Stachovsky/TrabajoProfesional/README.md

TrabajoProfesional
==================

Archivos, codigo y documentacion del trabajo profesional. Proyecto: Sistema de control para sinterizado de nano polvos.
