Stachovsky/TrabajoProfesional/Informes/Anteproyecto/AnteProyecto.pdf

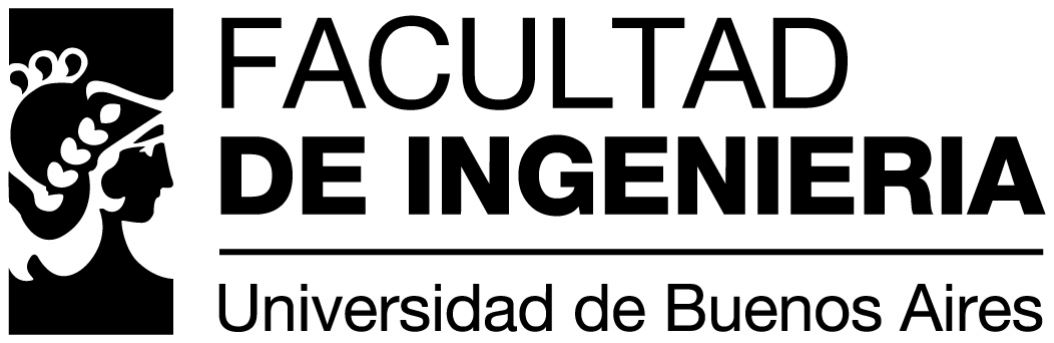
[picture p3: figure]

# Trabajo Profesional de Ingeniería Electrónica

# Sistema de control para proceso de sinterizado de nano estructuras

## ANTEPROYECTO

## Integrantes:

## Estanislao López Morgan

Padrón: | 84546
Mail: | estanux@gmail.com

## Facundo Nahuel Uriel Silva

Padrón: | 86881
Mail: | fanaur@gmail.com

## Índice

1. Introducción | 1
2. Finalidad del proyecto | 1
3. Planteamiento del problema a resolver | 2
4. Análisis de mercado | 2
5. Análisis de la competencia | 3
6. Planes de crecimiento | 3
7. Objetivos de costo | 3

## 1. Introducción

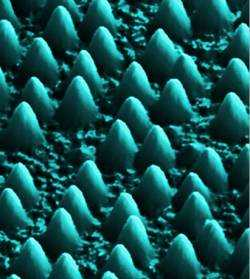
[picture p4: figure]

Figura 1: Nanoestructura

Los materiales nanocompuestos formados en su totalidad por particulas cerámicas y metálicas en el rango de los centenares y decenas de nanómetros, son una clase de materiales que presentan propiedades físicas muy distíntas a las de esos mismos con tamaños de cristal micrométricos (materiales convencionales). Tales propiedades, al ampliar su rango de funcionalidad resultan muy interesantes desde el punto de vista tecnológico ya que permiten combinar propiedades excepcionales con funcionalidad imprescindibles en aplicaciones específicas, como la transparencia, la biocompatibilidad, la dureza o conductividad eléctrica, entre otras.
Sin embargo, la aplicacion industrial de los materiales nanocompuestos radica en la capacidad de consolidación de estos materiales formando cuerpos densos y compuestos, pero preservando el tamañan nanométrico de sus componentes. Las técnicas de consolidación
convencionales presentan importantes limitaciones y no son capaces de preservar esta nanoestructura. La solución de estos problemas y el desarrollo de nuevas tecnologías ha posibilitado la producción de materiales nanoestructurales.

## 2. Finalidad del proyecto

En el laboratorio de sólidos amorfos de la facultad de ingeniería de la universidad de Buenos Aires funciona el INTECIN y en el mismo el grupo de materiales nanoestructurales, este grupo prepara y estudia sistemas basados en nanopartículas magnéticas apuntando a las posibles aplicaciones tecnológicas en sensores, remediación ambiental y aplicaciones clínicas. Sus integrantes tienen experiencia en caracterización estructural por difracción, dispersión y absorción de rayos X, espectroscopia Mössbauer, propiedades magnéticas y de magnetotransporte y microscopía electrónica.

Para lograr esto se realiza el sintetizado de nano estructuras, obteniendo una cinta metálica con una estructura amorfa (sin estructura cristalina) similar a un vidrio. Mediante un proceso de pulverizado de esta cinta se obtiene un polvo cuyas partículas poseen una estructura nanométrica. Para poder obtener una estructura sólida a partir del polvo se utiliza el proceso de sinterizado. Este proceso logra unificar las particulas del polvo en una sola estructura sólida. Para este fin se necesita que una intensidad de corriente elevada, en el orden de los KA, atraviese la muestra de polvo nonometrico. Esta corriente puede ser provista por un banco de capacitores (proceso rápido) o una fuente de RF (proceso lento).

La finalidad de nuestro proyecto es desarrollar una automatización y relevamiento del proceso de sinterizado a partir de la descarga de un banco de capacitores, realizar recopilación de datos del proceso con la posibilidad de variar alguna variables involucradas en el sitenrizado para evaluar el desempeño del mismo y sus resultados.

## 3. Planteamiento del problema a resolver

Para el estudio y desarrollo de cualquier tecnología es indispensable la experimentación, ya que es el medio atraves del cual se puede comprender y validar los desarrollos teóricos del proceso estudiado. La flexibilidad a la hora de la experimentación es factor deseado, entendiendo por flexibilidad la posibilidad de poder modificar parámetros del experimento de forma rapida y sencilla, ya que facilita y ahora tiempos a la hora del desarrollo del conocimiento. La fácil obtención y disponibilidad de los resultados de la experimentación es otro deseado en la experimentación.

Para poder estudiar y obtener materiales nanometricos atraves del proceso de sinterizado es necesario contar con un plataforma que controle y monitoree el proceso de sinterizado de forma flexible y parametrica. La plataforma le debe brindar al investigador la posibilidad de modificar las variables del proceso y obtener los resultados de la experimentacion. El proceso de sinterizado requiere la manipulación de una potencia electrica conciderable, es por ello que la plataforma debe brindar un manejo seguro de esta potencia , contando con todas medidas de seguridad requeridas para asegurar una segura operación.

## 4. Análisis de mercado

Los nanomateriales poseen una gran potencialidad a nivel tecnológico, ya que posibilitan la optimización y mejora de actuales de materiales actuales. Particularmente utilizando el proceso de sinterizado de materiales magneticos se obtiene materiales con caracteristicas magneticas conciderablemente mejores que los materiales actualmente usados en la industria. Los materiales magneticos son de vital importancia el campo de la generación de energia electrica, almacenamiento electronico de datos, desarrollo de sensores electrónico, etc.

## 5. Análisis de la competencia

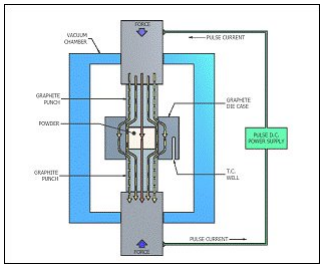
[picture p5: figure]

Figura 2: SPS

En el mercado encontramos soluciones de gran emplazamiento y envergadura, como lo son los propuestos por Thermal Technology LLC basado en la tecnología de Spark Plasma Sintering (SPS) un revolucionario en polvo de alta velocidad de proceso de consolidación. SPS utiliza alto pulsos de alta corriente continua para activar la consolidación y la reacción de sinterización de los materiales. Un sistesma de SPS trabaja con materiales conductores, no conductores y compuesto a cualquier nivel de densidad. La ventaja de SPS es ahorro de tiempo y energía y la capacidad de retener nanoestructuras.

## 6. Planes de crecimiento

El proyecto en un principio propone realizar la automatización del proceso de sinterizado estableciendo las normas de seguidad que corresponden. En un segundo paso, realizar las medeciones sobre las mágnitudes involucradas en el proceso. Tensión, corriente tiempo de descarga, etc, y su posterior almacenamiento. Finalmente todo lo anterior se lo integraría de forma que pueda sincronizar contra un servidor en red.

## 7. Objetivos de costo

El objetivo propuesto trata de desarrollar instrumental de bajo o mediano costo en comparación a las opciones propuestas por la competencia. Desde ese punto de vista, el proceso de sinterizado a través de descarga de los capacitores propuesto es mas eficiente
