Stachovsky/TrabajoProfesional/Informes/Especificaciones/Especificaciones.pdf

## Trabajo Profesional de Ingeniería Electrónica

# Sistema de control para proceso de sinterizado de nano estructuras

# Especificaciones Técnicas

V1.2

## Integrantes:

## Estanislao López Morgan

Padrón: | 84546
Mail: | estanux@gmail.com

## Facundo Nahuel Uriel Silva

Padrón: | 86881
Mail: | fanaur@gmail.com

### Historial

Fecha | Versión | Descripción | Autores
28/08/12 | 1.0 | Especificaciones Técnicas | Silva - López Morgan
06/09/12 | 1.1 | Se especifican las interfases para el conexionado de los sensores. | Silva - López Morgan
06/09/12 | 1.2 | Corrección de la posición de un sensor de tensión en el diagrama en bloques. | Silva - López Morgan

## Índice

1. Especificaciones de hardware | 1
2. Especificaciones de software | 4

Capítulo | 1 ESPECIFICACIONES DE HARDWARE

## 1. Especificaciones de hardware

### 1.1. Aspectos eléctricos

Tensión alimentación: 220VAC/50Hz.

Consumo máximo: 1A.∗

1

Pico de corriente de sinterizado máximo: 1KA. ∗

| 2

Impedancia máxima de la muestra: 1Ω.

∗

1
: El consumo máximo estará fijado por la fuente que se utilice y esta por el transformador.
∗

2
: La corriente máxima de pico de sinterizado puede ser incrementada hasta 10 kA si se amplía el banco de capacitores, se remplaza los contactores y el cableado correspondiente.

### 1.2. Almacenamientos de datos

Memoria flash en soporte SD Card.

Memoria flash en soporte pendrive USB 2.0.

### 1.3. Comunicación

Comunicación USB 2.0 con la PC. ∗

3

∗

3
: Se utiliza un bridge RS232-USB interno.

### 1.4. Periféricos del dispositivo

Display gráfico de 128x64 pixels.

Teclado de 4 teclas.

Sensor de corriente.

Sensores de tensión × 3.

Sensor de temperatura.

### 1.5. Interfases del dispositivo

Entrada de 0-5V × 3.∗

4∗

5

Entrada de 5-20mA × 1.∗

4

Puertos UART × 3.∗

6

Bus I

2C.∗

6

∗

4
: Interfases configurables desde el programa de PC.
∗

5
: Interfases usadas para los sensores de tensión y corriente ∗

6
: Interfases reservadas para usos futuros.

### 1.6. Seguridad

Descarga segura del banco de capacitores.

Sirena sonora.

Luces de señalización × 3.

Banco de capacitores ubicados dentro del gabinete del dispositivo .

Revestimiento eléctricamente aislante del gabinete del dispositivo.

Protección contra corto circuito.

Botón de parada de emergencia.

### 1.7. Aspectos mecánicos

No se brinda la función de prensado de la muestra. ∗

7

Gabinete con 4 ruedas.

No se brinda el recipiente contenedor de la muestra de polvo.

∗

7
: La muestra debe estar prensada previamente al momento de realizar el proceso sinterizado.

### 1.8. Aspectos de operativos

Uso máximo mensual: 60 veces. ∗

8

∗

8
: Se estima un promedio de 2 usos diarios.

### 1.9. Croquis


Figura 1: Interconeccion entre los bloques del sistema

Capítulo | 2 ESPECIFICACIONES DE SOFTWARE

## 2. Especificaciones de software

El control, administración, monitoreo y recolección de datos del dispositivo de control del proceso de sinterizado se harán a través de un programa de PC con las siguiente características:

Plataforma Windows XP/7 y GNU Linux.

Formato de datos exportados CSV.

Control de acceso.

Base de datos.

### 2.1. Pantallas

El programa contara con las siguientes pantallas:

Login.

ABM usuarios.

Monitoreo dispositivo.

Parametrización del experimento.

Control experimentación.

Descarga de datos del experimento.

Exportación de resultados de experimentación.

Ploteo de resultados del experimento.
