Stachovsky/TrabajoProfesional/Informes/InformePreliminar/informePreliminar.pdf

# Trabajo Profesional de Ingeniería Electrónica

## Sistema de control para proceso de sinterizado de nano estructuras

## Situacion inicial

## Integrantes:

## Estanislao López Morgan

Padrón: | 84546
Mail: | estanux@gmail.com

## Facundo Nahuel Uriel Silva

Padrón: | 86881
Mail: | fanaur@gmail.com

## Índice

1. Introducción | 1
2. Descripción situación existente del sistema | 2
3. Descripción solución propuesta | 3

Capítulo | 1 INTRODUCCION´

## 1. Introducción

Los materiales nanocompuestos formados en su totalidad por particulas cerámicas y metálicas en el rango de los centenares y decenas de nanómetros, son una clase de materiales que presentan propiedades físicas muy distíntas a las de esos mismos con tamaños de cristal micrométricos (materiales convencionales). Tales propiedades, al ampliar su rango de funcionalidad resultan muy interesantes desde el punto de vista tecnológico ya que permiten combinar propiedades excepcionales con funcionalidad imprescindibles en aplicaciones específicas, como la transparencia, la biocompatibilidad, la dureza o conductividad eléctrica, entre otras.
Sin embargo, la aplicacion industrial de los materiales nanocompuestos radica en la capacidad de consolidación de estos materiales formando cuerpos densos y compuestos, pero preservando el tamañan nanométrico de sus componentes. Las técnicas de consolidación convencionales presentan importantes limitaciones y no son capaces de preservar esta nanoestructura. La solución de estos problemas y el desarrollo de nuevas tecnologías ha posibilitado la producción de materiales nanoestructurales.
En el laboratorio de sólidos amorfos de la facultad de ingeniería de la universidad de Buenos Aires funciona el INTECIN y en el mismo el grupo de materiales nanoestructurales, este grupo prepara y estudia sistemas basados en nanopartículas magnéticas apuntando a las posibles aplicaciones tecnológicas en sensores, remediación ambiental y aplicaciones clínicas. Sus integrantes tienen experiencia en caracterización estructural por difracción, dispersión y absorción de rayos X, espectroscopia Mössbauer, propiedades magnéticas y de magnetotransporte y microscopía electrónica.

Para lograr esto se realiza el sintetizado de nano estructuras, obteniendo una cinta metálica con una estructura amorfa similar a un vidrio. Mediante un proceso de pulverizado de esta cinta se obtiene un polvo cuyas partículas poseen una estructura nanométrica. Para poder obtener una estructura sólida a partir del polvo se utiliza el proceso de sinterizado. Este proceso logra unificar las particulas del polvo en una sola estructura sólida. Para este fin se necesita que una intensidad de corriente elevada, en el orden de los KA, atraviese la muestra de polvo nonometrico. Esta corriente puede ser provista por un banco de capacitores (proceso rápido) o una fuente de RF (proceso lento).

La finalidad de nuestro proyecto es desarrollar una automatización y relevamiento del proceso de sinterizado a partir de la descarga de un banco de capacitores, realizar recopilación de datos del proceso con la posibilidad de variar alguna variables involucradas en el sitenrizado para evaluar el desempeño del mismo y sus resultados.
La finalidad de este informe es describir la situación existente en el laboratorio y plantear una posible solución tecnológicas para el proceso de control.

Capítulo | 2 DESCRIPCION SITUACI ´ | ON EXISTENTE DEL SISTEMA ´

## 2. Descripción situación existente del sistema

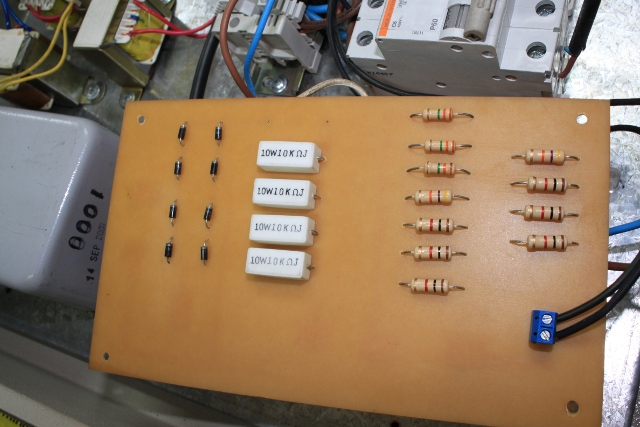
[picture p7: figure]

Figura 1: Tablero actual

En la actualidad, el antiguo proceso de sinterizado, que estuvo en funcionamiento a modo de prueba para realizar solo algunas descargas de los capacitores, se encuentra parcialmente desmantelada. Se cuenta con una caja metálica que hace la suerte de tablero, alberga la electrónica de control y un pequeño teclado con un display de cristal líquido. Contiene también un contactor y una placa con un puente de diodos, algunas resistencias pequeñas y un rele.
En el laboratorio se encuentran dos capacitores de potencia en derivación marca Leyden. Son de 200uF por 1000V y tienen
un dieléctrico constituido en general por tres
películas de polipropileno ‘hazy’, rugosas en
ambas caras, de alta pureza. Esta construcción, en lugar de la que utiliza sólo dos capas de un film rugoso en una sola de sus caras, común en otros fabricantes, “confiere a los capacitores LEYDEN mayor seguridad de funcionamiento y mayor vida útil. La rugosidad en ambas caras del polipropileno es una condición indispensable para la completa impregnación del film durante el proceso y, por ende, para la estabilidad del capacitor a largo plazo”, especifica el fabricante.

Estos capacitores utilizan un impregnante no-clorado MDBT. Este se caracteriza por su alto ´ punto de inflamación, gran capacidad de absorción de gases derivados de descargas eléctricas internas, y compatibilidad ambiental (biodegradabilidad).

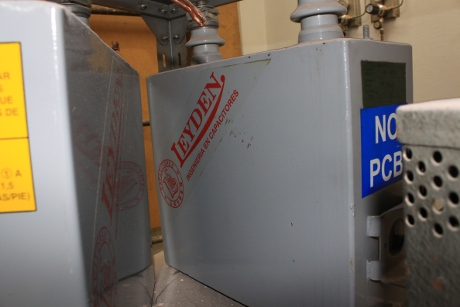
[picture p8: figure]
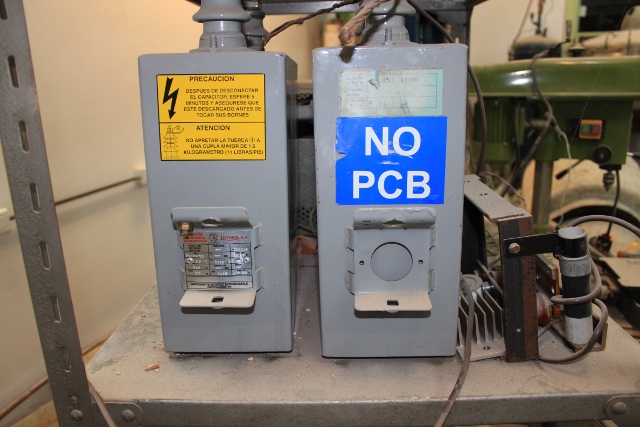
[picture p9: figure]

(a) Capacitores de lado | (b) Capacitores de frente

Figura 2: Capacitores de 200uF y 1000V

Capítulo | 3 DESCRIPCION SOLUCI ´ | ON PROPUESTA ´

## 3. Descripción solución propuesta

### 3.1. Objetivos

Se propone desarrollar un sistema electrónico que integre el control y la adquisición de datos del proceso de sinterizado ECAS (Electric current activated/assisted sintering ). La corta duración del proceso de descarga de los capacitores (razón por la cual a esta modalidad se la denomina ’ultra rápida’) exige que el sistema tenga una elevada velocidad de respuesta para tomar las muestras de las distintas magnitudes físicas que se necesitan medir en el proceso. El sistema utilizará la información provista por los sensores para hacer ajuste en los parámetros de control del proceso para lograr los mejores resultado en experimentación. Se estimara la carga del banco de capacitores para de esta manera saber con precisión la magnitud que tendrá la corriente en el momento de la descarga, siendo este aspecto de fundamental importancia en este proceso. El proceso requiere la presencia de altas tensiones para su ejecución por lo que el sistema monitoreará todos los parámetros peligrosos (como son tensión de la fuente de alimentación y la tensión de los capacitores) y aplicara todas las medidas de seguridad necesarias para brindarle al operador la seguridad necesaria para su utilización. El sistema tendrá la capacidad de poder interrumpir el proceso en caso de no ser seguro para el operario o para la integridad de los elementos del sistema (para evitar daños). El sistema contara con indicadores lumínicos (luces de señalización) y sonoros (sirenas) para informara los distintos estados del sistema. Los datos obtenidos de la experimentación podrán ser accedidos desde distintos medios para facilitar el posterior análisis de la información recolectada. Se tendrá un acceso remoto al sistema mediante la conexión a una red local (LAN) y un acceso local mediante la interfase provista por el teclado y la pantalla. En la figura 3 se muestra de forma esquemática los componentes que integraran al sistema. Se tendrá una unidad de control acompañada de un conjuntos de sensores y actuadores.

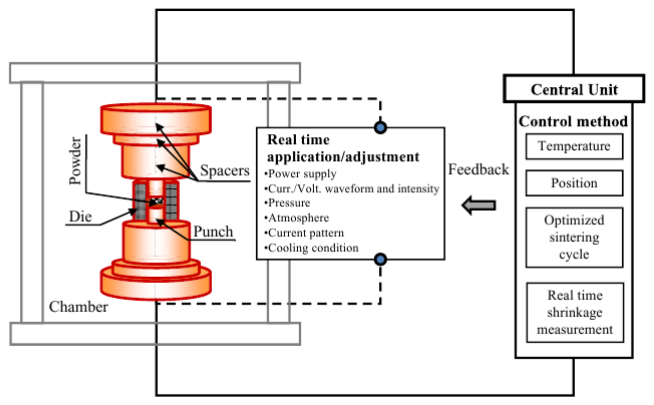
[picture p10: figure]

Figura 3: Descripción general del proceso ECAS

### 3.2. Diagrama en bloques

Se muestra en la figura 4 los bloques funcionales principales que compondrán el sistema planteado.

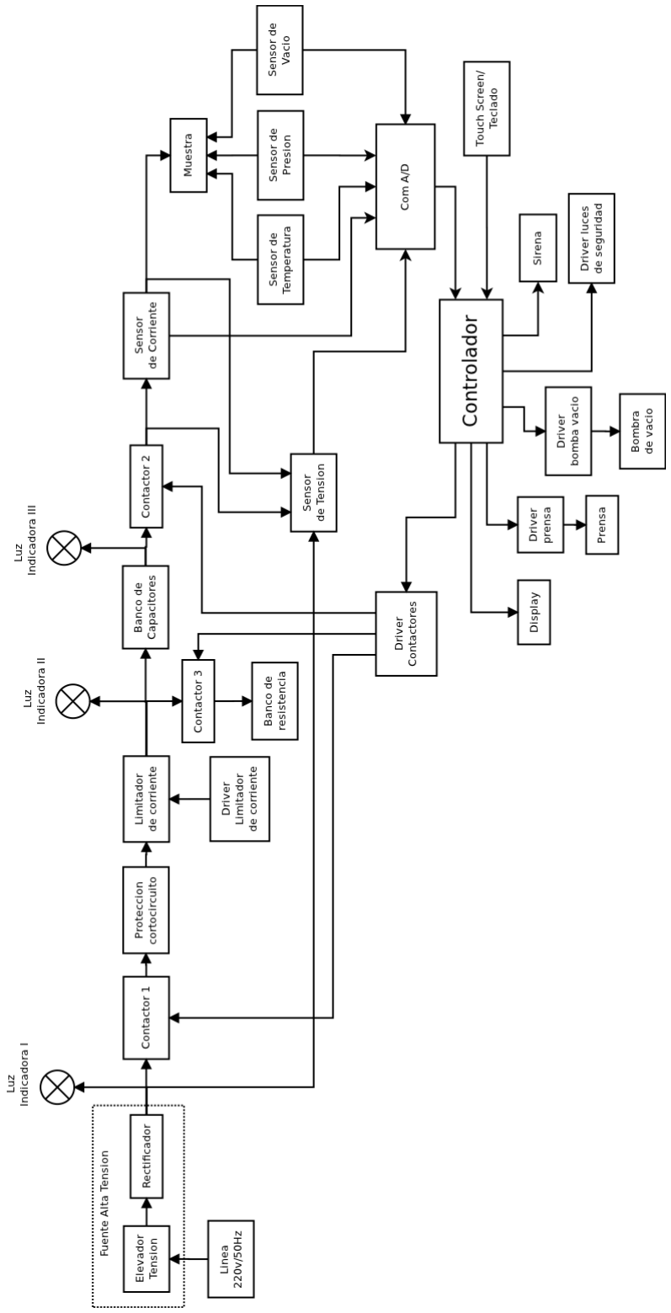
[picture p11: figure]

Figura 4: Diagrama en bloque general del sistema

### 3.3. Descripción en bloques funcionales del sistema

Se han agrupado funcionalidades de forma de poder modelizar el sistema total como la interconexión de bloque que cumplen funciones muy especificas dentro del funcionamiento general. Se detalla a continuación la función de cada bloque:

Fuente Alimentación: Este bloque esta encargado de tomar la energía de la red de alimentación en forma de tensión alterna y transformarla en tensión continua de alta tensión para que sea adecuada para cargar los capacitores de 1000v.

- Elevador: Este sub bloque de la fuente de alimentación tiene la tarea de elevar la tensión proveniente de la linea de alimentación de 220v hasta los 1000v.
- Rectificador: Este bloque transforma la tensión alterna de 1000v a una tensión continua de 1000v mediante la rectificación y el filtrado de la tensión de entrada.

Luz indicadora: Este bloque provee al operador del sistema la posibilidad de visualizar la presencia de alta tensión para tomar así las precauciones necesarias.

Contactor 1: Este bloque separa la fuente de alimentación de alta tensión del resto de sistema. El contactor se activará para permitir que la corriente proveniente de la fuente de alta tensión cargue a los capacitores a la tensión indicada.

Protección corto circuito: Este bloque es un mecanismo de protección que tiene la función monitorear la corrientes en caso de que se produzca un aumento desmedido de la misma y en caso de detectarse esta situación procederá a la desconectara la alimentación del sistema para evitar daños y se notificara la situación.

Limitador corriente: Este bloque brinda al sistema la capacidad de poder controlar la corriente con la que cargan de los capacitores.

Driver limitador corriente: Este bloque es el encargado de comandar el limitador de corriente.

Contactor 3: Este bloque brinda la posibilidad de conectar eléctricamente un banco de resistencias para ser utilizado en caso de tener la necesidad de realizar la descarga de los capacitores si estos quedan con carga.

Banco de resistencias: Este bloque esta compuestos por un conjunto de resistencias auxiliares que serán utilizados en caso de que los capacitores quedaran con carga y se necesita que sean descargados por cuestiones de seguridad.

Banco de capacitores: Este bloque esta compuesto por un conjunto de capacitores de alta tensión que son utilizados para almacenar cargar eléctricas. Una vez alcanzado el nivel de carga necesario para realizar la descargar los capacitores quedaran cargado hasta que se inicia el proceso de descarga. En ese momento todas las cargar almacenadas en el bando de capacitores sera conducida hacia la muestra de nano polvos para realizar el sinterizado de la muestra.

Drivers contactores: Este bloque tiene como función actuar como interfase entre la lógica de control y los contactores.

Contactor 2: Este bloque tiene como función conectar eléctricamente los capacitores con la muestra una vez que se han cargado los capacitores al nivel de de carga requerido.

Sensor tensión: Este bloque es un transductor utilizado para medir la tensión de la fuente de alimentación y la tensión que poseen los capacitores para así poder inferir la carga que poseen.

Sensor de corriente: Este bloque es utilizado para la medición de la corriente que circula al momento de la cargar de los capacitores y para relevar la corriente circulante a la hora de la realización de la descarga de los capacitores.

Muestra: Este bloque indica donde se encontrara la muestra compactad de nano polvos la cual sera expuesta a la descarga de los capacitores.

Sensor temperatura: Este bloque tiene como fin relevar la evolución de la temperatura de la muestra durante la descarga de los capacitores sobre la muestra.

Sensor presión: Este bloque relevara la presión mecánica ejercida sobre la muestra de nano polvos.

Sensor de vacío: Este bloque relevara el nivel de vacío que se tiene en la zona donde se encuentra la muestra. Este bloque se utilizara en el caso de que se utilice una cámara de vacío para realizar el proceso.

Conversor A/D: Este bloque tiene la función de digitalizar los niveles de tensión y/ó corriente provenientes de los sensores del sistema para poder ser interpretados y utilizados por la lógica de control del sistema.

Touchscreen/ Teclado: Este bloque brinda un medio para el accionamiento del sistema por parte del usuario.

Sirena: Este bloque tiene como fin la indicación sonara de un estado, ya sea de aviso o para indicar un problema.

Driver luces de seguridad: Este bloque tiene como función actuar como interfase entre la lógica de control y las luces de señalización.

Driver bomba de vacío: En caso de necesitarse una nivel de vacío para el proceso este bloque funcionara como interfase entre la lógica de control y la bomba de vacío.

Bomba de vacío: Este dispositivo tiene como fin producir el nivel de vacío necesario par el proceso en la cámara de vacío donde se encuentra la muestra de nano polvos.

Driver prensa: Este bloque tiene como función actuar como interfase entre la lógica de control y la prensa mecánica que comprime la muestra de nano polvos.

Prensa: Este bloque tiene la función de ejercer una fuerza mecánica en los extremos de la muestra de nano polvos para poder asegurar un buen contacto eléctrico durante el proceso de descarga de los capacitores sobre la muestra.

Display: Este bloque brinda un medio para la señalización al usuario de indicadores del proceso.

Controlador: En bloque esta la lógica de control y comunicación del sistema. La lógica se ocupa tanto al control y accionamiento de los periféricos del sistema como del almacenamiento y procesamiento de los datos obtenidos. Este bloque también es el responsable de brindarle al sistema la comunicación con el usuario ya sea mediante red , dispositivo de almacenamiento extraíble o mediante el teclado/touchscreen y el display.

Capítulo | REFERENCIAS

## Referencias

[1] http://iopscience.iop.org/1468-6996/10/5/053001
[2] http://iopscience.iop.org/1468-6996/10/5/053001/pdf/1468-6996_10_5_053001. pdf (http://iopscience.iop.org/1468-6996/10/5/053001/pdf/1468-6996_10_5_053001.pdf)
[3] http://en.wikipedia.org/wiki/Capacitor_discharge_sintering
[4] http://www.leyden.com.ar/esp/index.html
