Stachovsky/TrabajoProfesional/Documentacion/DocumentacionProyectoAnterior/Micro_Soft/informe.pdf

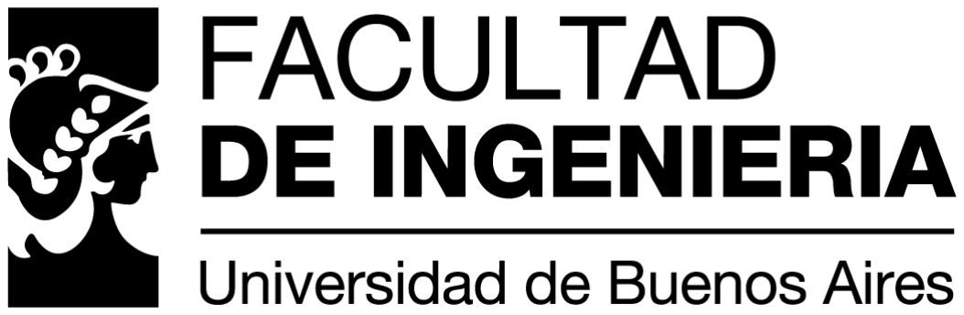
[picture p12: figure]

# Departamento de Electrónica

# 66.09 Laboratorio de Microcomputadoras

# Proyecto

# Controlador de ensayos de Spark Plasma

Profesor: | Ing Guillermo Campiglio
Cuatrimestre / Año | 1.er cuatrimestre 2008
Turno de clases prácticas: | Miércoles

## Jefe de Trabajos Prácticos: Docente Guía:

Alumno | Seguimiento del proyecto
Apellido | Nombre | Padrón
Albani | Francisco | 84891
Arbelo Arrocha | Daniel | 85583
Figueroa | Gonzalo | 84255

## Obsevaciones:

Fecha de aprobación | Firma del J.T.P.

## Coloquio Nota Final Firma Profesor

66.09 Laboratorio de Microcomputadoras | Controlador de ensayos de Spark Plasma

# Índice

1. Introducción | 3
2. Descripción del dispositivo | 4
3. Hardware | 5
4. Software | 15
5. Conclusión | 19
6. Código fuente | 20
7. Esquemáticos | 121
Albani - Arbelo Arrocha - Figueroa | 2 | 1.er cuatrimestre 2008

# 1. Introducción

## En el Laboratorio de Sólidos Amorfos de la Facultad de Ingeniería de la Universidad de

Buenos Aires, se producen materiales magnéticos mediante técnicas de solidificación rápida como melt-spinning o atomización centrífuga. Los materiales obtenidos por estas técnicas tienen forma de cintas o polvos, necesitando ser posteriormente consolidados en piezas de mayor tamaño.
La consolidación de las piezas masivas en su forma final requiere técnicas de compactación y sin-terizado. Dado que los materiales deben ser micro y nano-estructurados, con el objeto de potenciar sus propiedades magnéticas en forma acorde a su aplicación, es altamente deseable tener un control granular y preciso del proceso de consolidación.

## En el caso de la compactación de ferromagnetos nanocompuestos de NdFeB¹ , que son empleados como

imanes permanentes, se requiere que dicha técnica de consolidación no provoque un crecimiento exagerado del tamaño de grano (que en casos típicos ronda las decenas de nanómetros), porque esto redunda en una degradación de sus propiedades magnéticas.
Una técnica acorde con este último objetivo es la compactación con descarga eléctrica. Un esquema del mismo se puede observar en la figura 1. Una densidad de corriente eléctrica muy alta (típicamente de

## 50 kA/cm²

) provoca la soldadura superficial de las partículas. El efecto responsable de esta soldadura es el calentamiento Joule local, el cual actúa en el breve lapso de tiempo que dura la descarga. Sin embargo, en el interior de las partículas la temperatura no alcanza los valores correspondientes como para promover la difusión atómica que provoca el crecimiento de granos, o si lo hace, su cinética de calentamiento es tan rápida que no permite el crecimiento excesivo de los mismos.

Polvo | Banco de Capacitores

### Fuente de CC

### Prensa Hidr ulica a

Figura 1: Esquema de un sistema de compactación con descarga eléctrica.

1NdFeB: Neodimio Hierro Boro.

Albani - Arbelo Arrocha - Figueroa | 3 | 1.er cuatrimestre 2008

# 2. Descripción del dispositivo

El dispositivo desarrollado tiene como objetivo asistir a los investigadores del Laboratorio de Sólidos Amorfos en la ejecución de los ensayos de fundición de materiales magnéticos mediante compactación y descarga eléctrica.
Para alcanzarlo, debe controlar y monitorear los parámetros que definen a un ensayo, y ofrecer al

## invesigador una interfaz para programar una serie de ellos. Los parámetros son:

Presión mecánica sobre el material.

Tiempo de reposo de la muestra bajo presión.

Tensión de carga del banco de capacitores que provoca la descarga.

Ventana de tiempo de la descarga sobre la muestra.

La interacción con el usuario se da por medio de una terminal constituida por un teclado y un display gráfico a través de los cuales se puede ver el estado de la ejecución de ensayos y configurar sus parámetros. Por otro lado, una interfaz eléctrica constituida por sensores y relays activados digitalmente provee control directo sobre el sistema, reflejando los comandos del operario y adquiriendo los datos que son presentados a éste.
El dispositivo almacena todos los ensayos en una memoria ROM para permitirle al investigador rehacerlos individualmente.
A continuación se presenta un diagrama de bloques que describe superficialmente las relaciones entre

## los distintos módulos:

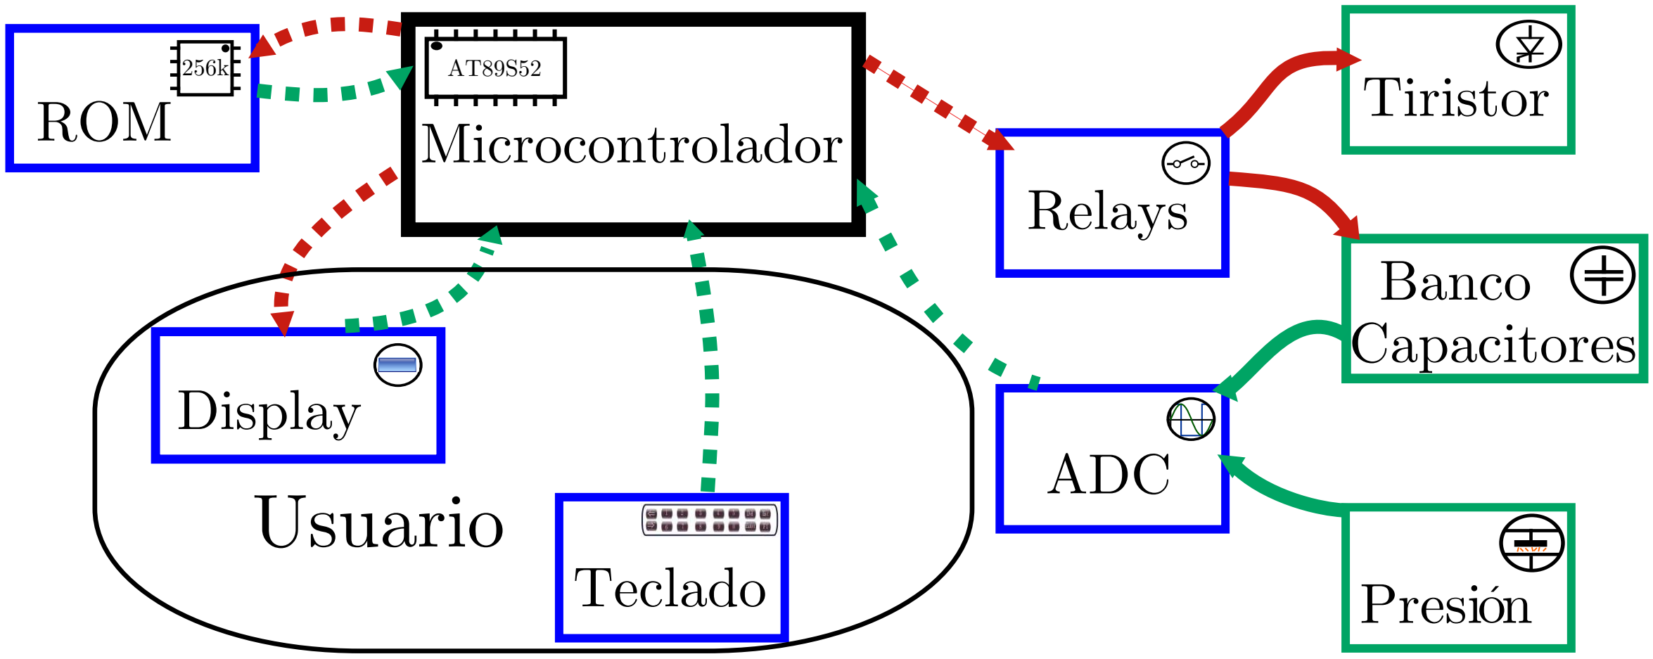
[picture p13: figure]
AT89S52 Microcontrolador; Relays; ADC; Tiristor; Capacitores; Banco; Display; Teclado; ROM; Presi no; Usuario

Figura 2: Diagrama en bloques.

Albani - Arbelo Arrocha - Figueroa | 4 | 1.er cuatrimestre 2008

# 3. Hardware

En esta sección se describe como se resolvió técnicamente cada uno de los módulos nombrados anteriormente, terminando con un listado de costos.

# 3.1. Microcontrolador

Adquisidor de todas las entradas y salidas de datos, manejo de interfases y comunicación. Se imple-mentó con un microcontrolador AT89S52 de la familia MCS-51 de Intel.

## Algunas de sus características son las siguientes:

8 kbytes de memoria Flash.

256 bytes de memoria RAM.

4 puertos de 8 líneas cada uno.

3 timers de 16-bits.

Los motivos que llevaron a elegir este dispositivo, fueron principalmente su simpleza, su fuerte ori-entación a aplicaciones de control, y su capacidad para almacenar código. Eso permitió almacenar a los 95 caracteres con representación gráfica del Standard ASCII de 7 bits completo en memoria de código.

Albani - Arbelo Arrocha - Figueroa | 5 | 1.er cuatrimestre 2008

# 3.2. Display gráfico

El display es el principal dispositivo en lo que a interacción con el usuario respecta. Se utilizó el modelo WG12864A-PMI-V del fabricante Winstar. Posee un superficie de 128×64 pixeles dividida en dos sectores de 64x64 pixeles, cada uno controlado por un chip KS0108.
La memoria RAM del chip KS0108 almacena los píxeles que son mostrados en el display y posibilita direccionar 64 columnas × 64 filas. Las filas están agrupadas en 8 páginas de 8 filas cada una. Estas últimas no son más que “tiras” de bytes que son leídos o escritos a través de los terminales DB0-DB7 del display.

# Bits order

# Page 0 Page 1

Page 2 | Page 2
Page 3 | Page 3
Page 4 | Page 4
Page 5 | Page 5
Page 6 | Page 6
| Page 7

# Page 1

Page 7 | )

)

)

)
)
64 bits | 64 bits

b
i
t
s

6
4
KS0108 #1 | KS0108 #2

## 64 bytes columns x 8 bits 7

6
5
4
3
2
1
0

Figura 3: Relación entre la memoria del controlador y su ubicación en la pantalla.

Para mostrar datos en pantalla se deben seguir, a grandes rasgos, los siguientes pasos: seleccionar el sector a escribir, especificar la página, especificar la columna de inicio dentro de la página y, finalmente, escribir los datos. Es importante destacar que el puntero interno de columnas se incrementa cada vez que se realiza una escritura, permitiendo el volcado secuencial de bytes sobre una página.

Dentro de la biblioteca display.asm, junto a las rutinas necesarias para inicialización y comunicación con el display, se incluyeron también otras de más alto nivel. A continuación se puede ver una descripción

## de cada una de ellas:

DISPLAY PUT BYTE: muestra un byte (8 píxeles verticales) en una posición específica del display.

DISPLAY PUT CHAR: muestra los 5 bytes que componen a un caracter a partir de ru representación almacenada en memoria de código.

DISPLAY PUT ASCII: muestra un caracter a partir de su código ASCII.

DISPLAY PUT STRING STATIC: escribe una cadena ASCII ubicada en memoria de código.

DISPLAY PUT STRING DYNAMIC: escribe una cadena ASCII ubicada en memoria de datos.

DISPLAY PUT SCREEN FROM CODE: vuelca los 1024 bytes que componen una pantalla entera desde memoria de código.

Albani - Arbelo Arrocha - Figueroa | 6 | 1.er cuatrimestre 2008

# 3.3. Teclado

Se diseñó un teclado matricial de 4 filas por 4 columnas, y para su implementación se utilizó un buffer 74HC244N de 8 entradas y 8 salidas como interfaz al microcontrolador, conectado de la siguiente manera:

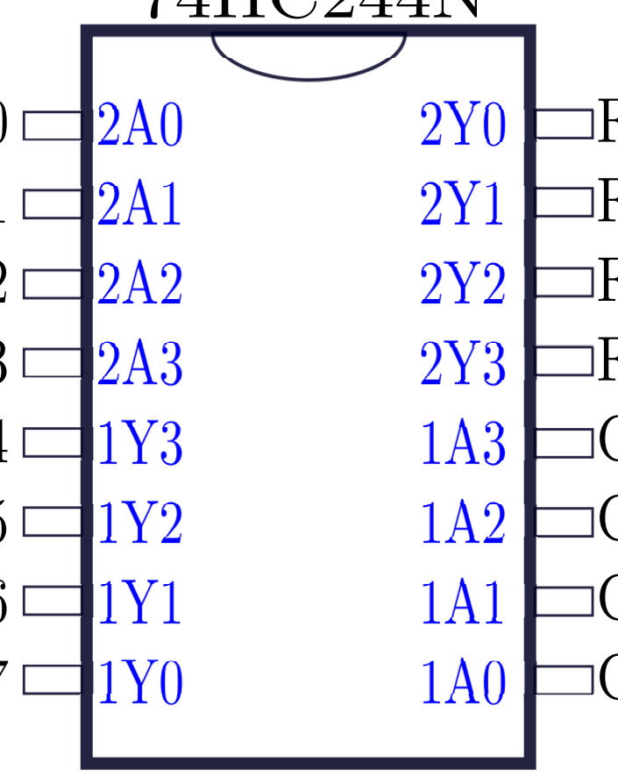
[picture p14: figure]

Fila 1
Fila 2
Fila 3
Fila 4
Columna 4
Columna 3
Columna 2
Columna 1

P2.0
P2.1
P2.2
P2.3
P2.4
P2.5
P2.6
P2.7

74HC244N

Figura 4: Conexionado del teclado.

Se pensó de tal forma que la presión de una tecla implicara un nivel lógico bajo tanto en su fila como en su columna. De esta manera, el procedimiento de detección de una tecla puede describirse así:

Enviar un cero lógico sólo a la fila de la tecla deseada (alguno de los terminales 2An del buffer ).

Si dicha tecla está presionada, el valor lógico se propagará en poco tiempo a uno de los terminales 1An del buffer, determinado por la columna a la que la tecla pertenece.

Esperar un tiempo prudente para que el buffer actualice los valores 1Yn.

Se toma una lectura de los 4 terminales 1Yn y se chequea si la columna de la tecla deseada tiene el valor lógico cero.

Para simplificar el procedimento anterior, se escribió una rutina, llamada KEYPAD SCAN CORE:, que cuando es llamada, prueba en sucesión a las 16 combinaciones válidas. Para simplificar aún más esta tarea, se definió una tabla de bytes donde cada uno representa a la máscara correspondiente a cada tecla. En los 4 bits menos significativos, se almacena una de las 4 “peticiones” posibles: 1110 para la fila 1, 1101 para la fila 2, 1011 para la fila 3 y 0111 para la fila 4; en los cuatro más significativos, se almacenan cada una de las “respuestas” válidas: 1110 para la columna 4, 1101 para la columna 3, 1011 para la columna 2 y 0111 para la columna 1. De esta manera, se puede usar el mismo byte para el momento del envío de la máscara de filas y para el momento de comparación de la máscara de columnas.
El orden de las máscaras en la tabla se hizo coincidir con el orden de la codificación de las teclas, para reducir a una simple iteración de variable la parte del algoritmo que informa cual de las teclas se detectó presionada.
Finalmente, se encapsuló a la rutina anteriormente descripta, dentro de otra preparada para ser utilizada fuera de la biblioteca, llamada KEYPAD SCAN:, que se encarga de realizar tareas de debouncing y atrapar la ejecución hasta que la tecla detectada haya sido soltada, para evitar múltiples disparos. Para complementar, se incluyeron en la biblioteca keypad.asm rutinas de más alto nivel para realizar acciones como atrapar la ejecución a la espera de un tecla cualquiera o específica e iterar bucles hasta detectar alguna presionada.
A continuación se presenta la disposición física de las teclas que componen el periférico:
Albani - Arbelo Arrocha - Figueroa | 7 | 1.er cuatrimestre 2008

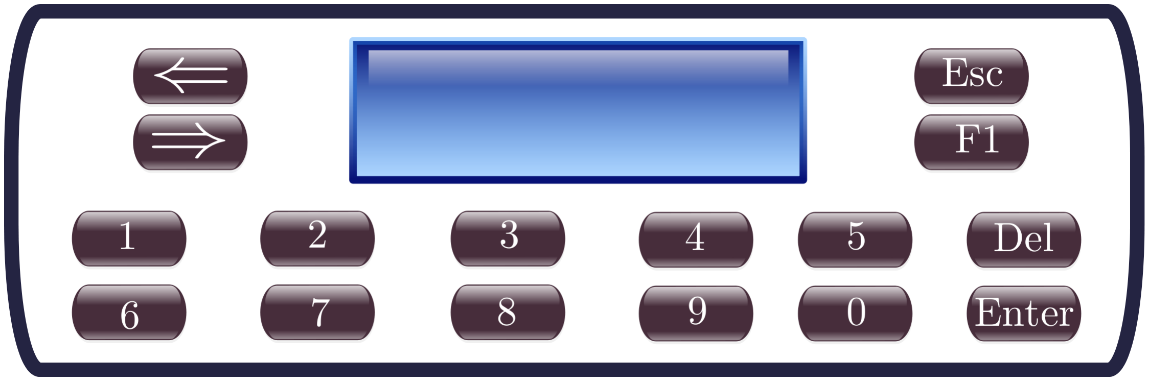
[picture p15: figure]

Figura 5: Disposición física del teclado.

Albani - Arbelo Arrocha - Figueroa | 8 | 1.er cuatrimestre 2008

# 3.4. Memoria ROM externa

Otro de los periféricos que conforman el dispositivo, es una memoria ROM serial. Se trata del modelo AT24C256 de ATMEL y se utilizó para almacenar los ensayos que hiciera el usuario y las pantallas gráficas, meramente estéticas.
Este integrado provee 32,768 bytes de memoria E²PROM y posibilita la conexión en cascada de tres integrados más para una eventual ampliación de memoria.

A0

A1

NC

## GND

## AT24C256

## VCC

WP

## SCL

## SDA

Pin | Function
A0 - A1 | Address Inputs
SDA | Serial Data
SCL : | Serial Clock Input
WP | Write Protect
NC | No Connect
GND | Ground

## 3.4.1. Operaciones generales

Clock y envio de datos: El pin SDA debe cambiar sólo cuando el pin SCL se encuentra bajo.
Esto indica el envio de datos. El cambio de ´ | SDA mientras SCL está en alto se interpreta como bits
de start-stop.

Condición de start: Con el SCL en alto y realizando una transición de alto a bajo en el SDA se estableca la condición de start.

Condición de stop: Con el SCL en alto y realizando una transición de bajo a alto en el SDA se estableca la condición de stop. Una vez efectuada la memoria se pone en modo standby.

Acknowledge: La memoria envia un cero durante el noveno ciclo de clock para corroborar que recibió en forma correcta cada uno de los bytes.

## 3.4.2. Device Address

Para determinar la función que realiza la memoria, ya sea escritura o lectura, se utiliza un byte seguido de la condición de start. A1 y A0 son dos bits que forman parte de dicho byte y que se utilizan para selecionar una de las cuatro memorias que pudieran estar conectadas. Cabe destacar que el byte en cuestión es establecido por el fabricante y se denomina device address.

## MSB

1 | 0 | 1 | 0 | 0 | A1 | A0 | R/W
| | | | | | | LSB

El bit menos significativo determina la operación; si está en alto se realizará una lectura y si está en bajo se realizará una escritura.

## 3.4.3. Operaciones de escritura

Para realizar una escritura en la ROM se requieren, además de la device address, 2 bytes que determinan la posición en memoria donde se escribirán los datos. Una vez establecida la secuencia de direcciones se envian los datos, que finaliza con la condición de stop.
El modelo AT24Cxx permite el envío de hasta 64 bytes (una página) de datos antes de la condición de stop. Una vez enviada la dirección en memoria, la E²PROM incrementa el byte bajo a medida que recibe los bytes de datos. Sin embargo, cuando se envian más de 64 bytes los datos comienzan a pisarse; ésto se denomina “roll over”.
Albani - Arbelo Arrocha - Figueroa | 9 | 1.er cuatrimestre 2008

## 3.4.4. Operaciones de lectura

Como se dijo anteriormente la diferencia sustancial entre escribir la ROM y leerla radica en el bit menos significativo de la device address. Sin embargo es posible implementar, tres tipos de operaciones

## para la lectura:

Current address: En este caso el contador interno de la ROM mantiene la última dirección de memoria incrementada en uno. Dicha dirección se mantiene siempre y cuando el chip esté alimen-tado.

Random: Se envian a la ROM la device address y una dirección de memoria cualquiera simulando una escritura. Luego el microcontrolador debe generar otra condición de start. Y, a continuación inicia la lectura del byte random.

Sequential: Es posible iniciar una lectura secuencial comenzando por cualquiera de las dos operaciones antes mencionadas. Siempre y cuando la E²PROM reciba un acknowledge seguirá incremen-tando la posición en memoria permitiendo una lectura secuencial.

Albani - Arbelo Arrocha - Figueroa | 10 | 1.er cuatrimestre 2008

# 3.5. Conversor A/D

El conversor analógico-digital es el encargado de servir los datos sensados al microcontrolador, para que éste actúe en consecuencia. Se utilizó para procesar los datos provenientes del transmisor de presión y para controlar la tensión de carga del banco de capacitores.
La función básica del conversor es tomar una señal entre 0 V y 5 V y traducirla a un byte comprendido entre 0 y 255 respectivamente.
El modelo que se utilizó fue ADC0834, del fabricante National Semiconductor. Este consta de 4 canales ´

## que pueden operar de dos maneras distintas:

Single-Ended: compara la señal del canal con la referencia común.

Differential: compara las señales de dos canales y obtiene la diferencia.

La comunicación entre el microcontrolador y el conversor se establece en forma serial y se utiliza un byte especifico, dado por el fabricante para determinar los canales a utilizar y el modo de operación. Para este proyecto se utilizaron dos canales en modo Single-Ended. El canal cero se encarga de controlar la carga de los capacitores y tiene asignado el siguiente byte para ser iterpretado por el conversor: CH0 = 10000000b. El sensor de presión se procesa a través del canal uno y su byte de reconocimiento es: CH1 = 10100000b.

Albani - Arbelo Arrocha - Figueroa | 11 | 1.er cuatrimestre 2008

# 3.6. Sensor de presión

En su diseño original el dispositivo debía ser capaz de operar en forma completamente desatendida, lo que implicaba la operación automatizada de la prensa por parte del microcontrolador.
Debido a limitaciones presupuestarias ese objetivo debió ser abandonado. Como solución de compro-miso se optó por el sensado pasivo de la presión ejercida sobre el material, reportada por pantalla junto con la presión objetivo de la experiencia, para orientar al operario de la prensa manual.

Para poder medir la presión ejercida sobre el material se instaló en esta un sensor de presión modelo ADZ-SML-20.0 de Nagano cuya especificación técnica indica que es capaz de sensar de 0 a 4000 bar con un error de ±0,1 bar, traduciendo lo sensado a una tensión entre 0 V y 10 V.

Adicionalmente se adaptó, mediante un divisor resistivo (Figura 3.6), la tensión de salida del trans-ductor al rango (0 V − 5 V). Una vez adaptada a este rango, la tensión es interpretada por el conversor A/D conectado al microcontrolador, permitiendole a este monitorear el proceso de compactación.

Sensor | ADC-CH1

Figura 6: Conexión entre la salida del sensor y el canal 1 del ADC.

Albani - Arbelo Arrocha - Figueroa | 12 | 1.er cuatrimestre 2008

# 3.7. Relays

Para llevar a cabo el control sobre el ensayo, se necesitó de una interfaz entre el microcontrolador y los circuito de carga y descarga del banco de capacitores. Esta interfaz se compuso combinando relays con un array de transistores Darlington, ULN2003A. Este integrado es capaz de entregar la corriente necesaria para activar la bobina de un relay.

Transcurrido el tiempo de reposo de la muestra bajo presión, el microcontrolador activa al relay que conecta el banco de capacitores a la fuente de 1kV. A partir de ese momento, se espera a que la lectura del conversor A/D determine que se ha alcanzado la tensión necesaria, para luego aislar al banco de la fuente y, mediante otro relay, conectar al banco de capacitores con el compartimiento de la muestra.

Si bien es posible realizar un diseño que sólo utilice un relay para alternar los dos circuitos, se optó por la implementación de dos por separado de forma tal que la electrónica asociada a la carga los capacitores sea totalmente independiente de la circuitería de descarga.

A continuación, se puede apreciar un esquema superficial de la disposición de los elementos relevantes

## a lo explicado anteriormente:

### 1 kV

ADC

Muestra

Albani - Arbelo Arrocha - Figueroa | 13 | 1.er cuatrimestre 2008

# 3.8. Costos

El hardware que compone al proyecto puede separase en tres categorías, según naturaleza y proce-

## dencia:

## 3.8.1. Hardware Digital

La principal competencia de este informe y a lo que se avoca esta sección, consiste en todo el hardware ubicado en la placa principal del equipo y la placa auxiliar de relays.

Nro. de Parte | Descripción | Costo
AT89S52 74HC138 ADC0834 Winstar - WG12864A-PMI-V AT24C256 HJR 1-2C 74HC244N Accesorios | Microcontrolador Decodificador 3 a 8 Conversor A/D 8 bits Display Gráfico Memoria ROM Relays Buffer Placa, cables, conectores, resitores, capacitores, etc | $ 7 $ 1,2 $ 27,60 $ 150 $ 9 $ 5,7 × 2 $ 1,2 × 2 $ 40

## 3.8.2. Hardware Analógico

Una parte del aparejo experimental bajo el control del microcontrolador corresponde a elementos analógicos. Si bien una discusión detallada de estos escapa al ámbito de la materia y el presente informe sus costos se detallan a continuación.

Descripción | Costo
Banco de Capacitores Tiristor ST700CL Tansformador 220 V- 1 kV- 30 mA Tansmisor de presión | $ 5000 $ 150 $ 172 $ 440

## 3.8.3. Equipamiento preexistente del laboratorio

Existe equipamiento utilizado durante la experiencia, esencial para ésta, que debe contabilizarse como un recurso preexistente del Laboratorio de Sólidos Amorfos.
Este es el caso de la prensa hidráulica, que forma parte del patrimonio del Laboratorio desde hace años, volviéndose casi imposible asignarle un costo.
Albani - Arbelo Arrocha - Figueroa | 14 | 1.er cuatrimestre 2008

# 4. Software

# 4.1. Capas de software

En la figura siguiente, puede apreciarse un diagrama de las capas que separan al usuario del hardware.

# interfaz.asm

# ensayos.asm

Hardware: display, teclado, rom, adc, relays, sensores.

# display.asm

# widgets.asm

teclado.asm | rom.asm | adc.asm | timers.asm

# USUARIO

Figura 7: Software en capas.

Albani - Arbelo Arrocha - Figueroa | 15 | 1.er cuatrimestre 2008

# 4.2. Interfaz con el usuario

La interfaz con el usuario fue pensada en un nivel de abstracción más alto en el cual se pudieran ir enunciando, a modo de guión, una a una las acciones a llevar a cabo sin tener la necesidad de adentrarse mucho en los detalles de bajo nivel. Este ideal se logró en mayor y menor medida en distintas partes de ´ dicha descripción.
Los componentes contenedores de la interfaz son: el menú principal, el anillo de ensayos y el menú de edición de parámetros. Ambos menús fueron implementados utilizando a la rutina genérica WIDGETS MENU INTERACT:, cuya tarea es dibujar las cadenas de texto de cada opción e interpretar la presión de las teclas especiales, para permitir al usuario navegarlas y elegir la deseada.
Desde el menú principal se pueden realizar las siguientes tareas: ingresar al anillo de ensayos, agregar un nuevo ensayo a la lista y, dar inicio a la ejecución en serie de todos los ensayos cargados.
El anillo de ensayos no es más que una lista circular que en cada posición muestra en pantalla a todos los parámetros del ensayo seleccionado y ofrece las siguientes opciones para aplicarle: editar sus

## parámetros, ejecutarlo y, finalmente, eliminarlo de la lista²

Tanto desde la opción para agregar un ensayo del menú principal como desde la opción para editar los parámetros de un ensayo, se entrega el control de la aplicación a la rutina INTERFAZ MENU EDITAR ENSAYO:
3
. El menú de edición de parámetros ofrece una opción por cada uno que cuando es elegida, muestra un cursor a la espera de que el usuario ingrese el valor numérico que quiere asignarle al parámetro. Hay una última opción en este menú, llamada Grabar ensayo, que al ser elegida, muestra una pantalla con un resumen de todos los valores ingresados y le permite al usuario confirmar si realmente desea grabarlos o volver a editarlos.

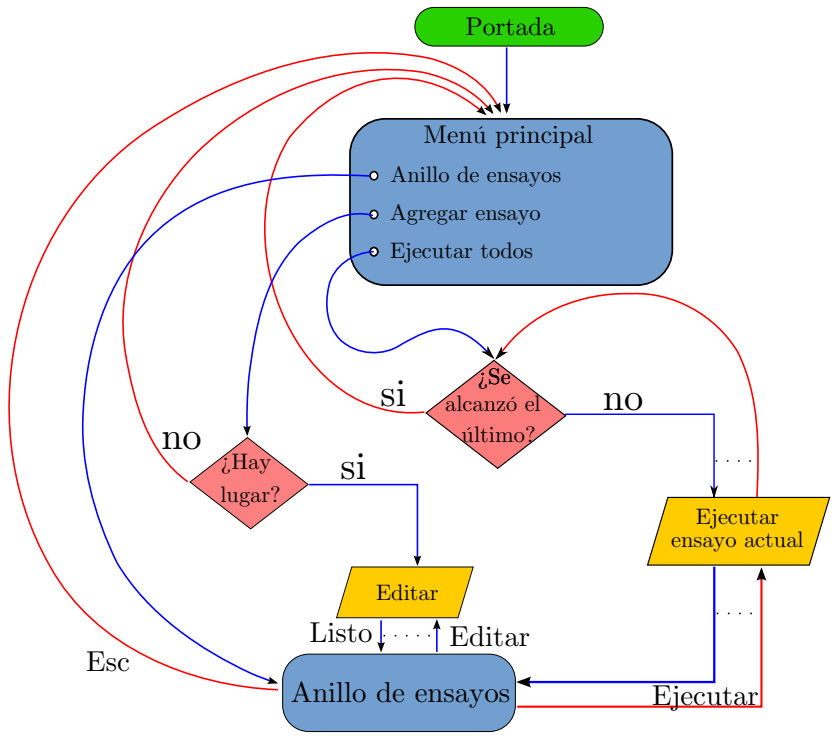
[picture p16: figure]
Portada; Menu principal; Anillo de ensayos; Agregar ensayo; Ejecutar todos; >Se alcanzo el ultimo?; Editar; >Hay; lugar?; Ejecutar ensayo actual; Listo; Ejecutar; Esc

Figura 8: Diagrama de flujo.

2Esto en realidad fue implementado intercambiando al que se desea eliminar con el último, y luego reduciendo la lista. ´ 3En el caso de la opción para agregar un ensayo, antes de entregar el control se hacen las verificacione pertinentes para asegurar la disponibilidad de espacio en memoria ROM.

Albani - Arbelo Arrocha - Figueroa | 16 | 1.er cuatrimestre 2008

# 4.3. Administración de ensayos

La administración de los ensayos se compone de un conjunto de rutinas ubicadas en el archivo ensayos.asm que permiten: cargar y grabar desde y a la memoria ROM los parámetros de un ensayo y

## toda la información contextual necesaria⁴ , eliminar un ensayo de la lista, y ejecutar ensayos en serie o

aisladamente.
La estrategia elegida a la hora de organizar los sectores de memoria ROM a utilizar fue la siguiente: se impuso a 255 como cantidad máxima de ensayos, donde cada uno debería poder definirse en un máximo de 8 bytes, y se reservaron 8 bytes más para la información contextual. De esta manera, se necesitó un total de 2 kbytes, lo que equivale a 32 de las 512 páginas de 64 bytes de la memoria ROM. Se decidió ubicar este bloque en el final de la memoria, es decir, a partir de la página 480, cuya primera dirección se definió como símbolo bajo el nombre de ENSAYOS BASE ROM ADDRESS, y se calculó de la siguiente manera:
512 | − | 32 |
× | 64 | = 30720 = 0x7800

## Cantidad total de páginas

## Cantidad necesaria

## Bytes por página

Una vez definido ese símbolo, definir a la dirección de la información de contexto fue trivial y se obtuvo sumando 255 × 8 a la dirección anterior.

## 4.3.1. Almacenamiento de los parámetros de un ensayo

Como se dijo anteriormente, los parámetros que definen un ensayo son: la tensión de carga del banco de capacitores, la presión mecánica sobre la muestra, el tiempo de reposo en el que la muestra debe permanecer bajo presión y el tiempo de la descarga.

El valor máximo de tensión al que se pueden cargar los capacitores es 1kV. En principio podría parecer que con 1 byte no alcanza para almacenar todos los valores posibles, pero hay una limitación impuesta por el conversor A/D de 8 bits que hace que no sea necesario almacenar el valor explícito de tensión; sólo es necesario hacer una conversión que transforme proporcionalmente al intervalo [0; 1000V] en el intervalo [0; 255].

Un razonamiento análogo se siguió para almacenar el valor de presión mecánica: se almacenó el byte que finalmente esperará el conversor AD, previa conversión del intervalo [0; 20 Tn].

El tiempo de reposo, expresado en segundos, es el único parámetro que requiere ser almacenado en 2 bytes. Esto permite intervalos de hasta 18 horas, 12 minutos y 16 segundos, harto suficientes para satisfacer las necesidades de los investigadores que finalmente utilizarán el dispositivo.

El tiempo de descarga, expresado en milisegundos, pudo ser almacenado en 1 byte ya que 255 es un máximo aceptable para los experimentos.

4Actualmente el contexto sólo consiste en la cantidad de ensayos cargados, pero está dentro de los planes a futuro incluir más información a medida que sea necesaria.

Albani - Arbelo Arrocha - Figueroa | 17 | 1.er cuatrimestre 2008

## 4.3.2. Ejecución de ensayos

Al igual que a la hora de diseñar la interfaz, la rutina de ejecución de ensayos se pensó en un nivel más alto en el cual se pudieran ir listando las órdenes y acciones dirigidas al hardware de manera casi guionada, sin entrar demasiado en los detalles de bajo nivel.
Puede apreciarse en la rutina ENSAYOS REALIZAR ACTUAL:, ubicada en la biblioteca ensayos.asm, como, mediante la combinación de macros y rutinas de alto nivel se alcanzó en mayor y menor medida este objetivo. Esta rutina, puede descomponerse superficialmente en las siguientes etapas:

Carga desde memoria ROM de los parámetros del ensayo a realizar.

Solicitud por pantalla al operario para que indique cuando la muestra ya está lista en el compartimiento.

Solicitud por pantalla al operario para que, valiéndose de la prensa hidráulica, alcance el valor de presión mecánica que el ensayo requiere. Se acompaña la información con una barra que indica visualmente el porcentaje alcanzado. El proceso no continua hasta que el operario alcance el valor y lo confirme por teclado.

Comienzo del tiempo de espera durante el cual la muestra debe permanecer en reposo.

Inicio de la carga del banco de capacitores.

Al alcanzarse la tensión requerida por el ensayo, se detiene la carga y se envía la orden de cierre a la llave que cierra el circuito que forman el banco de capacitores con la muestra en el compartimiento.

Aviso al operario para que retire la muestra.

Albani - Arbelo Arrocha - Figueroa | 18 | 1.er cuatrimestre 2008

# 5. Conclusión

Finalmente y en primera persona, queremos finalizar con algunas apreciaciones sobre el resultado final, las cosas que quedaron en el tintero, las dificultades encontradas y los planes a futuro.

No hubo un punto particular al cual podamos atribuirle las principales dificultades; han estado dis-tribuidas de manera muy uniforme. Comenzamos la materia con un conocimiento prácticamente nulo y cada pequeña nueva pieza de conocimiento nos consumió tiempos apreciables. Prohibirnos hacer las cosas sin antes entenderlas, fue una decisión que se pagó con mucho tiempo y esfuerzo.

Quizá de todas las cosas que quedaron afuera, el no haber podido acceder a una prensa para controlar desatendidamente sea la más importante, pues nos obligó a hacer que el dispositivo dependa mucho de la asistencia humana.

Una vez fundido el material magnético mediante la técnica de Spark Plasma, resta magnetizarlo para obtener finalmente un imán. Dentro de los planes a futuro se encuentra la expansión del dispositivo para poder controlar también esa etapa de los ensayos valiéndose de una bobina y posiblemente la misma fuente de tensión.

Comparando los objetivos con el resultado final, podemos decir que hemos llegado a implementar prácticamente toda la lógica necesaria. Inicialmente, también deseábamos finalizar la implantación defini-tiva junto a la prensa hidráulica, la fuente de 1 kV y el banco de capacitores, pero por falta de tiempo y otras dificultades, no nos fue posible. Más allá de eso, pudimos verificar la correcta comunicación con el sensor de presión y hemos diseñado todos los circuitos de la fuente (realizamos una primera versión para probar a 220 V) y la etapa del disparo mediante un tiristor adecuado para soportar las magnitudes que implica una tensión de 1 kV. Cabe aclarar que, mientras no que tengamos en nuestras manos a los primeros imanes producidos con esta técnica, continuaremos trabajando junto a la gente del Laborato-

## rio de Sólidos Amorfos. Este ha sido simplemente el comienzo. ´

Buenos Aires,
16 de julio de 2008.
Albani - Arbelo Arrocha - Figueroa | 19 | 1.er cuatrimestre 2008

# 6. Código fuente

# 6.1. main.asm

;;;;;;;;;;;;;;;;;;;;;;;;;;;;;;;;;;;;;;;;;;;;;;;;;;;;;;;;;;;;;;;;;;;;;;;;;;;;;;;; ;;;;;;;;;;;;;;;;;;;;;;;;;;;;;;;;;;;;;;;;;;;;;;;;;;;;;;;;;;;;;;;;;;;;;;;;;;;;;;;; ;; Inicio del programa.
;;;;;;;;;;;;;;;;;;;;;;;;;;;;;;;;;;;;;;;;;;;;;;;;;;;;;;;;;;;;;;;;;;;;;;;;;;;;;;;; ;;;;;;;;;;;;;;;;;;;;;;;;;;;;;;;;;;;;;;;;;;;;;;;;;;;;;;;;;;;;;;;;;;;;;;;;;;;;;;;;

; Se incluyen las macros primero:
$INCLUDE(macros.asm)
DSEG | at | 020h

CSEG
ORG | 0000H | ; Reset.
JMP | MAIN
ORG | 000BH
JMP | TIMERS T0ISR | ; Timer 0 Interrupt Service Rutine.
ORG | 001BH
JMP | TIMERS T1ISR | ; Timer 1 Interrupt Service Rutine.
ORG | 0030H

;;;;;;;;;;;;;;;;;;;;;;;;;;;;;;;;;;;;;;;;;;;;;;;;;;;;;;;;;;;;;;;;;;;;;;;;;;;;;;;; ;;;;;;;;;;;;;;;;;;;;;;;;;;;;;;;;;;;;;;;;;;;;;;;;;;;;;;;;;;;;;;;;;;;;;;;;;;;;;;;; ;; Inclusión de librerías: ;;;;;;;;;;;;;;;;;;;;;;;;;;;;;;;;;;;;;;;;;;;;;;;;;;;;;;;;;;;;;;;;;;;;;;;;;;;;;;;; ;;;;;;;;;;;;;;;;;;;;;;;;;;;;;;;;;;;;;;;;;;;;;;;;;;;;;;;;;;;;;;;;;;;;;;;;;;;;;;;;
$INCLUDE(timers.asm) | ; Control de timers y cronómetros.
$INCLUDE(hardware/decoder.asm) | ; Selección de dispositivos.
$INCLUDE(hardware/adc.asm) | ; Control del ADC.
$INCLUDE(hardware/display.asm) | ; Control del display.
$INCLUDE(hardware/keypad.asm) | ; Control del teclado.
$INCLUDE(hardware/rom.asm) | ; Control de la memoria ROM.
$INCLUDE(widgets.asm) | ; Rutinas para crear accesorios en pantalla.
$INCLUDE(ensayos.asm) | ; Rutinas para manipular ensayos.
$INCLUDE(interfaz.asm) | ; Bucles ad hoc que describen la interfaz.
$INCLUDE(screens.asm) | ; Grabación de pantallas gráficas a ROM.
$INCLUDE(i18n/i18n−sp.asm) | ; Internacionalización: castellano.
$INCLUDE(misc.asm) | ; Rutinas misceláneas.
;;;;;;;;;;;;;;;;;;;;;;;;;;;;;;;;;;;;;;;;;;;;;;;;;;;;;;;;;;;;;;;;;;;;;;;;;;;;;;;; ;;;;;;;;;;;;;;;;;;;;;;;;;;;;;;;;;;;;;;;;;;;;;;;;;;;;;;;;;;;;;;;;;;;;;;;;;;;;;;;;

DSEG

;;;;;;;;;;;;;;;;;;;;;;;;;;;;;;;;;;;;;;;;;;;;;;;;;;;;;;;;;;;;;;;;;;;;;;;;;;;;;;;; ;;;;;;;;;;;;;;;;;;;;;;;;;;;;;;;;;;;;;;;;;;;;;;;;;;;;;;;;;;;;;;;;;;;;;;;;;;;;;;;; ; Luego de que todas las bibliotecas hayan reservado el espacio para
; todas sus variables, se "reserva" la última posición para poder
; aprovechar el resto de la RAM para la pila:
STACK POINTER START: | DS | 1

;;;;;;;;;;;;;;;;;;;;;;;;;;;;;;;;;;;;;;;;;;;;;;;;;;;;;;;;;;;;;;;;;;;;;;;;;;;;;;;; ;;;;;;;;;;;;;;;;;;;;;;;;;;;;;;;;;;;;;;;;;;;;;;;;;;;;;;;;;;;;;;;;;;;;;;;;;;;;;;;;

Albani - Arbelo Arrocha - Figueroa | 20 | 1.er cuatrimestre 2008

CSEG

;;;;;;;;;;;;;;;;;;;;;;;;;;;;;;;;;;;;;;;;;;;;;;;;;;;;;;;;;;;;;;;;;;;;;;;;;;;;;;;; ;;;;;;;;;;;;;;;;;;;;;;;;;;;;;;;;;;;;;;;;;;;;;;;;;;;;;;;;;;;;;;;;;;;;;;;;;;;;;;;; MAIN:
;;;;;;;;;;;;;;;;;;;;;;;;;;;;;;;;;;;;;;;;;;;;;;;;;;;;;;;;;;;;;;;;;;;;;;;;;;;;;;;; ;;;;;;;;;;;;;;;;;;;;;;;;;;;;;;;;;;;;;;;;;;;;;;;;;;;;;;;;;;;;;;;;;;;;;;;;;;;;;;;; ;; Punto de inicio de del programa. ;;;;;;;;;;;;;;;;;;;;;;;;;;;;;;;;;;;;;;;;;;;;;;;;;;;;;;;;;;;;;;;;;;;;;;;;;;;;;;;; ;;;;;;;;;;;;;;;;;;;;;;;;;;;;;;;;;;;;;;;;;;;;;;;;;;;;;;;;;;;;;;;;;;;;;;;;;;;;;;;;

; Se apagan todos los puertos por seguridad:
MOV | P0, #00h
MOV | P1, #00h
MOV | P2, #00h
MOV | P3, #00h

; Se apunta al stack pointer a la última posición de RAM reservada:
MOV | SP, #STACK POINTER START − 1

; Se activan globalmente las interrupciones y se desactivan
; todas a la espera de activaciones individuales:
MOV | IE, #10000000b

; Se inicializan los timers:
CALL | TIMERS INIT

; Se inicializa al display:
CALL | DISPLAY INIT

; Se muestra una portada con scroll:
MOV | rom address L, | #LOW(SCREENS LOGOFIUBA ADDRESS)
MOV | rom address H, | #HIGH(SCREENS LOGOFIUBA ADDRESS)
CALL | SCREENS DUMP TO DISPLAY FROM ROM
CALL | DISPLAY SCROLL

; Se pasa el control de la aplicación al menú principal:
JMP | INTERFAZ MENU PRINCIPAL
;;;;;;;;;;;;;;;;;;;;;;;;;;;;;;;;;;;;;;;;;;;;;;;;;;;;;;;;;;;;;;;;;;;;;;;;;;;;;;;; ;;;;;;;;;;;;;;;;;;;;;;;;;;;;;;;;;;;;;;;;;;;;;;;;;;;;;;;;;;;;;;;;;;;;;;;;;;;;;;;;
Albani - Arbelo Arrocha - Figueroa | 21 | 1.er cuatrimestre 2008

# 6.2. display.asm

;;;;;;;;;;;;;;;;;;;;;;;;;;;;;;;;;;;;;;;;;;;;;;;;;;;;;;;;;;;;;;;;;;;;;;;;;;;;;;;; ;;;;;;;;;;;;;;;;;;;;;;;;;;;;;;;;;;;;;;;;;;;;;;;;;;;;;;;;;;;;;;;;;;;;;;;;;;;;;;;; ;; Rutinas de control del dispositivo: Winstar Display WG12864A−PMI−V
;; Dimensiones: 128x64 pixels en dos sectores de 64x64.
;;
;; Interface:
;; −−−−−−−−−
;;
;; −−−−−−−−−−−−−−−−−−−−−−−−−−−−−−−−−−−−−−−−−−−−−−−−−−−−−−−−−−−−−−−−−−−−−−−−−−
;; Pin | Symbol | | Level | | Description
;; −−−−−−−−−−−−−−−−−−−−−−−−−−−−−−−−−−−−−−−−−−−−−−−−−−−−−−−−−−−−−−−−−−−−−−−−−−
;; | 1 | Vss | 0 V | Ground
;; | 2 | Vdd | 5.0 V | Supply voltage for logic
;; | 3 | Vo | (Variable) | Operating voltage for LCD
;; | 4 | D/I | H/L | H: Data, L : Instruction
;; | 5 | R/W | H/L | H: Read (MPU<−Module), L: Write (MPU−>Module)
;; | 6 | E | H | Enable signal
;; | 7 | DB0 | H/L | Data bit 0
;; | 8 | DB1 | H/L | Data bit 1
;; | 9 | DB2 | H/L | Data bit 2
;; | 10 | DB3 | H/L | Data bit 3
;; | 11 | DB4 | H/L | Data bit 4
;; | 12 | DB5 | H/L | Data bit 5
;; | 13 | DB6 | H/L | Data bit 6
;; | 14 | DB7 | H/L | Data bit 7
;; | 15 | CS1 | L | Select Column 1˜64
;; | 16 | CS2 | L | Select Column 65˜128
;; | 17 | RES | L | Reset signal
;; | 18 | Vout | − | Negative Voltage
;; | 19 | A | − | Power Supply for LED backlight ( + )
;; | 20 | K | − | Power Supply for LED backlight ( − )
;; −−−−−−−−−−−−−−−−−−−−−−−−−−−−−−−−−−−−−−−−−−−−−−−−−−−−−−−−−−−−−−−−−−−−−−−−−− ;; −−−−−−−−−−−−−−−−−−−−−−−−−−−−−−−−−−−−−−−−−−−−−−−−−−−−−−−−−−−−−−−−−−−−−−−−−−
;;;;;;;;;;;;;;;;;;;;;;;;;;;;;;;;;;;;;;;;;;;;;;;;;;;;;;;;;;;;;;;;;;;;;;;;;;;;;;;; ;;;;;;;;;;;;;;;;;;;;;;;;;;;;;;;;;;;;;;;;;;;;;;;;;;;;;;;;;;;;;;;;;;;;;;;;;;;;;;;; ;;
;; Rutinas y macros públicas:
;; −−−−−−−−−−−−−−−−−−−−−−−−−
;; | DISPLAY MACRO PUT ASCII
;; | DISPLAY MACRO PUT STRING STATIC
;; | DISPLAY MACRO PUT STRING STATIC INMEDIATE
;; | DISPLAY INIT
;; | DISPLAY ON
;; | DISPLAY OFF
;; | DISPLAY CLEAR
;; | DISPLAY SCROLL
;; | DISPLAY PUT BYTE
;; | DISPLAY PUT CHAR
;; | DISPLAY PUT ASCII
;; | DISPLAY PUT STRING STATIC
;; | DISPLAY PUT STRING DYNAMIC
;; | DISPLAY PUT SCREEN FROM CODE
;;
;; Requisitos de esta biblioteca:
;; −−−−−−−−−−−−−−−−−−−−−−−−−−−−−
;; | | | | Existencia de una macro llamada
;; | | | | DISPLAY MACRO SELECT que garantice la
;; | | | | disponibilidad del display.
;;
;; | | | | Existencia de dos macros llamadas
;; | | | | START SENSIBLE OP y END SENSIBLE OP
;; | | | | para indicarle al exterior el comienzo y fin
;; | | | | de operaciones de I/O sensibles.
Albani - Arbelo Arrocha - Figueroa | 22 | 1.er cuatrimestre 2008

;;
;;;;;;;;;;;;;;;;;;;;;;;;;;;;;;;;;;;;;;;;;;;;;;;;;;;;;;;;;;;;;;;;;;;;;;;;;;;;;;;; ;;;;;;;;;;;;;;;;;;;;;;;;;;;;;;;;;;;;;;;;;;;;;;;;;;;;;;;;;;;;;;;;;;;;;;;;;;;;;;;; ;; Definiciones:
;;;;;;;;;;;;;;;;;;;;;;;;;;;;;;;;;;;;;;;;;;;;;;;;;;;;;;;;;;;;;;;;;;;;;;;;;;;;;;;; ;;;;;;;;;;;;;;;;;;;;;;;;;;;;;;;;;;;;;;;;;;;;;;;;;;;;;;;;;;;;;;;;;;;;;;;;;;;;;;;;

; Conexionado:
DISPLAY RESET | EQU | P0.2
DISPLAY SELECT LEFT SECTOR | EQU | P0.3
DISPLAY SELECT RIGHT SECTOR | EQU | P0.4
DISPLAY ENABLE | EQU | P0.5
DISPLAY RW MODE | EQU | P0.6
DISPLAY DI MODE | EQU | P0.7
DISPLAY DATABUS | EQU | P2

; Códigos internos de las instrucciones básicas:
DISPLAY INSTRUCTION ON | EQU | 00111111b | ; 3F
DISPLAY INSTRUCTION OFF | EQU | 00111110b | ; 3E
DISPLAY INSTRUCTION PAGE 0 | EQU | 10111000b | ; B8
DISPLAY INSTRUCTION COLUMN 0 | EQU | 01000000b | ; 40
DISPLAY INSTRUCTION START LINE 0 | EQU | 11000000b | ; C0

; Máscaras:
DISPLAY STATUS BUSY MASK | EQU | 10000000b | ; 80
DISPLAY STATUS OFF MASK | EQU | 00100000b | ; 20
DISPLAY STATUS RESET MASK | EQU | 00010000b | ; 10
;;;;;;;;;;;;;;;;;;;;;;;;;;;;;;;;;;;;;;;;;;;;;;;;;;;;;;;;;;;;;;;;;;;;;;;;;;;;;;;; ;;;;;;;;;;;;;;;;;;;;;;;;;;;;;;;;;;;;;;;;;;;;;;;;;;;;;;;;;;;;;;;;;;;;;;;;;;;;;;;;

;;;;;;;;;;;;;;;;;;;;;;;;;;;;;;;;;;;;;;;;;;;;;;;;;;;;;;;;;;;;;;;;;;;;;;;;;;;;;;;; ;;;;;;;;;;;;;;;;;;;;;;;;;;;;;;;;;;;;;;;;;;;;;;;;;;;;;;;;;;;;;;;;;;;;;;;;;;;;;;;; ;; Macros de uso interno:
;;;;;;;;;;;;;;;;;;;;;;;;;;;;;;;;;;;;;;;;;;;;;;;;;;;;;;;;;;;;;;;;;;;;;;;;;;;;;;;; ;;;;;;;;;;;;;;;;;;;;;;;;;;;;;;;;;;;;;;;;;;;;;;;;;;;;;;;;;;;;;;;;;;;;;;;;;;;;;;;;

;;;;;;;;;;;;;;;;;;;;;;;;;;;;;;;;;;;;;;;;;;;;;;;;;;;;;;;;;;;;;;;;;;;;;;;;;;;;;;;; ;; Activar modo de lectura. ;;;;;;;;;;;;;;;;;;;;;;;;;;;;;;;;;;;;;;;;;;;;;;;;;;;;;;;;;;;;;;;;;;;;;;;;;;;;;;;; DISPLAY MACRO READ MODE MACRO
SETB | DISPLAY RW MODE
ENDM
;;;;;;;;;;;;;;;;;;;;;;;;;;;;;;;;;;;;;;;;;;;;;;;;;;;;;;;;;;;;;;;;;;;;;;;;;;;;;;;; ;;;;;;;;;;;;;;;;;;;;;;;;;;;;;;;;;;;;;;;;;;;;;;;;;;;;;;;;;;;;;;;;;;;;;;;;;;;;;;;;

;;;;;;;;;;;;;;;;;;;;;;;;;;;;;;;;;;;;;;;;;;;;;;;;;;;;;;;;;;;;;;;;;;;;;;;;;;;;;;;; ;; Activar modo de escritura. ;;;;;;;;;;;;;;;;;;;;;;;;;;;;;;;;;;;;;;;;;;;;;;;;;;;;;;;;;;;;;;;;;;;;;;;;;;;;;;;; DISPLAY MACRO WRITE MODE MACRO
CLR | DISPLAY RW MODE
ENDM
;;;;;;;;;;;;;;;;;;;;;;;;;;;;;;;;;;;;;;;;;;;;;;;;;;;;;;;;;;;;;;;;;;;;;;;;;;;;;;;; ;;;;;;;;;;;;;;;;;;;;;;;;;;;;;;;;;;;;;;;;;;;;;;;;;;;;;;;;;;;;;;;;;;;;;;;;;;;;;;;;

;;;;;;;;;;;;;;;;;;;;;;;;;;;;;;;;;;;;;;;;;;;;;;;;;;;;;;;;;;;;;;;;;;;;;;;;;;;;;;;; ;; Activar modo de instrucciones. ;;;;;;;;;;;;;;;;;;;;;;;;;;;;;;;;;;;;;;;;;;;;;;;;;;;;;;;;;;;;;;;;;;;;;;;;;;;;;;;; DISPLAY MACRO INST MODE MACRO
CLR | DISPLAY DI MODE
ENDM
;;;;;;;;;;;;;;;;;;;;;;;;;;;;;;;;;;;;;;;;;;;;;;;;;;;;;;;;;;;;;;;;;;;;;;;;;;;;;;;; ;;;;;;;;;;;;;;;;;;;;;;;;;;;;;;;;;;;;;;;;;;;;;;;;;;;;;;;;;;;;;;;;;;;;;;;;;;;;;;;;

;;;;;;;;;;;;;;;;;;;;;;;;;;;;;;;;;;;;;;;;;;;;;;;;;;;;;;;;;;;;;;;;;;;;;;;;;;;;;;;; ;; Activar modo de datos.

Albani - Arbelo Arrocha - Figueroa | 23 | 1.er cuatrimestre 2008

;;;;;;;;;;;;;;;;;;;;;;;;;;;;;;;;;;;;;;;;;;;;;;;;;;;;;;;;;;;;;;;;;;;;;;;;;;;;;;;; DISPLAY MACRO DATA MODE MACRO
SETB | DISPLAY DI MODE
ENDM
;;;;;;;;;;;;;;;;;;;;;;;;;;;;;;;;;;;;;;;;;;;;;;;;;;;;;;;;;;;;;;;;;;;;;;;;;;;;;;;; ;;;;;;;;;;;;;;;;;;;;;;;;;;;;;;;;;;;;;;;;;;;;;;;;;;;;;;;;;;;;;;;;;;;;;;;;;;;;;;;;

;;;;;;;;;;;;;;;;;;;;;;;;;;;;;;;;;;;;;;;;;;;;;;;;;;;;;;;;;;;;;;;;;;;;;;;;;;;;;;;; ;; Realizar un strobe.
;;;;;;;;;;;;;;;;;;;;;;;;;;;;;;;;;;;;;;;;;;;;;;;;;;;;;;;;;;;;;;;;;;;;;;;;;;;;;;;; DISPLAY MACRO STROBE ENABLE MACRO
SETB | DISPLAY ENABLE
NOP
CLR | DISPLAY ENABLE
ENDM
;;;;;;;;;;;;;;;;;;;;;;;;;;;;;;;;;;;;;;;;;;;;;;;;;;;;;;;;;;;;;;;;;;;;;;;;;;;;;;;; ;;;;;;;;;;;;;;;;;;;;;;;;;;;;;;;;;;;;;;;;;;;;;;;;;;;;;;;;;;;;;;;;;;;;;;;;;;;;;;;;

;;;;;;;;;;;;;;;;;;;;;;;;;;;;;;;;;;;;;;;;;;;;;;;;;;;;;;;;;;;;;;;;;;;;;;;;;;;;;;;; ;; Enviar el contenido del acumulador como dato. ;;;;;;;;;;;;;;;;;;;;;;;;;;;;;;;;;;;;;;;;;;;;;;;;;;;;;;;;;;;;;;;;;;;;;;;;;;;;;;;; DISPLAY MACRO SEND DATA MACRO
; Informa sobre el inicio de una operación sensible:
START SENSIBLE OP

; Activa el modo de escritura de datos:
DISPLAY MACRO WRITE MODE
DISPLAY MACRO DATA MODE

; Envía al databus el contenido del acumulador y realiza un strobe:
MOV | DISPLAY DATABUS, A
DISPLAY MACRO STROBE ENABLE

; Informa sobre el término de una operación sensible:
END SENSIBLE OP
ENDM
;;;;;;;;;;;;;;;;;;;;;;;;;;;;;;;;;;;;;;;;;;;;;;;;;;;;;;;;;;;;;;;;;;;;;;;;;;;;;;;; ;;;;;;;;;;;;;;;;;;;;;;;;;;;;;;;;;;;;;;;;;;;;;;;;;;;;;;;;;;;;;;;;;;;;;;;;;;;;;;;;

;;;;;;;;;;;;;;;;;;;;;;;;;;;;;;;;;;;;;;;;;;;;;;;;;;;;;;;;;;;;;;;;;;;;;;;;;;;;;;;; ;; Enviar el contenido del acumulador como instrucción. ;;;;;;;;;;;;;;;;;;;;;;;;;;;;;;;;;;;;;;;;;;;;;;;;;;;;;;;;;;;;;;;;;;;;;;;;;;;;;;;; DISPLAY MACRO SEND INSTRUCTION MACRO
; Informa sobre el inicio de una operación sensible:
START SENSIBLE OP

; Activa el modo de escritura de instrucciones: DISPLAY MACRO WRITE MODE
DISPLAY MACRO INST MODE

; Envía al databus el contenido del acumulador y realiza un strobe:
MOV | DISPLAY DATABUS, A
DISPLAY MACRO STROBE ENABLE

; Informa sobre el término de una operación sensible:
END SENSIBLE OP
ENDM
;;;;;;;;;;;;;;;;;;;;;;;;;;;;;;;;;;;;;;;;;;;;;;;;;;;;;;;;;;;;;;;;;;;;;;;;;;;;;;;; ;;;;;;;;;;;;;;;;;;;;;;;;;;;;;;;;;;;;;;;;;;;;;;;;;;;;;;;;;;;;;;;;;;;;;;;;;;;;;;;;

;;;;;;;;;;;;;;;;;;;;;;;;;;;;;;;;;;;;;;;;;;;;;;;;;;;;;;;;;;;;;;;;;;;;;;;;;;;;;;;; ;;;;;;;;;;;;;;;;;;;;;;;;;;;;;;;;;;;;;;;;;;;;;;;;;;;;;;;;;;;;;;;;;;;;;;;;;;;;;;;; DISPLAY MACRO SET PAGE MACRO ;;;;;;;;;;;;;;;;;;;;;;;;;;;;;;;;;;;;;;;;;;;;;;;;;;;;;;;;;;;;;;;;;;;;;;;;;;;;;;;; ;; Encapsula a la estructura típica para cambiar de página al puntero
;; del display. Recibe en el acumulador a la página (rango: [0;7]).
Albani - Arbelo Arrocha - Figueroa | 24 | 1.er cuatrimestre 2008

;;;;;;;;;;;;;;;;;;;;;;;;;;;;;;;;;;;;;;;;;;;;;;;;;;;;;;;;;;;;;;;;;;;;;;;;;;;;;;;; ; Se suma la dirección base definida por el fabricante:
ADD | A, #DISPLAY INSTRUCTION PAGE 0
DISPLAY MACRO SEND INSTRUCTION
ENDM

;;;;;;;;;;;;;;;;;;;;;;;;;;;;;;;;;;;;;;;;;;;;;;;;;;;;;;;;;;;;;;;;;;;;;;;;;;;;;;;; ;;;;;;;;;;;;;;;;;;;;;;;;;;;;;;;;;;;;;;;;;;;;;;;;;;;;;;;;;;;;;;;;;;;;;;;;;;;;;;;; DISPLAY MACRO SET COLUMN MACRO ;;;;;;;;;;;;;;;;;;;;;;;;;;;;;;;;;;;;;;;;;;;;;;;;;;;;;;;;;;;;;;;;;;;;;;;;;;;;;;;; ;; Encapsula a la estructura típica para cambiar de columna al puntero
;; del display. Recibe en el acumulador a la columna (rango: [0;63]). ;;;;;;;;;;;;;;;;;;;;;;;;;;;;;;;;;;;;;;;;;;;;;;;;;;;;;;;;;;;;;;;;;;;;;;;;;;;;;;;; ; Se suma la dirección base definida por el fabricante:
ADD | A, #DISPLAY INSTRUCTION COLUMN 0
DISPLAY MACRO SEND INSTRUCTION
ENDM
;;;;;;;;;;;;;;;;;;;;;;;;;;;;;;;;;;;;;;;;;;;;;;;;;;;;;;;;;;;;;;;;;;;;;;;;;;;;;;;; ;;;;;;;;;;;;;;;;;;;;;;;;;;;;;;;;;;;;;;;;;;;;;;;;;;;;;;;;;;;;;;;;;;;;;;;;;;;;;;;;

;;;;;;;;;;;;;;;;;;;;;;;;;;;;;;;;;;;;;;;;;;;;;;;;;;;;;;;;;;;;;;;;;;;;;;;;;;;;;;;; ;;;;;;;;;;;;;;;;;;;;;;;;;;;;;;;;;;;;;;;;;;;;;;;;;;;;;;;;;;;;;;;;;;;;;;;;;;;;;;;; ;; Macros públicas:
;;;;;;;;;;;;;;;;;;;;;;;;;;;;;;;;;;;;;;;;;;;;;;;;;;;;;;;;;;;;;;;;;;;;;;;;;;;;;;;; ;;;;;;;;;;;;;;;;;;;;;;;;;;;;;;;;;;;;;;;;;;;;;;;;;;;;;;;;;;;;;;;;;;;;;;;;;;;;;;;;

;;;;;;;;;;;;;;;;;;;;;;;;;;;;;;;;;;;;;;;;;;;;;;;;;;;;;;;;;;;;;;;;;;;;;;;;;;;;;;;; ;;;;;;;;;;;;;;;;;;;;;;;;;;;;;;;;;;;;;;;;;;;;;;;;;;;;;;;;;;;;;;;;;;;;;;;;;;;;;;;; DISPLAY MACRO PUT ASCII MACRO codigo, pagina, columna ;;;;;;;;;;;;;;;;;;;;;;;;;;;;;;;;;;;;;;;;;;;;;;;;;;;;;;;;;;;;;;;;;;;;;;;;;;;;;;;; ;; Encapsula a la típica estructura necesaria para mostrar en pantalla
;; una caracter a partir de su código ASCII. ;;;;;;;;;;;;;;;;;;;;;;;;;;;;;;;;;;;;;;;;;;;;;;;;;;;;;;;;;;;;;;;;;;;;;;;;;;;;;;;; ;;
;; Ejemplo de uso:
;; −−−−−−−−−−−−−−
;; DISPLAY MACRO PUT ASCII 'F', 3d, 4d
;; (Muestra en la página 3 y columna 4 al caracter "F".)
;;
;;;;;;;;;;;;;;;;;;;;;;;;;;;;;;;;;;;;;;;;;;;;;;;;;;;;;;;;;;;;;;;;;;;;;;;;;;;;;;;;
MOV | display data, #codigo
MOV | display page, #pagina
MOV | display column, #columna
CALL | DISPLAY PUT ASCII
ENDM
;;;;;;;;;;;;;;;;;;;;;;;;;;;;;;;;;;;;;;;;;;;;;;;;;;;;;;;;;;;;;;;;;;;;;;;;;;;;;;;; ;;;;;;;;;;;;;;;;;;;;;;;;;;;;;;;;;;;;;;;;;;;;;;;;;;;;;;;;;;;;;;;;;;;;;;;;;;;;;;;;

;;;;;;;;;;;;;;;;;;;;;;;;;;;;;;;;;;;;;;;;;;;;;;;;;;;;;;;;;;;;;;;;;;;;;;;;;;;;;;;; ;;;;;;;;;;;;;;;;;;;;;;;;;;;;;;;;;;;;;;;;;;;;;;;;;;;;;;;;;;;;;;;;;;;;;;;;;;;;;;;; DISPLAY MACRO PUT STRING STATIC MACRO direccion, pagina, columna ;;;;;;;;;;;;;;;;;;;;;;;;;;;;;;;;;;;;;;;;;;;;;;;;;;;;;;;;;;;;;;;;;;;;;;;;;;;;;;;; ;; Encapsula a la típica estructura necesaria para mostrar en pantalla
;; una cadena ubicada en memoria de código. ;;;;;;;;;;;;;;;;;;;;;;;;;;;;;;;;;;;;;;;;;;;;;;;;;;;;;;;;;;;;;;;;;;;;;;;;;;;;;;;; ;;
;; Ejemplo de uso:
;; −−−−−−−−−−−−−−
;; MACRO PUT STRING STATIC LABEL, 3d, 4d
;; (Muestra en la página 3 y columna 4 a la cadena ubicada en "LABEL".)
;;
;;;;;;;;;;;;;;;;;;;;;;;;;;;;;;;;;;;;;;;;;;;;;;;;;;;;;;;;;;;;;;;;;;;;;;;;;;;;;;;;
MOV | DPTR, #direccion
MOV | display page, #pagina
MOV | display column, #columna
Albani - Arbelo Arrocha - Figueroa | 25 | 1.er cuatrimestre 2008

CALL | DISPLAY PUT STRING STATIC
ENDM
;;;;;;;;;;;;;;;;;;;;;;;;;;;;;;;;;;;;;;;;;;;;;;;;;;;;;;;;;;;;;;;;;;;;;;;;;;;;;;;; ;;;;;;;;;;;;;;;;;;;;;;;;;;;;;;;;;;;;;;;;;;;;;;;;;;;;;;;;;;;;;;;;;;;;;;;;;;;;;;;;

;;;;;;;;;;;;;;;;;;;;;;;;;;;;;;;;;;;;;;;;;;;;;;;;;;;;;;;;;;;;;;;;;;;;;;;;;;;;;;;; ;;;;;;;;;;;;;;;;;;;;;;;;;;;;;;;;;;;;;;;;;;;;;;;;;;;;;;;;;;;;;;;;;;;;;;;;;;;;;;;; DISPLAY MACRO PUT STRING STATIC INMEDIATE MACRO cadena, pagina, columna
LOCAL | L1, L2 | ; Definición local de las etiquetas para evitar colisiones.
;;;;;;;;;;;;;;;;;;;;;;;;;;;;;;;;;;;;;;;;;;;;;;;;;;;;;;;;;;;;;;;;;;;;;;;;;;;;;;;; ;; Permite hacer lo mismo que MACRO PUT STRING STATIC, pero sin necesidad de ;; haber definido anteriormente a la cadena en memoria de código.
;; Toma como parámetro un literal y define in situ a la cadena.
;; No es recomendable usarlo para cadenas repetidas, pues se duplica
;; innecesariamente el espacio utilizado. ;;;;;;;;;;;;;;;;;;;;;;;;;;;;;;;;;;;;;;;;;;;;;;;;;;;;;;;;;;;;;;;;;;;;;;;;;;;;;;;; ;;
;; Ejemplo de uso:
;; −−−−−−−−−−−−−−
;; MACRO PUT STRING STATIC INMEDIATE 'Texto a mostrar', 3d, 4d
;; (Muestra en la página 3 y columna 4 al literal especificado.)
;;
;;;;;;;;;;;;;;;;;;;;;;;;;;;;;;;;;;;;;;;;;;;;;;;;;;;;;;;;;;;;;;;;;;;;;;;;;;;;;;;; ; Es necesario saltar a la cadena antes de ejecutar el código:
SJMP | L2

; Definición in situ de la cadena:
L1: DB | &cadena, 0d

; Una vez alcanzado este punto, se reutiliza a MACRO PUT STRING STATIC: L2: DISPLAY MACRO PUT STRING STATIC L1, pagina, columna
ENDM
;;;;;;;;;;;;;;;;;;;;;;;;;;;;;;;;;;;;;;;;;;;;;;;;;;;;;;;;;;;;;;;;;;;;;;;;;;;;;;;; ;;;;;;;;;;;;;;;;;;;;;;;;;;;;;;;;;;;;;;;;;;;;;;;;;;;;;;;;;;;;;;;;;;;;;;;;;;;;;;;;

DSEG

;;;;;;;;;;;;;;;;;;;;;;;;;;;;;;;;;;;;;;;;;;;;;;;;;;;;;;;;;;;;;;;;;;;;;;;;;;;;;;;; ;; Variables de posicionamiento utilizadas como argumentos
;; de las rutinas a las que se les pide ubicar algo en pantalla:
display page: | DS | 1 ; Rango: [0;7]
display column: | DS | 1 ; Rango: [0;127] o [0;19] (depende del contexto)
;;;;;;;;;;;;;;;;;;;;;;;;;;;;;;;;;;;;;;;;;;;;;;;;;;;;;;;;;;;;;;;;;;;;;;;;;;;;;;;;

;;;;;;;;;;;;;;;;;;;;;;;;;;;;;;;;;;;;;;;;;;;;;;;;;;;;;;;;;;;;;;;;;;;;;;;;;;;;;;;; ;; Variable de propósito general utilizada como argumento
;; de las rutinas que procesan un byte (DISPLAY PUT BYTE y DISPLAY PUT ASCII):
display data: | DS | 1
;;;;;;;;;;;;;;;;;;;;;;;;;;;;;;;;;;;;;;;;;;;;;;;;;;;;;;;;;;;;;;;;;;;;;;;;;;;;;;;;

CSEG

;;;;;;;;;;;;;;;;;;;;;;;;;;;;;;;;;;;;;;;;;;;;;;;;;;;;;;;;;;;;;;;;;;;;;;;;;;;;;;;; ;;;;;;;;;;;;;;;;;;;;;;;;;;;;;;;;;;;;;;;;;;;;;;;;;;;;;;;;;;;;;;;;;;;;;;;;;;;;;;;; DISPLAY ENABLE LEFT SECTOR: ;;;;;;;;;;;;;;;;;;;;;;;;;;;;;;;;;;;;;;;;;;;;;;;;;;;;;;;;;;;;;;;;;;;;;;;;;;;;;;;; ;;;;;;;;;;;;;;;;;;;;;;;;;;;;;;;;;;;;;;;;;;;;;;;;;;;;;;;;;;;;;;;;;;;;;;;;;;;;;;;; ;; Rutina para seleccionar al sector izquierdo del display. ;;;;;;;;;;;;;;;;;;;;;;;;;;;;;;;;;;;;;;;;;;;;;;;;;;;;;;;;;;;;;;;;;;;;;;;;;;;;;;;; START SENSIBLE OP
CLR | DISPLAY SELECT LEFT SECTOR
SETB | DISPLAY SELECT RIGHT SECTOR
Albani - Arbelo Arrocha - Figueroa | 26 | 1.er cuatrimestre 2008

NOP
END SENSIBLE OP
RET
;;;;;;;;;;;;;;;;;;;;;;;;;;;;;;;;;;;;;;;;;;;;;;;;;;;;;;;;;;;;;;;;;;;;;;;;;;;;;;;; ;;;;;;;;;;;;;;;;;;;;;;;;;;;;;;;;;;;;;;;;;;;;;;;;;;;;;;;;;;;;;;;;;;;;;;;;;;;;;;;;

;;;;;;;;;;;;;;;;;;;;;;;;;;;;;;;;;;;;;;;;;;;;;;;;;;;;;;;;;;;;;;;;;;;;;;;;;;;;;;;; ;;;;;;;;;;;;;;;;;;;;;;;;;;;;;;;;;;;;;;;;;;;;;;;;;;;;;;;;;;;;;;;;;;;;;;;;;;;;;;;; DISPLAY ENABLE RIGHT SECTOR: ;;;;;;;;;;;;;;;;;;;;;;;;;;;;;;;;;;;;;;;;;;;;;;;;;;;;;;;;;;;;;;;;;;;;;;;;;;;;;;;; ;;;;;;;;;;;;;;;;;;;;;;;;;;;;;;;;;;;;;;;;;;;;;;;;;;;;;;;;;;;;;;;;;;;;;;;;;;;;;;;; ;; Rutina para seleccionar al sector derecho del display. ;;;;;;;;;;;;;;;;;;;;;;;;;;;;;;;;;;;;;;;;;;;;;;;;;;;;;;;;;;;;;;;;;;;;;;;;;;;;;;;; START SENSIBLE OP
CLR | DISPLAY SELECT RIGHT SECTOR
SETB | DISPLAY SELECT LEFT SECTOR
NOP
END SENSIBLE OP
RET
;;;;;;;;;;;;;;;;;;;;;;;;;;;;;;;;;;;;;;;;;;;;;;;;;;;;;;;;;;;;;;;;;;;;;;;;;;;;;;;; ;;;;;;;;;;;;;;;;;;;;;;;;;;;;;;;;;;;;;;;;;;;;;;;;;;;;;;;;;;;;;;;;;;;;;;;;;;;;;;;;

;;;;;;;;;;;;;;;;;;;;;;;;;;;;;;;;;;;;;;;;;;;;;;;;;;;;;;;;;;;;;;;;;;;;;;;;;;;;;;;; ;;;;;;;;;;;;;;;;;;;;;;;;;;;;;;;;;;;;;;;;;;;;;;;;;;;;;;;;;;;;;;;;;;;;;;;;;;;;;;;; DISPLAY INIT:
;;;;;;;;;;;;;;;;;;;;;;;;;;;;;;;;;;;;;;;;;;;;;;;;;;;;;;;;;;;;;;;;;;;;;;;;;;;;;;;; ;;;;;;;;;;;;;;;;;;;;;;;;;;;;;;;;;;;;;;;;;;;;;;;;;;;;;;;;;;;;;;;;;;;;;;;;;;;;;;;; ;; Rutina que inicializa al display y lo limpia. ;;;;;;;;;;;;;;;;;;;;;;;;;;;;;;;;;;;;;;;;;;;;;;;;;;;;;;;;;;;;;;;;;;;;;;;;;;;;;;;; ;;;;;;;;;;;;;;;;;;;;;;;;;;;;;;;;;;;;;;;;;;;;;;;;;;;;;;;;;;;;;;;;;;;;;;;;;;;;;;;; ;;
;; Depende de:
;; −−−−−−−−−−
;; | DISPLAY MACRO SELECT
;; | DISPLAY MACRO SEND INST
;; | DISPLAY ENABLE RIGHT SECTOR
;; | DISPLAY ENABLE LEFT SECTOR
;; | DISPLAY CLEAR
;;
;; Registros alterados:
;; −−−−−−−−−−−−−−−−−−−
;; | A, B, display page
;;;;;;;;;;;;;;;;;;;;;;;;;;;;;;;;;;;;;;;;;;;;;;;;;;;;;;;;;;;;;;;;;;;;;;;;;;;;;;;;

; Primero se ejecuta la macro que garantiza que el display esté disponible: DISPLAY MACRO SELECT

; Se retira al display del estado reset:
SETB | DISPLAY RESET
CALL | DISPLAY OFF
CALL | DISPLAY CLEAR
CALL | DISPLAY ON
RET

DISPLAY ON:
; Se envía la instrucción que prende al display:
MOV | A, #DISPLAY INSTRUCTION ON
SJMP | DISPLAY ON OFF END
; No necesita RET aquí.

DISPLAY OFF:
; Se envía la instrucción que apaga al display:
MOV | A, #DISPLAY INSTRUCTION OFF
Albani - Arbelo Arrocha - Figueroa | 27 | 1.er cuatrimestre 2008

; No necesita RET aquí.

DISPLAY ON OFF END:
; Finalmente, se envía la instrucción a ambos sectores:
CALL | DISPLAY ENABLE LEFT SECTOR
DISPLAY MACRO SEND INSTRUCTION
CALL | DISPLAY ENABLE RIGHT SECTOR
DISPLAY MACRO SEND INSTRUCTION

RET
;;;;;;;;;;;;;;;;;;;;;;;;;;;;;;;;;;;;;;;;;;;;;;;;;;;;;;;;;;;;;;;;;;;;;;;;;;;;;;;; ;;;;;;;;;;;;;;;;;;;;;;;;;;;;;;;;;;;;;;;;;;;;;;;;;;;;;;;;;;;;;;;;;;;;;;;;;;;;;;;;

;;;;;;;;;;;;;;;;;;;;;;;;;;;;;;;;;;;;;;;;;;;;;;;;;;;;;;;;;;;;;;;;;;;;;;;;;;;;;;;; ;;;;;;;;;;;;;;;;;;;;;;;;;;;;;;;;;;;;;;;;;;;;;;;;;;;;;;;;;;;;;;;;;;;;;;;;;;;;;;;; DISPLAY CLEAR:
;;;;;;;;;;;;;;;;;;;;;;;;;;;;;;;;;;;;;;;;;;;;;;;;;;;;;;;;;;;;;;;;;;;;;;;;;;;;;;;; ;;;;;;;;;;;;;;;;;;;;;;;;;;;;;;;;;;;;;;;;;;;;;;;;;;;;;;;;;;;;;;;;;;;;;;;;;;;;;;;; ;; Rutina para limpiar completamente a la pantalla. ;;;;;;;;;;;;;;;;;;;;;;;;;;;;;;;;;;;;;;;;;;;;;;;;;;;;;;;;;;;;;;;;;;;;;;;;;;;;;;;; ;;;;;;;;;;;;;;;;;;;;;;;;;;;;;;;;;;;;;;;;;;;;;;;;;;;;;;;;;;;;;;;;;;;;;;;;;;;;;;;; ;;
;; Depende de:
;; −−−−−−−−−−
;; | DISPLAY MACRO SELECT
;; | DISPLAY MACRO SET PAGE
;; | DISPLAY MACRO SET COLUMN
;; | DISPLAY MACRO SEND DATA
;; | DISPLAY ENABLE RIGHT SECTOR
;; | DISPLAY ENABLE LEFT SECTOR
;;
;;
;; Registros alterados:
;; −−−−−−−−−−−−−−−−−−−
;; | A, B
;; | display page
;;;;;;;;;;;;;;;;;;;;;;;;;;;;;;;;;;;;;;;;;;;;;;;;;;;;;;;;;;;;;;;;;;;;;;;;;;;;;;;;

; Primero se ejecuta la macro que garantiza que el display esté disponible: DISPLAY MACRO SELECT

; Se llama dos veces a la misma rutina privada (DISPLAY CLEAR SECTOR)
; pero cambiando de sector:
CALL | DISPLAY ENABLE LEFT SECTOR
CALL | DISPLAY CLEAR SECTOR
CALL | DISPLAY ENABLE RIGHT SECTOR
CALL | DISPLAY CLEAR SECTOR

RET

DISPLAY CLEAR SECTOR:

; Se utiliza a display page para iterar desde 8 a 1 ; El rango se desplaza para poder usar DJNZ.
MOV | display page, #8d

DISPLAY CLEAR LOOP PAGES:

; Antes de seleccionar la página, ; debe corregirse el valor:
MOV | A, display page
DEC | A
DISPLAY MACRO SET PAGE
Albani - Arbelo Arrocha - Figueroa | 28 | 1.er cuatrimestre 2008

; Siempre se empieza desde la columna 0:
CLR | A
DISPLAY MACRO SET COLUMN

; Se utiliza a B para iterar:
MOV | B, #64d

DISPLAY CLEAR LOOP COLUMNS:
CLR | A | ; Contenido nulo.
DISPLAY MACRO SEND DATA
DJNZ | B, DISPLAY CLEAR LOOP COLUMNS
DJNZ | display page, DISPLAY CLEAR LOOP PAGES

RET
;;;;;;;;;;;;;;;;;;;;;;;;;;;;;;;;;;;;;;;;;;;;;;;;;;;;;;;;;;;;;;;;;;;;;;;;;;;;;;;; ;;;;;;;;;;;;;;;;;;;;;;;;;;;;;;;;;;;;;;;;;;;;;;;;;;;;;;;;;;;;;;;;;;;;;;;;;;;;;;;;

;;;;;;;;;;;;;;;;;;;;;;;;;;;;;;;;;;;;;;;;;;;;;;;;;;;;;;;;;;;;;;;;;;;;;;;;;;;;;;;; ;;;;;;;;;;;;;;;;;;;;;;;;;;;;;;;;;;;;;;;;;;;;;;;;;;;;;;;;;;;;;;;;;;;;;;;;;;;;;;;; DISPLAY SCROLL:
;;;;;;;;;;;;;;;;;;;;;;;;;;;;;;;;;;;;;;;;;;;;;;;;;;;;;;;;;;;;;;;;;;;;;;;;;;;;;;;; ;;;;;;;;;;;;;;;;;;;;;;;;;;;;;;;;;;;;;;;;;;;;;;;;;;;;;;;;;;;;;;;;;;;;;;;;;;;;;;;; ;; Rutina para desplazar el contenido de la pantalla desde abajo hacia arriba. ;;;;;;;;;;;;;;;;;;;;;;;;;;;;;;;;;;;;;;;;;;;;;;;;;;;;;;;;;;;;;;;;;;;;;;;;;;;;;;;; ;;;;;;;;;;;;;;;;;;;;;;;;;;;;;;;;;;;;;;;;;;;;;;;;;;;;;;;;;;;;;;;;;;;;;;;;;;;;;;;; ;;
;; Depende de:
;; −−−−−−−−−−
;; | DISPLAY MACRO SELECT
;; | DISPLAY MACRO SEND INST
;; | DISPLAY ENABLE RIGHT SECTOR
;; | DISPLAY ENABLE LEFT SECTOR
;;
;;
;; Registros alterados:
;; −−−−−−−−−−−−−−−−−−−
;; | A
;;;;;;;;;;;;;;;;;;;;;;;;;;;;;;;;;;;;;;;;;;;;;;;;;;;;;;;;;;;;;;;;;;;;;;;;;;;;;;;;

; Primero se ejecuta la macro que garantiza que el display esté disponible: DISPLAY MACRO SELECT

; Se utiliza al acumulador para iterar tomando como base al código
; de la instrucción que especifica la línea de RAM del display
; mostrará al comienzo:
MOV | A, #DISPLAY INSTRUCTION START LINE 0

DISPLAY SCROLL LOOP:

; Se envía la instrucción a ambos sectores:
CALL | DISPLAY ENABLE LEFT SECTOR
DISPLAY MACRO SEND INSTRUCTION
CALL | DISPLAY ENABLE RIGHT SECTOR
DISPLAY MACRO SEND INSTRUCTION

; Delay para poder apreciar el efecto:
CALL | DELAY TEN MSEC
CALL | DELAY TEN MSEC
CALL | DELAY TEN MSEC

; Se incrementa y compara con la última instrucción que se debe enviar:
INC | A
JB | Acc.6, DISPLAY SCROLL LOOP
; (cuando el sexto bit se apaga, es porque ya se recorrieron
Albani - Arbelo Arrocha - Figueroa | 29 | 1.er cuatrimestre 2008

; los 64 valores posibles)

; Antes de terminar, se asegura de dejar a la línea 0 como comienzo:
MOV | A, #DISPLAY INSTRUCTION START LINE 0
CALL | DISPLAY ENABLE LEFT SECTOR
DISPLAY MACRO SEND INSTRUCTION
CALL | DISPLAY ENABLE RIGHT SECTOR
DISPLAY MACRO SEND INSTRUCTION
RET
;;;;;;;;;;;;;;;;;;;;;;;;;;;;;;;;;;;;;;;;;;;;;;;;;;;;;;;;;;;;;;;;;;;;;;;;;;;;;;;; ;;;;;;;;;;;;;;;;;;;;;;;;;;;;;;;;;;;;;;;;;;;;;;;;;;;;;;;;;;;;;;;;;;;;;;;;;;;;;;;;

;;;;;;;;;;;;;;;;;;;;;;;;;;;;;;;;;;;;;;;;;;;;;;;;;;;;;;;;;;;;;;;;;;;;;;;;;;;;;;;; ;;;;;;;;;;;;;;;;;;;;;;;;;;;;;;;;;;;;;;;;;;;;;;;;;;;;;;;;;;;;;;;;;;;;;;;;;;;;;;;; DISPLAY PUT BYTE:
;;;;;;;;;;;;;;;;;;;;;;;;;;;;;;;;;;;;;;;;;;;;;;;;;;;;;;;;;;;;;;;;;;;;;;;;;;;;;;;; ;;;;;;;;;;;;;;;;;;;;;;;;;;;;;;;;;;;;;;;;;;;;;;;;;;;;;;;;;;;;;;;;;;;;;;;;;;;;;;;; ;; Rutina para mostrar un byte a una posición específica del display. ;;;;;;;;;;;;;;;;;;;;;;;;;;;;;;;;;;;;;;;;;;;;;;;;;;;;;;;;;;;;;;;;;;;;;;;;;;;;;;;; ;;;;;;;;;;;;;;;;;;;;;;;;;;;;;;;;;;;;;;;;;;;;;;;;;;;;;;;;;;;;;;;;;;;;;;;;;;;;;;;; ;;
;; Depende de:
;; −−−−−−−−−−
;; | DISPLAY MACRO SELECT
;; | DISPLAY MACRO SET PAGE
;; | DISPLAY MACRO SET COLUMN
;; | DISPLAY MACRO SEND DATA
;; | DISPLAY ENABLE RIGHT SECTOR
;; | DISPLAY ENABLE LEFT SECTOR
;;
;; Requisitos:
;; −−−−−−−−−−
;; | El byte a mostrar en display data.
;; | display column entre 0 y 127.
;; | display page entre 0 y 7.
;;
;; Registros alterados:
;; −−−−−−−−−−−−−−−−−−−
;; | A, C
;; | display column <− display column + 1
;;;;;;;;;;;;;;;;;;;;;;;;;;;;;;;;;;;;;;;;;;;;;;;;;;;;;;;;;;;;;;;;;;;;;;;;;;;;;;;;

; Primero se ejecuta la macro que garantiza que el display esté disponible: DISPLAY MACRO SELECT

; Se analiza a qué sector del display hay que mostrar al byte:
MOV | A, display column
; Se utiliza a CJNE sólo para leer luego el Carry (C = A < 64).
; Con ($+3) se saltan los 3 bytes que ocupa "CJNE A, #data, rel"
; logrando así alcanzar siempre a la instrucción que sigue debajo.
CJNE | A, #64d, ($+3)
JC | DISPLAY PUT BYTE LEFT

; Si C = 0, corresponde entonces volcar al sector derecho.

; Se resta la columna del medio para obtener finalmente
; la columna en donde se mostrará:
SUBB | A, #64d
CALL | DISPLAY ENABLE RIGHT SECTOR
SJMP | DISPLAY PUT BYTE FINAL

; Si C = 1, corresponde entonces volcar al sector izquierdo: DISPLAY PUT BYTE LEFT:
CALL | DISPLAY ENABLE LEFT SECTOR
Albani - Arbelo Arrocha - Figueroa | 30 | 1.er cuatrimestre 2008

DISPLAY PUT BYTE FINAL:

; Se llega aquí con la columna en A. DISPLAY MACRO SET COLUMN

MOV | A, display page
DISPLAY MACRO SET PAGE
MOV | A, display data
DISPLAY MACRO SEND DATA

; Se incrementa para imitar al comportamiento del Display:
INC | display column

RET
;;;;;;;;;;;;;;;;;;;;;;;;;;;;;;;;;;;;;;;;;;;;;;;;;;;;;;;;;;;;;;;;;;;;;;;;;;;;;;;; ;;;;;;;;;;;;;;;;;;;;;;;;;;;;;;;;;;;;;;;;;;;;;;;;;;;;;;;;;;;;;;;;;;;;;;;;;;;;;;;;

;;;;;;;;;;;;;;;;;;;;;;;;;;;;;;;;;;;;;;;;;;;;;;;;;;;;;;;;;;;;;;;;;;;;;;;;;;;;;;;; ;;;;;;;;;;;;;;;;;;;;;;;;;;;;;;;;;;;;;;;;;;;;;;;;;;;;;;;;;;;;;;;;;;;;;;;;;;;;;;;; DISPLAY PUT CHAR:
;;;;;;;;;;;;;;;;;;;;;;;;;;;;;;;;;;;;;;;;;;;;;;;;;;;;;;;;;;;;;;;;;;;;;;;;;;;;;;;; ;;;;;;;;;;;;;;;;;;;;;;;;;;;;;;;;;;;;;;;;;;;;;;;;;;;;;;;;;;;;;;;;;;;;;;;;;;;;;;;; ;; Rutina para mostrar un caracter en pantalla a partir de su codificación
;; en memoria de código (ver tabla−ascii.asm para más información).
;; Se imita a un display de 20x8 caracteres de 8x6 bits.
;; Se deja un margen de cuatro bits en cada lateral para simplificar
;; los algoritmos.
;;;;;;;;;;;;;;;;;;;;;;;;;;;;;;;;;;;;;;;;;;;;;;;;;;;;;;;;;;;;;;;;;;;;;;;;;;;;;;;; ;;;;;;;;;;;;;;;;;;;;;;;;;;;;;;;;;;;;;;;;;;;;;;;;;;;;;;;;;;;;;;;;;;;;;;;;;;;;;;;; ;;
;; Depende de:
;; −−−−−−−−−−
;; | DISPLAY MACRO SELECT
;; | DISPLAY MACRO SET PAGE
;; | DISPLAY MACRO SET COLUMN
;; | DISPLAY MACRO SEND DATA
;; | DISPLAY ENABLE RIGHT SECTOR
;; | DISPLAY ENABLE LEFT SECTOR
;;
;; Requisitos:
;; −−−−−−−−−−
;; | La dirección del primer byte del caracter en DPTR.
;; | display column entre 0 y 19
;; | display page entre 0 y 7
;;
;; Registros alterados:
;; −−−−−−−−−−−−−−−−−−−
;; | A, B, C, DPTR
;;;;;;;;;;;;;;;;;;;;;;;;;;;;;;;;;;;;;;;;;;;;;;;;;;;;;;;;;;;;;;;;;;;;;;;;;;;;;;;;

; Primero se ejecuta la macro que garantiza que el display esté disponible: DISPLAY MACRO SELECT

; Se utiliza a B para multiplicar por el ancho de cada caracter:
MOV | B, #6d

; Se analiza a qué sector del display hay que volcar el caracter:
MOV | A, display column
; Se utiliza a CJNE sólo para leer luego el Carry (C = A < 10).
; Con ($+3) se saltan los 3 bytes que ocupa "CJNE A, #data, rel"
; logrando así alcanzar siempre a la instrucción que sigue debajo.
CJNE | A, #10d, ($+3)
JC | DISPLAY PUT CHAR LEFT
Albani - Arbelo Arrocha - Figueroa | 31 | 1.er cuatrimestre 2008

; Si C = 0, corresponde entonces volcar al sector derecho.

; Se resta la columna del medio y se multiplica por el ancho ; de cada caracter para obtener finalmente la columna en donde ; comenzará el volcado:
SUBB | A, #10d
MUL | AB
CALL | DISPLAY ENABLE RIGHT SECTOR
SJMP | DISPLAY PUT CHAR DUMP

; Si C = 1, corresponde entonces volcar al sector izquierdo: DISPLAY PUT CHAR LEFT:
; Se multiplica por el ancho y luego se suma un offset fijo:
MUL | AB
ADD | A, #4d
CALL | DISPLAY ENABLE LEFT SECTOR

DISPLAY PUT CHAR DUMP:

; En A se encuentra la columna en donde comienza el volcado. DISPLAY MACRO SET COLUMN

; La página ha sido especificada desde afuera de la rutina.
MOV | A, display page
DISPLAY MACRO SET PAGE

; Se reutiliza a B para iterar los bytes del caracter:
MOV | B, #5d

DISPLAY PUT CHAR SEND DATA LOOP:

; Se obtienen uno a uno los bytes del caracter:
CLR | A
MOVC | A, @A+DPTR

; Se envían a la pantalla: DISPLAY MACRO SEND DATA

INC | DPTR
DJNZ | B, DISPLAY PUT CHAR SEND DATA LOOP

; Luego de volcar todos los bytes del caracter, se agrega un byte ; que oficia de espacio:
CLR | A
DISPLAY MACRO SEND DATA

RET
;;;;;;;;;;;;;;;;;;;;;;;;;;;;;;;;;;;;;;;;;;;;;;;;;;;;;;;;;;;;;;;;;;;;;;;;;;;;;;;; ;;;;;;;;;;;;;;;;;;;;;;;;;;;;;;;;;;;;;;;;;;;;;;;;;;;;;;;;;;;;;;;;;;;;;;;;;;;;;;;;

;;;;;;;;;;;;;;;;;;;;;;;;;;;;;;;;;;;;;;;;;;;;;;;;;;;;;;;;;;;;;;;;;;;;;;;;;;;;;;;; ;;;;;;;;;;;;;;;;;;;;;;;;;;;;;;;;;;;;;;;;;;;;;;;;;;;;;;;;;;;;;;;;;;;;;;;;;;;;;;;; DISPLAY PUT ASCII:
;;;;;;;;;;;;;;;;;;;;;;;;;;;;;;;;;;;;;;;;;;;;;;;;;;;;;;;;;;;;;;;;;;;;;;;;;;;;;;;; ;;;;;;;;;;;;;;;;;;;;;;;;;;;;;;;;;;;;;;;;;;;;;;;;;;;;;;;;;;;;;;;;;;;;;;;;;;;;;;;; ;; Rutina para mostrar un caracter en pantalla a partir de su código ASCII. ;;;;;;;;;;;;;;;;;;;;;;;;;;;;;;;;;;;;;;;;;;;;;;;;;;;;;;;;;;;;;;;;;;;;;;;;;;;;;;;; ;;;;;;;;;;;;;;;;;;;;;;;;;;;;;;;;;;;;;;;;;;;;;;;;;;;;;;;;;;;;;;;;;;;;;;;;;;;;;;;; ;;
;; Depende de:
;; −−−−−−−−−−
;; | DISPLAY PUT CHAR
;;
Albani - Arbelo Arrocha - Figueroa | 32 | 1.er cuatrimestre 2008

;; Requisitos:
;; −−−−−−−−−−
;; | El código ASCII en display data. Rango: (ver en tabla−ascii.asm
;; | los implementados).
;; | display column entre 0 y 19
;; | display page entre 0 y 7
;;
;; Registros alterados:
;; −−−−−−−−−−−−−−−−−−−
;; | A, B, C, DPTR
;;;;;;;;;;;;;;;;;;;;;;;;;;;;;;;;;;;;;;;;;;;;;;;;;;;;;;;;;;;;;;;;;;;;;;;;;;;;;;;;
MOV | A, display data

; Dirección del primer caracter implementado:
MOV | DPTR, #TABLA ASCII BASE

; Se debe restar TABLA ASCII START pues la primera parte del standard ASCII ; no tiene representación gráfica. En consecuencia, la iteración que
; reposiciona a DPTR debe hacerse menos veces.
CLR | C
SUBB | A, #TABLA ASCII START
; Si la resta da cero, no es necesario reposicionar al DPTR:
JZ | DISPLAY PUT ASCII NO OFFSET
DISPLAY PUT ASCII DPTR OFFSET:
INC | DPTR
INC | DPTR
INC | DPTR
INC | DPTR
INC | DPTR
DJNZ | Acc, DISPLAY PUT ASCII DPTR OFFSET

DISPLAY PUT ASCII NO OFFSET:
; Se llama a DISPLAY PUT CHAR una vez que el DPTR ha sido posicionado ; en la dirección del caracter deseado:
CALL | DISPLAY PUT CHAR
DISPLAY PUT ASCII END:
RET
;;;;;;;;;;;;;;;;;;;;;;;;;;;;;;;;;;;;;;;;;;;;;;;;;;;;;;;;;;;;;;;;;;;;;;;;;;;;;;;; ;;;;;;;;;;;;;;;;;;;;;;;;;;;;;;;;;;;;;;;;;;;;;;;;;;;;;;;;;;;;;;;;;;;;;;;;;;;;;;;;

;;;;;;;;;;;;;;;;;;;;;;;;;;;;;;;;;;;;;;;;;;;;;;;;;;;;;;;;;;;;;;;;;;;;;;;;;;;;;;;; ;;;;;;;;;;;;;;;;;;;;;;;;;;;;;;;;;;;;;;;;;;;;;;;;;;;;;;;;;;;;;;;;;;;;;;;;;;;;;;;; DISPLAY PUT STRING STATIC: ;;;;;;;;;;;;;;;;;;;;;;;;;;;;;;;;;;;;;;;;;;;;;;;;;;;;;;;;;;;;;;;;;;;;;;;;;;;;;;;; ;;;;;;;;;;;;;;;;;;;;;;;;;;;;;;;;;;;;;;;;;;;;;;;;;;;;;;;;;;;;;;;;;;;;;;;;;;;;;;;; ;; Rutina para mostrar una cadena ASCII ubicada en memoria de código. ;;;;;;;;;;;;;;;;;;;;;;;;;;;;;;;;;;;;;;;;;;;;;;;;;;;;;;;;;;;;;;;;;;;;;;;;;;;;;;;; ;;;;;;;;;;;;;;;;;;;;;;;;;;;;;;;;;;;;;;;;;;;;;;;;;;;;;;;;;;;;;;;;;;;;;;;;;;;;;;;; ;;
;; Depende de:
;; −−−−−−−−−−
;; | DISPLAY PUT ASCII
;;
;; Requisitos:
;; −−−−−−−−−−
;; | La ubicación del primer caracter en DPTR.
;; | display column
;; | display page
;;
;; Registros alterados:
;; −−−−−−−−−−−−−−−−−−−
;; | display column <− última columna utilizada.
;; | display data
;; | A
Albani - Arbelo Arrocha - Figueroa | 33 | 1.er cuatrimestre 2008

;; | DPTR <− dirección del fin de línea.
;;;;;;;;;;;;;;;;;;;;;;;;;;;;;;;;;;;;;;;;;;;;;;;;;;;;;;;;;;;;;;;;;;;;;;;;;;;;;;;;
CLR | A
MOVC | A, @A+DPTR | ; A <− Código ASCII del caracter.

; Si el código es 0, se está simbolizando un fin de línea, ; por lo que no hay que hacer nada:
JZ | DISPLAY PUT STRING STATIC END

; Se resguarda la dirección de la cadena.
; porque DISPLAY PUT ASCII sobrescribe a DPTR:
PUSH | DPL
PUSH | DPH
MOV | display data, A
CALL | DISPLAY PUT ASCII
INC | display column

; Se recupera la dirección de la cadena:
POP | DPH
POP | DPL

; Se llama a sí misma pero con el DPTR incrementado.
INC | DPTR
JMP | DISPLAY PUT STRING STATIC

DISPLAY PUT STRING STATIC END:
RET
;;;;;;;;;;;;;;;;;;;;;;;;;;;;;;;;;;;;;;;;;;;;;;;;;;;;;;;;;;;;;;;;;;;;;;;;;;;;;;;; ;;;;;;;;;;;;;;;;;;;;;;;;;;;;;;;;;;;;;;;;;;;;;;;;;;;;;;;;;;;;;;;;;;;;;;;;;;;;;;;;

;;;;;;;;;;;;;;;;;;;;;;;;;;;;;;;;;;;;;;;;;;;;;;;;;;;;;;;;;;;;;;;;;;;;;;;;;;;;;;;; ;;;;;;;;;;;;;;;;;;;;;;;;;;;;;;;;;;;;;;;;;;;;;;;;;;;;;;;;;;;;;;;;;;;;;;;;;;;;;;;; DISPLAY PUT STRING DYNAMIC: ;;;;;;;;;;;;;;;;;;;;;;;;;;;;;;;;;;;;;;;;;;;;;;;;;;;;;;;;;;;;;;;;;;;;;;;;;;;;;;;; ;;;;;;;;;;;;;;;;;;;;;;;;;;;;;;;;;;;;;;;;;;;;;;;;;;;;;;;;;;;;;;;;;;;;;;;;;;;;;;;; ;; Rutina para mostrar una cadena ASCII ubicada en memoria de datos interna. ;;;;;;;;;;;;;;;;;;;;;;;;;;;;;;;;;;;;;;;;;;;;;;;;;;;;;;;;;;;;;;;;;;;;;;;;;;;;;;;; ;;;;;;;;;;;;;;;;;;;;;;;;;;;;;;;;;;;;;;;;;;;;;;;;;;;;;;;;;;;;;;;;;;;;;;;;;;;;;;;; ;;
;; Depende de:
;; −−−−−−−−−−
;; | DISPLAY PUT ASCII
;;
;; Requisitos:
;; −−−−−−−−−−
;; | La ubicación del primer caracter en R0.
;;
;; Registros alterados:
;; −−−−−−−−−−−−−−−−−−−
;; | display column <− última columna utilizada.
;; | display data
;; | A
;; | R0 <− dirección del fin de línea.
;; | DPTR
;;;;;;;;;;;;;;;;;;;;;;;;;;;;;;;;;;;;;;;;;;;;;;;;;;;;;;;;;;;;;;;;;;;;;;;;;;;;;;;;
MOV | A, @R0 | ; A <− Código ASCII del caracter.

; Si el código es 0, se está simbolizando un fin de línea,
; por lo que no hay que hacer nada:
JZ | DISPLAY PUT STRING DYNAMIC END
MOV | display data, A
CALL | DISPLAY PUT ASCII
INC | display column
Albani - Arbelo Arrocha - Figueroa | 34 | 1.er cuatrimestre 2008

; Se llama a sí misma pero con R0 incrementado.
INC | R0
JMP | DISPLAY PUT STRING DYNAMIC

DISPLAY PUT STRING DYNAMIC END:
RET
;;;;;;;;;;;;;;;;;;;;;;;;;;;;;;;;;;;;;;;;;;;;;;;;;;;;;;;;;;;;;;;;;;;;;;;;;;;;;;;; ;;;;;;;;;;;;;;;;;;;;;;;;;;;;;;;;;;;;;;;;;;;;;;;;;;;;;;;;;;;;;;;;;;;;;;;;;;;;;;;;

;;;;;;;;;;;;;;;;;;;;;;;;;;;;;;;;;;;;;;;;;;;;;;;;;;;;;;;;;;;;;;;;;;;;;;;;;;;;;;;; ;;;;;;;;;;;;;;;;;;;;;;;;;;;;;;;;;;;;;;;;;;;;;;;;;;;;;;;;;;;;;;;;;;;;;;;;;;;;;;;; DISPLAY PUT SCREEN FROM CODE: ;;;;;;;;;;;;;;;;;;;;;;;;;;;;;;;;;;;;;;;;;;;;;;;;;;;;;;;;;;;;;;;;;;;;;;;;;;;;;;;; ;;;;;;;;;;;;;;;;;;;;;;;;;;;;;;;;;;;;;;;;;;;;;;;;;;;;;;;;;;;;;;;;;;;;;;;;;;;;;;;; ;; Rutina para volcar una pantalla entera desde memoria de código.
;; Se empieza volcando al sector izquierdo los primeros 512 bytes
;; desde la página 0 hasta la 7 y desde la columna 0 hasta la 63. ;;;;;;;;;;;;;;;;;;;;;;;;;;;;;;;;;;;;;;;;;;;;;;;;;;;;;;;;;;;;;;;;;;;;;;;;;;;;;;;; ;;;;;;;;;;;;;;;;;;;;;;;;;;;;;;;;;;;;;;;;;;;;;;;;;;;;;;;;;;;;;;;;;;;;;;;;;;;;;;;; ;;
;; Depende de:
;; −−−−−−−−−−
;; | DISPLAY OFF
;; | DISPLAY ON
;; | DISPLAY PUT BYTE
;;
;; Requisitos:
;; −−−−−−−−−−
;; | En DPTR la dirección del primero de los 1024 bytes.
;;
;; Registros alterados:
;; −−−−−−−−−−−−−−−−−−−
;; | DPTR <− dirección del último byte.
;; | A, B, display column, display page
;;;;;;;;;;;;;;;;;;;;;;;;;;;;;;;;;;;;;;;;;;;;;;;;;;;;;;;;;;;;;;;;;;;;;;;;;;;;;;;;
CALL | DISPLAY OFF

; Debido a que hay que volcar 512 bytes a cada sector por separado, ; se utiliza a B para indicarle a la subrutina interna en cuál de ; los dos sectores debe iterar:
MOV | B, #64d
CALL | DISPLAY PUT SCREEN FROM CODE SECTOR
MOV | B, #128d
CALL | DISPLAY PUT SCREEN FROM CODE SECTOR
CALL | DISPLAY ON
RET

DISPLAY PUT SCREEN FROM CODE SECTOR:
MOV | display page, #0d
DISPLAY PUT SCREEN FROM CODE LOOP PAGES:
; Si B = 64, entonces display column = 0. ; Si B = 128, entonces display column = 64.
MOV | A, B
CLR | C
SUBB | A, #64d
MOV | display column, A
DISPLAY PUT SCREEN FROM CODE LOOP COLUMNS:
CLR | A
MOVC | A, @A + DPTR
MOV | display data, A
CALL | DISPLAY PUT BYTE
INC | DPTR
Albani - Arbelo Arrocha - Figueroa | 35 | 1.er cuatrimestre 2008

MOV | A, display column
CJNE | A, B, DISPLAY PUT SCREEN FROM CODE LOOP COLUMNS
INC | display page
MOV | A, display page
CJNE | A, #8d, DISPLAY PUT SCREEN FROM CODE LOOP PAGES

RET
;;;;;;;;;;;;;;;;;;;;;;;;;;;;;;;;;;;;;;;;;;;;;;;;;;;;;;;;;;;;;;;;;;;;;;;;;;;;;;;; ;;;;;;;;;;;;;;;;;;;;;;;;;;;;;;;;;;;;;;;;;;;;;;;;;;;;;;;;;;;;;;;;;;;;;;;;;;;;;;;;

;;;;;;;;;;;;;;;;;;;;;;;;;;;;;;;;;;;;;;;;;;;;;;;;;;;;;;;;;;;;;;;;;;;;;;;;;;;;;;;; ;;;;;;;;;;;;;;;;;;;;;;;;;;;;;;;;;;;;;;;;;;;;;;;;;;;;;;;;;;;;;;;;;;;;;;;;;;;;;;;; TABLA ASCII BASE:
$INCLUDE(tabla−ascii.asm)
;;;;;;;;;;;;;;;;;;;;;;;;;;;;;;;;;;;;;;;;;;;;;;;;;;;;;;;;;;;;;;;;;;;;;;;;;;;;;;;; ;;;;;;;;;;;;;;;;;;;;;;;;;;;;;;;;;;;;;;;;;;;;;;;;;;;;;;;;;;;;;;;;;;;;;;;;;;;;;;;;
Albani - Arbelo Arrocha - Figueroa | 36 | 1.er cuatrimestre 2008

# 6.3. tabla-ascii.asm

;;;;;;;;;;;;;;;;;;;;;;;;;;;;;;;;;;;;;;;;;;;;;;;;;;;;;;;;;;;;;;;;;;;;;;;;;;;;;;;; ;; Símbolos de la tabla ASCII.
;; Cada uno ocupa 5 bytes.
;; Para simplificar los algoritmos, es necesario que no haya "huecos".
;;
;; Formato:
;; −−−−−−−−−−−
;; | | | Byte
;; −−−−−−−−−−−
;; Bit | 12345
;; −−−−−−−−−−−
;; | 0 | 11111
;; | 1 | 10000
;; | 2 | 10000
;; | 3 | 11110
;; | 4 | 10000
;; | 5 | 10000
;; | 6 | 10000
;; | 7 | 00000 −−> la última fila se usa como espacio vertical.
;; −−−−−−−−−−−
;;
;; 1: 01111111
;; 2: 00001001
;; 3: 00001001
;; 4: 00001001
;; 5: 00000001

;;;;;;;;;;;;;;;;;;;;;;;;;;;;;;;;;;;;;;;;;;;;;;;;;;;;;;;;;;;;;;;;;;;;;;;;;;;;;;;; ;; DEFINICIONES:
;;;;;;;;;;;;;;;;;;;;;;;;;;;;;;;;;;;;;;;;;;;;;;;;;;;;;;;;;;;;;;;;;;;;;;;;;;;;;;;;

;; Mediante este valor, se indica el código del primer caracter implementado. ;; Permite que las rutinas sepan cuanto deben desplazar a DPTR para alcanzar
;; el caracter deseado.
TABLA ASCII START EQU 32d

CSEG
CHR 032: | DB | 00000000b, 00000000b, 00000000b, 00000000b, 00000000b | ; Space
CHR 033: | DB | 00000000b, 00000000b, 10111111b, 00000000b, 00000000b | ; !
CHR 034: | DB | 00000000b, 00000111b, 00000000b, 00000111b, 00000000b | ; "
CHR 035: | DB | 00100100b, 01111110b, 00100100b, 01111110b, 00100100b | ; #
CHR 036: | DB | 00100110b, 01001001b, 01111111b, 01001001b, 00110010b | ; $
CHR 037: | DB | 01001100b, 00101100b, 00010000b, 01101000b, 01100100b | ; %
CHR 038: | DB | 00110000b, 01001110b, 01001001b, 01001010b, 00110000b | ; &
CHR 039: | DB | 00000000b, 00000000b, 00000111b, 00000000b, 00000000b | ; '
CHR 040: | DB | 00000000b, 00000000b, 00011100b, 00100010b, 01000001b | ; (
CHR 041: | DB | 01000001b, 00100010b, 00011100b, 00000000b, 00000000b | ; )
CHR 042: | DB | 00101010b, 00011100b, 00111110b, 00011100b, 00101010b | ; *
CHR 043: | DB | 00001000b, 00001000b, 00111110b, 00001000b, 00001000b | ; +
CHR 044: | DB | 10000000b, 01110000b, 00000000b, 00000000b, 00000000b | ; ,
CHR 045: | DB | 00001000b, 00001000b, 00001000b, 00001000b, 00001000b | ; −
CHR 046: | DB | 01100000b, 01100000b, 00000000b, 00000000b, 00000000b | ; .
CHR 047: | DB | 01100000b, 00110000b, 00011000b, 00001100b, 00000110b | ; /
CHR 048: | DB | 00000000b, 00111110b, 01001001b, 01000101b, 00111110b | ; 0
CHR 049: | DB | 00000000b, 01000010b, 01111111b, 01000000b, 00000000b | ; 1
CHR 050: | DB | 00000000b, 01100010b, 01010001b, 01001001b, 01000110b | ; 2
CHR 051: | DB | 00000000b, 00100010b, 01001001b, 01001001b, 00110110b | ; 3
CHR 052: | DB | 00000000b, 00001111b, 00001000b, 00001000b, 01111111b | ; 4
CHR 053: | DB | 00000000b, 00100111b, 01000101b, 01000101b, 00111001b | ; 5
CHR 054: | DB | 00000000b, 00111110b, 01001001b, 01001001b, 00110010b | ; 6
CHR 055: | DB | 00000001b, 00000001b, 01111001b, 00000101b, 00000011b | ; 7
CHR 056: | DB | 00000000b, 00110110b, 01001001b, 01001001b, 00110110b | ; 8
CHR 057: | DB | 00000000b, 00100110b, 01001001b, 01001001b, 00111110b | ; 9
Albani - Arbelo Arrocha - Figueroa | 37 | 1.er cuatrimestre 2008

CHR 058: | DB | 01101100b, 01101100b, 00000000b, 00000000b, 00000000b | ; :
CHR 059: | DB | 10001100b, 01101100b, 00000000b, 00000000b, 00000000b | ; ;
CHR 060: | DB | 00001000b, 00010100b, 00100010b, 01000001b, 00000000b | ; <
CHR 061: | DB | 00010100b, 00010100b, 00010100b, 00010100b, 00010100b | ; =
CHR 062: | DB | 00000000b, 01000001b, 00100010b, 00010100b, 00001000b | ; >
CHR 063: | DB | 00000110b, 01010001b, 00001001b, 00000110b, 00000000b | ; ?
CHR 064: | DB | 00111110b, 01000001b, 01011101b, 01010101b, 00101110b | ; @
CHR 065: | DB | 01111110b, 00001001b, 00001001b, 00001001b, 01111110b | ; A
CHR 066: | DB | 01111111b, 01001001b, 01001001b, 01001001b, 00110110b | ; B
CHR 067: | DB | 00111110b, 01000001b, 01000001b, 01000001b, 00100010b | ; C
CHR 068: | DB | 01111111b, 01000001b, 01000001b, 01000001b, 00111110b | ; D
CHR 069: | DB | 01111111b, 01001001b, 01001001b, 01001001b, 01000001b | ; E
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
DB | 00111110b
DB | 00001000b
DB | 00001000b

CHR CAPACITOR:

Albani - Arbelo Arrocha - Figueroa | 42 | 1.er cuatrimestre 2008

DB | 00001000b
DB | 01111111b
DB | 00000000b
DB | 01111111b
DB | 00001000b
Albani - Arbelo Arrocha - Figueroa | 43 | 1.er cuatrimestre 2008

# 6.4. keypad.asm

;;;;;;;;;;;;;;;;;;;;;;;;;;;;;;;;;;;;;;;;;;;;;;;;;;;;;;;;;;;;;;;;;;;;;;;;;;;;;;;; ;;;;;;;;;;;;;;;;;;;;;;;;;;;;;;;;;;;;;;;;;;;;;;;;;;;;;;;;;;;;;;;;;;;;;;;;;;;;;;;; ;; Rutinas de control del teclado matricial 4x4. ;;;;;;;;;;;;;;;;;;;;;;;;;;;;;;;;;;;;;;;;;;;;;;;;;;;;;;;;;;;;;;;;;;;;;;;;;;;;;;;; ;;;;;;;;;;;;;;;;;;;;;;;;;;;;;;;;;;;;;;;;;;;;;;;;;;;;;;;;;;;;;;;;;;;;;;;;;;;;;;;; ;;
;; Observaciones:
;; −−−−−−−−−−−−−
;;
;; Se utilizó un buffer 74HC244N como interfaz al microcontrolador, ;; conectado de la siguiente manera:
;;
;; | −−−−−−−−−−−−−−−−
;; | | | 74HC244N | |
;; | | | |
;; P2.0 −−| 2A0 −−|>−− 2Y0 |−− Fila 1 ;; P2.1 −−| 2A1 −−|>−− 2Y1 |−− Fila 2 ;; P2.2 −−| 2A2 −−|>−− 2Y2 |−− Fila 3 ;; P2.3 −−| 2A3 −−|>−− 2Y3 |−− Fila 4 ;; P2.4 −−| 1Y3 −−<|−− 1A3 |−− Columna 4 ;; P2.5 −−| 1Y2 −−<|−− 1A2 |−− Columna 3 ;; P2.6 −−| 1Y1 −−<|−− 1A1 |−− Columna 2 ;; P2.7 −−| 1Y0 −−<|−− 1A0 |−− Columna 1
;; | | | |
;; | −−−−−−−−−−−−−−−−
;;
;; Cuando un botón es presionado, la fila y la columna a la que ;; pertenece se pone en cero.
;;
;; Esquemático:
;; −−−−−−−−−−−
;; | |−−−−−−−−−−−−−|−−−−−−−−−−−−−|
;; | | Col1 | Col2 | Col3 | Col4 |
;; | −−−−−−−|−−−−−−−−−−−−−|−−−−−−−
;; | | P2.7 | P2.6 | P2.5 | P2.4 |
;; | |−−−−−−−−−−−−−−|−−−−−−−−−−−−−|−−−−−−−−−−−−−|
;; | | Fil1 | P2.0 | | | ESC | | 9 | | | 8 | | <− | |
;; | | Fil2 | P2.1 | | | F1 | | 4 | | | 3 | | −> | |
;; | | Fil3 | P2.2 | | | DEL | | 5 | | | 2 | | | 1 | |
;; | | Fil4 | P2.3 | | ENTER | | 0 | | | 7 | | | 6 | |
;; | −−−−−−−|−−−−−−−−−−−−−−|−−−−−−−−−−−−−|−−−−−−−
;;
;; Disposición de los botones:
;; −−−−−−−−−−−−−−−−−−−−−−−−−−
;;
;; | −−−−−−−−−−−−−−−−−−−−−−−−−−−−−−−−−−−
;; | | | −−−−−−−−−−−−−−−−−−−−−− | |
;; | ||<−| | | | | Esc | |
;; | | | | | | | |
;; | ||−>| | | | | | F1 | |
;; | | | −−−−−−−−−−−−−−−−−−−−−− | |
;; | | | 1 | | | 2 | | | 3 | | | 4 | | | 5 | | | Del | |
;; | | | 6 | | | 7 | | | 8 | | | 9 | | | 0 | | | Enter | |
;; | −−−−−−−−−−−−−−−−−−−−−−−−−−−−−−−−−−−
;;
;;
;;
;; Requisitos de esta biblioteca:
;; −−−−−−−−−−−−−−−−−−−−−−−−−−−−−
;; | Existencia de una macro definida bajo el nombre
;; | KEYPAD MACRO SELECT que garantice la
;; | disponibilidad del teclado.
;;
Albani - Arbelo Arrocha - Figueroa | 44 | 1.er cuatrimestre 2008

;;;;;;;;;;;;;;;;;;;;;;;;;;;;;;;;;;;;;;;;;;;;;;;;;;;;;;;;;;;;;;;;;;;;;;;;;;;;;;;; ;;;;;;;;;;;;;;;;;;;;;;;;;;;;;;;;;;;;;;;;;;;;;;;;;;;;;;;;;;;;;;;;;;;;;;;;;;;;;;;;

;;;;;;;;;;;;;;;;;;;;;;;;;;;;;;;;;;;;;;;;;;;;;;;;;;;;;;;;;;;;;;;;;;;;;;;;;;;;;;;; ;;;;;;;;;;;;;;;;;;;;;;;;;;;;;;;;;;;;;;;;;;;;;;;;;;;;;;;;;;;;;;;;;;;;;;;;;;;;;;;; ;; Definiciones:
;;;;;;;;;;;;;;;;;;;;;;;;;;;;;;;;;;;;;;;;;;;;;;;;;;;;;;;;;;;;;;;;;;;;;;;;;;;;;;;; ;; Para no depender de las conexiones entre las columnas−filas y el buffer,
;; se definen las siguientes equivalencias para asignar el peso de cada columna ;; en función del bit del puerto: ;;;;;;;;;;;;;;;;;;;;;;;;;;;;;;;;;;;;;;;;;;;;;;;;;;;;;;;;;;;;;;;;;;;;;;;;;;;;;;;;
KEYPAD F1 | EQU | 1d | ; Bit 0
KEYPAD F2 | EQU | 2d | ; Bit 1
KEYPAD F3 | EQU | 4d | ; Bit 2
KEYPAD F4 | EQU | 8d | ; Bit 3
KEYPAD C1 | EQU | 128d | ; Bit 7
KEYPAD C2 | EQU | 64d | ; Bit 6
KEYPAD C3 | EQU | 32d | ; Bit 5
KEYPAD C4 | EQU | 16d | ; Bit 4

; Códigos que representan a las teclas no numéricas:
KEYPAD RIGHT | EQU | 10d
KEYPAD LEFT | EQU | 11d
KEYPAD ENTER | EQU | 12d
KEYPAD HELP | EQU | 13d
KEYPAD DEL | EQU | 14d
KEYPAD ESC | EQU | 15d
KEYPAD NONE | EQU | 16d
; Las teclas numéricas llevan su número como código.
KEYPAD DATABUS | EQU | P2

; Aquí se indica la mitad de la cantidad de CM's deseados para debouncing.
KEYPAD DEBOUNCE DEEPNESS | EQU | 255d
;;;;;;;;;;;;;;;;;;;;;;;;;;;;;;;;;;;;;;;;;;;;;;;;;;;;;;;;;;;;;;;;;;;;;;;;;;;;;;;; ;;;;;;;;;;;;;;;;;;;;;;;;;;;;;;;;;;;;;;;;;;;;;;;;;;;;;;;;;;;;;;;;;;;;;;;;;;;;;;;;

;;;;;;;;;;;;;;;;;;;;;;;;;;;;;;;;;;;;;;;;;;;;;;;;;;;;;;;;;;;;;;;;;;;;;;;;;;;;;;;; ;;;;;;;;;;;;;;;;;;;;;;;;;;;;;;;;;;;;;;;;;;;;;;;;;;;;;;;;;;;;;;;;;;;;;;;;;;;;;;;; ;; Macros:
;;;;;;;;;;;;;;;;;;;;;;;;;;;;;;;;;;;;;;;;;;;;;;;;;;;;;;;;;;;;;;;;;;;;;;;;;;;;;;;; ;;;;;;;;;;;;;;;;;;;;;;;;;;;;;;;;;;;;;;;;;;;;;;;;;;;;;;;;;;;;;;;;;;;;;;;;;;;;;;;;

;;;;;;;;;;;;;;;;;;;;;;;;;;;;;;;;;;;;;;;;;;;;;;;;;;;;;;;;;;;;;;;;;;;;;;;;;;;;;;;; ;; Simplifica la captura de la ejecución a la espera de una tecla en particular. ;;;;;;;;;;;;;;;;;;;;;;;;;;;;;;;;;;;;;;;;;;;;;;;;;;;;;;;;;;;;;;;;;;;;;;;;;;;;;;;;
KEYPAD MACRO WAIT KEY | MACRO | codigo
MOV | A, #codigo
CALL | KEYPAD SCAN WAIT KEY
ENDM
;;;;;;;;;;;;;;;;;;;;;;;;;;;;;;;;;;;;;;;;;;;;;;;;;;;;;;;;;;;;;;;;;;;;;;;;;;;;;;;; ;;;;;;;;;;;;;;;;;;;;;;;;;;;;;;;;;;;;;;;;;;;;;;;;;;;;;;;;;;;;;;;;;;;;;;;;;;;;;;;;

DSEG

;;;;;;;;;;;;;;;;;;;;;;;;;;;;;;;;;;;;;;;;;;;;;;;;;;;;;;;;;;;;;;;;;;;;;;;;;;;;;;;; ;;;;;;;;;;;;;;;;;;;;;;;;;;;;;;;;;;;;;;;;;;;;;;;;;;;;;;;;;;;;;;;;;;;;;;;;;;;;;;;; ; Posición de memoria para comunicarle al exterior
; el código de la tecla presionada:
keypad pressed key: | DS | 1
;;;;;;;;;;;;;;;;;;;;;;;;;;;;;;;;;;;;;;;;;;;;;;;;;;;;;;;;;;;;;;;;;;;;;;;;;;;;;;;; ;;;;;;;;;;;;;;;;;;;;;;;;;;;;;;;;;;;;;;;;;;;;;;;;;;;;;;;;;;;;;;;;;;;;;;;;;;;;;;;;
Albani - Arbelo Arrocha - Figueroa | 45 | 1.er cuatrimestre 2008

CSEG

;;;;;;;;;;;;;;;;;;;;;;;;;;;;;;;;;;;;;;;;;;;;;;;;;;;;;;;;;;;;;;;;;;;;;;;;;;;;;;;; ;;;;;;;;;;;;;;;;;;;;;;;;;;;;;;;;;;;;;;;;;;;;;;;;;;;;;;;;;;;;;;;;;;;;;;;;;;;;;;;; KEYPAD DEBOUNCE WAIT:
;;;;;;;;;;;;;;;;;;;;;;;;;;;;;;;;;;;;;;;;;;;;;;;;;;;;;;;;;;;;;;;;;;;;;;;;;;;;;;;; ;;;;;;;;;;;;;;;;;;;;;;;;;;;;;;;;;;;;;;;;;;;;;;;;;;;;;;;;;;;;;;;;;;;;;;;;;;;;;;;; ;; Rutina que realiza un delay por software para debouncing.
;; Está pensada para ser utilizada sólo por KEYPAD SCAN. ;;;;;;;;;;;;;;;;;;;;;;;;;;;;;;;;;;;;;;;;;;;;;;;;;;;;;;;;;;;;;;;;;;;;;;;;;;;;;;;; ;;;;;;;;;;;;;;;;;;;;;;;;;;;;;;;;;;;;;;;;;;;;;;;;;;;;;;;;;;;;;;;;;;;;;;;;;;;;;;;; ;;
;; Registros afectados:
;; −−−−−−−−−−−−−−−−−−−
;; | A
;;
;;;;;;;;;;;;;;;;;;;;;;;;;;;;;;;;;;;;;;;;;;;;;;;;;;;;;;;;;;;;;;;;;;;;;;;;;;;;;;;; ;;;;;;;;;;;;;;;;;;;;;;;;;;;;;;;;;;;;;;;;;;;;;;;;;;;;;;;;;;;;;;;;;;;;;;;;;;;;;;;;
MOV | A, #KEYPAD DEBOUNCE DEEPNESS
DJNZ | Acc, $ | ; Esta operación lleva 2 ciclos de máquina.
RET
;;;;;;;;;;;;;;;;;;;;;;;;;;;;;;;;;;;;;;;;;;;;;;;;;;;;;;;;;;;;;;;;;;;;;;;;;;;;;;;; ;;;;;;;;;;;;;;;;;;;;;;;;;;;;;;;;;;;;;;;;;;;;;;;;;;;;;;;;;;;;;;;;;;;;;;;;;;;;;;;;

;;;;;;;;;;;;;;;;;;;;;;;;;;;;;;;;;;;;;;;;;;;;;;;;;;;;;;;;;;;;;;;;;;;;;;;;;;;;;;;; ;;;;;;;;;;;;;;;;;;;;;;;;;;;;;;;;;;;;;;;;;;;;;;;;;;;;;;;;;;;;;;;;;;;;;;;;;;;;;;;; KEYPAD SCAN:
;;;;;;;;;;;;;;;;;;;;;;;;;;;;;;;;;;;;;;;;;;;;;;;;;;;;;;;;;;;;;;;;;;;;;;;;;;;;;;;; ;;;;;;;;;;;;;;;;;;;;;;;;;;;;;;;;;;;;;;;;;;;;;;;;;;;;;;;;;;;;;;;;;;;;;;;;;;;;;;;; ;; Rutina que realiza un escaneo en KEYPAD DATABUS
;; y devuelve en keypad pressed key el código de la tecla apretada.
;; Si ninguna está apretada, devuelve KEYPAD NONE. ;;;;;;;;;;;;;;;;;;;;;;;;;;;;;;;;;;;;;;;;;;;;;;;;;;;;;;;;;;;;;;;;;;;;;;;;;;;;;;;; ;;;;;;;;;;;;;;;;;;;;;;;;;;;;;;;;;;;;;;;;;;;;;;;;;;;;;;;;;;;;;;;;;;;;;;;;;;;;;;;; ;;
;; Depende de:
;; −−−−−−−−−−
;; | KEYPAD DEBOUNCE WAIT
;; | KEYPAD SCAN CORE
;;
;; Registros afectados:
;; −−−−−−−−−−−−−−−−−−−
;; | A, DPTR, keypad pressed key
;;
;;;;;;;;;;;;;;;;;;;;;;;;;;;;;;;;;;;;;;;;;;;;;;;;;;;;;;;;;;;;;;;;;;;;;;;;;;;;;;;; ;;;;;;;;;;;;;;;;;;;;;;;;;;;;;;;;;;;;;;;;;;;;;;;;;;;;;;;;;;;;;;;;;;;;;;;;;;;;;;;;

; Primero se ejecuta la macro que garantiza la disponibilidad del teclado: KEYPAD MACRO SELECT

; Se obtiene una primera lectura:
CALL | KEYPAD SCAN CORE

; Etapa de debouncing:

; Se guarda una copia de la primera lectura:
PUSH | keypad pressed key
; Se espera un tiempo prudente:
CALL | KEYPAD DEBOUNCE WAIT
; Se realiza una segunda lectura:
CALL | KEYPAD SCAN CORE
; Se recupera la copia en el acumulador:
Albani - Arbelo Arrocha - Figueroa | 46 | 1.er cuatrimestre 2008

POP | Acc
; Se las compara y si son iguales, se considera un éxito:
CJNE | A, keypad pressed key, KEYPAD SCAN FAIL

; Fin de la etapa de debouncing.

; Para evitar múltiples lecturas idénticas, se atrapa la ejecución ; hasta que se verifique que la tecla ha sido soltada:
PUSH | keypad pressed key | ; Se guarda una copia.
KEYPAD SCAN TRAP:
; Se realiza una lectura y se sigue iterando hasta
; que equivalga a ninguna tecla:
CALL | KEYPAD SCAN CORE
MOV | A, keypad pressed key
CJNE | A, #KEYPAD NONE, KEYPAD SCAN TRAP
POP | keypad pressed key
RET

KEYPAD SCAN FAIL:
; En caso de que la etapa de debouncing decida que fue una falsa alarma, ; se informa que no se ha detectado tecla alguna:
MOV | keypad pressed key, #KEYPAD NONE
RET
;;;;;;;;;;;;;;;;;;;;;;;;;;;;;;;;;;;;;;;;;;;;;;;;;;;;;;;;;;;;;;;;;;;;;;;;;;;;;;;; ;;;;;;;;;;;;;;;;;;;;;;;;;;;;;;;;;;;;;;;;;;;;;;;;;;;;;;;;;;;;;;;;;;;;;;;;;;;;;;;;

;;;;;;;;;;;;;;;;;;;;;;;;;;;;;;;;;;;;;;;;;;;;;;;;;;;;;;;;;;;;;;;;;;;;;;;;;;;;;;;; ;;;;;;;;;;;;;;;;;;;;;;;;;;;;;;;;;;;;;;;;;;;;;;;;;;;;;;;;;;;;;;;;;;;;;;;;;;;;;;;; KEYPAD SCAN CORE:
;;;;;;;;;;;;;;;;;;;;;;;;;;;;;;;;;;;;;;;;;;;;;;;;;;;;;;;;;;;;;;;;;;;;;;;;;;;;;;;; ;;;;;;;;;;;;;;;;;;;;;;;;;;;;;;;;;;;;;;;;;;;;;;;;;;;;;;;;;;;;;;;;;;;;;;;;;;;;;;;; ;; Corazón de la lectura de teclas.
;; Está pensada para ser llamada sólo por KEYPAD SCAN.
;; Itera a través de la tabla de las máscaras que representan a cada tecla de ;; tal manera que cuando alguna coincide con la lectura de KEYPAD DATABUS,
;; finaliza con el código de la tecla guardado en keypad pressed key. ;;;;;;;;;;;;;;;;;;;;;;;;;;;;;;;;;;;;;;;;;;;;;;;;;;;;;;;;;;;;;;;;;;;;;;;;;;;;;;;; ;;;;;;;;;;;;;;;;;;;;;;;;;;;;;;;;;;;;;;;;;;;;;;;;;;;;;;;;;;;;;;;;;;;;;;;;;;;;;;;; ;;
;; Registros afectados:
;; −−−−−−−−−−−−−−−−−−−
;; | A, C, DPTR, keypad pressed key
;;
;;;;;;;;;;;;;;;;;;;;;;;;;;;;;;;;;;;;;;;;;;;;;;;;;;;;;;;;;;;;;;;;;;;;;;;;;;;;;;;; ;;;;;;;;;;;;;;;;;;;;;;;;;;;;;;;;;;;;;;;;;;;;;;;;;;;;;;;;;;;;;;;;;;;;;;;;;;;;;;;; ; Se comienza probando con la primera máscara:
MOV | DPTR, #KEYPAD MASK 0

; Se inicializa a keypad pressed key en 255 para que luego del bucle ; quede con el valor correcto gracias a los sucesivos incrementos:
MOV | keypad pressed key, #255d
KEYPAD SCAN LOOP:

; Se chequea para ver si se alcanzó el final de la tabla de máscaras.
MOV | A, keypad pressed key
CLR | C
SUBB | A, #16d
; Si ya se recorrió toda la tabla sin éxito debe abandonar el bucle.
JZ | KEYPAD SCAN CORE END

; Se lee la máscara:
CLR | A
MOVC | A, @A+DPTR

; Se envía la máscara:

Albani - Arbelo Arrocha - Figueroa | 47 | 1.er cuatrimestre 2008

MOV | KEYPAD DATABUS, A

; Se le da tiempo al buffer para que actualice el valor: NOP

; Se apunta a la siguiente máscara:
INC | DPTR

; Se incrementa keypad pressed key para que cuando se detecte
; finalmente la tecla apretada, quede con el valor de su código:
INC | keypad pressed key

; Si no coincide, entonces itera nuevamente para probar con la próxima:
CJNE | A, KEYPAD DATABUS, KEYPAD SCAN LOOP
KEYPAD SCAN CORE END:
RET
;;;;;;;;;;;;;;;;;;;;;;;;;;;;;;;;;;;;;;;;;;;;;;;;;;;;;;;;;;;;;;;;;;;;;;;;;;;;;;;; ;;;;;;;;;;;;;;;;;;;;;;;;;;;;;;;;;;;;;;;;;;;;;;;;;;;;;;;;;;;;;;;;;;;;;;;;;;;;;;;;

;;;;;;;;;;;;;;;;;;;;;;;;;;;;;;;;;;;;;;;;;;;;;;;;;;;;;;;;;;;;;;;;;;;;;;;;;;;;;;;; ;;;;;;;;;;;;;;;;;;;;;;;;;;;;;;;;;;;;;;;;;;;;;;;;;;;;;;;;;;;;;;;;;;;;;;;;;;;;;;;; KEYPAD SCAN WAIT:
;;;;;;;;;;;;;;;;;;;;;;;;;;;;;;;;;;;;;;;;;;;;;;;;;;;;;;;;;;;;;;;;;;;;;;;;;;;;;;;; ;;;;;;;;;;;;;;;;;;;;;;;;;;;;;;;;;;;;;;;;;;;;;;;;;;;;;;;;;;;;;;;;;;;;;;;;;;;;;;;; ;; Frena la ejecución hasta que se presione alguna tecla. ;;;;;;;;;;;;;;;;;;;;;;;;;;;;;;;;;;;;;;;;;;;;;;;;;;;;;;;;;;;;;;;;;;;;;;;;;;;;;;;; ;;;;;;;;;;;;;;;;;;;;;;;;;;;;;;;;;;;;;;;;;;;;;;;;;;;;;;;;;;;;;;;;;;;;;;;;;;;;;;;; ;;
;; Depende de:
;; −−−−−−−−−−
;; | KEYPAD SCAN
;;
;; Registros afectados:
;; −−−−−−−−−−−−−−−−−−−
;; | A, DPTR, keypad pressed key
;;
;;;;;;;;;;;;;;;;;;;;;;;;;;;;;;;;;;;;;;;;;;;;;;;;;;;;;;;;;;;;;;;;;;;;;;;;;;;;;;;; ;;;;;;;;;;;;;;;;;;;;;;;;;;;;;;;;;;;;;;;;;;;;;;;;;;;;;;;;;;;;;;;;;;;;;;;;;;;;;;;;
CALL | KEYPAD SCAN
MOV | A, keypad pressed key
CJNE | A, #KEYPAD NONE, ($+3)
JNC | KEYPAD SCAN WAIT
RET
;;;;;;;;;;;;;;;;;;;;;;;;;;;;;;;;;;;;;;;;;;;;;;;;;;;;;;;;;;;;;;;;;;;;;;;;;;;;;;;; ;;;;;;;;;;;;;;;;;;;;;;;;;;;;;;;;;;;;;;;;;;;;;;;;;;;;;;;;;;;;;;;;;;;;;;;;;;;;;;;;

;;;;;;;;;;;;;;;;;;;;;;;;;;;;;;;;;;;;;;;;;;;;;;;;;;;;;;;;;;;;;;;;;;;;;;;;;;;;;;;; ;;;;;;;;;;;;;;;;;;;;;;;;;;;;;;;;;;;;;;;;;;;;;;;;;;;;;;;;;;;;;;;;;;;;;;;;;;;;;;;; KEYPAD SCAN JMP:
;;;;;;;;;;;;;;;;;;;;;;;;;;;;;;;;;;;;;;;;;;;;;;;;;;;;;;;;;;;;;;;;;;;;;;;;;;;;;;;; ;;;;;;;;;;;;;;;;;;;;;;;;;;;;;;;;;;;;;;;;;;;;;;;;;;;;;;;;;;;;;;;;;;;;;;;;;;;;;;;; ;; Rutina temeraria pensada para poder iterar un bucle arbitrario
;; hasta que se presione alguna tecla. ;;;;;;;;;;;;;;;;;;;;;;;;;;;;;;;;;;;;;;;;;;;;;;;;;;;;;;;;;;;;;;;;;;;;;;;;;;;;;;;; ;;;;;;;;;;;;;;;;;;;;;;;;;;;;;;;;;;;;;;;;;;;;;;;;;;;;;;;;;;;;;;;;;;;;;;;;;;;;;;;; ;;
;; Depende de:
;; −−−−−−−−−−
;; | KEYPAD SCAN
;;
;; Requisitos:
;; −−−−−−−−−−
;; | La dirección de inicio del bucle en DPTR.
;;
Albani - Arbelo Arrocha - Figueroa | 48 | 1.er cuatrimestre 2008

;; Registros afectados:
;; −−−−−−−−−−−−−−−−−−−
;; | A, DPTR, keypad pressed key
;;
;;;;;;;;;;;;;;;;;;;;;;;;;;;;;;;;;;;;;;;;;;;;;;;;;;;;;;;;;;;;;;;;;;;;;;;;;;;;;;;; ;;;;;;;;;;;;;;;;;;;;;;;;;;;;;;;;;;;;;;;;;;;;;;;;;;;;;;;;;;;;;;;;;;;;;;;;;;;;;;;;

; Antes de llamar a KEYPAD SCAN, se guarda al DPTR pues contiene
; la dirección en memoria del inicio del bucle:
PUSH | DPL
PUSH | DPH

; Se fija si hay alguna tecla presionada:
CALL | KEYPAD SCAN

; Recupera a DPTR:
POP | DPH
POP | DPL
MOV | A, keypad pressed key

; Si hay alguna tecla apretada, se finaliza:
CJNE | A, #KEYPAD NONE, KEYPAD SCAN JMP RET

; Si no hay ninguna tecla apretada, se debe saltar a la dirección del ; bucle, pero como esta rutina ha sido llamada con CALL, es necesario ; antes retirar del stack a los dos bytes de la dirección de retorno, ; pues no se va a volver con RET:
POP | Acc
POP | Acc
; Finalmente, se realiza el salto a la dirección del bucle:
CLR | A
JMP | @A + DPTR

KEYPAD SCAN JMP RET:
; Si había una tecla apretada, se retorna normalmente:
RET
;;;;;;;;;;;;;;;;;;;;;;;;;;;;;;;;;;;;;;;;;;;;;;;;;;;;;;;;;;;;;;;;;;;;;;;;;;;;;;;; ;;;;;;;;;;;;;;;;;;;;;;;;;;;;;;;;;;;;;;;;;;;;;;;;;;;;;;;;;;;;;;;;;;;;;;;;;;;;;;;;

;;;;;;;;;;;;;;;;;;;;;;;;;;;;;;;;;;;;;;;;;;;;;;;;;;;;;;;;;;;;;;;;;;;;;;;;;;;;;;;; ;;;;;;;;;;;;;;;;;;;;;;;;;;;;;;;;;;;;;;;;;;;;;;;;;;;;;;;;;;;;;;;;;;;;;;;;;;;;;;;; KEYPAD SCAN WAIT KEY:
;;;;;;;;;;;;;;;;;;;;;;;;;;;;;;;;;;;;;;;;;;;;;;;;;;;;;;;;;;;;;;;;;;;;;;;;;;;;;;;; ;;;;;;;;;;;;;;;;;;;;;;;;;;;;;;;;;;;;;;;;;;;;;;;;;;;;;;;;;;;;;;;;;;;;;;;;;;;;;;;; ;; Frena la ejecución hasta que se presione una tecla específica. ;;;;;;;;;;;;;;;;;;;;;;;;;;;;;;;;;;;;;;;;;;;;;;;;;;;;;;;;;;;;;;;;;;;;;;;;;;;;;;;; ;;;;;;;;;;;;;;;;;;;;;;;;;;;;;;;;;;;;;;;;;;;;;;;;;;;;;;;;;;;;;;;;;;;;;;;;;;;;;;;; ;;
;; Requisitos:
;; −−−−−−−−−−
;; | El código de la tecla deseada en el acumulador.
;;
;; Depende de:
;; −−−−−−−−−−
;; | KEYPAD SCAN
;;
;; Registros afectados:
;; −−−−−−−−−−−−−−−−−−−
;; | A, DPTR, keypad pressed key
;;
;;;;;;;;;;;;;;;;;;;;;;;;;;;;;;;;;;;;;;;;;;;;;;;;;;;;;;;;;;;;;;;;;;;;;;;;;;;;;;;; ;;;;;;;;;;;;;;;;;;;;;;;;;;;;;;;;;;;;;;;;;;;;;;;;;;;;;;;;;;;;;;;;;;;;;;;;;;;;;;;;
MOV | B, A
CALL | KEYPAD SCAN
Albani - Arbelo Arrocha - Figueroa | 49 | 1.er cuatrimestre 2008

MOV | A, keypad pressed key
CJNE | A, B, ($+5)
SJMP | KEYPAD SCAN WAIT KEY END
MOV | A, B
SJMP | KEYPAD SCAN WAIT KEY
KEYPAD SCAN WAIT KEY END:
RET
;;;;;;;;;;;;;;;;;;;;;;;;;;;;;;;;;;;;;;;;;;;;;;;;;;;;;;;;;;;;;;;;;;;;;;;;;;;;;;;; ;;;;;;;;;;;;;;;;;;;;;;;;;;;;;;;;;;;;;;;;;;;;;;;;;;;;;;;;;;;;;;;;;;;;;;;;;;;;;;;;

;;;;;;;;;;;;;;;;;;;;;;;;;;;;;;;;;;;;;;;;;;;;;;;;;;;;;;;;;;;;;;;;;;;;;;;;;;;;;;;; ;;;;;;;;;;;;;;;;;;;;;;;;;;;;;;;;;;;;;;;;;;;;;;;;;;;;;;;;;;;;;;;;;;;;;;;;;;;;;;;; ;; Tabla de máscaras de petición y respuesta. ;;;;;;;;;;;;;;;;;;;;;;;;;;;;;;;;;;;;;;;;;;;;;;;;;;;;;;;;;;;;;;;;;;;;;;;;;;;;;;;; ;;;;;;;;;;;;;;;;;;;;;;;;;;;;;;;;;;;;;;;;;;;;;;;;;;;;;;;;;;;;;;;;;;;;;;;;;;;;;;;; ;;
;; Formato:
;; −−−−−−−
;; | 4 bits de petición / 4 bits de respuesta
;; | C1 C2 C3 C4 | / F4 F3 F2 F1
;;
;; Ejemplo:
;; −−−−−−−
;; | 11101011 para detectar la tecla ubicada en Fila 3 y Columna 4.
;;
;; Para no depender la significación de cada elemento de la matriz,
;; se define en función de las asignaciones de los terminales. ;;;;;;;;;;;;;;;;;;;;;;;;;;;;;;;;;;;;;;;;;;;;;;;;;;;;;;;;;;;;;;;;;;;;;;;;;;;;;;;; ;;;;;;;;;;;;;;;;;;;;;;;;;;;;;;;;;;;;;;;;;;;;;;;;;;;;;;;;;;;;;;;;;;;;;;;;;;;;;;;;
KEYPAD MASK 0: | DB | LOW (255d − KEYPAD F4 − KEYPAD C2)
KEYPAD MASK 1: | DB | LOW (255d − KEYPAD F3 − KEYPAD C4)
KEYPAD MASK 2: | DB | LOW (255d − KEYPAD F3 − KEYPAD C3)
KEYPAD MASK 3: | DB | LOW (255d − KEYPAD F2 − KEYPAD C3)
KEYPAD MASK 4: | DB | LOW (255d − KEYPAD F2 − KEYPAD C2)
KEYPAD MASK 5: | DB | LOW (255d − KEYPAD F3 − KEYPAD C2)
KEYPAD MASK 6: | DB | LOW (255d − KEYPAD F4 − KEYPAD C4)
KEYPAD MASK 7: | DB | LOW (255d − KEYPAD F4 − KEYPAD C3)
KEYPAD MASK 8: | DB | LOW (255d − KEYPAD F1 − KEYPAD C3)
KEYPAD MASK 9: | DB | LOW (255d − KEYPAD F1 − KEYPAD C2)
KEYPAD MASK RIGHT: | DB | LOW (255d − KEYPAD F2 − KEYPAD C4)
KEYPAD MASK LEFT: | DB | LOW (255d − KEYPAD F1 − KEYPAD C4)
KEYPAD MASK ENTER: | DB | LOW (255d − KEYPAD F4 − KEYPAD C1)
KEYPAD MASK F1: | DB | LOW (255d − KEYPAD F2 − KEYPAD C1)
KEYPAD MASK DEL: | DB | LOW (255d − KEYPAD F3 − KEYPAD C1)
KEYPAD MASK ESC: | DB | LOW (255d − KEYPAD F1 − KEYPAD C1)
;;;;;;;;;;;;;;;;;;;;;;;;;;;;;;;;;;;;;;;;;;;;;;;;;;;;;;;;;;;;;;;;;;;;;;;;;;;;;;;; ;;;;;;;;;;;;;;;;;;;;;;;;;;;;;;;;;;;;;;;;;;;;;;;;;;;;;;;;;;;;;;;;;;;;;;;;;;;;;;;; ;; Por ejemplo: la tecla que representa al CERO, está en Fila 4 y Columna 2.
;;
;; La resta entre 255 y dos valores, equivale a la negación de la suma
;; entre los valores.
;;
;;;;;;;;;;;;;;;;;;;;;;;;;;;;;;;;;;;;;;;;;;;;;;;;;;;;;;;;;;;;;;;;;;;;;;;;;;;;;;;; ;;;;;;;;;;;;;;;;;;;;;;;;;;;;;;;;;;;;;;;;;;;;;;;;;;;;;;;;;;;;;;;;;;;;;;;;;;;;;;;;
Albani - Arbelo Arrocha - Figueroa | 50 | 1.er cuatrimestre 2008

# 6.5. rom.asm

;;;;;;;;;;;;;;;;;;;;;;;;;;;;;;;;;;;;;;;;;;;;;;;;;;;;;;;;;;;;;;;;;;;;;;;;;;;;;;;; ;;;;;;;;;;;;;;;;;;;;;;;;;;;;;;;;;;;;;;;;;;;;;;;;;;;;;;;;;;;;;;;;;;;;;;;;;;;;;;;; ;; Rutinas de control del dispositivo: Serial EEPROM − AT24C256 Atmel.
;; 256 kbits de memoria organizados en 512 páginas de 64 bytes cada una. ;;;;;;;;;;;;;;;;;;;;;;;;;;;;;;;;;;;;;;;;;;;;;;;;;;;;;;;;;;;;;;;;;;;;;;;;;;;;;;;; ;;;;;;;;;;;;;;;;;;;;;;;;;;;;;;;;;;;;;;;;;;;;;;;;;;;;;;;;;;;;;;;;;;;;;;;;;;;;;;;; ;;
;; Rutinas públicas:
;; −−−−−−−−−−−−−−−−−
;; | ROM WRITE PAGE FROM CODE
;; | ROM READ PAGE TO BUFFER
;; | ROM INC ADDRESS 64
;; | ROM ERASE PAGE
;; | ROM ERASE
;; | ROM READ TO BANK
;; | ROM WRITE FROM BANK
;;
;; Requisitos de esta biblioteca:
;; −−−−−−−−−−−−−−−−−−−−−−−−−−−−−
;; | Existencia de una macro llamada
;; | ROM MACRO SELECT que garantice la
;; | disponibilidad del display.
;;
;; | Existencia de dos macros llamadas
;; | START SENSIBLE OP y END SENSIBLE OP
;; | para indicarle al exterior el comienzo y fin
;; | de operaciones de I/O sensibles.
;;
;;;;;;;;;;;;;;;;;;;;;;;;;;;;;;;;;;;;;;;;;;;;;;;;;;;;;;;;;;;;;;;;;;;;;;;;;;;;;;;; ;;;;;;;;;;;;;;;;;;;;;;;;;;;;;;;;;;;;;;;;;;;;;;;;;;;;;;;;;;;;;;;;;;;;;;;;;;;;;;;;

;;;;;;;;;;;;;;;;;;;;;;;;;;;;;;;;;;;;;;;;;;;;;;;;;;;;;;;;;;;;;;;;;;;;;;;;;;;;;;;; ;;;;;;;;;;;;;;;;;;;;;;;;;;;;;;;;;;;;;;;;;;;;;;;;;;;;;;;;;;;;;;;;;;;;;;;;;;;;;;;; ;; Definiciones:
;;;;;;;;;;;;;;;;;;;;;;;;;;;;;;;;;;;;;;;;;;;;;;;;;;;;;;;;;;;;;;;;;;;;;;;;;;;;;;;; ;;;;;;;;;;;;;;;;;;;;;;;;;;;;;;;;;;;;;;;;;;;;;;;;;;;;;;;;;;;;;;;;;;;;;;;;;;;;;;;;
ROM CLK | EQU | P2.0 | ; Señal de Clock para la ROM.
ROM SDA | EQU | P2.1 | ; Datos a ROM (Full Duplex).
ROM ADDRESS MASK | EQU | 0A0H | ; Device address para EEPROMs AT24Cxx.
;;;;;;;;;;;;;;;;;;;;;;;;;;;;;;;;;;;;;;;;;;;;;;;;;;;;;;;;;;;;;;;;;;;;;;;;;;;;;;;; ;;;;;;;;;;;;;;;;;;;;;;;;;;;;;;;;;;;;;;;;;;;;;;;;;;;;;;;;;;;;;;;;;;;;;;;;;;;;;;;;

DSEG

;;;;;;;;;;;;;;;;;;;;;;;;;;;;;;;;;;;;;;;;;;;;;;;;;;;;;;;;;;;;;;;;;;;;;;;;;;;;;;;; ;;;;;;;;;;;;;;;;;;;;;;;;;;;;;;;;;;;;;;;;;;;;;;;;;;;;;;;;;;;;;;;;;;;;;;;;;;;;;;;;
rom address H: | DS | 1 | ; Posición de memoria ROM (byte alto)
rom address L: | DS | 1 | ; Posición de memoria ROM (byte bajo)

; Buffer para almacenar 64 bytes que van o vienen hacia o desde la ROM:
rom page buffer: | DS | 64
;;;;;;;;;;;;;;;;;;;;;;;;;;;;;;;;;;;;;;;;;;;;;;;;;;;;;;;;;;;;;;;;;;;;;;;;;;;;;;;; ;;;;;;;;;;;;;;;;;;;;;;;;;;;;;;;;;;;;;;;;;;;;;;;;;;;;;;;;;;;;;;;;;;;;;;;;;;;;;;;;

CSEG

;;;;;;;;;;;;;;;;;;;;;;;;;;;;;;;;;;;;;;;;;;;;;;;;;;;;;;;;;;;;;;;;;;;;;;;;;;;;;;;; ;;;;;;;;;;;;;;;;;;;;;;;;;;;;;;;;;;;;;;;;;;;;;;;;;;;;;;;;;;;;;;;;;;;;;;;;;;;;;;;; ROM BEGIN:

Albani - Arbelo Arrocha - Figueroa | 51 | 1.er cuatrimestre 2008

;;;;;;;;;;;;;;;;;;;;;;;;;;;;;;;;;;;;;;;;;;;;;;;;;;;;;;;;;;;;;;;;;;;;;;;;;;;;;;;; ;;;;;;;;;;;;;;;;;;;;;;;;;;;;;;;;;;;;;;;;;;;;;;;;;;;;;;;;;;;;;;;;;;;;;;;;;;;;;;;; ;; Envia la condición de start a la ROM (Flanco descendente en SDA mientras CLK ;; se mantiene alto).
;;;;;;;;;;;;;;;;;;;;;;;;;;;;;;;;;;;;;;;;;;;;;;;;;;;;;;;;;;;;;;;;;;;;;;;;;;;;;;;; ;;;;;;;;;;;;;;;;;;;;;;;;;;;;;;;;;;;;;;;;;;;;;;;;;;;;;;;;;;;;;;;;;;;;;;;;;;;;;;;; ;;
;; Registros afectados:
;; −−−−−−−−−−−−−−−−−−−
;; | C <− flag de error, 0 es OK.
;; | ROM CLK <− 0
;; | ROM SDA <− 0
;;
;;;;;;;;;;;;;;;;;;;;;;;;;;;;;;;;;;;;;;;;;;;;;;;;;;;;;;;;;;;;;;;;;;;;;;;;;;;;;;;; ;;;;;;;;;;;;;;;;;;;;;;;;;;;;;;;;;;;;;;;;;;;;;;;;;;;;;;;;;;;;;;;;;;;;;;;;;;;;;;;;

; Se ejecuta la macro que avisa al exterior sobre el comienzo
; de una operacion de I/O sensible:
START SENSIBLE OP
SETB | ROM SDA
SETB | ROM CLK
; Si SDA o CLK estan en bajo entonces, error de bus.
JNB | ROM SDA, ROM BEGIN ERROR
JNB | ROM CLK, ROM BEGIN ERROR
; Se indica que no hay error.
CLR | C
CLR | ROM SDA
; Tiempo de procesamiento. NOP
NOP
NOP
NOP
NOP
CLR | ROM CLK
RET
ROM BEGIN ERROR:
; Se indica que hay error.
SETB C

; Se ejecuta la macro que avisa al exterior sobre el fin ; de una operacion de I/O sensible:
END SENSIBLE OP

RET
;;;;;;;;;;;;;;;;;;;;;;;;;;;;;;;;;;;;;;;;;;;;;;;;;;;;;;;;;;;;;;;;;;;;;;;;;;;;;;;; ;;;;;;;;;;;;;;;;;;;;;;;;;;;;;;;;;;;;;;;;;;;;;;;;;;;;;;;;;;;;;;;;;;;;;;;;;;;;;;;;

;;;;;;;;;;;;;;;;;;;;;;;;;;;;;;;;;;;;;;;;;;;;;;;;;;;;;;;;;;;;;;;;;;;;;;;;;;;;;;;; ;;;;;;;;;;;;;;;;;;;;;;;;;;;;;;;;;;;;;;;;;;;;;;;;;;;;;;;;;;;;;;;;;;;;;;;;;;;;;;;; ROM END:
;;;;;;;;;;;;;;;;;;;;;;;;;;;;;;;;;;;;;;;;;;;;;;;;;;;;;;;;;;;;;;;;;;;;;;;;;;;;;;;; ;;;;;;;;;;;;;;;;;;;;;;;;;;;;;;;;;;;;;;;;;;;;;;;;;;;;;;;;;;;;;;;;;;;;;;;;;;;;;;;; ;; Envia la condición stop a la ROM (Flanco descendente en SDA mientras CLK se ;; mantiene alto).
;;;;;;;;;;;;;;;;;;;;;;;;;;;;;;;;;;;;;;;;;;;;;;;;;;;;;;;;;;;;;;;;;;;;;;;;;;;;;;;; ;;;;;;;;;;;;;;;;;;;;;;;;;;;;;;;;;;;;;;;;;;;;;;;;;;;;;;;;;;;;;;;;;;;;;;;;;;;;;;;; ;;
;; Registros afectados:
;; −−−−−−−−−−−−−−−−−−−
;; | C <− flag de error, 0 es OK.
;; | ROM CLK <− 1
;; | ROM SDA <− 1
;;
;;;;;;;;;;;;;;;;;;;;;;;;;;;;;;;;;;;;;;;;;;;;;;;;;;;;;;;;;;;;;;;;;;;;;;;;;;;;;;;;
Albani - Arbelo Arrocha - Figueroa | 52 | 1.er cuatrimestre 2008

;;;;;;;;;;;;;;;;;;;;;;;;;;;;;;;;;;;;;;;;;;;;;;;;;;;;;;;;;;;;;;;;;;;;;;;;;;;;;;;;

; Se ejecuta la macro que avisa al exterior sobre el comienzo
; de una operacion de I/O sensible:
START SENSIBLE OP

; SDA en bajo.
CLR | ROM SDA
; Tiempo de procesamiento. NOP
NOP
; CLK en alto.
SETB ROM CLK
; Tiempo de procesamiento. NOP
NOP
NOP
NOP
NOP
; SDA en alto.
SETB ROM SDA

; Se ejecuta la macro que avisa al exterior sobre el fin ; de una operacion de I/O sensible:
END SENSIBLE OP

RET
;;;;;;;;;;;;;;;;;;;;;;;;;;;;;;;;;;;;;;;;;;;;;;;;;;;;;;;;;;;;;;;;;;;;;;;;;;;;;;;; ;;;;;;;;;;;;;;;;;;;;;;;;;;;;;;;;;;;;;;;;;;;;;;;;;;;;;;;;;;;;;;;;;;;;;;;;;;;;;;;;

;;;;;;;;;;;;;;;;;;;;;;;;;;;;;;;;;;;;;;;;;;;;;;;;;;;;;;;;;;;;;;;;;;;;;;;;;;;;;;;; ;;;;;;;;;;;;;;;;;;;;;;;;;;;;;;;;;;;;;;;;;;;;;;;;;;;;;;;;;;;;;;;;;;;;;;;;;;;;;;;; ROM SEND ACK:
;;;;;;;;;;;;;;;;;;;;;;;;;;;;;;;;;;;;;;;;;;;;;;;;;;;;;;;;;;;;;;;;;;;;;;;;;;;;;;;; ;;;;;;;;;;;;;;;;;;;;;;;;;;;;;;;;;;;;;;;;;;;;;;;;;;;;;;;;;;;;;;;;;;;;;;;;;;;;;;;; ;; Acepta los datos recibidos. ;;;;;;;;;;;;;;;;;;;;;;;;;;;;;;;;;;;;;;;;;;;;;;;;;;;;;;;;;;;;;;;;;;;;;;;;;;;;;;;; ;;;;;;;;;;;;;;;;;;;;;;;;;;;;;;;;;;;;;;;;;;;;;;;;;;;;;;;;;;;;;;;;;;;;;;;;;;;;;;;; ;;
;; Requisitos:
;; −−−−−−−−−−
;; | ROM CLK en bajo.
;;
;; Registros afectados:
;; −−−−−−−−−−−−−−−−−−−
;; | ROM CLK <− 0
;; | ROM SDA <− 0
;;
;;;;;;;;;;;;;;;;;;;;;;;;;;;;;;;;;;;;;;;;;;;;;;;;;;;;;;;;;;;;;;;;;;;;;;;;;;;;;;;; ;;;;;;;;;;;;;;;;;;;;;;;;;;;;;;;;;;;;;;;;;;;;;;;;;;;;;;;;;;;;;;;;;;;;;;;;;;;;;;;;

; Se ejecuta la macro que avisa al exterior sobre el comienzo
; de una operacion de I/O sensible:
START SENSIBLE OP

; SDA en bajo −> bit de acknowledge.
CLR | ROM SDA
; Tiempo de procesamiento.
NOP
NOP
; CLK en alto.
SETB ROM CLK
; Tiempo de procesamiento. NOP
NOP
Albani - Arbelo Arrocha - Figueroa | 53 | 1.er cuatrimestre 2008

NOP
NOP
; CLK en bajo.
CLR | ROM CLK

; Se ejecuta la macro que avisa al exterior sobre el fin ; de una operacion de I/O sensible:
END SENSIBLE OP

RET
;;;;;;;;;;;;;;;;;;;;;;;;;;;;;;;;;;;;;;;;;;;;;;;;;;;;;;;;;;;;;;;;;;;;;;;;;;;;;;;; ;;;;;;;;;;;;;;;;;;;;;;;;;;;;;;;;;;;;;;;;;;;;;;;;;;;;;;;;;;;;;;;;;;;;;;;;;;;;;;;;

;;;;;;;;;;;;;;;;;;;;;;;;;;;;;;;;;;;;;;;;;;;;;;;;;;;;;;;;;;;;;;;;;;;;;;;;;;;;;;;; ;;;;;;;;;;;;;;;;;;;;;;;;;;;;;;;;;;;;;;;;;;;;;;;;;;;;;;;;;;;;;;;;;;;;;;;;;;;;;;;; ROM SEND NACK:
;;;;;;;;;;;;;;;;;;;;;;;;;;;;;;;;;;;;;;;;;;;;;;;;;;;;;;;;;;;;;;;;;;;;;;;;;;;;;;;; ;;;;;;;;;;;;;;;;;;;;;;;;;;;;;;;;;;;;;;;;;;;;;;;;;;;;;;;;;;;;;;;;;;;;;;;;;;;;;;;; ;; Rechaza los datos recibidos. ;;;;;;;;;;;;;;;;;;;;;;;;;;;;;;;;;;;;;;;;;;;;;;;;;;;;;;;;;;;;;;;;;;;;;;;;;;;;;;;; ;;;;;;;;;;;;;;;;;;;;;;;;;;;;;;;;;;;;;;;;;;;;;;;;;;;;;;;;;;;;;;;;;;;;;;;;;;;;;;;; ;;
;; Requisitos:
;; −−−−−−−−−−
;; | ROM CLK en bajo.
;;
;; Registros afectados:
;; −−−−−−−−−−−−−−−−−−−
;; | ROM CLK <− 1
;; | ROM SDA <− 1
;;
;;;;;;;;;;;;;;;;;;;;;;;;;;;;;;;;;;;;;;;;;;;;;;;;;;;;;;;;;;;;;;;;;;;;;;;;;;;;;;;; ;;;;;;;;;;;;;;;;;;;;;;;;;;;;;;;;;;;;;;;;;;;;;;;;;;;;;;;;;;;;;;;;;;;;;;;;;;;;;;;;

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

; SDA en alto −> bit de NO acknowledge. SETB ROM SDA
; Tiempo de procesamiento.
NOP
NOP
; CLK en alto.
SETB ROM CLK
; Tiempo de procesamiento. NOP
NOP
NOP
nop
; CLK en bajo.
CLR | ROM CLK

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

RET
;;;;;;;;;;;;;;;;;;;;;;;;;;;;;;;;;;;;;;;;;;;;;;;;;;;;;;;;;;;;;;;;;;;;;;;;;;;;;;;; ;;;;;;;;;;;;;;;;;;;;;;;;;;;;;;;;;;;;;;;;;;;;;;;;;;;;;;;;;;;;;;;;;;;;;;;;;;;;;;;;

;;;;;;;;;;;;;;;;;;;;;;;;;;;;;;;;;;;;;;;;;;;;;;;;;;;;;;;;;;;;;;;;;;;;;;;;;;;;;;;; ;;;;;;;;;;;;;;;;;;;;;;;;;;;;;;;;;;;;;;;;;;;;;;;;;;;;;;;;;;;;;;;;;;;;;;;;;;;;;;;; ROM SHIFT IN BYTE:

Albani - Arbelo Arrocha - Figueroa | 54 | 1.er cuatrimestre 2008

;;;;;;;;;;;;;;;;;;;;;;;;;;;;;;;;;;;;;;;;;;;;;;;;;;;;;;;;;;;;;;;;;;;;;;;;;;;;;;;; ;;;;;;;;;;;;;;;;;;;;;;;;;;;;;;;;;;;;;;;;;;;;;;;;;;;;;;;;;;;;;;;;;;;;;;;;;;;;;;;; ;; Recibe un byte en forma serial (MSB primero) via SDA y lo deja en A. ;;;;;;;;;;;;;;;;;;;;;;;;;;;;;;;;;;;;;;;;;;;;;;;;;;;;;;;;;;;;;;;;;;;;;;;;;;;;;;;; ;;;;;;;;;;;;;;;;;;;;;;;;;;;;;;;;;;;;;;;;;;;;;;;;;;;;;;;;;;;;;;;;;;;;;;;;;;;;;;;; ;;
;; Requisitos:
;; −−−−−−−−−−
;; | ROM CLK en bajo.
;;
;; Registros afectados:
;; −−−−−−−−−−−−−−−−−−−
;; | A <− byte leído.
;; | ROM CLK <− 0
;; | ROM SDA
;;
;;;;;;;;;;;;;;;;;;;;;;;;;;;;;;;;;;;;;;;;;;;;;;;;;;;;;;;;;;;;;;;;;;;;;;;;;;;;;;;; ;;;;;;;;;;;;;;;;;;;;;;;;;;;;;;;;;;;;;;;;;;;;;;;;;;;;;;;;;;;;;;;;;;;;;;;;;;;;;;;;

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

; Se inicializa SDA.
SETB | ROM SDA
; Se resguarda B.
PUSH B
;Se usa B como iterador − 8 bits son los que se envian.
MOV | B, #8d
ROM SHIFT IN BYTE AUX:
; Tiempo de procesamiento.
NOP
NOP
NOP
; CLK en alto.
SETB ROM CLK
; Tiempo de procesamiento.
NOP
NOP
; Se copia SDA en C para formar el bit.
MOV | C, ROM SDA
RLC | A
; CLK en bajo.
CLR | ROM CLK
DJNZ | B, ROM SHIFT IN BYTE AUX

; Se restaura B
POP | B

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

RET
;;;;;;;;;;;;;;;;;;;;;;;;;;;;;;;;;;;;;;;;;;;;;;;;;;;;;;;;;;;;;;;;;;;;;;;;;;;;;;;; ;;;;;;;;;;;;;;;;;;;;;;;;;;;;;;;;;;;;;;;;;;;;;;;;;;;;;;;;;;;;;;;;;;;;;;;;;;;;;;;;

;;;;;;;;;;;;;;;;;;;;;;;;;;;;;;;;;;;;;;;;;;;;;;;;;;;;;;;;;;;;;;;;;;;;;;;;;;;;;;;; ;;;;;;;;;;;;;;;;;;;;;;;;;;;;;;;;;;;;;;;;;;;;;;;;;;;;;;;;;;;;;;;;;;;;;;;;;;;;;;;; ROM SHIFT OUT BYTE:
;;;;;;;;;;;;;;;;;;;;;;;;;;;;;;;;;;;;;;;;;;;;;;;;;;;;;;;;;;;;;;;;;;;;;;;;;;;;;;;; ;;;;;;;;;;;;;;;;;;;;;;;;;;;;;;;;;;;;;;;;;;;;;;;;;;;;;;;;;;;;;;;;;;;;;;;;;;;;;;;; ;; Recibe un byte en A, al que emite en forma serial, con el MSB primero,
;; por SDA.
;;;;;;;;;;;;;;;;;;;;;;;;;;;;;;;;;;;;;;;;;;;;;;;;;;;;;;;;;;;;;;;;;;;;;;;;;;;;;;;;
Albani - Arbelo Arrocha - Figueroa | 55 | 1.er cuatrimestre 2008

;;;;;;;;;;;;;;;;;;;;;;;;;;;;;;;;;;;;;;;;;;;;;;;;;;;;;;;;;;;;;;;;;;;;;;;;;;;;;;;; ;;
;; Requisitos:
;; −−−−−−−−−−
;; | El byte a enviar en el acumulador.
;; | ROM SDA y ROM CLK en estado bajo.
;;
;; Registros afectados:
;; −−−−−−−−−−−−−−−−−−−
;; | ROM CLK <− 0
;; | ROM SDA
;; | C <− flag de error. 0 es OK.
;;
;;;;;;;;;;;;;;;;;;;;;;;;;;;;;;;;;;;;;;;;;;;;;;;;;;;;;;;;;;;;;;;;;;;;;;;;;;;;;;;; ;;;;;;;;;;;;;;;;;;;;;;;;;;;;;;;;;;;;;;;;;;;;;;;;;;;;;;;;;;;;;;;;;;;;;;;;;;;;;;;;

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

; Se resguarda B.
PUSH B
; Se utiliza como iterador −> cantidad de bits.
MOV | B, #8d

ROM SHIFT OUT BYTE AUX:
; Bit mas alto de A al carry.
RLC | A
MOV | ROM SDA, C
SETB | ROM CLK
; Tiempo de procesamiento. NOP
NOP
NOP
NOP
CLR | ROM CLK
DJNZ | B, ROM SHIFT OUT BYTE AUX

; SDA en alto para el acknowledge. SETB ROM SDA
; Tiempo de procesamiento.
NOP
NOP

; CLK en alto.
SETB ROM CLK
; Tiempo de procesamiento. NOP
NOP
NOP
NOP
MOV | C, ROM SDA
; CLK en bajo.
CLR | ROM CLK

; Se restaura B.
POP | B

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

RET
;;;;;;;;;;;;;;;;;;;;;;;;;;;;;;;;;;;;;;;;;;;;;;;;;;;;;;;;;;;;;;;;;;;;;;;;;;;;;;;; ;;;;;;;;;;;;;;;;;;;;;;;;;;;;;;;;;;;;;;;;;;;;;;;;;;;;;;;;;;;;;;;;;;;;;;;;;;;;;;;;
Albani - Arbelo Arrocha - Figueroa | 56 | 1.er cuatrimestre 2008

;;;;;;;;;;;;;;;;;;;;;;;;;;;;;;;;;;;;;;;;;;;;;;;;;;;;;;;;;;;;;;;;;;;;;;;;;;;;;;;; ;;;;;;;;;;;;;;;;;;;;;;;;;;;;;;;;;;;;;;;;;;;;;;;;;;;;;;;;;;;;;;;;;;;;;;;;;;;;;;;; ROM WAIT BUSY:
;;;;;;;;;;;;;;;;;;;;;;;;;;;;;;;;;;;;;;;;;;;;;;;;;;;;;;;;;;;;;;;;;;;;;;;;;;;;;;;; ;;;;;;;;;;;;;;;;;;;;;;;;;;;;;;;;;;;;;;;;;;;;;;;;;;;;;;;;;;;;;;;;;;;;;;;;;;;;;;;; ;; Rutina bloqueante, espera que la ROM responda. Usa a C (carry) como flag de ;; error, 0 es OK.
;;;;;;;;;;;;;;;;;;;;;;;;;;;;;;;;;;;;;;;;;;;;;;;;;;;;;;;;;;;;;;;;;;;;;;;;;;;;;;;; ;;;;;;;;;;;;;;;;;;;;;;;;;;;;;;;;;;;;;;;;;;;;;;;;;;;;;;;;;;;;;;;;;;;;;;;;;;;;;;;; ;;
;; Depende de:
;; −−−−−−−−−−
;; | ROM SHIFT OUT BYTE
;;
;; Registros afectados:
;; −−−−−−−−−−−−−−−−−−−
;; | C −> flag de error. 0 es OK.
;; | A
;;
;;;;;;;;;;;;;;;;;;;;;;;;;;;;;;;;;;;;;;;;;;;;;;;;;;;;;;;;;;;;;;;;;;;;;;;;;;;;;;;; ;;;;;;;;;;;;;;;;;;;;;;;;;;;;;;;;;;;;;;;;;;;;;;;;;;;;;;;;;;;;;;;;;;;;;;;;;;;;;;;;
CALL | ROM BEGIN
JC | ROM WAIT BUSY
MOV | A,#ROM ADDRESS MASK
CLR | ACC.0
CALL | ROM SHIFT OUT BYTE
JC | ROM WAIT BUSY
RET
;;;;;;;;;;;;;;;;;;;;;;;;;;;;;;;;;;;;;;;;;;;;;;;;;;;;;;;;;;;;;;;;;;;;;;;;;;;;;;;; ;;;;;;;;;;;;;;;;;;;;;;;;;;;;;;;;;;;;;;;;;;;;;;;;;;;;;;;;;;;;;;;;;;;;;;;;;;;;;;;;

;;;;;;;;;;;;;;;;;;;;;;;;;;;;;;;;;;;;;;;;;;;;;;;;;;;;;;;;;;;;;;;;;;;;;;;;;;;;;;;; ;;;;;;;;;;;;;;;;;;;;;;;;;;;;;;;;;;;;;;;;;;;;;;;;;;;;;;;;;;;;;;;;;;;;;;;;;;;;;;;; ROM WRITE PAGE FROM CODE:
;;;;;;;;;;;;;;;;;;;;;;;;;;;;;;;;;;;;;;;;;;;;;;;;;;;;;;;;;;;;;;;;;;;;;;;;;;;;;;;; ;;;;;;;;;;;;;;;;;;;;;;;;;;;;;;;;;;;;;;;;;;;;;;;;;;;;;;;;;;;;;;;;;;;;;;;;;;;;;;;; ;; Escribe en la ROM externa 64 bytes ubicados en la memoria de código del
;; microcontrolador.
;; Los datos se escriben en en la ROM a partir de la dirección indicada por
;; rom address H y rom address L (HI y LO), ocupando una página completa. ;; Recibe en DPTR la dirección del CSEG que contiene los datos a copiar.
;; En caso de error, aborta la escritura usando el carry como flag de error, ;; 0 es OK.
;;;;;;;;;;;;;;;;;;;;;;;;;;;;;;;;;;;;;;;;;;;;;;;;;;;;;;;;;;;;;;;;;;;;;;;;;;;;;;;; ;;;;;;;;;;;;;;;;;;;;;;;;;;;;;;;;;;;;;;;;;;;;;;;;;;;;;;;;;;;;;;;;;;;;;;;;;;;;;;;; ;; Depende de:
;; −−−−−−−−−−
;; | ROM BEGIN
;; | ROM END
;; | ROM SHIFT OUT BYTE
;; Requisitos:
;; −−−−−−−−−−
;; | rom address L
;; | rom address H
;;
;; Registros afectados:
;; −−−−−−−−−−−−−−−−−−−
;; | DPTR
;; | A
;; | C
;;;;;;;;;;;;;;;;;;;;;;;;;;;;;;;;;;;;;;;;;;;;;;;;;;;;;;;;;;;;;;;;;;;;;;;;;;;;;;;; ;;;;;;;;;;;;;;;;;;;;;;;;;;;;;;;;;;;;;;;;;;;;;;;;;;;;;;;;;;;;;;;;;;;;;;;;;;;;;;;;
Albani - Arbelo Arrocha - Figueroa | 57 | 1.er cuatrimestre 2008

; Se selecciona el dispositivo. ROM MACRO SELECT
; Se resguarda B.
PUSH B
; Se utiliza como iterador −> cantidad de bytes.
MOV | B, #64
;; Condición de Start.
CALL | ROM BEGIN
JC | ROM WRITE PAGE FROM CODE END
;; Sale si hay error.

;; Se envia la Device Address (WRITE).
MOV | A,#ROM ADDRESS MASK
CLR | acc.0
CALL | ROM SHIFT OUT BYTE
JC | ROM WRITE PAGE FROM CODE ERROR
;; Sale si hay error.

;; Se envia la dirección de la página a escribir.
MOV | A, rom address H
CALL | ROM SHIFT OUT BYTE
JC | ROM WRITE PAGE FROM CODE ERROR
;; Salimos si hay error.
MOV | A, rom address L
CALL | ROM SHIFT OUT BYTE
JC | ROM WRITE PAGE FROM CODE ERROR
;; Sale si hay error.

ROM WRITE PAGE FROM CODE LOOP:
; Se copia en A el byte de CSEG.
CLR | A
movc | A, @A+DPTR
;Se envia el byte.
CALL | ROM SHIFT OUT BYTE
JC | ROM WRITE PAGE FROM CODE ERROR
;; Salimos si hay error.
INC | DPTR
DJNZ | B, ROM WRITE PAGE FROM CODE LOOP

; Se indica que no hay errores.
CLR | C
; Condición de stop.
CALL ROM END
; Se espera a que de desocupe la ROM.
CALL | ROM WAIT BUSY
JMP | ROM WRITE PAGE FROM CODE END

ROM WRITE PAGE FROM CODE ERROR:
CALL ROM END
ROM WRITE PAGE FROM CODE END: ; Se resatura B
POP | B
RET
;;;;;;;;;;;;;;;;;;;;;;;;;;;;;;;;;;;;;;;;;;;;;;;;;;;;;;;;;;;;;;;;;;;;;;;;;;;;;;;; ;;;;;;;;;;;;;;;;;;;;;;;;;;;;;;;;;;;;;;;;;;;;;;;;;;;;;;;;;;;;;;;;;;;;;;;;;;;;;;;;

;;;;;;;;;;;;;;;;;;;;;;;;;;;;;;;;;;;;;;;;;;;;;;;;;;;;;;;;;;;;;;;;;;;;;;;;;;;;;;;; ;;;;;;;;;;;;;;;;;;;;;;;;;;;;;;;;;;;;;;;;;;;;;;;;;;;;;;;;;;;;;;;;;;;;;;;;;;;;;;;; ROM READ PAGE TO BUFFER:
;;;;;;;;;;;;;;;;;;;;;;;;;;;;;;;;;;;;;;;;;;;;;;;;;;;;;;;;;;;;;;;;;;;;;;;;;;;;;;;; ;;;;;;;;;;;;;;;;;;;;;;;;;;;;;;;;;;;;;;;;;;;;;;;;;;;;;;;;;;;;;;;;;;;;;;;;;;;;;;;; ;; Lee una página (64 bytes) de la ROM externa y los copia a rom page buffer
;; definido en RAM interna.
;; La dirección inicial de la ROM externa viene via rom address H y
Albani - Arbelo Arrocha - Figueroa | 58 | 1.er cuatrimestre 2008

;; rom address L (HI y LO).
;; Recibe en DPTR la dirección del CSEG que contiene los datos a copiar.
;; En caso de error, usa el carry como flag de error, 0 es OK.
;; Hace un write falso para indicar la dirección en la ROM y de ahí lee en forma ;; secuencial.
;;;;;;;;;;;;;;;;;;;;;;;;;;;;;;;;;;;;;;;;;;;;;;;;;;;;;;;;;;;;;;;;;;;;;;;;;;;;;;;; ;;;;;;;;;;;;;;;;;;;;;;;;;;;;;;;;;;;;;;;;;;;;;;;;;;;;;;;;;;;;;;;;;;;;;;;;;;;;;;;; ;;
;; Depende de:
;; −−−−−−−−−−
;; | ROM BEGIN
;; | ROM END
;; | ROM SEND ACK
;; | ROM SEND NACK
;; | ROM SHIFT IN BYTE
;; | ROM SHIFT OUT BYTE
;; Requisitos:
;; −−−−−−−−−−
;; | rom address L
;; | rom address H
;;
;; Registros afectados:
;; −−−−−−−−−−−−−−−−−−−
;; | rom page buffer
;; | A
;; | C
;;
;;;;;;;;;;;;;;;;;;;;;;;;;;;;;;;;;;;;;;;;;;;;;;;;;;;;;;;;;;;;;;;;;;;;;;;;;;;;;;;; ;;;;;;;;;;;;;;;;;;;;;;;;;;;;;;;;;;;;;;;;;;;;;;;;;;;;;;;;;;;;;;;;;;;;;;;;;;;;;;;; ; Se selecciona el dispositivo.
ROM MACRO SELECT
; Condición de start para setear la posición desde donde se lee.
CALL | ROM BEGIN
JC | ROM READ PAGE TO BUFFER END
; Sale si hay error.

; Se envia la Device Address (WRITE).
MOV | A,#ROM ADDRESS MASK
CLR | ACC.0
CALL | ROM SHIFT OUT BYTE
JC | ROM READ PAGE TO BUFFER ERROR
; Sale si hay error.

; Se envia la dirección de la página a 'escribir'.
MOV | A, rom address H
CALL | ROM SHIFT OUT BYTE
JC | ROM READ PAGE TO BUFFER ERROR
; Sale si hay error.
MOV | A, rom address L
CALL | ROM SHIFT OUT BYTE
JC | ROM READ PAGE TO BUFFER ERROR
; Sale si hay error.

; Condición de start para leer.
CALL | ROM BEGIN
JC | ROM READ PAGE TO BUFFER ERROR
; Sale si hay error.

; Se enviamos la Device Address (READ).
MOV | A, #ROM ADDRESS MASK
SETB | acc.0
CALL | ROM SHIFT OUT BYTE
JC | ROM READ PAGE TO BUFFER ERROR
; Sale si hay error.

; Se resguarda B.

Albani - Arbelo Arrocha - Figueroa | 59 | 1.er cuatrimestre 2008

PUSH B
; Se resguarda R0.
MOV | B,R0
; Se mueve a R0 la posición en CSEG del buffer.
MOV | R0, #rom page buffer

ROM READ PAGE TO BUFFER LOOP:
; Se lee en A.
CALL ROM SHIFT IN BYTE
; Se envia el byte al buffer.
MOV | @R0, A
; Se copia en A el puntero.
MOV | A, R0
SUBB | A,#rom page buffer

; Ahora A es cantidad de bytes escritos menos uno. CJNE A, #64d, NOT THE LAST BYTE
; Si es el último no se hace acknowledge.
CALL | ROM SEND NACK
JMP | ROM READ PAGE TO BUFFER FINISH
NOT THE LAST BYTE:
; Se anvia el acknowledge.
CALL | ROM SEND ACK
INC | R0
JMP | ROM READ PAGE TO BUFFER LOOP
ROM READ PAGE TO BUFFER FINISH:
MOV | R0,B | ;Se restaura R0.
POP | B | ;Se restaura B.
CLR | C | ;No hubo errores.
ROM READ PAGE TO BUFFER ERROR:
CALL ROM END
ROM READ PAGE TO BUFFER END:
RET
;;;;;;;;;;;;;;;;;;;;;;;;;;;;;;;;;;;;;;;;;;;;;;;;;;;;;;;;;;;;;;;;;;;;;;;;;;;;;;;; ;;;;;;;;;;;;;;;;;;;;;;;;;;;;;;;;;;;;;;;;;;;;;;;;;;;;;;;;;;;;;;;;;;;;;;;;;;;;;;;;

;;;;;;;;;;;;;;;;;;;;;;;;;;;;;;;;;;;;;;;;;;;;;;;;;;;;;;;;;;;;;;;;;;;;;;;;;;;;;;;; ;;;;;;;;;;;;;;;;;;;;;;;;;;;;;;;;;;;;;;;;;;;;;;;;;;;;;;;;;;;;;;;;;;;;;;;;;;;;;;;; ROM INC ADDRESS 64:
;;;;;;;;;;;;;;;;;;;;;;;;;;;;;;;;;;;;;;;;;;;;;;;;;;;;;;;;;;;;;;;;;;;;;;;;;;;;;;;; ;;;;;;;;;;;;;;;;;;;;;;;;;;;;;;;;;;;;;;;;;;;;;;;;;;;;;;;;;;;;;;;;;;;;;;;;;;;;;;;; ;; Rutina para incrementar la dirección de memoria en 64 bytes ;;;;;;;;;;;;;;;;;;;;;;;;;;;;;;;;;;;;;;;;;;;;;;;;;;;;;;;;;;;;;;;;;;;;;;;;;;;;;;;; ;;;;;;;;;;;;;;;;;;;;;;;;;;;;;;;;;;;;;;;;;;;;;;;;;;;;;;;;;;;;;;;;;;;;;;;;;;;;;;;;
CLR | C
MOV | A,rom address L
ADD | A,#64d
JNC | ROM INC ADDRESS 64 EXIT
INC | rom address H
ROM INC ADDRESS 64 EXIT:
MOV | rom address L, A
RET
;;;;;;;;;;;;;;;;;;;;;;;;;;;;;;;;;;;;;;;;;;;;;;;;;;;;;;;;;;;;;;;;;;;;;;;;;;;;;;;; ;;;;;;;;;;;;;;;;;;;;;;;;;;;;;;;;;;;;;;;;;;;;;;;;;;;;;;;;;;;;;;;;;;;;;;;;;;;;;;;;

;;;;;;;;;;;;;;;;;;;;;;;;;;;;;;;;;;;;;;;;;;;;;;;;;;;;;;;;;;;;;;;;;;;;;;;;;;;;;;;; ;;;;;;;;;;;;;;;;;;;;;;;;;;;;;;;;;;;;;;;;;;;;;;;;;;;;;;;;;;;;;;;;;;;;;;;;;;;;;;;; ROM ERASE PAGE:
;;;;;;;;;;;;;;;;;;;;;;;;;;;;;;;;;;;;;;;;;;;;;;;;;;;;;;;;;;;;;;;;;;;;;;;;;;;;;;;; ;;;;;;;;;;;;;;;;;;;;;;;;;;;;;;;;;;;;;;;;;;;;;;;;;;;;;;;;;;;;;;;;;;;;;;;;;;;;;;;; ;; Rutina para borrar una página de 64 bytes. ;;;;;;;;;;;;;;;;;;;;;;;;;;;;;;;;;;;;;;;;;;;;;;;;;;;;;;;;;;;;;;;;;;;;;;;;;;;;;;;; ;;;;;;;;;;;;;;;;;;;;;;;;;;;;;;;;;;;;;;;;;;;;;;;;;;;;;;;;;;;;;;;;;;;;;;;;;;;;;;;; ;;
Albani - Arbelo Arrocha - Figueroa | 60 | 1.er cuatrimestre 2008

;; Depende de:
;; −−−−−−−−−−
;; | ROM BEGIN
;; | ROM SHIFT OUT BYTE
;; | ROM END
;; | ROM WAIT BUSY
;;
;; Requisitos:
;; −−−−−−−−−−
;; | rom address L
;; | rom address H
;;
;; Registros alterados:
;; −−−−−−−−−−−−−−−−−−−
;; | A
;; | C
;;
;;;;;;;;;;;;;;;;;;;;;;;;;;;;;;;;;;;;;;;;;;;;;;;;;;;;;;;;;;;;;;;;;;;;;;;;;;;;;;;; ;;;;;;;;;;;;;;;;;;;;;;;;;;;;;;;;;;;;;;;;;;;;;;;;;;;;;;;;;;;;;;;;;;;;;;;;;;;;;;;; ROM MACRO SELECT
CALL | ROM BEGIN
JC | ROM ERASE PAGE END
MOV | A, #ROM ADDRESS MASK
CLR | Acc.0
CALL | ROM SHIFT OUT BYTE
JC | ROM ERASE PAGE ERROR
MOV | A, rom address H
CALL | ROM SHIFT OUT BYTE
JC | ROM ERASE PAGE ERROR
MOV | A, rom address L
CALL | ROM SHIFT OUT BYTE
JC | ROM ERASE PAGE ERROR
PUSH | B
MOV | B, #64
ROM ERASE PAGE LOOP:
CLR | A
CALL | ROM SHIFT OUT BYTE
JC | ROM ERASE PAGE ERROR
DJNZ | B, ROM ERASE PAGE LOOP
CLR | C | ;No hay errores.
CALL | ROM END
CALL | ROM WAIT BUSY
JMP | ROM ERASE PAGE END
ROM ERASE PAGE ERROR:
CALL | ROM END
ROM ERASE PAGE END:
POP | B

RET
;;;;;;;;;;;;;;;;;;;;;;;;;;;;;;;;;;;;;;;;;;;;;;;;;;;;;;;;;;;;;;;;;;;;;;;;;;;;;;;; ;;;;;;;;;;;;;;;;;;;;;;;;;;;;;;;;;;;;;;;;;;;;;;;;;;;;;;;;;;;;;;;;;;;;;;;;;;;;;;;;

;;;;;;;;;;;;;;;;;;;;;;;;;;;;;;;;;;;;;;;;;;;;;;;;;;;;;;;;;;;;;;;;;;;;;;;;;;;;;;;; ;;;;;;;;;;;;;;;;;;;;;;;;;;;;;;;;;;;;;;;;;;;;;;;;;;;;;;;;;;;;;;;;;;;;;;;;;;;;;;;; ROM ERASE:
;;;;;;;;;;;;;;;;;;;;;;;;;;;;;;;;;;;;;;;;;;;;;;;;;;;;;;;;;;;;;;;;;;;;;;;;;;;;;;;; ;;;;;;;;;;;;;;;;;;;;;;;;;;;;;;;;;;;;;;;;;;;;;;;;;;;;;;;;;;;;;;;;;;;;;;;;;;;;;;;; ;; Rutina para borrar completamente el contenido de la memoria ROM. ;;;;;;;;;;;;;;;;;;;;;;;;;;;;;;;;;;;;;;;;;;;;;;;;;;;;;;;;;;;;;;;;;;;;;;;;;;;;;;;; ;;;;;;;;;;;;;;;;;;;;;;;;;;;;;;;;;;;;;;;;;;;;;;;;;;;;;;;;;;;;;;;;;;;;;;;;;;;;;;;;
Albani - Arbelo Arrocha - Figueroa | 61 | 1.er cuatrimestre 2008

;;
;; Depende de:
;; −−−−−−−−−−
;; | ROM ERASE PAGE
;; | ROM INC ADDRESS 64
;;
;; Requisitos:
;; −−−−−−−−−−
;;
;; Registros alterados:
;; −−−−−−−−−−−−−−−−−−−
;; | B, A, C
;;
;;;;;;;;;;;;;;;;;;;;;;;;;;;;;;;;;;;;;;;;;;;;;;;;;;;;;;;;;;;;;;;;;;;;;;;;;;;;;;;; ROM MACRO SELECT
MOV | rom address L, #00H
MOV | rom address H, #00H
ROM ERASE LOOP:
CALL | ROM ERASE PAGE
CALL | ROM INC ADDRESS 64
MOV | A, rom address H
CJNE | A, #080H, ROM ERASE LOOP
RET
;;;;;;;;;;;;;;;;;;;;;;;;;;;;;;;;;;;;;;;;;;;;;;;;;;;;;;;;;;;;;;;;;;;;;;;;;;;;;;;; ;;;;;;;;;;;;;;;;;;;;;;;;;;;;;;;;;;;;;;;;;;;;;;;;;;;;;;;;;;;;;;;;;;;;;;;;;;;;;;;;

;;;;;;;;;;;;;;;;;;;;;;;;;;;;;;;;;;;;;;;;;;;;;;;;;;;;;;;;;;;;;;;;;;;;;;;;;;;;;;;; ;;;;;;;;;;;;;;;;;;;;;;;;;;;;;;;;;;;;;;;;;;;;;;;;;;;;;;;;;;;;;;;;;;;;;;;;;;;;;;;; ROM WRITE FROM BANK:
;;;;;;;;;;;;;;;;;;;;;;;;;;;;;;;;;;;;;;;;;;;;;;;;;;;;;;;;;;;;;;;;;;;;;;;;;;;;;;;; ;;;;;;;;;;;;;;;;;;;;;;;;;;;;;;;;;;;;;;;;;;;;;;;;;;;;;;;;;;;;;;;;;;;;;;;;;;;;;;;; ;; Rutina para grabar los 8 bytes del banco de registros seleccionado a ROM. ;;;;;;;;;;;;;;;;;;;;;;;;;;;;;;;;;;;;;;;;;;;;;;;;;;;;;;;;;;;;;;;;;;;;;;;;;;;;;;;; ;;;;;;;;;;;;;;;;;;;;;;;;;;;;;;;;;;;;;;;;;;;;;;;;;;;;;;;;;;;;;;;;;;;;;;;;;;;;;;;; ;;
;; Depende de:
;; −−−−−−−−−−
;; | ROM MACRO SELECT
;; | ROM BEGIN
;; | ROM SHIFT OUT BYTE
;; | ROM END
;; | ROM WAIT BUSY
;;
;; Requisitos:
;; −−−−−−−−−−
;;
;; Registros alterados:
;; −−−−−−−−−−−−−−−−−−−
;; | A
;; | C <− Informa si hubo errores. 1 = Fracaso, 0 = Éxito.

;;
;;;;;;;;;;;;;;;;;;;;;;;;;;;;;;;;;;;;;;;;;;;;;;;;;;;;;;;;;;;;;;;;;;;;;;;;;;;;;;;;

; Primero se ejecuta la macro que garantiza que la rom esté disponible:
ROM MACRO SELECT

; Se envía la señal de inicio:
CALL | ROM BEGIN
; En el carry se informa si se produjo un error:
JC | ROM WRITE FROM BANK ERROR

; Se envía la Device Address (WRITE).
MOV | A, #ROM ADDRESS MASK
CLR | Acc.0
CALL | ROM SHIFT OUT BYTE
Albani - Arbelo Arrocha - Figueroa | 62 | 1.er cuatrimestre 2008

; En el carry se informa si se produjo un error:
JC | ROM WRITE FROM BANK ERROR

; Se envía la dirección de la página a escribir: ; Primero la parte alta:
MOV | A, rom address H
CALL | ROM SHIFT OUT BYTE
; En el carry se informa si se produjo un error:
JC | ROM WRITE FROM BANK ERROR

; Luego la parte baja:
MOV | A, rom address L
CALL | ROM SHIFT OUT BYTE
; En el carry se informa si se produjo un error:
JC | ROM WRITE FROM BANK ERROR

; Inicio del envío de los registros del banco:

MOV | A, R0
CALL | ROM SHIFT OUT BYTE
JC | ROM WRITE FROM BANK ERROR
MOV | A, R1
CALL | ROM SHIFT OUT BYTE
JC | ROM WRITE FROM BANK ERROR
MOV | A, R2
CALL | ROM SHIFT OUT BYTE
JC | ROM WRITE FROM BANK ERROR
MOV | A, R3
CALL | ROM SHIFT OUT BYTE
JC | ROM WRITE FROM BANK ERROR
MOV | A, R4
CALL | ROM SHIFT OUT BYTE
JC | ROM WRITE FROM BANK ERROR
MOV | A, R5
CALL | ROM SHIFT OUT BYTE
JC | ROM WRITE FROM BANK ERROR
MOV | A, R6
CALL | ROM SHIFT OUT BYTE
JC | ROM WRITE FROM BANK ERROR
MOV | A, R7
CALL | ROM SHIFT OUT BYTE
JC | ROM WRITE FROM BANK ERROR

; Si no hubo errores, se limpia el Carry para informarlo:
CALL | ROM END
CALL | ROM WAIT BUSY
CLR | C
RET

; Si hubo errores, se prende el Carry para informarlo: ROM WRITE FROM BANK ERROR:
CALL | ROM END
SETB | C
RET
;;;;;;;;;;;;;;;;;;;;;;;;;;;;;;;;;;;;;;;;;;;;;;;;;;;;;;;;;;;;;;;;;;;;;;;;;;;;;;;; ;;;;;;;;;;;;;;;;;;;;;;;;;;;;;;;;;;;;;;;;;;;;;;;;;;;;;;;;;;;;;;;;;;;;;;;;;;;;;;;;

;;;;;;;;;;;;;;;;;;;;;;;;;;;;;;;;;;;;;;;;;;;;;;;;;;;;;;;;;;;;;;;;;;;;;;;;;;;;;;;;

Albani - Arbelo Arrocha - Figueroa | 63 | 1.er cuatrimestre 2008

;;;;;;;;;;;;;;;;;;;;;;;;;;;;;;;;;;;;;;;;;;;;;;;;;;;;;;;;;;;;;;;;;;;;;;;;;;;;;;;; ROM READ TO BANK:
;;;;;;;;;;;;;;;;;;;;;;;;;;;;;;;;;;;;;;;;;;;;;;;;;;;;;;;;;;;;;;;;;;;;;;;;;;;;;;;; ;;;;;;;;;;;;;;;;;;;;;;;;;;;;;;;;;;;;;;;;;;;;;;;;;;;;;;;;;;;;;;;;;;;;;;;;;;;;;;;; ;; Rutina para leer 8 bytes ROM y guardarlos en
;; el banco de registros seleccionado. ;;;;;;;;;;;;;;;;;;;;;;;;;;;;;;;;;;;;;;;;;;;;;;;;;;;;;;;;;;;;;;;;;;;;;;;;;;;;;;;; ;;;;;;;;;;;;;;;;;;;;;;;;;;;;;;;;;;;;;;;;;;;;;;;;;;;;;;;;;;;;;;;;;;;;;;;;;;;;;;;; ;;
;; Depende de:
;; −−−−−−−−−−
;; | ROM MACRO SELECT
;; | ROM BEGIN
;; | ROM SHIFT OUT BYTE
;; | ROM SHIFT IN BYTE
;; | ROM END
;; | ROM WAIT BUSY
;;
;; Requisitos:
;; −−−−−−−−−−
;; | La parte alta de la dirección en rom en rom address H.
;; | La parte baja de la dirección en rom en rom address L.
;; Registros alterados:
;; −−−−−−−−−−−−−−−−−−−
;; | A
;; | C <− Informa si hubo errores. 1 = Fracaso, 0 = Éxito.

;;
;;;;;;;;;;;;;;;;;;;;;;;;;;;;;;;;;;;;;;;;;;;;;;;;;;;;;;;;;;;;;;;;;;;;;;;;;;;;;;;;

; Primero se ejecuta la macro que garantiza que la rom esté disponible:
ROM MACRO SELECT

; Se envía la señal de inicio:
CALL | ROM BEGIN
; En el carry se informa si se produjo un error:
JC | ROM READ TO BANK ERROR

; Se envía la Device Address (WRITE).
MOV | A, #ROM ADDRESS MASK
CLR | ACC.0
CALL | ROM SHIFT OUT BYTE
; En el carry se informa si se produjo un error:
JC | ROM READ TO BANK ERROR

; Se envía la dirección de la página a escribir: ; Primero la parte alta:
MOV | A, rom address H
CALL | ROM SHIFT OUT BYTE
; En el carry se informa si se produjo un error:
JC | ROM READ TO BANK ERROR

; Luego la parte baja:
MOV | A, rom address L
CALL | ROM SHIFT OUT BYTE
; En el carry se informa si se produjo un error:
JC | ROM READ TO BANK ERROR

; Se envía la señal de inicio:
CALL | ROM BEGIN
JC | ROM READ TO BANK ERROR

; Se envía la Device Address (READ).
MOV | A, #ROM ADDRESS MASK
SETB | acc.0
CALL | ROM SHIFT OUT BYTE
JC | ROM READ TO BANK ERROR
Albani - Arbelo Arrocha - Figueroa | 64 | 1.er cuatrimestre 2008

; Inicio de la lectura de bytes:
CALL | ROM SHIFT IN BYTE
MOV | R0, | A
CALL | ROM SEND ACK
CALL | ROM SHIFT IN BYTE
MOV | R1, | A
CALL | ROM SEND ACK
CALL | ROM SHIFT IN BYTE
MOV | R2, | A
CALL | ROM SEND ACK
CALL | ROM SHIFT IN BYTE
MOV | R3, | A
CALL | ROM SEND ACK
CALL | ROM SHIFT IN BYTE
MOV | R4, | A
CALL | ROM SEND ACK
CALL | ROM SHIFT IN BYTE
MOV | R5, | A
CALL | ROM SEND ACK
CALL | ROM SHIFT IN BYTE
MOV | R6, | A
CALL | ROM SEND ACK
CALL | ROM SHIFT IN BYTE
MOV | R7, | A
CALL | ROM SEND NACK | ;Al último no hacemos ACK.

; Si no hubo errores, se limpia el Carry para informarlo:
CLR | C

; Si hubo errores, se deja al Carry prendido para informarlo: ROM READ TO BANK ERROR:
CALL | ROM END
RET
;;;;;;;;;;;;;;;;;;;;;;;;;;;;;;;;;;;;;;;;;;;;;;;;;;;;;;;;;;;;;;;;;;;;;;;;;;;;;;;; ;;;;;;;;;;;;;;;;;;;;;;;;;;;;;;;;;;;;;;;;;;;;;;;;;;;;;;;;;;;;;;;;;;;;;;;;;;;;;;;;
Albani - Arbelo Arrocha - Figueroa | 65 | 1.er cuatrimestre 2008

# 6.6. adc.asm

;;;;;;;;;;;;;;;;;;;;;;;;;;;;;;;;;;;;;;;;;;;;;;;;;;;;;;;;;;;;;;;;;;;;;;;;;;;;;;;; ;;;;;;;;;;;;;;;;;;;;;;;;;;;;;;;;;;;;;;;;;;;;;;;;;;;;;;;;;;;;;;;;;;;;;;;;;;;;;;;; ;; Rutinas de control del dispositivo: A/D Converter − ADC0834ACN
;;
;;;;;;;;;;;;;;;;;;;;;;;;;;;;;;;;;;;;;;;;;;;;;;;;;;;;;;;;;;;;;;;;;;;;;;;;;;;;;;;; ;;;;;;;;;;;;;;;;;;;;;;;;;;;;;;;;;;;;;;;;;;;;;;;;;;;;;;;;;;;;;;;;;;;;;;;;;;;;;;;; ;;
;; Rutinas públicas:
;; −−−−−−−−−−−−−−−−−
;; | ADC CONVERSION
;;
;; Macros públicas:
;; −−−−−−−−−−−−−−−−−
;; | ADC MACRO READ CHANNEL 0
;; | ADC MACRO READ CHANNEL 1
;;
;;;;;;;;;;;;;;;;;;;;;;;;;;;;;;;;;;;;;;;;;;;;;;;;;;;;;;;;;;;;;;;;;;;;;;;;;;;;;;;; ;;;;;;;;;;;;;;;;;;;;;;;;;;;;;;;;;;;;;;;;;;;;;;;;;;;;;;;;;;;;;;;;;;;;;;;;;;;;;;;; ;; Definiciones:
;;;;;;;;;;;;;;;;;;;;;;;;;;;;;;;;;;;;;;;;;;;;;;;;;;;;;;;;;;;;;;;;;;;;;;;;;;;;;;;; ;;;;;;;;;;;;;;;;;;;;;;;;;;;;;;;;;;;;;;;;;;;;;;;;;;;;;;;;;;;;;;;;;;;;;;;;;;;;;;;;
ADC CLK | EQU | P2.0 | ; Señal de Clock ADC.
ADC DATA INPUT | EQU | P2.1 | ; Datos: Micro −> ADC.
ADC DATA OUTPUT | EQU | P2.2 | ; Datos: ADC −> Micro.
ADC SARS | EQU | P2.3 | ; Señal en proceso.
;; | 123 −> Bits que determinan el canal.
ADC CHANNEL0 | EQU | 10000000b
ADC CHANNEL1 | EQU | 11000000b
ADC CHANNEL2 | EQU | 10100000b
ADC CHANNEL3 | EQU | 11100000b
; +−
ADC CHANNEL01 | EQU | 00000000b
ADC CHANNEL10 | EQU | 01000000b
ADC CHANNEL23 | EQU | 00100000b
ADC CHANNEL32 | EQU | 01100000b

;;;;;;;;;;;;;;;;;;;;;;;;;;;;;;;;;;;;;;;;;;;;;;;;;;;;;;;;;;;;;;;;;;;;;;;;;;;;;;;; ;;;;;;;;;;;;;;;;;;;;;;;;;;;;;;;;;;;;;;;;;;;;;;;;;;;;;;;;;;;;;;;;;;;;;;;;;;;;;;;; ;; Macros:
;;;;;;;;;;;;;;;;;;;;;;;;;;;;;;;;;;;;;;;;;;;;;;;;;;;;;;;;;;;;;;;;;;;;;;;;;;;;;;;; ;;;;;;;;;;;;;;;;;;;;;;;;;;;;;;;;;;;;;;;;;;;;;;;;;;;;;;;;;;;;;;;;;;;;;;;;;;;;;;;;

;;;;;;;;;;;;;;;;;;;;;;;;;;;;;;;;;;;;;;;;;;;;;;;;;;;;;;;;;;;;;;;;;;;;;;;;;;;;;;;; ;; Simplifica la lectura del canal 0. Devuelve en el acumulador el byte leído. ;;;;;;;;;;;;;;;;;;;;;;;;;;;;;;;;;;;;;;;;;;;;;;;;;;;;;;;;;;;;;;;;;;;;;;;;;;;;;;;;
ADC MACRO READ CHANNEL 0 | MACRO
MOV | A, #ADC CHANNEL0
CALL | ADC CONVERSION
ENDM
;;;;;;;;;;;;;;;;;;;;;;;;;;;;;;;;;;;;;;;;;;;;;;;;;;;;;;;;;;;;;;;;;;;;;;;;;;;;;;;; ;;;;;;;;;;;;;;;;;;;;;;;;;;;;;;;;;;;;;;;;;;;;;;;;;;;;;;;;;;;;;;;;;;;;;;;;;;;;;;;;

;;;;;;;;;;;;;;;;;;;;;;;;;;;;;;;;;;;;;;;;;;;;;;;;;;;;;;;;;;;;;;;;;;;;;;;;;;;;;;;; ;; Simplifica la lectura del canal 1. Devuelve en el acumulador el byte leído. ;;;;;;;;;;;;;;;;;;;;;;;;;;;;;;;;;;;;;;;;;;;;;;;;;;;;;;;;;;;;;;;;;;;;;;;;;;;;;;;;
ADC MACRO READ CHANNEL 1 | MACRO
MOV | A, #ADC CHANNEL1
CALL | ADC CONVERSION
ENDM
;;;;;;;;;;;;;;;;;;;;;;;;;;;;;;;;;;;;;;;;;;;;;;;;;;;;;;;;;;;;;;;;;;;;;;;;;;;;;;;; ;;;;;;;;;;;;;;;;;;;;;;;;;;;;;;;;;;;;;;;;;;;;;;;;;;;;;;;;;;;;;;;;;;;;;;;;;;;;;;;;
Albani - Arbelo Arrocha - Figueroa | 66 | 1.er cuatrimestre 2008

;;;;;;;;;;;;;;;;;;;;;;;;;;;;;;;;;;;;;;;;;;;;;;;;;;;;;;;;;;;;;;;;;;;;;;;;;;;;;;;; ;; Simplifica la lectura del canal 2. Devuelve en el acumulador el byte leído. ;;;;;;;;;;;;;;;;;;;;;;;;;;;;;;;;;;;;;;;;;;;;;;;;;;;;;;;;;;;;;;;;;;;;;;;;;;;;;;;;
ADC MACRO READ CHANNEL 2 | MACRO
MOV | A, #ADC CHANNEL2
CALL | ADC CONVERSION
ENDM
;;;;;;;;;;;;;;;;;;;;;;;;;;;;;;;;;;;;;;;;;;;;;;;;;;;;;;;;;;;;;;;;;;;;;;;;;;;;;;;; ;;;;;;;;;;;;;;;;;;;;;;;;;;;;;;;;;;;;;;;;;;;;;;;;;;;;;;;;;;;;;;;;;;;;;;;;;;;;;;;;

;;;;;;;;;;;;;;;;;;;;;;;;;;;;;;;;;;;;;;;;;;;;;;;;;;;;;;;;;;;;;;;;;;;;;;;;;;;;;;;; ;; Simplifica la lectura del canal 3. Devuelve en el acumulador el byte leído. ;;;;;;;;;;;;;;;;;;;;;;;;;;;;;;;;;;;;;;;;;;;;;;;;;;;;;;;;;;;;;;;;;;;;;;;;;;;;;;;;
ADC MACRO READ CHANNEL 3 | MACRO
MOV | A, #ADC CHANNEL3
CALL | ADC CONVERSION
ENDM
;;;;;;;;;;;;;;;;;;;;;;;;;;;;;;;;;;;;;;;;;;;;;;;;;;;;;;;;;;;;;;;;;;;;;;;;;;;;;;;; ;;;;;;;;;;;;;;;;;;;;;;;;;;;;;;;;;;;;;;;;;;;;;;;;;;;;;;;;;;;;;;;;;;;;;;;;;;;;;;;;

CSEG

;;;;;;;;;;;;;;;;;;;;;;;;;;;;;;;;;;;;;;;;;;;;;;;;;;;;;;;;;;;;;;;;;;;;;;;;;;;;;;;; ;;;;;;;;;;;;;;;;;;;;;;;;;;;;;;;;;;;;;;;;;;;;;;;;;;;;;;;;;;;;;;;;;;;;;;;;;;;;;;;; ;; Rutinas:
;;;;;;;;;;;;;;;;;;;;;;;;;;;;;;;;;;;;;;;;;;;;;;;;;;;;;;;;;;;;;;;;;;;;;;;;;;;;;;;; ;;;;;;;;;;;;;;;;;;;;;;;;;;;;;;;;;;;;;;;;;;;;;;;;;;;;;;;;;;;;;;;;;;;;;;;;;;;;;;;;

;;;;;;;;;;;;;;;;;;;;;;;;;;;;;;;;;;;;;;;;;;;;;;;;;;;;;;;;;;;;;;;;;;;;;;;;;;;;;;;; ;;;;;;;;;;;;;;;;;;;;;;;;;;;;;;;;;;;;;;;;;;;;;;;;;;;;;;;;;;;;;;;;;;;;;;;;;;;;;;;; ADC CONVERSION:
;;;;;;;;;;;;;;;;;;;;;;;;;;;;;;;;;;;;;;;;;;;;;;;;;;;;;;;;;;;;;;;;;;;;;;;;;;;;;;;; ;;;;;;;;;;;;;;;;;;;;;;;;;;;;;;;;;;;;;;;;;;;;;;;;;;;;;;;;;;;;;;;;;;;;;;;;;;;;;;;; ;;
;; Depende de:
;; −−−−−−−−−
;; | ADC MACRO SELECT
;; | ADC PULSE
;;
;; Requisitos:
;; −−−−−−−−−−
;; | El canal deseado en el acumulador.
;; | (Ver Definiciones de ADC CHANNEL0 a 4.)
;;
;; Registros afectados:
;; −−−−−−−−−−−−−−−−−−−
;; | A <− byte leído. 0 equivale a 0 Volts, 255 a 5 Volts.
;; | C <− flag de error, 0 es OK.
;;
;;;;;;;;;;;;;;;;;;;;;;;;;;;;;;;;;;;;;;;;;;;;;;;;;;;;;;;;;;;;;;;;;;;;;;;;;;;;;;;; ;;;;;;;;;;;;;;;;;;;;;;;;;;;;;;;;;;;;;;;;;;;;;;;;;;;;;;;;;;;;;;;;;;;;;;;;;;;;;;;;

; Primero se ejecuta la macro que garantiza que el ADC está disponible:
ADC MACRO SELECT
CLR | ADC CLK
; Se envía el bit de Start:
SETB | ADC DATA INPUT
CALL | ADC PULSE

; Se usa B como iterador para mandar los tres bits que determinan ; el canal multiplexado:
PUSH | B
MOV | B, #3d
Albani - Arbelo Arrocha - Figueroa | 67 | 1.er cuatrimestre 2008

; Se establece el canal:

ADC CONVERSION SHIFT IN:
; Se envían los tres bits del canal al carry para establecer ; la comunicación serial:
RLC | A
MOV | ADC DATA INPUT, C
CALL | ADC PULSE
JB | ADC SARS, ($+3)
SETB | C
DJNZ | B, ADC CONVERSION SHIFT IN

; Acontinuación se guarda la conversión en A.

; Se usa nuevamente B como iterador. Esta vez B=8 ya que ; son 8 bits los que se deben almacenar.
MOV | B, #8d

ADC CONVERSION SHIFT OUT:
CALL | ADC PULSE
MOV | C,ADC DATA OUTPUT
; Se guardan uno a uno los bits en A:
RLC | A
; Tiempo para el ADC y el BUFFER: NOP
NOP
NOP
NOP
JNB | ADC SARS, ($+3)
SETB | C
DJNZ | B, ADC CONVERSION SHIFT OUT
POP | B
RET
;;;;;;;;;;;;;;;;;;;;;;;;;;;;;;;;;;;;;;;;;;;;;;;;;;;;;;;;;;;;;;;;;;;;;;;;;;;;;;;; ;;;;;;;;;;;;;;;;;;;;;;;;;;;;;;;;;;;;;;;;;;;;;;;;;;;;;;;;;;;;;;;;;;;;;;;;;;;;;;;;

;;;;;;;;;;;;;;;;;;;;;;;;;;;;;;;;;;;;;;;;;;;;;;;;;;;;;;;;;;;;;;;;;;;;;;;;;;;;;;;; ;;;;;;;;;;;;;;;;;;;;;;;;;;;;;;;;;;;;;;;;;;;;;;;;;;;;;;;;;;;;;;;;;;;;;;;;;;;;;;;; ADC PULSE:
;;;;;;;;;;;;;;;;;;;;;;;;;;;;;;;;;;;;;;;;;;;;;;;;;;;;;;;;;;;;;;;;;;;;;;;;;;;;;;;; ;;;;;;;;;;;;;;;;;;;;;;;;;;;;;;;;;;;;;;;;;;;;;;;;;;;;;;;;;;;;;;;;;;;;;;;;;;;;;;;; ;; Rutina que envía efectivamente los datos al microcontrolador. ;;;;;;;;;;;;;;;;;;;;;;;;;;;;;;;;;;;;;;;;;;;;;;;;;;;;;;;;;;;;;;;;;;;;;;;;;;;;;;;; ;;;;;;;;;;;;;;;;;;;;;;;;;;;;;;;;;;;;;;;;;;;;;;;;;;;;;;;;;;;;;;;;;;;;;;;;;;;;;;;;
SETB | ADC CLK
NOP | ; Delay debido al BUFFER.
CLR | ADC CLK
RET
;;;;;;;;;;;;;;;;;;;;;;;;;;;;;;;;;;;;;;;;;;;;;;;;;;;;;;;;;;;;;;;;;;;;;;;;;;;;;;;; ;;;;;;;;;;;;;;;;;;;;;;;;;;;;;;;;;;;;;;;;;;;;;;;;;;;;;;;;;;;;;;;;;;;;;;;;;;;;;;;;
Albani - Arbelo Arrocha - Figueroa | 68 | 1.er cuatrimestre 2008

# 6.7. decoder.asm

DECA | EQU P0.1 | ; Entrada A del decodificador.
DECB | EQU P0.0 | ; Entrada B del decodificador.
DECC | EQU P1.7 | ; Entrada C del decodificador.
DECODER DISPLAY | EQU | 10000000b
DECODER KEYPAD | EQU | 01000000b
DECODER ROM | EQU | 11000000b
DECODER ADC | EQU | 00000000b

DSEG

; Si ninguna interrupción va a cambiar de dispositivo, se puede ; evitar usar esta variable.
decoder selected device: | DS | 1

CSEG

DECODER SELECT DEVICE:
START SENSIBLE OP
PUSH | Acc
CLR | C
MOV | A, decoder selected device
RLC | A
MOV | DECA, C
RLC | A
MOV | DECB, C
RLC | A
MOV | DECC, C
POP | Acc

NOP
NOP
NOP
NOP
END SENSIBLE OP
RET
Albani - Arbelo Arrocha - Figueroa | 69 | 1.er cuatrimestre 2008

# 6.8. timers.asm

;;;;;;;;;;;;;;;;;;;;;;;;;;;;;;;;;;;;;;;;;;;;;;;;;;;;;;;;;;;;;;;;;;;;;;;;;;;;;;;; ;;;;;;;;;;;;;;;;;;;;;;;;;;;;;;;;;;;;;;;;;;;;;;;;;;;;;;;;;;;;;;;;;;;;;;;;;;;;;;;; ;; Rutinas de timers y manejo de tiempos. ;;;;;;;;;;;;;;;;;;;;;;;;;;;;;;;;;;;;;;;;;;;;;;;;;;;;;;;;;;;;;;;;;;;;;;;;;;;;;;;; ;;;;;;;;;;;;;;;;;;;;;;;;;;;;;;;;;;;;;;;;;;;;;;;;;;;;;;;;;;;;;;;;;;;;;;;;;;;;;;;; ;; Registro TMOD:
;; −−−−−−−−−−−−−
;; 0: Timer 0 M0 bit
;; 1: Timer 0 M1 bit
;; 2: Timer 0 Clock source select bit (External(1)/On−chip−clock(0)). ;; 3: Timer 0 Gate bit.
;; 4: Timer 1 M0 bit
;; 5: Timer 1 M1 bit
;; 6: Timer 1 Clock source select bit (External(1)/On−chip−clock(0)). ;; 7: Timer 1 Gate bit.
;;
;; Timer modes:
;; −−−−−−−−−−−
;; M1 | M0 | MODE | Description
;; | 0 | 0 | 0 | 13−bit timer mode.
;; | 0 | 1 | 1 | 16−bit timer mode.
;; | 1 | 0 | 2 | 8−bit auto−reload mode.
;; | 1 | 1 | 3 | Split timer mode.
;;;;;;;;;;;;;;;;;;;;;;;;;;;;;;;;;;;;;;;;;;;;;;;;;;;;;;;;;;;;;;;;;;;;;;;;;;;;;;;; ;;;;;;;;;;;;;;;;;;;;;;;;;;;;;;;;;;;;;;;;;;;;;;;;;;;;;;;;;;;;;;;;;;;;;;;;;;;;;;;;

;;;;;;;;;;;;;;;;;;;;;;;;;;;;;;;;;;;;;;;;;;;;;;;;;;;;;;;;;;;;;;;;;;;;;;;;;;;;;;;; ;;;;;;;;;;;;;;;;;;;;;;;;;;;;;;;;;;;;;;;;;;;;;;;;;;;;;;;;;;;;;;;;;;;;;;;;;;;;;;;; ;; Definiciones:
;;;;;;;;;;;;;;;;;;;;;;;;;;;;;;;;;;;;;;;;;;;;;;;;;;;;;;;;;;;;;;;;;;;;;;;;;;;;;;;; ;;;;;;;;;;;;;;;;;;;;;;;;;;;;;;;;;;;;;;;;;;;;;;;;;;;;;;;;;;;;;;;;;;;;;;;;;;;;;;;; ; Base de tiempo del Timer 0 en milisegundos:
TIMER0 BASE MS | EQU | 10d
; Valor inicial de la cuenta regresiva del Timer 0.
TIMER0 COUNT START | EQU | 100d

; Base de tiempo del Timer 1 en milisegundos:
TIMER1 BASE MS | EQU | 1d

;;;;;;;;;;;;;;;;;;;;;;;;;;;;;;;;;;;;;;;;;;;;;;;;;;;;;;;;;;;;;;;;;;;;;;;;;;;;;;;; ;;;;;;;;;;;;;;;;;;;;;;;;;;;;;;;;;;;;;;;;;;;;;;;;;;;;;;;;;;;;;;;;;;;;;;;;;;;;;;;;

DSEG

;;;;;;;;;;;;;;;;;;;;;;;;;;;;;;;;;;;;;;;;;;;;;;;;;;;;;;;;;;;;;;;;;;;;;;;;;;;;;;;; ;;;;;;;;;;;;;;;;;;;;;;;;;;;;;;;;;;;;;;;;;;;;;;;;;;;;;;;;;;;;;;;;;;;;;;;;;;;;;;;;
timer0 count down: | DS | 1 | ; Valor de la cuenta regresiva del Timer 0.

;; Segundero de 2 bytes. 2ˆ16 segundos = 18:12:16 (horas:minutos:segundos).
timers seconds L: | DS | 1 | ; Byte bajo del segundero.
timers seconds H: | DS | 1 | ; Byte alto del segundero.

; \()/
timers msecs: | DS | 1 | ; milisegundero.
;;;;;;;;;;;;;;;;;;;;;;;;;;;;;;;;;;;;;;;;;;;;;;;;;;;;;;;;;;;;;;;;;;;;;;;;;;;;;;;; ;;;;;;;;;;;;;;;;;;;;;;;;;;;;;;;;;;;;;;;;;;;;;;;;;;;;;;;;;;;;;;;;;;;;;;;;;;;;;;;;

CSEG

Albani - Arbelo Arrocha - Figueroa | 70 | 1.er cuatrimestre 2008

;;;;;;;;;;;;;;;;;;;;;;;;;;;;;;;;;;;;;;;;;;;;;;;;;;;;;;;;;;;;;;;;;;;;;;;;;;;;;;;; ;;;;;;;;;;;;;;;;;;;;;;;;;;;;;;;;;;;;;;;;;;;;;;;;;;;;;;;;;;;;;;;;;;;;;;;;;;;;;;;; TIMERS INIT:
;;;;;;;;;;;;;;;;;;;;;;;;;;;;;;;;;;;;;;;;;;;;;;;;;;;;;;;;;;;;;;;;;;;;;;;;;;;;;;;; ;;;;;;;;;;;;;;;;;;;;;;;;;;;;;;;;;;;;;;;;;;;;;;;;;;;;;;;;;;;;;;;;;;;;;;;;;;;;;;;; ;; Rutina de inicialización de timers. ;;;;;;;;;;;;;;;;;;;;;;;;;;;;;;;;;;;;;;;;;;;;;;;;;;;;;;;;;;;;;;;;;;;;;;;;;;;;;;;; ;;;;;;;;;;;;;;;;;;;;;;;;;;;;;;;;;;;;;;;;;;;;;;;;;;;;;;;;;;;;;;;;;;;;;;;;;;;;;;;; ;; Está pensada para ser llamada al momento de inicialización del sistema. ;;;;;;;;;;;;;;;;;;;;;;;;;;;;;;;;;;;;;;;;;;;;;;;;;;;;;;;;;;;;;;;;;;;;;;;;;;;;;;;; ;;;;;;;;;;;;;;;;;;;;;;;;;;;;;;;;;;;;;;;;;;;;;;;;;;;;;;;;;;;;;;;;;;;;;;;;;;;;;;;;
CLR | TR0 ; Por seguridad, se deshabilitan los 2 timers y sus
CLR | TR1
CLR | TF0 ; interrupciones asociadas.
CLR | TF1

; Se carga el valor inicial de la cuenta regresiva del Timer 0:
MOV | timer0 count down, #TIMER0 COUNT START

; Se inicializa el segundero:
MOV | timers seconds L, #0d
MOV | timers seconds H, #0d
MOV | timers msecs, #0d
MOV | TMOD, #00010001b ; Ambos en modo 16−bit.

; Se carga el iterador del Timer 0:
MOV | TL0, #LOW (−(1000d * TIMER0 BASE MS))
MOV | TH0, #HIGH(−(1000d * TIMER0 BASE MS))

; Se carga el iterador del Timer 1:
MOV | TL1, #LOW (−(1000d * TIMER1 BASE MS))
MOV | TH1, #HIGH(−(1000d * TIMER1 BASE MS))

; ON/OFF de los Timers y sus interrupciones asociadas:
CLR | ET0
CLR | ET1
CLR | TR0
CLR | TR1

RET
;;;;;;;;;;;;;;;;;;;;;;;;;;;;;;;;;;;;;;;;;;;;;;;;;;;;;;;;;;;;;;;;;;;;;;;;;;;;;;;; ;;;;;;;;;;;;;;;;;;;;;;;;;;;;;;;;;;;;;;;;;;;;;;;;;;;;;;;;;;;;;;;;;;;;;;;;;;;;;;;;

;;;;;;;;;;;;;;;;;;;;;;;;;;;;;;;;;;;;;;;;;;;;;;;;;;;;;;;;;;;;;;;;;;;;;;;;;;;;;;;; ;;;;;;;;;;;;;;;;;;;;;;;;;;;;;;;;;;;;;;;;;;;;;;;;;;;;;;;;;;;;;;;;;;;;;;;;;;;;;;;; TIMERS T0ISR:
;;;;;;;;;;;;;;;;;;;;;;;;;;;;;;;;;;;;;;;;;;;;;;;;;;;;;;;;;;;;;;;;;;;;;;;;;;;;;;;; ;;;;;;;;;;;;;;;;;;;;;;;;;;;;;;;;;;;;;;;;;;;;;;;;;;;;;;;;;;;;;;;;;;;;;;;;;;;;;;;; ;; Rutina de servicio de la interrupción del overflow del Timer 0. ;;;;;;;;;;;;;;;;;;;;;;;;;;;;;;;;;;;;;;;;;;;;;;;;;;;;;;;;;;;;;;;;;;;;;;;;;;;;;;;; ;;;;;;;;;;;;;;;;;;;;;;;;;;;;;;;;;;;;;;;;;;;;;;;;;;;;;;;;;;;;;;;;;;;;;;;;;;;;;;;; ;; Se dispara en intervalos de duración dictados por TIMER0 BASE MS.
;;
;; En cada llamada, decrementa la cuenta regresiva (timer0 count down)
;; para saber cuando incrementar a las variables que almacenan la cantidad ;; de segundos pasados desde que el timer 0 fue puesto funcionar.
;;
;; Registros afectados:
;; −−−−−−−−−−−−−−−−−−−
;; | timer0 count down
;; | timers seconds L
;; | timers seconds H
;;
;;;;;;;;;;;;;;;;;;;;;;;;;;;;;;;;;;;;;;;;;;;;;;;;;;;;;;;;;;;;;;;;;;;;;;;;;;;;;;;;
Albani - Arbelo Arrocha - Figueroa | 71 | 1.er cuatrimestre 2008

;;;;;;;;;;;;;;;;;;;;;;;;;;;;;;;;;;;;;;;;;;;;;;;;;;;;;;;;;;;;;;;;;;;;;;;;;;;;;;;;
CLR | TR0 ; Se detiene a si mismo antes de la recarga.

; Recarga del timer:
; Se suma la cantidad de ciclos de máquina de la rutina ; para aumentar la precisión.
MOV | TL0, #LOW (−(1000d * TIMER0 BASE MS) + 8d)
MOV | TH0, #HIGH(−(1000d * TIMER0 BASE MS) + 8d)

; Se decrementa la cuenta regresiva del segundero:
DJNZ | timer0 count down, TIMERS T0ISR END
; Si la cuenta llegó a cero, hay que incrementar un segundo.
PUSH | PSW | ; Se salva porque se necesita usar el Carry.

; Se utiliza XCH para evitar usar PUSH/POP y para ahorrar un MOV:
XCH | A, timers seconds L
ADD | A, #1d | ; No se usa INC pues no informa sobre overflows.

; Si C = 1 hubo overflow 255 −> 0, entonces
; hay que incrementar también al byte alto:
JNC | TIMERS T0ISR NO OV
INC | timers seconds H
TIMERS T0ISR NO OV:
XCH | A, timers seconds L ; Se restauran las variables.
POP | PSW

; Se reinicia la cuenta regresiva:
MOV | timer0 count down, #TIMER0 COUNT START

TIMERS T0ISR END:
SETB | TR0 ; Se enciende a si mismo nuevamente.
RETI
;;;;;;;;;;;;;;;;;;;;;;;;;;;;;;;;;;;;;;;;;;;;;;;;;;;;;;;;;;;;;;;;;;;;;;;;;;;;;;;; ;;;;;;;;;;;;;;;;;;;;;;;;;;;;;;;;;;;;;;;;;;;;;;;;;;;;;;;;;;;;;;;;;;;;;;;;;;;;;;;;

;;;;;;;;;;;;;;;;;;;;;;;;;;;;;;;;;;;;;;;;;;;;;;;;;;;;;;;;;;;;;;;;;;;;;;;;;;;;;;;; ;;;;;;;;;;;;;;;;;;;;;;;;;;;;;;;;;;;;;;;;;;;;;;;;;;;;;;;;;;;;;;;;;;;;;;;;;;;;;;;; TIMERS T1ISR:
;;;;;;;;;;;;;;;;;;;;;;;;;;;;;;;;;;;;;;;;;;;;;;;;;;;;;;;;;;;;;;;;;;;;;;;;;;;;;;;; ;;;;;;;;;;;;;;;;;;;;;;;;;;;;;;;;;;;;;;;;;;;;;;;;;;;;;;;;;;;;;;;;;;;;;;;;;;;;;;;; ;; Rutina de servicio de la interrupción del overflow del Timer 1. ;;;;;;;;;;;;;;;;;;;;;;;;;;;;;;;;;;;;;;;;;;;;;;;;;;;;;;;;;;;;;;;;;;;;;;;;;;;;;;;; ;;;;;;;;;;;;;;;;;;;;;;;;;;;;;;;;;;;;;;;;;;;;;;;;;;;;;;;;;;;;;;;;;;;;;;;;;;;;;;;; ;; Se dispara en intervalos de duración dictados por TIMER1 BASE MS.
;;
;; Registros afectados:
;; −−−−−−−−−−−−−−−−−−−
;; | timers msec
;;
;;;;;;;;;;;;;;;;;;;;;;;;;;;;;;;;;;;;;;;;;;;;;;;;;;;;;;;;;;;;;;;;;;;;;;;;;;;;;;;; ;;;;;;;;;;;;;;;;;;;;;;;;;;;;;;;;;;;;;;;;;;;;;;;;;;;;;;;;;;;;;;;;;;;;;;;;;;;;;;;;

; Se detiene a si mismo antes de la recarga:
CLR | TR1

; Recarga del timer:
; Se suma la cantidad de ciclos de máquina de la rutina ; para aumentar la precisión.
MOV | TL1, #LOW (−(1000d * TIMER1 BASE MS) + 7d)
MOV | TH1, #HIGH(−(1000d * TIMER1 BASE MS) + 7d)
INC | timers msecs

TIMERS T1ISR END:

Albani - Arbelo Arrocha - Figueroa | 72 | 1.er cuatrimestre 2008

; Se enciende a si mismo nuevamente:
SETB | TR1
RETI
;;;;;;;;;;;;;;;;;;;;;;;;;;;;;;;;;;;;;;;;;;;;;;;;;;;;;;;;;;;;;;;;;;;;;;;;;;;;;;;; ;;;;;;;;;;;;;;;;;;;;;;;;;;;;;;;;;;;;;;;;;;;;;;;;;;;;;;;;;;;;;;;;;;;;;;;;;;;;;;;;

;;;;;;;;;;;;;;;;;;;;;;;;;;;;;;;;;;;;;;;;;;;;;;;;;;;;;;;;;;;;;;;;;;;;;;;;;;;;;;;; ;;;;;;;;;;;;;;;;;;;;;;;;;;;;;;;;;;;;;;;;;;;;;;;;;;;;;;;;;;;;;;;;;;;;;;;;;;;;;;;; TIMERS START SECONDS CRON: ;;;;;;;;;;;;;;;;;;;;;;;;;;;;;;;;;;;;;;;;;;;;;;;;;;;;;;;;;;;;;;;;;;;;;;;;;;;;;;;; ;;;;;;;;;;;;;;;;;;;;;;;;;;;;;;;;;;;;;;;;;;;;;;;;;;;;;;;;;;;;;;;;;;;;;;;;;;;;;;;; ;; Rutina de iniciación del cronómetro de segundos. ;;;;;;;;;;;;;;;;;;;;;;;;;;;;;;;;;;;;;;;;;;;;;;;;;;;;;;;;;;;;;;;;;;;;;;;;;;;;;;;; ;;;;;;;;;;;;;;;;;;;;;;;;;;;;;;;;;;;;;;;;;;;;;;;;;;;;;;;;;;;;;;;;;;;;;;;;;;;;;;;; ;; Al ser llamada, reinicia el segundero de dos bytes, habilita al Timer 0 y ;; su interrupción asociada.
;;
;; Registros posiblemente afectados:
;; −−−−−−−−−−−−−−−−−−−−−−−−−−−−−−−−
; | timer0 count down | <− #TIMER0 COUNT START
;; | timers seconds L | <− 0
;; | timers seconds H | <− 0
;;;;;;;;;;;;;;;;;;;;;;;;;;;;;;;;;;;;;;;;;;;;;;;;;;;;;;;;;;;;;;;;;;;;;;;;;;;;;;;; ;;;;;;;;;;;;;;;;;;;;;;;;;;;;;;;;;;;;;;;;;;;;;;;;;;;;;;;;;;;;;;;;;;;;;;;;;;;;;;;; ; Se deshabilita temporalmente al Timer 0 y su interrupción asociada:
CLR | ET0
CLR | TR0

; Reiniciación de valores:
MOV | timer0 count down, #TIMER0 COUNT START
MOV | timers seconds L, #0d
MOV | timers seconds H, #0d
MOV | TL0, #LOW (−(1000d * TIMER0 BASE MS))
MOV | TH0, #HIGH(−(1000d * TIMER0 BASE MS))

; Se habilita al Timer 0 y su interrupción asociada:
SETB | ET0
SETB | TR0
RET
;;;;;;;;;;;;;;;;;;;;;;;;;;;;;;;;;;;;;;;;;;;;;;;;;;;;;;;;;;;;;;;;;;;;;;;;;;;;;;;; ;;;;;;;;;;;;;;;;;;;;;;;;;;;;;;;;;;;;;;;;;;;;;;;;;;;;;;;;;;;;;;;;;;;;;;;;;;;;;;;;

;;;;;;;;;;;;;;;;;;;;;;;;;;;;;;;;;;;;;;;;;;;;;;;;;;;;;;;;;;;;;;;;;;;;;;;;;;;;;;;; ;;;;;;;;;;;;;;;;;;;;;;;;;;;;;;;;;;;;;;;;;;;;;;;;;;;;;;;;;;;;;;;;;;;;;;;;;;;;;;;; TIMERS STOP SECONDS CRON:
;;;;;;;;;;;;;;;;;;;;;;;;;;;;;;;;;;;;;;;;;;;;;;;;;;;;;;;;;;;;;;;;;;;;;;;;;;;;;;;; ;;;;;;;;;;;;;;;;;;;;;;;;;;;;;;;;;;;;;;;;;;;;;;;;;;;;;;;;;;;;;;;;;;;;;;;;;;;;;;;; ;; Rutina de detención del cronómetro de segundos. ;;;;;;;;;;;;;;;;;;;;;;;;;;;;;;;;;;;;;;;;;;;;;;;;;;;;;;;;;;;;;;;;;;;;;;;;;;;;;;;; ;;;;;;;;;;;;;;;;;;;;;;;;;;;;;;;;;;;;;;;;;;;;;;;;;;;;;;;;;;;;;;;;;;;;;;;;;;;;;;;; ;; Al ser llamada, detiene al Timer 0 y su interrupción asociada. ;;;;;;;;;;;;;;;;;;;;;;;;;;;;;;;;;;;;;;;;;;;;;;;;;;;;;;;;;;;;;;;;;;;;;;;;;;;;;;;; ; Se deshabilita temporalmente al Timer 0 y su interrupción asociada:
CLR | ET0
CLR | TR0
RET
;;;;;;;;;;;;;;;;;;;;;;;;;;;;;;;;;;;;;;;;;;;;;;;;;;;;;;;;;;;;;;;;;;;;;;;;;;;;;;;; ;;;;;;;;;;;;;;;;;;;;;;;;;;;;;;;;;;;;;;;;;;;;;;;;;;;;;;;;;;;;;;;;;;;;;;;;;;;;;;;;

;;;;;;;;;;;;;;;;;;;;;;;;;;;;;;;;;;;;;;;;;;;;;;;;;;;;;;;;;;;;;;;;;;;;;;;;;;;;;;;; ;;;;;;;;;;;;;;;;;;;;;;;;;;;;;;;;;;;;;;;;;;;;;;;;;;;;;;;;;;;;;;;;;;;;;;;;;;;;;;;; TIMERS START MSECS CRON:
;;;;;;;;;;;;;;;;;;;;;;;;;;;;;;;;;;;;;;;;;;;;;;;;;;;;;;;;;;;;;;;;;;;;;;;;;;;;;;;;
Albani - Arbelo Arrocha - Figueroa | 73 | 1.er cuatrimestre 2008

;;;;;;;;;;;;;;;;;;;;;;;;;;;;;;;;;;;;;;;;;;;;;;;;;;;;;;;;;;;;;;;;;;;;;;;;;;;;;;;; ;; Rutina de iniciación del cronómetro de milisegundos. ;;;;;;;;;;;;;;;;;;;;;;;;;;;;;;;;;;;;;;;;;;;;;;;;;;;;;;;;;;;;;;;;;;;;;;;;;;;;;;;; ;;;;;;;;;;;;;;;;;;;;;;;;;;;;;;;;;;;;;;;;;;;;;;;;;;;;;;;;;;;;;;;;;;;;;;;;;;;;;;;; ;; Al ser llamada, reinicia el milisegundero, habilita al Timer 1 y
;; su interrupción asociada. ;;;;;;;;;;;;;;;;;;;;;;;;;;;;;;;;;;;;;;;;;;;;;;;;;;;;;;;;;;;;;;;;;;;;;;;;;;;;;;;; ;;;;;;;;;;;;;;;;;;;;;;;;;;;;;;;;;;;;;;;;;;;;;;;;;;;;;;;;;;;;;;;;;;;;;;;;;;;;;;;; ; Se deshabilita temporalmente al Timer 1 y su interrupción asociada:
CLR | ET1
CLR | TR1

; Reiniciación de valores:
MOV | timers msecs, #0d
MOV | TL1, #LOW (−(1000d * TIMER1 BASE MS))
MOV | TH1, #HIGH(−(1000d * TIMER1 BASE MS))

; Se habilita al Timer 1 y su interrupción asociada:
SETB | ET1
SETB | TR1
RET
;;;;;;;;;;;;;;;;;;;;;;;;;;;;;;;;;;;;;;;;;;;;;;;;;;;;;;;;;;;;;;;;;;;;;;;;;;;;;;;; ;;;;;;;;;;;;;;;;;;;;;;;;;;;;;;;;;;;;;;;;;;;;;;;;;;;;;;;;;;;;;;;;;;;;;;;;;;;;;;;;

;;;;;;;;;;;;;;;;;;;;;;;;;;;;;;;;;;;;;;;;;;;;;;;;;;;;;;;;;;;;;;;;;;;;;;;;;;;;;;;; ;;;;;;;;;;;;;;;;;;;;;;;;;;;;;;;;;;;;;;;;;;;;;;;;;;;;;;;;;;;;;;;;;;;;;;;;;;;;;;;; TIMERS STOP MSECS CRON:
;;;;;;;;;;;;;;;;;;;;;;;;;;;;;;;;;;;;;;;;;;;;;;;;;;;;;;;;;;;;;;;;;;;;;;;;;;;;;;;; ;;;;;;;;;;;;;;;;;;;;;;;;;;;;;;;;;;;;;;;;;;;;;;;;;;;;;;;;;;;;;;;;;;;;;;;;;;;;;;;; ;; Rutina de detención del cronómetro de milisegundos. ;;;;;;;;;;;;;;;;;;;;;;;;;;;;;;;;;;;;;;;;;;;;;;;;;;;;;;;;;;;;;;;;;;;;;;;;;;;;;;;; ;;;;;;;;;;;;;;;;;;;;;;;;;;;;;;;;;;;;;;;;;;;;;;;;;;;;;;;;;;;;;;;;;;;;;;;;;;;;;;;; ;; Al ser llamada, detiene al Timer 1 y su interrupción asociada. ;;;;;;;;;;;;;;;;;;;;;;;;;;;;;;;;;;;;;;;;;;;;;;;;;;;;;;;;;;;;;;;;;;;;;;;;;;;;;;;; ; Se deshabilita temporalmente al Timer 1 y su interrupción asociada:
CLR | ET1
CLR | TR1
RET
;;;;;;;;;;;;;;;;;;;;;;;;;;;;;;;;;;;;;;;;;;;;;;;;;;;;;;;;;;;;;;;;;;;;;;;;;;;;;;;; ;;;;;;;;;;;;;;;;;;;;;;;;;;;;;;;;;;;;;;;;;;;;;;;;;;;;;;;;;;;;;;;;;;;;;;;;;;;;;;;;
Albani - Arbelo Arrocha - Figueroa | 74 | 1.er cuatrimestre 2008

# 6.9. i18n-sp.asm

i18n Load sample:
DB | 'Cargue la muestra'
DB | 0

i18n Enter to continue:
DB | 'ENTER para continuar'
DB | 0

i18n Enter to accept:
DB | 'ENTER para aceptar'
DB | 0

i18n Enter to edit:
DB | 'Enter para editar'
DB | 0

i18n Esc to cancel:
DB | 'ESC para cancelar'
DB | 0

i18n Enter for edit:
DB | 'ENTER: editar'
DB | 0

i18n F1 for excute:
DB | 'F1: | realizar'
DB | 0

i18n DEL for delete:
DB | 'DEL: | eliminar'
DB | 0

i18n Reach preassure:
DB | 'Alcance la presion'
DB | 0

i18n Settling sample:
DB | 'Muestra en reposo'
DB | 0

i18n Charging capacitors:
DB | 'Cargando capacitores'
DB | 0

i18n Spark:
DB | 127d,'Spark!'
DB | 0

i18n Take sample:
DB | 'Retire la muestra'
DB | 0

i18n Loading data:
DB | 'Cargando datos...'
DB | 0

i18n Saving data:
DB | 'Guardando datos...'
DB | 0

i18n Title Confirm data:
DB | '−=Confirmar datos=−'
Albani - Arbelo Arrocha - Figueroa | 75 | 1.er cuatrimestre 2008

DB 0

i18n Erasing ROM:
DB | 'Borrando ROM'
DB | 0

i18n ROM erased:
DB | 'ROM borrada'
DB | 0

i18n Title Test nnn mmm:
DB | '−=ENSAYO nnn/mmm=−'
DB | 0

i18n All tests completed:
DB | 'Ensayos completados'
DB | 0

i18n Out of space:
DB | 'No hay mas espacio.'
DB | 0

i18n Voltage:
DB | 'Tension'
DB | 0

i18n Preassure:
DB | 'Presion'
DB | 0

i18n Settling time:
DB | 'T. reposo'
DB | 0

i18n Discharge time:
DB | 'T. descarga'
DB | 0

i18n Delete message A:
DB | 128d,'Intercambiar por el'
DB | 0
i18n Delete message B:
DB | 'ultimo de la lista?'
DB | 0
i18n Delete message C:
DB | '(y reducir la lista)'
DB | 0

i18n Updating data:
DB | 'Actualizando datos'
DB | 0

;;;;;;;;;;;;;;;;;;;;;;;;;;;;;;;;;;;;;;;;;;;;;;;;;;;;;;;;;;;;;;;;;;;;;;;;;;;;;;;; ;; Texto de los menús.
;;;;;;;;;;;;;;;;;;;;;;;;;;;;;;;;;;;;;;;;;;;;;;;;;;;;;;;;;;;;;;;;;;;;;;;;;;;;;;;; ;; Formato:
;; −−−−−−−
;; MENUS {NOMBRE DEL MENU} LABELS:
;; DB | 'TITULO' | , 0d
;; DB | 'OPCION 0', 0d
;; DB | 'OPCION 1', 0d
;; DB | 'OPCION 2', 0d
;; DB | 'OPCION 3', 0d
;; DB | 'OPCION 4', 0d
;; DB | 'OPCION 5', 0d
;; DB | MENUS EOM
Albani - Arbelo Arrocha - Figueroa | 76 | 1.er cuatrimestre 2008

;;
;; El título no puede superar los 20 caracteres.
;; Las opciones no pueden superar los 18 caracteres, pues se reservan los 2 ;; primeros para mostrar un indicador de selección.
;; Recordar que la pantalla tiene 8 páginas. De esta forma, se utiliza la ;; primera para el título, desde la segunda hasta la séptima para mostrar
;; un máximo de 6 opciones, y la última se reserva para un eventual mensaje
;; de ayuda.
;;;;;;;;;;;;;;;;;;;;;;;;;;;;;;;;;;;;;;;;;;;;;;;;;;;;;;;;;;;;;;;;;;;;;;;;;;;;;;;;

i18n Main menu labels:
DB | '−=MENU PRINCIPAL=−', 0d
DB | 'Anillo de ensayos', 0d
DB | 'Agregar ensayo', 0d
DB | 'Ejecutar todos', 0d
DB | 'Extras', 0d
DB | WIDGETS MENU EOM

i18n Edit menu labels:
DB | '−=EDITAR ENSAYO=−', 0d
DB | 'Tension de carga',0d
DB | 'Presion',0d
DB | 'Tiempo de reposo',0d
DB | 'Tiempo de descarga',0d
DB | 'Grabar ensayo',0d
DB | WIDGETS MENU EOM

;;;;;;;;;;;;;;;;;;;;;;;;;;;;;;;;;;;;;;;;;;;;;;;;;;;;;;;;;;;;;;;;;;;;;;;;;;;;;;;; ;;;;;;;;;;;;;;;;;;;;;;;;;;;;;;;;;;;;;;;;;;;;;;;;;;;;;;;;;;;;;;;;;;;;;;;;;;;;;;;;

Albani - Arbelo Arrocha - Figueroa | 77 | 1.er cuatrimestre 2008

# 6.10. widgets.asm

;;;;;;;;;;;;;;;;;;;;;;;;;;;;;;;;;;;;;;;;;;;;;;;;;;;;;;;;;;;;;;;;;;;;;;;;;;;;;;;; ;;;;;;;;;;;;;;;;;;;;;;;;;;;;;;;;;;;;;;;;;;;;;;;;;;;;;;;;;;;;;;;;;;;;;;;;;;;;;;;; ;; Rutinas para crear accesorios (widgets) en la pantalla, utilizando las
;; librerías de control específicas de display y teclado. ;;;;;;;;;;;;;;;;;;;;;;;;;;;;;;;;;;;;;;;;;;;;;;;;;;;;;;;;;;;;;;;;;;;;;;;;;;;;;;;; ;;;;;;;;;;;;;;;;;;;;;;;;;;;;;;;;;;;;;;;;;;;;;;;;;;;;;;;;;;;;;;;;;;;;;;;;;;;;;;;; ;;
;; Rutinas y macros públicas:
;; −−−−−−−−−−−−−−−−−−−−−−−−−
;; | WIDGETS MENU INTERACT
;; | WIDGETS PUT INT
;; | WIDGETS PROMPT
;; | WIDGETS PROGRESS BAR
;;
;;;;;;;;;;;;;;;;;;;;;;;;;;;;;;;;;;;;;;;;;;;;;;;;;;;;;;;;;;;;;;;;;;;;;;;;;;;;;;;; ;;;;;;;;;;;;;;;;;;;;;;;;;;;;;;;;;;;;;;;;;;;;;;;;;;;;;;;;;;;;;;;;;;;;;;;;;;;;;;;;

;;;;;;;;;;;;;;;;;;;;;;;;;;;;;;;;;;;;;;;;;;;;;;;;;;;;;;;;;;;;;;;;;;;;;;;;;;;;;;;; ;;;;;;;;;;;;;;;;;;;;;;;;;;;;;;;;;;;;;;;;;;;;;;;;;;;;;;;;;;;;;;;;;;;;;;;;;;;;;;;; ; Definiciones:
;;;;;;;;;;;;;;;;;;;;;;;;;;;;;;;;;;;;;;;;;;;;;;;;;;;;;;;;;;;;;;;;;;;;;;;;;;;;;;;; ;;;;;;;;;;;;;;;;;;;;;;;;;;;;;;;;;;;;;;;;;;;;;;;;;;;;;;;;;;;;;;;;;;;;;;;;;;;;;;;; ; El siguiente valor se utiliza para simbolizar el fin de un menú.
WIDGETS MENU EOM | EQU | 1d
;;;;;;;;;;;;;;;;;;;;;;;;;;;;;;;;;;;;;;;;;;;;;;;;;;;;;;;;;;;;;;;;;;;;;;;;;;;;;;;; ;;;;;;;;;;;;;;;;;;;;;;;;;;;;;;;;;;;;;;;;;;;;;;;;;;;;;;;;;;;;;;;;;;;;;;;;;;;;;;;;

;;;;;;;;;;;;;;;;;;;;;;;;;;;;;;;;;;;;;;;;;;;;;;;;;;;;;;;;;;;;;;;;;;;;;;;;;;;;;;;; ;;;;;;;;;;;;;;;;;;;;;;;;;;;;;;;;;;;;;;;;;;;;;;;;;;;;;;;;;;;;;;;;;;;;;;;;;;;;;;;; ; Macros:
;;;;;;;;;;;;;;;;;;;;;;;;;;;;;;;;;;;;;;;;;;;;;;;;;;;;;;;;;;;;;;;;;;;;;;;;;;;;;;;; ;;;;;;;;;;;;;;;;;;;;;;;;;;;;;;;;;;;;;;;;;;;;;;;;;;;;;;;;;;;;;;;;;;;;;;;;;;;;;;;;

;;;;;;;;;;;;;;;;;;;;;;;;;;;;;;;;;;;;;;;;;;;;;;;;;;;;;;;;;;;;;;;;;;;;;;;;;;;;;;;; ;; Simplifica la estructura necesaria para mostrar la representación decimal
;; de un número en pantalla. ;;;;;;;;;;;;;;;;;;;;;;;;;;;;;;;;;;;;;;;;;;;;;;;;;;;;;;;;;;;;;;;;;;;;;;;;;;;;;;;;
WIDGETS MACRO PUT INT | MACRO | numero L, numero H, pagina, columna
MOV | R2, numero L
MOV | R1, numero H
MOV | display page, #pagina
MOV | display column, #columna
CALL | WIDGETS PUT INT
ENDM
;;;;;;;;;;;;;;;;;;;;;;;;;;;;;;;;;;;;;;;;;;;;;;;;;;;;;;;;;;;;;;;;;;;;;;;;;;;;;;;; ;;;;;;;;;;;;;;;;;;;;;;;;;;;;;;;;;;;;;;;;;;;;;;;;;;;;;;;;;;;;;;;;;;;;;;;;;;;;;;;;

;;;;;;;;;;;;;;;;;;;;;;;;;;;;;;;;;;;;;;;;;;;;;;;;;;;;;;;;;;;;;;;;;;;;;;;;;;;;;;;; ;; Simplifica la estrucura necesaria para situar un prompt en pantalla y
;; obtener los 2 bytes del número ingresado. ;;;;;;;;;;;;;;;;;;;;;;;;;;;;;;;;;;;;;;;;;;;;;;;;;;;;;;;;;;;;;;;;;;;;;;;;;;;;;;;;
WIDGETS MACRO PROMPT | MACRO | destino L, destino H, pagina, columna
MOV | display page, #pagina
MOV | display column, #columna
CALL | WIDGETS PROMPT
MOV | destino L, widgets buffer
MOV | destino H, widgets buffer + 1d
ENDM
;;;;;;;;;;;;;;;;;;;;;;;;;;;;;;;;;;;;;;;;;;;;;;;;;;;;;;;;;;;;;;;;;;;;;;;;;;;;;;;; ;;;;;;;;;;;;;;;;;;;;;;;;;;;;;;;;;;;;;;;;;;;;;;;;;;;;;;;;;;;;;;;;;;;;;;;;;;;;;;;;
Albani - Arbelo Arrocha - Figueroa | 78 | 1.er cuatrimestre 2008

;;;;;;;;;;;;;;;;;;;;;;;;;;;;;;;;;;;;;;;;;;;;;;;;;;;;;;;;;;;;;;;;;;;;;;;;;;;;;;;; ;; Simplifica la estructura necesaria para construir una barra de progreso
;; a partir de un valor objetivo y un valor actual. ;;;;;;;;;;;;;;;;;;;;;;;;;;;;;;;;;;;;;;;;;;;;;;;;;;;;;;;;;;;;;;;;;;;;;;;;;;;;;;;;
WIDGETS MACRO PROGRESS BAR DIFF | MACRO | actual, objetivo, pagina
MOV | A, #255d
MOV | B, objetivo
DIV | AB
MOV | B, actual
MUL | AB
MOV | display page, #pagina
MOV | display data, A
CALL | WIDGETS PROGRESS BAR
ENDM
;;;;;;;;;;;;;;;;;;;;;;;;;;;;;;;;;;;;;;;;;;;;;;;;;;;;;;;;;;;;;;;;;;;;;;;;;;;;;;;; ;;;;;;;;;;;;;;;;;;;;;;;;;;;;;;;;;;;;;;;;;;;;;;;;;;;;;;;;;;;;;;;;;;;;;;;;;;;;;;;;

DSEG

;;;;;;;;;;;;;;;;;;;;;;;;;;;;;;;;;;;;;;;;;;;;;;;;;;;;;;;;;;;;;;;;;;;;;;;;;;;;;;;; ;;;;;;;;;;;;;;;;;;;;;;;;;;;;;;;;;;;;;;;;;;;;;;;;;;;;;;;;;;;;;;;;;;;;;;;;;;;;;;;; ; Variable para saber qué opción del menú está seleccionada:
widgets menu option: | DS | 1

; Variable para saber cuantas opciones tiene el menú mostrado:
widgets menu length: | DS | 1

; Variable para almacenar los 6 bytes necesarios en las conversiones de dígitos ; a bytes y viceversa:
widgets buffer: | DS | 6
;;;;;;;;;;;;;;;;;;;;;;;;;;;;;;;;;;;;;;;;;;;;;;;;;;;;;;;;;;;;;;;;;;;;;;;;;;;;;;;; ;;;;;;;;;;;;;;;;;;;;;;;;;;;;;;;;;;;;;;;;;;;;;;;;;;;;;;;;;;;;;;;;;;;;;;;;;;;;;;;;

CSEG

;;;;;;;;;;;;;;;;;;;;;;;;;;;;;;;;;;;;;;;;;;;;;;;;;;;;;;;;;;;;;;;;;;;;;;;;;;;;;;;; ;;;;;;;;;;;;;;;;;;;;;;;;;;;;;;;;;;;;;;;;;;;;;;;;;;;;;;;;;;;;;;;;;;;;;;;;;;;;;;;; WIDGETS SHOW MENU:
;;;;;;;;;;;;;;;;;;;;;;;;;;;;;;;;;;;;;;;;;;;;;;;;;;;;;;;;;;;;;;;;;;;;;;;;;;;;;;;; ;; Rutina para mostrar un menú en pantalla.
;; Está pensada para ser utilizada por WIDGETS MENU INTERACT. ;;;;;;;;;;;;;;;;;;;;;;;;;;;;;;;;;;;;;;;;;;;;;;;;;;;;;;;;;;;;;;;;;;;;;;;;;;;;;;;; ;;;;;;;;;;;;;;;;;;;;;;;;;;;;;;;;;;;;;;;;;;;;;;;;;;;;;;;;;;;;;;;;;;;;;;;;;;;;;;;; ;;
;; Depende de:
;; −−−−−−−−−−
;; | DISPLAY PUT STRING STATIC
;; | DISPLAY PUT CHAR
;;
;; Requisitos:
;; −−−−−−−−−−
;; | La dirección del texto del menú en DPTR.
;;
;; Registros alterados:
;; −−−−−−−−−−−−−−−−−−−
;; | display page
;; | display column
;; | widgets menu length
;; | A
;;
;;;;;;;;;;;;;;;;;;;;;;;;;;;;;;;;;;;;;;;;;;;;;;;;;;;;;;;;;;;;;;;;;;;;;;;;;;;;;;;;
Albani - Arbelo Arrocha - Figueroa | 79 | 1.er cuatrimestre 2008

; Primero se muestra el título (primera cadena).
MOV | display page, #0d
MOV | display column, #0d
CALL | DISPLAY PUT STRING STATIC
MOV | widgets menu length, #0d
INC | DPTR
INC | display page

WIDGETS SHOW MENU LOOP:
; Se muestran todas las opciones.
MOV | display column, #2d
CALL | DISPLAY PUT STRING STATIC
INC | DPTR
INC | display page
INC | widgets menu length
CLR | A
MOVC | A,@A+DPTR
; Hasta que se alzanza el fin del menú.
CJNE | A, #WIDGETS MENU EOM, WIDGETS SHOW MENU LOOP

; Finalmente se muestra el indicador de selección.
MOV | display page, widgets menu option
INC | display page
MOV | display column, #0d
MOV | DPTR, #CHR RIGHT ARROW
CALL | DISPLAY PUT CHAR

RET
;;;;;;;;;;;;;;;;;;;;;;;;;;;;;;;;;;;;;;;;;;;;;;;;;;;;;;;;;;;;;;;;;;;;;;;;;;;;;;;; ;;;;;;;;;;;;;;;;;;;;;;;;;;;;;;;;;;;;;;;;;;;;;;;;;;;;;;;;;;;;;;;;;;;;;;;;;;;;;;;;

;;;;;;;;;;;;;;;;;;;;;;;;;;;;;;;;;;;;;;;;;;;;;;;;;;;;;;;;;;;;;;;;;;;;;;;;;;;;;;;; ;;;;;;;;;;;;;;;;;;;;;;;;;;;;;;;;;;;;;;;;;;;;;;;;;;;;;;;;;;;;;;;;;;;;;;;;;;;;;;;; WIDGETS MENU INTERACT:
;;;;;;;;;;;;;;;;;;;;;;;;;;;;;;;;;;;;;;;;;;;;;;;;;;;;;;;;;;;;;;;;;;;;;;;;;;;;;;;; ;;;;;;;;;;;;;;;;;;;;;;;;;;;;;;;;;;;;;;;;;;;;;;;;;;;;;;;;;;;;;;;;;;;;;;;;;;;;;;;; ;; Rutina para mostrar un menú e interactuar con el teclado. ;;;;;;;;;;;;;;;;;;;;;;;;;;;;;;;;;;;;;;;;;;;;;;;;;;;;;;;;;;;;;;;;;;;;;;;;;;;;;;;; ;;
;; Depende de:
;; −−−−−−−−−−
;; | WIDGETS SHOW MENU
;; | DISPLAY CLEAR
;; | KEYPAD SCAN WAIT
;;
;; Requisitos:
;; −−−−−−−−−−
;; | La dirección del texto del menú en DPTR.
;;
;; Registros alterados:
;; −−−−−−−−−−−−−−−−−−−
;; | widgets menu option
;; | A
;;
;;;;;;;;;;;;;;;;;;;;;;;;;;;;;;;;;;;;;;;;;;;;;;;;;;;;;;;;;;;;;;;;;;;;;;;;;;;;;;;;

; El indicador de selección comienza siempre en la primera opción:
MOV | widgets menu option, #0d

WIDGETS MENU INTERACT REDRAW:
CALL | DISPLAY CLEAR
PUSH | DPL | ; Se salva DPTR pues WIDGETS SHOW MENU y KEYPAD SCAN WAIT
Albani - Arbelo Arrocha - Figueroa | 80 | 1.er cuatrimestre 2008

PUSH | DPH | ; lo alteran.

; Se llama a la rutina que muestra las opciones en pantalla con
; el indicador de selección al lado del elemento del menú seleccionado:
CALL | WIDGETS SHOW MENU
CALL | KEYPAD SCAN WAIT
POP | DPH | ; Se recupera a DPTR.
POP | DPL

; La estructura siguiente es equivalente a el típico SWITCH ; de los lenguajes de nivel más alto.

; Switch (keypad pressed key):
MOV | A, keypad pressed key

; Case KEYPAD RIGHT:
CJNE | A, #KEYPAD RIGHT, ($+3+2)
SJMP | WIDGETS MENU INTERACT RIGHT
; Case KEYPAD LEFT:
CJNE | A, #KEYPAD LEFT, ($+3+2)
SJMP | WIDGETS MENU INTERACT LEFT
; Case KEYPAD ENTER:
CJNE | A, #KEYPAD ENTER, ($+3+2)
SJMP | WIDGETS MENU INTERACT ENTER
; Case KEYPAD ESC:
CJNE | A, #KEYPAD ESC, ($+3+2)
SJMP | WIDGETS MENU INTERACT ESC
; Default:
SJMP | WIDGETS MENU INTERACT REDRAW

; A continuación, se definen las acciones de las teclas especiales: WIDGETS MENU INTERACT RIGHT:
; Si se presiona esta tecla, hay que seleccionar a la opción de abajo.
INC | widgets menu option
MOV | A, widgets menu option

; Si no se alcanzó a la última opción, se vuelve a dibujar el menú ; pero con la selección incrementada:
CJNE | A, widgets menu length, WIDGETS MENU INTERACT REDRAW

; Si se alcanzó el final, se vuelve hacia arriba (topología circular).
MOV | widgets menu option, #0d
SJMP | WIDGETS MENU INTERACT REDRAW
WIDGETS MENU INTERACT LEFT:
; Si se presiona esta tecla, hay que seleccionar a la opción de abajo.
DEC | widgets menu option
MOV | A, widgets menu option

; Si no se alcanzó a la primera opción, se vuelve a dibujar el menú ; pero con la selección decrementada:
CJNE | A, #255d, WIDGETS MENU INTERACT REDRAW
; (Se compara contra 255d porque si se decrementa a 0 hay overflow.)

; Si se alcanzó el principio, reaparece por abajo (topología circular).
MOV | widgets menu option, widgets menu length
DEC | widgets menu option
SJMP | WIDGETS MENU INTERACT REDRAW

; Actualmente no hay necesidad de diferenciar si se abandona el menú ; con ENTER o ESC pues la rutina exterior se encarga de asignar a cada ; tecla una acción distinta.
WIDGETS MENU INTERACT ENTER:
WIDGETS MENU INTERACT ESC:
RET
;;;;;;;;;;;;;;;;;;;;;;;;;;;;;;;;;;;;;;;;;;;;;;;;;;;;;;;;;;;;;;;;;;;;;;;;;;;;;;;;
Albani - Arbelo Arrocha - Figueroa | 81 | 1.er cuatrimestre 2008

;;;;;;;;;;;;;;;;;;;;;;;;;;;;;;;;;;;;;;;;;;;;;;;;;;;;;;;;;;;;;;;;;;;;;;;;;;;;;;;;

;;;;;;;;;;;;;;;;;;;;;;;;;;;;;;;;;;;;;;;;;;;;;;;;;;;;;;;;;;;;;;;;;;;;;;;;;;;;;;;; ;;;;;;;;;;;;;;;;;;;;;;;;;;;;;;;;;;;;;;;;;;;;;;;;;;;;;;;;;;;;;;;;;;;;;;;;;;;;;;;; WIDGETS PUT INT:
;;;;;;;;;;;;;;;;;;;;;;;;;;;;;;;;;;;;;;;;;;;;;;;;;;;;;;;;;;;;;;;;;;;;;;;;;;;;;;;; ;;;;;;;;;;;;;;;;;;;;;;;;;;;;;;;;;;;;;;;;;;;;;;;;;;;;;;;;;;;;;;;;;;;;;;;;;;;;;;;; ;; Rutina para mostrar en pantalla un número entero
;; representable por 1 o 2 bytes. Si es de 1 byte, muestra 3 dígitos;
;; si es de 2, muestra 5.
;;;;;;;;;;;;;;;;;;;;;;;;;;;;;;;;;;;;;;;;;;;;;;;;;;;;;;;;;;;;;;;;;;;;;;;;;;;;;;;; ;;;;;;;;;;;;;;;;;;;;;;;;;;;;;;;;;;;;;;;;;;;;;;;;;;;;;;;;;;;;;;;;;;;;;;;;;;;;;;;; ;;
;; Depende de:
;; −−−−−−−−−−
;; | HEX2ASCII
;; | DISPLAY PUT STRING DYNAMIC
;;
;; Requisitos:
;; −−−−−−−−−−
;; | Parte baja del número en R2.
;; | Parte alta del número en R1.
;; | display column entre 0 y 19
;; | display page entre 0 y 7
;;
;; Registros alterados:
;; −−−−−−−−−−−−−−−−−−−
;; | A, B, R0
;; | widgets buffer
;;;;;;;;;;;;;;;;;;;;;;;;;;;;;;;;;;;;;;;;;;;;;;;;;;;;;;;;;;;;;;;;;;;;;;;;;;;;;;;;

; Se salva la parte alta para luego decidir si mostrar 3 o 5 dígitos:
MOV | A, R1
PUSH | Acc

; R2 <− parte baja.
; R1 <− parte alta.
CALL | HEX2ASCII

; Decenas de millares:
MOV | widgets buffer + 0d, R3
; Millares:
MOV | widgets buffer + 1d, R4
; Centenas:
MOV | widgets buffer + 2d, R5
; Decenas:
MOV | widgets buffer + 3d, R6
; Unidades
MOV | widgets buffer + 4d, R7

; Se apunta R0 al comienzo de la cadena y se la muestra en pantalla:

; Se recupera la parte alta:
POP | Acc
JNZ | WIDGETS PUT INT16
; Si es nula, sólo se deben mostrar los últimos 3:
MOV | R0, #(widgets buffer + 2d)
SJMP | WIDGETS PUT INT SHOW

; Si no es nula, se deben mostrar los 5 dígitos: WIDGETS PUT INT16:
MOV | R0, #(widgets buffer + 0d)

WIDGETS PUT INT SHOW:

Albani - Arbelo Arrocha - Figueroa | 82 | 1.er cuatrimestre 2008

; Se marca el fin de línea en el sexto byte del buffer:
MOV | widgets buffer + 5d, #0d
CALL | DISPLAY PUT STRING DYNAMIC

RET
;;;;;;;;;;;;;;;;;;;;;;;;;;;;;;;;;;;;;;;;;;;;;;;;;;;;;;;;;;;;;;;;;;;;;;;;;;;;;;;; ;;;;;;;;;;;;;;;;;;;;;;;;;;;;;;;;;;;;;;;;;;;;;;;;;;;;;;;;;;;;;;;;;;;;;;;;;;;;;;;;

;;;;;;;;;;;;;;;;;;;;;;;;;;;;;;;;;;;;;;;;;;;;;;;;;;;;;;;;;;;;;;;;;;;;;;;;;;;;;;;; ;;;;;;;;;;;;;;;;;;;;;;;;;;;;;;;;;;;;;;;;;;;;;;;;;;;;;;;;;;;;;;;;;;;;;;;;;;;;;;;; WIDGETS PROMPT:
;;;;;;;;;;;;;;;;;;;;;;;;;;;;;;;;;;;;;;;;;;;;;;;;;;;;;;;;;;;;;;;;;;;;;;;;;;;;;;;; ;;;;;;;;;;;;;;;;;;;;;;;;;;;;;;;;;;;;;;;;;;;;;;;;;;;;;;;;;;;;;;;;;;;;;;;;;;;;;;;; ;; Rutina para obtener un número desde el teclado.
;; Muestra un cursor y espera a que el usuario ingrese
;; un número y presione ENTER.
;; Permite borrar caracter por caracter. ;;;;;;;;;;;;;;;;;;;;;;;;;;;;;;;;;;;;;;;;;;;;;;;;;;;;;;;;;;;;;;;;;;;;;;;;;;;;;;;; ;;
;; Depende de:
;; −−−−−−−−−−
;; | DISPLAY PUT CHAR
;; | KEYPAD SCAN WAIT
;; | BCD2HEX
;; | DISPLAY PUT ASCII
;;
;; Requisitos:
;; −−−−−−−−−−
;; | display column entre 0 y 19
;; | display page entre 0 y 7
;;
;; Registros alterados:
;; −−−−−−−−−−−−−−−−−−−
;; | A, B, c
;; | R1
;; | widgets buffer + 0 <− parte baja del número ingresado.
;; | widgets buffer + 1 <− parte alta del número ingresado.
;; | widgets buffer + 2 <− 0
;; | widgets buffer + 3 <− 0
;; | widgets buffer + 4 <− 0
;;
;;;;;;;;;;;;;;;;;;;;;;;;;;;;;;;;;;;;;;;;;;;;;;;;;;;;;;;;;;;;;;;;;;;;;;;;;;;;;;;;

; Limpieza del buffer:
MOV | R1, #widgets buffer + 5
MOV | @R1, #0d
DEC | R1
MOV | @R1, #0d
DEC | R1
MOV | @R1, #0d
DEC | R1
MOV | @R1, #0d
DEC | R1
MOV | @R1, #0d
DEC | R1
MOV | @R1, #0d

; Se muestra un símbolo para guiar al usuario:
MOV | DPTR, #CHR 062
CALL | DISPLAY PUT CHAR
INC | display column

WIDGETS PROMPT CURSOR:

Albani - Arbelo Arrocha - Figueroa | 83 | 1.er cuatrimestre 2008

; Se muestra el cursor en la columna donde aparecerá el próximo dígito:
MOV | DPTR, #CHR CURSOR
CALL | DISPLAY PUT CHAR

WIDGETS PROMPT WAIT:
; Se espera la presión de alguna tecla:
CALL | KEYPAD SCAN WAIT

; Chequeo de teclas especiales:

; La estructura siguiente es equivalente a el típico SWITCH ; de los lenguajes de nivel más alto:

; Switch (keypad pressed key):
MOV | A, keypad pressed key

; Case KEYPAD ESC:
CJNE | A, #KEYPAD ESC, ($+5)
SJMP | WIDGETS PROMPT KEY ESC
; Case KEYPAD ENTER:
CJNE | A, #KEYPAD ENTER, ($+5)
SJMP | WIDGETS PROMPT KEY ENTER
; Case KEYPAD DEL:
CJNE | A, #KEYPAD DEL, ($+5)
SJMP | WIDGETS PROMPT KEY DEL
; Default:
SJMP | WIDGETS PROMPT KEY NUM

WIDGETS PROMPT KEY DEL:
; Chequea que no se encuentre en la primera posición:
MOV | A, R1
CJNE | R1, #widgets buffer, ($+3+2)
SJMP | WIDGETS PROMPT CURSOR

; Borra el cursor en la posición actual:
MOV | DPTR, #CHR 032
CALL | DISPLAY PUT CHAR
; Borra el último caracter:
DEC | display column
MOV | DPTR, #CHR 032
CALL | DISPLAY PUT CHAR
; Corrije el resultado:
MOV | @R1, #0d
DEC | R1
JMP | WIDGETS PROMPT CURSOR

WIDGETS PROMPT KEY ESC:

; Limpieza del buffer:
MOV | R1, #widgets buffer + 5
MOV | @R1, #0d
DEC | R1
MOV | @R1, #0d
DEC | R1
MOV | @R1, #0d
DEC | R1
MOV | @R1, #0d
DEC | R1
MOV | @R1, #0d
DEC | R1
MOV | @R1, #0d

RET

Albani - Arbelo Arrocha - Figueroa | 84 | 1.er cuatrimestre 2008

WIDGETS PROMPT KEY ENTER:
; La conversión es llevada a cabo por la rutina BCD2HEX.

; Se salva la información para poder recuperar el banco de registros:
PUSH | PSW
; Se alterna l banco de registros 1 para que BCD2HEX no altere al actual: MACRO SELECT BANK 1

; Pre−condiciones de la rutina de conversión:
; Decenas de millares:
MOV | R5, widgets buffer + 0d
; Millares
MOV | R4, widgets buffer + 1d
; Centenas:
MOV | R3, widgets buffer + 2d
; Decenas
MOV | R2, widgets buffer + 3d
; Unidades:
MOV | R1, widgets buffer + 4d
CALL | BCD2HEX
; BCD2HEX devuelve:
; R3 <− parte baja del byte. ; R2 <− parte alta del byte.
MOV | widgets buffer + 0d, R3
MOV | widgets buffer + 1d, R2

; Se recupera el banco de registros anterior:
POP | PSW
MOV | widgets buffer + 2d, #0d
MOV | widgets buffer + 3d, #0d
MOV | widgets buffer + 4d, #0d

RET

WIDGETS PROMPT KEY NUM:

; Chequea si se superó el límite de 5 dígitos (2−bytes): ; Salva al valor del acumulador:
XCH | A, B
; Calcula la diferencia entre la dirección base y
; la dirección a la que apunta R1:
MOV | A, R1
CLR | C
SUBB | A, #widgets buffer
; Si es 5, vuelve a la parte de espera de teclas:
CJNE | A, #5d, ($+3+3)
LJMP | WIDGETS PROMPT WAIT

; Si no es 5, entonces debe mostrar el nuevo dígito y ; actualizar el buffer:

; Recupera al acumulador salvado previamente:
XCH | A, B

; Se almacena el nuevo dígito en el buffer y se desplaza el puntero:
MOV | @R1, A
INC | R1
; Se suma el código ASCII del cero y se muestra en pantalla:
ADD | A, #'0'
MOV | display data, A
CALL | DISPLAY PUT ASCII

; Se incrementa la columna y se regresa a la espera de más dígitos:

Albani - Arbelo Arrocha - Figueroa | 85 | 1.er cuatrimestre 2008

INC | display column
JMP | WIDGETS PROMPT CURSOR

; La instrucción de retorno (RET) se alcanza en
; WIDGETS PROMPT KEY ENTER o WIDGETS PROMPT KEY ESC.

;;;;;;;;;;;;;;;;;;;;;;;;;;;;;;;;;;;;;;;;;;;;;;;;;;;;;;;;;;;;;;;;;;;;;;;;;;;;;;;; ;;;;;;;;;;;;;;;;;;;;;;;;;;;;;;;;;;;;;;;;;;;;;;;;;;;;;;;;;;;;;;;;;;;;;;;;;;;;;;;;

;;;;;;;;;;;;;;;;;;;;;;;;;;;;;;;;;;;;;;;;;;;;;;;;;;;;;;;;;;;;;;;;;;;;;;;;;;;;;;;; ;;;;;;;;;;;;;;;;;;;;;;;;;;;;;;;;;;;;;;;;;;;;;;;;;;;;;;;;;;;;;;;;;;;;;;;;;;;;;;;; WIDGETS PROGRESS BAR:
;;;;;;;;;;;;;;;;;;;;;;;;;;;;;;;;;;;;;;;;;;;;;;;;;;;;;;;;;;;;;;;;;;;;;;;;;;;;;;;; ;;;;;;;;;;;;;;;;;;;;;;;;;;;;;;;;;;;;;;;;;;;;;;;;;;;;;;;;;;;;;;;;;;;;;;;;;;;;;;;; ;; Rutina para mostrar una preciosa barra de progreso en pantalla,
;; con terminaciones cuidadosamente redondeadas.
;;
;; La longitud es de 64 píxeles y la posición es en el centro del display.
;; Sólo se puede especificar la página.
;;
;;;;;;;;;;;;;;;;;;;;;;;;;;;;;;;;;;;;;;;;;;;;;;;;;;;;;;;;;;;;;;;;;;;;;;;;;;;;;;;; ;;;;;;;;;;;;;;;;;;;;;;;;;;;;;;;;;;;;;;;;;;;;;;;;;;;;;;;;;;;;;;;;;;;;;;;;;;;;;;;; ;;
;; Depende de:
;; −−−−−−−−−−
;; | DISPLAY PUT BYTE
;;
;; Requisitos:
;; −−−−−−−−−−
;; | El "porcentaje" en display data. Rango: [0;255].
;; | 0 corresponde a | 0 %
;; | 255 corresponde a 100 %
;;
;; | display page entre 0 y 7
;;
;; Registros alterados:
;; −−−−−−−−−−−−−−−−−−−
;; | A, B, display column
;;;;;;;;;;;;;;;;;;;;;;;;;;;;;;;;;;;;;;;;;;;;;;;;;;;;;;;;;;;;;;;;;;;;;;;;;;;;;;;;

; Se salva pues se la necesta para DISPLAY PUT BYTE
; y no se desea que esta RUTINA pise al valor:
PUSH | display data

; Se divide por 4 porque la barra mide 64 píxeles:
MOV | A, display data
MOV | B, #4d
DIV | AB

; Se salva a A:
XCH | A, B

; Primero se dibuja el borde izquierdo:
MOV | display data, #00111100b
MOV | display column, #(63d − (64d / 2d))
CALL | DISPLAY PUT BYTE

; Se recupera a A:
MOV | A, B
; Si es 0, entonces sólo resta dibujar toda la barra vacía:
JZ | WIDGETS PROGRESS BAR 0
; Si no es 0, hay que dibujar la parte de la barra rellena:
MOV | display data, #01111110b
WIDGETS PROGRESS BAR LOOP 1:
; Este bucle dibuja la parte rellena.
Albani - Arbelo Arrocha - Figueroa | 86 | 1.er cuatrimestre 2008

CALL | DISPLAY PUT BYTE
DJNZ | B, WIDGETS PROGRESS BAR LOOP 1

; Si se alcanzó el final, no hace falta completar con una parte vacía:
MOV | A, display column
CJNE | A, #(64d + (64d / 2d)), ($+5)
SJMP | WIDGETS PROGRESS BAR 100

; Si no se alcanzó el final, hay que completar con la parte vacía: WIDGETS PROGRESS BAR 0:
MOV | display data, #01000010b
WIDGETS PROGRESS BAR LOOP 2:
; Este bucle dibuja la parte vacía.
CALL | DISPLAY PUT BYTE
MOV | A, display column
CJNE | A, #(64d + (64d / 2d)), WIDGETS PROGRESS BAR LOOP 2

; Finalmente, se dibuja el borde derecho:
WIDGETS PROGRESS BAR 100:
MOV | display data, #00111100b
CALL | DISPLAY PUT BYTE
POP | display data
RET
;;;;;;;;;;;;;;;;;;;;;;;;;;;;;;;;;;;;;;;;;;;;;;;;;;;;;;;;;;;;;;;;;;;;;;;;;;;;;;;; ;;;;;;;;;;;;;;;;;;;;;;;;;;;;;;;;;;;;;;;;;;;;;;;;;;;;;;;;;;;;;;;;;;;;;;;;;;;;;;;;
Albani - Arbelo Arrocha - Figueroa | 87 | 1.er cuatrimestre 2008

# 6.11. ensayos.asm

;;;;;;;;;;;;;;;;;;;;;;;;;;;;;;;;;;;;;;;;;;;;;;;;;;;;;;;;;;;;;;;;;;;;;;;;;;;;;;;; ;;;;;;;;;;;;;;;;;;;;;;;;;;;;;;;;;;;;;;;;;;;;;;;;;;;;;;;;;;;;;;;;;;;;;;;;;;;;;;;; ;; Rutinas para manipular ensayos. ;;;;;;;;;;;;;;;;;;;;;;;;;;;;;;;;;;;;;;;;;;;;;;;;;;;;;;;;;;;;;;;;;;;;;;;;;;;;;;;; ;;;;;;;;;;;;;;;;;;;;;;;;;;;;;;;;;;;;;;;;;;;;;;;;;;;;;;;;;;;;;;;;;;;;;;;;;;;;;;;;
;; | ENSAYOS CARGAR CONTEXTO
;; | ENSAYOS GRABAR CONTEXTO
;; | ENSAYOS CARGAR
;; | ENSAYOS GRABAR
;; | ENSAYOS REALIZAR SERIE
;; | ENSAYOS REALIZAR ACTUAL
;; | ENSAYOS ELIMINAR
;; | ENSAYOS CONVERTIR TENSION ADC2HUMAN
;; | ENSAYOS CONVERTIR TENSION HUMAN2ADC
;; | ENSAYOS CONVERTIR PRESION ADC2HUMAN
;; | ENSAYOS CONVERTIR PRESION HUMAN2ADC
;;
;;;;;;;;;;;;;;;;;;;;;;;;;;;;;;;;;;;;;;;;;;;;;;;;;;;;;;;;;;;;;;;;;;;;;;;;;;;;;;;; ;;;;;;;;;;;;;;;;;;;;;;;;;;;;;;;;;;;;;;;;;;;;;;;;;;;;;;;;;;;;;;;;;;;;;;;;;;;;;;;;

;;;;;;;;;;;;;;;;;;;;;;;;;;;;;;;;;;;;;;;;;;;;;;;;;;;;;;;;;;;;;;;;;;;;;;;;;;;;;;;; ;;;;;;;;;;;;;;;;;;;;;;;;;;;;;;;;;;;;;;;;;;;;;;;;;;;;;;;;;;;;;;;;;;;;;;;;;;;;;;;; ;; Definiciones:
;;;;;;;;;;;;;;;;;;;;;;;;;;;;;;;;;;;;;;;;;;;;;;;;;;;;;;;;;;;;;;;;;;;;;;;;;;;;;;;; ;;;;;;;;;;;;;;;;;;;;;;;;;;;;;;;;;;;;;;;;;;;;;;;;;;;;;;;;;;;;;;;;;;;;;;;;;;;;;;;; ; Dirección en memoria ROM del primer byte del primer ensayo:
ENSAYOS BASE ROM ADDRESS | EQU ((512d − 32d) * 64d)
; Se define a una distancia del final que permite almacenar hasta 255 ensayos ; de 8 bytes c/u y deja 8 bytes al final para guardar información de contexto.

; La dirección inmediatamente siguiente se reserva para 8 bytes de información ; de contexto:
ENSAYOS CONTEXTO ROM ADDRESS | EQU ENSAYOS BASE ROM ADDRESS + (255d* 8d)

; Puerto de conexión con el relay que permite
; la carga del banco de capacitores:
ENSAYOS RELAY BANCO CAPACITORES EQU | P3.2
; SETB para cerrar la llave, CLR para abrirla.

; Puerto de conexión con el relay que activa el circuito del tiristor:
ENSAYOS RELAY TIRISTOR | EQU | P3.4
; SETB para activar, CLR para desactivar. ;;;;;;;;;;;;;;;;;;;;;;;;;;;;;;;;;;;;;;;;;;;;;;;;;;;;;;;;;;;;;;;;;;;;;;;;;;;;;;;; ;;;;;;;;;;;;;;;;;;;;;;;;;;;;;;;;;;;;;;;;;;;;;;;;;;;;;;;;;;;;;;;;;;;;;;;;;;;;;;;;

;;;;;;;;;;;;;;;;;;;;;;;;;;;;;;;;;;;;;;;;;;;;;;;;;;;;;;;;;;;;;;;;;;;;;;;;;;;;;;;; ;;;;;;;;;;;;;;;;;;;;;;;;;;;;;;;;;;;;;;;;;;;;;;;;;;;;;;;;;;;;;;;;;;;;;;;;;;;;;;;; ;; Macros:
;;;;;;;;;;;;;;;;;;;;;;;;;;;;;;;;;;;;;;;;;;;;;;;;;;;;;;;;;;;;;;;;;;;;;;;;;;;;;;;; ;;;;;;;;;;;;;;;;;;;;;;;;;;;;;;;;;;;;;;;;;;;;;;;;;;;;;;;;;;;;;;;;;;;;;;;;;;;;;;;;

;;;;;;;;;;;;;;;;;;;;;;;;;;;;;;;;;;;;;;;;;;;;;;;;;;;;;;;;;;;;;;;;;;;;;;;;;;;;;;;; ;; Encapsula la lectura del canal del ADC conectado al punto de medición
;; de la tensión del banco de capacitores. ;;;;;;;;;;;;;;;;;;;;;;;;;;;;;;;;;;;;;;;;;;;;;;;;;;;;;;;;;;;;;;;;;;;;;;;;;;;;;;;;
ENSAYOS MACRO LEER TENSION | MACRO
ADC MACRO READ CHANNEL 0
MOV | ensayos adc tension, A
ENDM
;;;;;;;;;;;;;;;;;;;;;;;;;;;;;;;;;;;;;;;;;;;;;;;;;;;;;;;;;;;;;;;;;;;;;;;;;;;;;;;; ;;;;;;;;;;;;;;;;;;;;;;;;;;;;;;;;;;;;;;;;;;;;;;;;;;;;;;;;;;;;;;;;;;;;;;;;;;;;;;;;
Albani - Arbelo Arrocha - Figueroa | 88 | 1.er cuatrimestre 2008

;;;;;;;;;;;;;;;;;;;;;;;;;;;;;;;;;;;;;;;;;;;;;;;;;;;;;;;;;;;;;;;;;;;;;;;;;;;;;;;; ;; Encapsula la lectura del canal del ADC conectado al sensor de presión. ;;;;;;;;;;;;;;;;;;;;;;;;;;;;;;;;;;;;;;;;;;;;;;;;;;;;;;;;;;;;;;;;;;;;;;;;;;;;;;;;
ENSAYOS MACRO LEER PRESION | MACRO
ADC MACRO READ CHANNEL 1
MOV | ensayos adc presion, A
ENDM
;;;;;;;;;;;;;;;;;;;;;;;;;;;;;;;;;;;;;;;;;;;;;;;;;;;;;;;;;;;;;;;;;;;;;;;;;;;;;;;; ;;;;;;;;;;;;;;;;;;;;;;;;;;;;;;;;;;;;;;;;;;;;;;;;;;;;;;;;;;;;;;;;;;;;;;;;;;;;;;;;

DSEG

;;;;;;;;;;;;;;;;;;;;;;;;;;;;;;;;;;;;;;;;;;;;;;;;;;;;;;;;;;;;;;;;;;;;;;;;;;;;;;;; ;; Variables para almacenar los parámetros de un ensayo: ;;;;;;;;;;;;;;;;;;;;;;;;;;;;;;;;;;;;;;;;;;;;;;;;;;;;;;;;;;;;;;;;;;;;;;;;;;;;;;;;
ensayos tension: | DS | 1
ensayos presion: | DS | 1
ensayos tiempo reposo L: | DS | 1
ensayos tiempo reposo H: | DS | 1
ensayos tiempo descarga: | DS | 1
;;;;;;;;;;;;;;;;;;;;;;;;;;;;;;;;;;;;;;;;;;;;;;;;;;;;;;;;;;;;;;;;;;;;;;;;;;;;;;;;

;;;;;;;;;;;;;;;;;;;;;;;;;;;;;;;;;;;;;;;;;;;;;;;;;;;;;;;;;;;;;;;;;;;;;;;;;;;;;;;; ;; Variables para almacenar la información de contexto: ;;;;;;;;;;;;;;;;;;;;;;;;;;;;;;;;;;;;;;;;;;;;;;;;;;;;;;;;;;;;;;;;;;;;;;;;;;;;;;;;
ensayos actual: | DS | 1 | ; Rango [0;255]
; Significado: indicador del ensayo seleccionado. El primer ensayo de la lista ; se identifica con 0.
ensayos ultimo: | DS | 1 | ; Rango [0;255]
; Significado: indicador del último ensayo cargado y válido. ;;;;;;;;;;;;;;;;;;;;;;;;;;;;;;;;;;;;;;;;;;;;;;;;;;;;;;;;;;;;;;;;;;;;;;;;;;;;;;;;

;;;;;;;;;;;;;;;;;;;;;;;;;;;;;;;;;;;;;;;;;;;;;;;;;;;;;;;;;;;;;;;;;;;;;;;;;;;;;;;; ;; Variables auxiliares para almacenar las lecturas del ADC:
ensayos adc tension: | DS | 1
ensayos adc presion: | DS | 1
;;;;;;;;;;;;;;;;;;;;;;;;;;;;;;;;;;;;;;;;;;;;;;;;;;;;;;;;;;;;;;;;;;;;;;;;;;;;;;;;

CSEG

;;;;;;;;;;;;;;;;;;;;;;;;;;;;;;;;;;;;;;;;;;;;;;;;;;;;;;;;;;;;;;;;;;;;;;;;;;;;;;;; ;;;;;;;;;;;;;;;;;;;;;;;;;;;;;;;;;;;;;;;;;;;;;;;;;;;;;;;;;;;;;;;;;;;;;;;;;;;;;;;; ENSAYOS MOSTRAR CABECERA:
;;;;;;;;;;;;;;;;;;;;;;;;;;;;;;;;;;;;;;;;;;;;;;;;;;;;;;;;;;;;;;;;;;;;;;;;;;;;;;;; ;;;;;;;;;;;;;;;;;;;;;;;;;;;;;;;;;;;;;;;;;;;;;;;;;;;;;;;;;;;;;;;;;;;;;;;;;;;;;;;; ;; Muestra en la primera página del display una cadena de la forma:
;; | −=ENSAYO 002/015=−
;;;;;;;;;;;;;;;;;;;;;;;;;;;;;;;;;;;;;;;;;;;;;;;;;;;;;;;;;;;;;;;;;;;;;;;;;;;;;;;;
DISPLAY MACRO PUT STRING STATIC | i18n Title Test nnn mmm, | 0d, 1d
WIDGETS MACRO PUT INT | ensayos actual, #0d, | 0d, 10d
WIDGETS MACRO PUT INT | ensayos ultimo, #0d, | 0d, 14d
RET
;;;;;;;;;;;;;;;;;;;;;;;;;;;;;;;;;;;;;;;;;;;;;;;;;;;;;;;;;;;;;;;;;;;;;;;;;;;;;;;; ;;;;;;;;;;;;;;;;;;;;;;;;;;;;;;;;;;;;;;;;;;;;;;;;;;;;;;;;;;;;;;;;;;;;;;;;;;;;;;;;

;;;;;;;;;;;;;;;;;;;;;;;;;;;;;;;;;;;;;;;;;;;;;;;;;;;;;;;;;;;;;;;;;;;;;;;;;;;;;;;; ;;;;;;;;;;;;;;;;;;;;;;;;;;;;;;;;;;;;;;;;;;;;;;;;;;;;;;;;;;;;;;;;;;;;;;;;;;;;;;;; ENSAYOS CARGAR CONTEXTO:
;;;;;;;;;;;;;;;;;;;;;;;;;;;;;;;;;;;;;;;;;;;;;;;;;;;;;;;;;;;;;;;;;;;;;;;;;;;;;;;;
Albani - Arbelo Arrocha - Figueroa | 89 | 1.er cuatrimestre 2008

;;;;;;;;;;;;;;;;;;;;;;;;;;;;;;;;;;;;;;;;;;;;;;;;;;;;;;;;;;;;;;;;;;;;;;;;;;;;;;;; ;; Carga desde la ROM la información de contexto. ;;;;;;;;;;;;;;;;;;;;;;;;;;;;;;;;;;;;;;;;;;;;;;;;;;;;;;;;;;;;;;;;;;;;;;;;;;;;;;;;
MOV | rom address L, | #LOW(ENSAYOS CONTEXTO ROM ADDRESS)
MOV | rom address H, #HIGH(ENSAYOS CONTEXTO ROM ADDRESS)

; Se salva PSW para poder luego volver al banco de registros correcto:
PUSH | PSW

; Se selecciona el banco de registros 3:
MACRO SELECT BANK 3

; La siguiente rutina lee 8 bytes y los devuelve en el banco seleccionado:
CALL | ROM READ TO BANK

; A continuación se obtienen los valores:
MOV | ensayos ultimo, | R0
; (actualmente sólo se usa el primer byte para almacenar a ensayos ultimo)

; Se recupera PSW para dejar seleccionado al banco de registros correcto:
POP | PSW
RET
;;;;;;;;;;;;;;;;;;;;;;;;;;;;;;;;;;;;;;;;;;;;;;;;;;;;;;;;;;;;;;;;;;;;;;;;;;;;;;;; ;;;;;;;;;;;;;;;;;;;;;;;;;;;;;;;;;;;;;;;;;;;;;;;;;;;;;;;;;;;;;;;;;;;;;;;;;;;;;;;;

;;;;;;;;;;;;;;;;;;;;;;;;;;;;;;;;;;;;;;;;;;;;;;;;;;;;;;;;;;;;;;;;;;;;;;;;;;;;;;;; ;;;;;;;;;;;;;;;;;;;;;;;;;;;;;;;;;;;;;;;;;;;;;;;;;;;;;;;;;;;;;;;;;;;;;;;;;;;;;;;; ENSAYOS GRABAR CONTEXTO:
;;;;;;;;;;;;;;;;;;;;;;;;;;;;;;;;;;;;;;;;;;;;;;;;;;;;;;;;;;;;;;;;;;;;;;;;;;;;;;;; ;;;;;;;;;;;;;;;;;;;;;;;;;;;;;;;;;;;;;;;;;;;;;;;;;;;;;;;;;;;;;;;;;;;;;;;;;;;;;;;; ;; Graba en memoria ROM todas las variables de contexto: ;;;;;;;;;;;;;;;;;;;;;;;;;;;;;;;;;;;;;;;;;;;;;;;;;;;;;;;;;;;;;;;;;;;;;;;;;;;;;;;;
MOV | rom address L, | #LOW(ENSAYOS CONTEXTO ROM ADDRESS)
MOV | rom address H, #HIGH(ENSAYOS CONTEXTO ROM ADDRESS)

; Se salva PSW para poder luego volver al banco de registros correcto:
PUSH | PSW

; Se selecciona el banco de registros 3:
MACRO SELECT BANK 3

; (actualmente sólo se usa el primer byte para almacenar a ensayos ultimo)
MOV | R0, ensayos ultimo

; Se llama a la rutina que guarda en memoria ROM
; los 8 bytes del banco de registros seleccionado:
CALL | ROM WRITE FROM BANK

; Se recupera PSW para dejar seleccionado al banco de registros correcto:
POP | PSW
RET
;;;;;;;;;;;;;;;;;;;;;;;;;;;;;;;;;;;;;;;;;;;;;;;;;;;;;;;;;;;;;;;;;;;;;;;;;;;;;;;; ;;;;;;;;;;;;;;;;;;;;;;;;;;;;;;;;;;;;;;;;;;;;;;;;;;;;;;;;;;;;;;;;;;;;;;;;;;;;;;;;

;;;;;;;;;;;;;;;;;;;;;;;;;;;;;;;;;;;;;;;;;;;;;;;;;;;;;;;;;;;;;;;;;;;;;;;;;;;;;;;; ;;;;;;;;;;;;;;;;;;;;;;;;;;;;;;;;;;;;;;;;;;;;;;;;;;;;;;;;;;;;;;;;;;;;;;;;;;;;;;;; ENSAYOS CARGAR:
;;;;;;;;;;;;;;;;;;;;;;;;;;;;;;;;;;;;;;;;;;;;;;;;;;;;;;;;;;;;;;;;;;;;;;;;;;;;;;;; ;;;;;;;;;;;;;;;;;;;;;;;;;;;;;;;;;;;;;;;;;;;;;;;;;;;;;;;;;;;;;;;;;;;;;;;;;;;;;;;; ;; Obtiene de memoria ROM a los parámetros del ensayo seleccionado: ;;;;;;;;;;;;;;;;;;;;;;;;;;;;;;;;;;;;;;;;;;;;;;;;;;;;;;;;;;;;;;;;;;;;;;;;;;;;;;;;

; La dirección se obtiene mediante la siguiente aritmética:

Albani - Arbelo Arrocha - Figueroa | 90 | 1.er cuatrimestre 2008

; Cada ensayo ocupa 8 bytes:
MOV | A, #8d
MOV | B, ensayos actual
; Multiplicando se obtiene la dirección del primer byte del ensayo actual:
MUL | AB

; Se suma ese offset a la dirección base de los ensayos:

ADD | A, #LOW(ENSAYOS BASE ROM ADDRESS)
MOV | rom address L, A
MOV | A, B
ADDC | A, #HIGH(ENSAYOS BASE ROM ADDRESS)
MOV | rom address H, A

; Se salva PSW para poder luego volver al banco de registros correcto:
PUSH | PSW

; Se selecciona el banco de registros 3:
MACRO SELECT BANK 3

; La siguiente rutina lee 8 bytes y los devuelve en el banco seleccionado:
CALL | ROM READ TO BANK
MOV | ensayos tension, | R0
MOV | ensayos presion, | R1
MOV | ensayos tiempo reposo L, | R2
MOV | ensayos tiempo reposo H, | R3
MOV | ensayos tiempo descarga, | R4

; Se recupera PSW para dejar seleccionado al banco de registros correcto:
POP | PSW
RET
;;;;;;;;;;;;;;;;;;;;;;;;;;;;;;;;;;;;;;;;;;;;;;;;;;;;;;;;;;;;;;;;;;;;;;;;;;;;;;;; ;;;;;;;;;;;;;;;;;;;;;;;;;;;;;;;;;;;;;;;;;;;;;;;;;;;;;;;;;;;;;;;;;;;;;;;;;;;;;;;;

;;;;;;;;;;;;;;;;;;;;;;;;;;;;;;;;;;;;;;;;;;;;;;;;;;;;;;;;;;;;;;;;;;;;;;;;;;;;;;;; ;;;;;;;;;;;;;;;;;;;;;;;;;;;;;;;;;;;;;;;;;;;;;;;;;;;;;;;;;;;;;;;;;;;;;;;;;;;;;;;; ENSAYOS GRABAR:
;;;;;;;;;;;;;;;;;;;;;;;;;;;;;;;;;;;;;;;;;;;;;;;;;;;;;;;;;;;;;;;;;;;;;;;;;;;;;;;; ;;;;;;;;;;;;;;;;;;;;;;;;;;;;;;;;;;;;;;;;;;;;;;;;;;;;;;;;;;;;;;;;;;;;;;;;;;;;;;;; ;; Graba en memoria ROM a los parámetros del ensayo seleccionado: ;;;;;;;;;;;;;;;;;;;;;;;;;;;;;;;;;;;;;;;;;;;;;;;;;;;;;;;;;;;;;;;;;;;;;;;;;;;;;;;; ; La dirección se obtiene mediante la siguiente aritmética:

; Cada ensayo ocupa 8 bytes:
MOV | A, #8d
MOV | B, ensayos actual
; Multiplicando se obtiene la dirección del primer byte del ensayo actual:
MUL | AB

; Se suma ese offset a la dirección base de los ensayos:

ADD | A, #LOW(ENSAYOS BASE ROM ADDRESS)
MOV | rom address L, A
MOV | A, B
ADDC | A, #HIGH(ENSAYOS BASE ROM ADDRESS)
MOV | rom address H, A

; Se salva PSW para poder luego volver al banco de registros correcto:
PUSH | PSW

; Se selecciona el banco de registros 3:
MACRO SELECT BANK 3
Albani - Arbelo Arrocha - Figueroa | 91 | 1.er cuatrimestre 2008

MOV | R0, ensayos tension
MOV | R1, ensayos presion
MOV | R2, ensayos tiempo reposo L
MOV | R3, ensayos tiempo reposo H
MOV | R4, ensayos tiempo descarga
; Se llama a la rutina que guarda en memoria ROM ; los 8 bytes del banco de registros seleccionado:
CALL | ROM WRITE FROM BANK

; Se recupera PSW para dejar seleccionado al banco de registros correcto:
POP | PSW
RET
;;;;;;;;;;;;;;;;;;;;;;;;;;;;;;;;;;;;;;;;;;;;;;;;;;;;;;;;;;;;;;;;;;;;;;;;;;;;;;;; ;;;;;;;;;;;;;;;;;;;;;;;;;;;;;;;;;;;;;;;;;;;;;;;;;;;;;;;;;;;;;;;;;;;;;;;;;;;;;;;;

;;;;;;;;;;;;;;;;;;;;;;;;;;;;;;;;;;;;;;;;;;;;;;;;;;;;;;;;;;;;;;;;;;;;;;;;;;;;;;;; ;;;;;;;;;;;;;;;;;;;;;;;;;;;;;;;;;;;;;;;;;;;;;;;;;;;;;;;;;;;;;;;;;;;;;;;;;;;;;;;; ENSAYOS CONVERTIR TENSION ADC2HUMAN: ;;;;;;;;;;;;;;;;;;;;;;;;;;;;;;;;;;;;;;;;;;;;;;;;;;;;;;;;;;;;;;;;;;;;;;;;;;;;;;;; ;;;;;;;;;;;;;;;;;;;;;;;;;;;;;;;;;;;;;;;;;;;;;;;;;;;;;;;;;;;;;;;;;;;;;;;;;;;;;;;; ;; Rutina para convertir la lectura del canal del ADC conectado al punto
;; de medición de la tensión del banco de capacitores en un número de 2 bytes ;; expresado en Volts.
;;
;; Se transforma proporcionalmente al intervalo [0;255] en [0;1000].
;;
;; La cuenta que se hace es: | human = adc·1000/255 = adc·200/51
;;
;;;;;;;;;;;;;;;;;;;;;;;;;;;;;;;;;;;;;;;;;;;;;;;;;;;;;;;;;;;;;;;;;;;;;;;;;;;;;;;; ;;;;;;;;;;;;;;;;;;;;;;;;;;;;;;;;;;;;;;;;;;;;;;;;;;;;;;;;;;;;;;;;;;;;;;;;;;;;;;;; ;;
;; Depende de:
;; −−−−−−−−−−
;; | MUL16
;; | DIV16
;;
;; Requisitos:
;; −−−−−−−−−−
;; | La variable en el rango del ADC en el Acumulador.
;;
;; Registros alterados:
;; −−−−−−−−−−−−−−−−−−−
;; | Registros del banco seleccionado
;; | A <− Parte baja del resultado de 2 bytes.
;; | B <− Parte alta del resultado de 2 bytes.
;; | C
;;;;;;;;;;;;;;;;;;;;;;;;;;;;;;;;;;;;;;;;;;;;;;;;;;;;;;;;;;;;;;;;;;;;;;;;;;;;;;;;

; Factor 1:
; La parte alta es siempre nula:
MOV | R6, #0d
; La parte baja viene en el acumulador:
MOV | R7, A

; Factor 2:
MOV | R4, #HIGH(200d)
MOV | R5, | #LOW(200d)
CALL | MUL16
; El resultado de 4 bytes queda en R0/R1/R2/R3.

; Divisor:
; Parte alta:
MOV | A, R2
MOV | R1, A
Albani - Arbelo Arrocha - Figueroa | 92 | 1.er cuatrimestre 2008

; Parte baja:
MOV | A, R3
MOV | R0, A

; Dividendo:
MOV | R3, #HIGH(51d)
MOV | R2, | #LOW(51d)
CALL | DIV16
; El resultado de 2 bytes queda en R3/R2.

; Se lo devuelve en B/A:
MOV | A, R2
MOV | B, R3

RET
;;;;;;;;;;;;;;;;;;;;;;;;;;;;;;;;;;;;;;;;;;;;;;;;;;;;;;;;;;;;;;;;;;;;;;;;;;;;;;;; ;;;;;;;;;;;;;;;;;;;;;;;;;;;;;;;;;;;;;;;;;;;;;;;;;;;;;;;;;;;;;;;;;;;;;;;;;;;;;;;;

;;;;;;;;;;;;;;;;;;;;;;;;;;;;;;;;;;;;;;;;;;;;;;;;;;;;;;;;;;;;;;;;;;;;;;;;;;;;;;;; ;;;;;;;;;;;;;;;;;;;;;;;;;;;;;;;;;;;;;;;;;;;;;;;;;;;;;;;;;;;;;;;;;;;;;;;;;;;;;;;; ENSAYOS CONVERTIR TENSION HUMAN2ADC: ;;;;;;;;;;;;;;;;;;;;;;;;;;;;;;;;;;;;;;;;;;;;;;;;;;;;;;;;;;;;;;;;;;;;;;;;;;;;;;;; ;;;;;;;;;;;;;;;;;;;;;;;;;;;;;;;;;;;;;;;;;;;;;;;;;;;;;;;;;;;;;;;;;;;;;;;;;;;;;;;; ;; Rutina para convertir una tensión expresada en Volts y almacenada en 2 bytes ;; al byte equivalente para el ADC.
;;
;; Se transforma proporcionalmente al intervalo [0;1000] en [0;255].
;;
;; La cuenta que se hace es: | adc = human·255/1000 = human·51/200
;;
;;;;;;;;;;;;;;;;;;;;;;;;;;;;;;;;;;;;;;;;;;;;;;;;;;;;;;;;;;;;;;;;;;;;;;;;;;;;;;;; ;;;;;;;;;;;;;;;;;;;;;;;;;;;;;;;;;;;;;;;;;;;;;;;;;;;;;;;;;;;;;;;;;;;;;;;;;;;;;;;; ;;
;; Depende de:
;; −−−−−−−−−−
;; | MUL16
;; | DIV16
;;
;; Requisitos:
;; −−−−−−−−−−
;; | La parte alta de la tensión en B.
;; | La parte baja de la tensión en A.
;;
;; Registros alterados:
;; −−−−−−−−−−−−−−−−−−−
;; | Registros del banco seleccionado
;; | A <− byte para el ADC.
;; | B, C
;;;;;;;;;;;;;;;;;;;;;;;;;;;;;;;;;;;;;;;;;;;;;;;;;;;;;;;;;;;;;;;;;;;;;;;;;;;;;;;;

; Factor 1:
; La parte alta viene en B:
MOV | R6, B
; La parte baja viene en A:
MOV | R7, A

; Factor 2:
MOV | R4, #HIGH(51d)
MOV | R5, | #LOW(51d)
CALL | MUL16
; El resultado de 4 bytes queda en R0/R1/R2/R3.

; Divisor:
; Parte alta:
MOV | A, R2
Albani - Arbelo Arrocha - Figueroa | 93 | 1.er cuatrimestre 2008

MOV | R1, A
; Parte baja:
MOV | A, R3
MOV | R0, A

; Dividendo:
MOV | R3, #HIGH(200d)
MOV | R2, | #LOW(200d)
CALL | DIV16
; El resultado de 2 bytes queda en R3/R2.

; Se devuelve en A a la parte baja del resultado:
MOV | A, R2

RET
;;;;;;;;;;;;;;;;;;;;;;;;;;;;;;;;;;;;;;;;;;;;;;;;;;;;;;;;;;;;;;;;;;;;;;;;;;;;;;;; ;;;;;;;;;;;;;;;;;;;;;;;;;;;;;;;;;;;;;;;;;;;;;;;;;;;;;;;;;;;;;;;;;;;;;;;;;;;;;;;;

;;;;;;;;;;;;;;;;;;;;;;;;;;;;;;;;;;;;;;;;;;;;;;;;;;;;;;;;;;;;;;;;;;;;;;;;;;;;;;;; ;;;;;;;;;;;;;;;;;;;;;;;;;;;;;;;;;;;;;;;;;;;;;;;;;;;;;;;;;;;;;;;;;;;;;;;;;;;;;;;; ENSAYOS CONVERTIR PRESION ADC2HUMAN: ;;;;;;;;;;;;;;;;;;;;;;;;;;;;;;;;;;;;;;;;;;;;;;;;;;;;;;;;;;;;;;;;;;;;;;;;;;;;;;;; ;;;;;;;;;;;;;;;;;;;;;;;;;;;;;;;;;;;;;;;;;;;;;;;;;;;;;;;;;;;;;;;;;;;;;;;;;;;;;;;; ;; Rutina para convertir la lectura del canal del ADC conectado al sensor
;; de presión en un número de 2 bytes expresado en kilogramos.
;;
;; Se transforma proporcionalmente al intervalo [0;255] en [0;20000]. ;;
;; La cuenta que se hace es: human = adc·20000/255 = adc·4000/51 ;;
;; Pero para evitar problemas de redondeo se hace en tres etapas:
;; | adc·40 | −−−−> | /51 | −−−−> | ·100
;;
;;;;;;;;;;;;;;;;;;;;;;;;;;;;;;;;;;;;;;;;;;;;;;;;;;;;;;;;;;;;;;;;;;;;;;;;;;;;;;;; ;;;;;;;;;;;;;;;;;;;;;;;;;;;;;;;;;;;;;;;;;;;;;;;;;;;;;;;;;;;;;;;;;;;;;;;;;;;;;;;; ;;
;; Depende de:
;; −−−−−−−−−−
;; | DIV16
;;
;; Requisitos:
;; −−−−−−−−−−
;; | La variable en el rango del ADC en el Acumulador.
;;
;; Registros alterados:
;; −−−−−−−−−−−−−−−−−−−
;; | Registros del banco seleccionado
;; | A <− Parte baja del resultado de 2 bytes.
;; | B <− Parte alta del resultado de 2 bytes.
;; | | C
;;;;;;;;;;;;;;;;;;;;;;;;;;;;;;;;;;;;;;;;;;;;;;;;;;;;;;;;;;;;;;;;;;;;;;;;;;;;;;;;

; Se multiplica al valor del adc que viene en A por 40:
MOV | B, #40d
MUL | AB
| ; Divisor:
| ; Parte alta:
MOV | R1, B
| ; Parte baja:
MOV | R0, A
| ; Dividendo:
MOV | R3, #HIGH(51d)
MOV | R2, | #LOW(51d)
Albani - Arbelo Arrocha - Figueroa | 94 | 1.er cuatrimestre 2008

CALL | DIV16
; El resultado de 2 bytes queda en R3/R2.

; Se multiplica por 100 a la parte baja del cociente:
MOV | A, R2
MOV | B, #100d
MUL | AB
; A <− parte baja del producto. ; B <− parte alta del producto.

RET
;;;;;;;;;;;;;;;;;;;;;;;;;;;;;;;;;;;;;;;;;;;;;;;;;;;;;;;;;;;;;;;;;;;;;;;;;;;;;;;; ;;;;;;;;;;;;;;;;;;;;;;;;;;;;;;;;;;;;;;;;;;;;;;;;;;;;;;;;;;;;;;;;;;;;;;;;;;;;;;;;

;;;;;;;;;;;;;;;;;;;;;;;;;;;;;;;;;;;;;;;;;;;;;;;;;;;;;;;;;;;;;;;;;;;;;;;;;;;;;;;; ;;;;;;;;;;;;;;;;;;;;;;;;;;;;;;;;;;;;;;;;;;;;;;;;;;;;;;;;;;;;;;;;;;;;;;;;;;;;;;;; ENSAYOS CONVERTIR PRESION HUMAN2ADC: ;;;;;;;;;;;;;;;;;;;;;;;;;;;;;;;;;;;;;;;;;;;;;;;;;;;;;;;;;;;;;;;;;;;;;;;;;;;;;;;; ;;;;;;;;;;;;;;;;;;;;;;;;;;;;;;;;;;;;;;;;;;;;;;;;;;;;;;;;;;;;;;;;;;;;;;;;;;;;;;;; ;; Rutina para convertir una presión expresada en kilogramos
;; y almacenada en 2 bytes al byte equivalente para el ADC.
;;
;; Se transforma proporcionalmente al intervalo [0;20000] en [0;255]. ;;
;; La cuenta que se hace es: | adc = human·255/20000 = human·51/4000
;;
;; Pero para evitar problemas de redondeo se hace en tres etapas:
;; | human/40 | −−−−> | ·51 | −−−−> | /100
;;
;;;;;;;;;;;;;;;;;;;;;;;;;;;;;;;;;;;;;;;;;;;;;;;;;;;;;;;;;;;;;;;;;;;;;;;;;;;;;;;; ;;;;;;;;;;;;;;;;;;;;;;;;;;;;;;;;;;;;;;;;;;;;;;;;;;;;;;;;;;;;;;;;;;;;;;;;;;;;;;;; ;;
;; Depende de:
;; −−−−−−−−−−
;; | MUL16
;; | DIV16
;;
;; Requisitos:
;; −−−−−−−−−−
;; | La parte alta de la presión en B.
;; | La parte baja de la presión en A.
;;
;; Registros alterados:
;; −−−−−−−−−−−−−−−−−−−
;; | Registros del banco seleccionado
;; | A <− byte para el ADC.
;; | | B, C
;;;;;;;;;;;;;;;;;;;;;;;;;;;;;;;;;;;;;;;;;;;;;;;;;;;;;;;;;;;;;;;;;;;;;;;;;;;;;;;;
| ; Divisor:
| ; Parte alta:
MOV | R1, B
| ; Parte baja:
MOV | R0, A
| ; Dividendo:
MOV | R3, #HIGH(40d)
MOV | R2, | #LOW(40d)
CALL | DIV16
; El resultado de 2 bytes queda en R3/R2.
| ; Factor 1:
| ; Parte alta:
MOV | A, R3
MOV | R6, A
Albani - Arbelo Arrocha - Figueroa | 95 | 1.er cuatrimestre 2008

; Parte baja:
MOV | A, R2
MOV | R7, A

; Factor 2:
MOV | R4, #HIGH(51d)
MOV | R5, | #LOW(51d)
CALL | MUL16
; El resultado de 4 bytes queda en R0/R1/R2/R3.

; Divisor:
; Parte alta:
MOV | A, R2
MOV | R1, A
; Parte baja:
MOV | A, R3
MOV | R0, A

; Dividendo:
MOV | R3, #HIGH(100d)
MOV | R2, | #LOW(100d)
CALL | DIV16
; El resultado de 2 bytes queda en R3/R2.

; Se devuelve la parte bajar del cociente:
MOV | A, R2

RET
;;;;;;;;;;;;;;;;;;;;;;;;;;;;;;;;;;;;;;;;;;;;;;;;;;;;;;;;;;;;;;;;;;;;;;;;;;;;;;;; ;;;;;;;;;;;;;;;;;;;;;;;;;;;;;;;;;;;;;;;;;;;;;;;;;;;;;;;;;;;;;;;;;;;;;;;;;;;;;;;;

;;;;;;;;;;;;;;;;;;;;;;;;;;;;;;;;;;;;;;;;;;;;;;;;;;;;;;;;;;;;;;;;;;;;;;;;;;;;;;;; ;;;;;;;;;;;;;;;;;;;;;;;;;;;;;;;;;;;;;;;;;;;;;;;;;;;;;;;;;;;;;;;;;;;;;;;;;;;;;;;; ENSAYOS REALIZAR SERIE:
;;;;;;;;;;;;;;;;;;;;;;;;;;;;;;;;;;;;;;;;;;;;;;;;;;;;;;;;;;;;;;;;;;;;;;;;;;;;;;;; ;;;;;;;;;;;;;;;;;;;;;;;;;;;;;;;;;;;;;;;;;;;;;;;;;;;;;;;;;;;;;;;;;;;;;;;;;;;;;;;; ;; Rutina para ejecutar los ensayos en sucesión. ;;;;;;;;;;;;;;;;;;;;;;;;;;;;;;;;;;;;;;;;;;;;;;;;;;;;;;;;;;;;;;;;;;;;;;;;;;;;;;;; ;;;;;;;;;;;;;;;;;;;;;;;;;;;;;;;;;;;;;;;;;;;;;;;;;;;;;;;;;;;;;;;;;;;;;;;;;;;;;;;;

; Se carga el contexto:
CALL | ENSAYOS CARGAR CONTEXTO

; Se comienza por el ensayo 0:
MOV | ensayos actual, #0d

ENSAYOS REALIZAR SERIE CYCLE:

; Se llama a la rutina que ejecuta al ensayo seleccionado:
CALL | ENSAYOS REALIZAR ACTUAL

; Si actual = último, entonces termina:
MOV | A, ensayos actual
CJNE | A, ensayos ultimo, ($+3+2)
SJMP | ENSAYOS REALIZAR SERIE FIN

; Si actual != último, entonces itera al siguiente:
INC | ensayos actual
SJMP | ENSAYOS REALIZAR SERIE CYCLE

ENSAYOS REALIZAR SERIE FIN:
CALL | DISPLAY CLEAR

; Se informa que todos los ensayos han finalizado:
DISPLAY MACRO PUT STRING STATIC | i18n All tests completed, | 3d, 0d
Albani - Arbelo Arrocha - Figueroa | 96 | 1.er cuatrimestre 2008

DISPLAY MACRO PUT STRING STATIC | i18n Enter to continue, | 7d, 0d
KEYPAD MACRO WAIT KEY | KEYPAD ENTER

RET
;;;;;;;;;;;;;;;;;;;;;;;;;;;;;;;;;;;;;;;;;;;;;;;;;;;;;;;;;;;;;;;;;;;;;;;;;;;;;;;; ;;;;;;;;;;;;;;;;;;;;;;;;;;;;;;;;;;;;;;;;;;;;;;;;;;;;;;;;;;;;;;;;;;;;;;;;;;;;;;;;

;;;;;;;;;;;;;;;;;;;;;;;;;;;;;;;;;;;;;;;;;;;;;;;;;;;;;;;;;;;;;;;;;;;;;;;;;;;;;;;; ;;;;;;;;;;;;;;;;;;;;;;;;;;;;;;;;;;;;;;;;;;;;;;;;;;;;;;;;;;;;;;;;;;;;;;;;;;;;;;;; ENSAYOS REALIZAR ACTUAL:
;;;;;;;;;;;;;;;;;;;;;;;;;;;;;;;;;;;;;;;;;;;;;;;;;;;;;;;;;;;;;;;;;;;;;;;;;;;;;;;; ;;;;;;;;;;;;;;;;;;;;;;;;;;;;;;;;;;;;;;;;;;;;;;;;;;;;;;;;;;;;;;;;;;;;;;;;;;;;;;;; ;; Rutina para ejecutar al ensayo seleccionado: ;;;;;;;;;;;;;;;;;;;;;;;;;;;;;;;;;;;;;;;;;;;;;;;;;;;;;;;;;;;;;;;;;;;;;;;;;;;;;;;;

; Se cargan las variables con la información del ensayo a realizar:
CALL | ENSAYOS CARGAR
CALL | DISPLAY CLEAR

; Se informa el ensayo actual en la cabecera:
CALL | ENSAYOS MOSTRAR CABECERA

;;;;;;;;;;;;;;;;;;;;;;;;;;;;;;;;;;;;;;;;;;;;;;;;;;;;;;;;;;;;;;;;;;;;;;;;;;;;;;;; ;; Primero se le pide al operador que confirme que la muestra ya está lista
;; en el compartimiento:
;;;;;;;;;;;;;;;;;;;;;;;;;;;;;;;;;;;;;;;;;;;;;;;;;;;;;;;;;;;;;;;;;;;;;;;;;;;;;;;;
DISPLAY MACRO PUT STRING STATIC | i18n Load sample, | 3d, 0d
DISPLAY MACRO PUT STRING STATIC | i18n Enter to continue, 7d, 0d
KEYPAD MACRO WAIT KEY | KEYPAD ENTER
CALL | DISPLAY CLEAR

; Se informa el ensayo actual en la cabecera:
CALL | ENSAYOS MOSTRAR CABECERA

;;;;;;;;;;;;;;;;;;;;;;;;;;;;;;;;;;;;;;;;;;;;;;;;;;;;;;;;;;;;;;;;;;;;;;;;;;;;;;;; ;; Luego se espera a que el operario alcance con la prensa el valor de presión ;; necesitado. Se muestran en pantalla la lectura del canal del ADC conectado ;; al sensor de presión y el valor que se debe alcanzar: ;;;;;;;;;;;;;;;;;;;;;;;;;;;;;;;;;;;;;;;;;;;;;;;;;;;;;;;;;;;;;;;;;;;;;;;;;;;;;;;;
DISPLAY MACRO PUT STRING STATIC | i18n Reach preassure, | 2d, 0d
DISPLAY MACRO PUT STRING STATIC | i18n Enter to continue, 7d, 0d

; Se realiza la conversión [0;255] −−> [0;20000]:
MOV | A, ensayos presion
CALL | ENSAYOS CONVERTIR PRESION ADC2HUMAN
; Se muestra la presión objetivo:
WIDGETS MACRO PUT INT A, B, 6d, 7d

ENSAYOS REALIZAR ACTUAL PRESION LOOP:

; Se toma una lectura del ADC:
ENSAYOS MACRO LEER PRESION
; El resultado queda en ensayos adc presion.

; Se realiza la conversión [0;255] −−> [0;20000]:
MOV | A, ensayos adc presion
CALL | ENSAYOS CONVERTIR PRESION ADC2HUMAN
; Se muestra el valor actual de presión:
WIDGETS MACRO PUT INT | A, B, 4d, 7d
Albani - Arbelo Arrocha - Figueroa | 97 | 1.er cuatrimestre 2008

; Se construye una barra de progreso a partir
; del valor actual y el valor objetivo:
WIDGETS MACRO PROGRESS BAR DIFF ensayos adc presion, ensayos presion, 5d

; Se llama a una rutina que permite iterar un bucle arbitrario
; hasta que se presione alguna tecla:
MOV | DPTR, #ENSAYOS REALIZAR ACTUAL PRESION LOOP
CALL | KEYPAD SCAN JMP
CALL | DISPLAY CLEAR

; Se informa el ensayo actual en la cabecera:
CALL | ENSAYOS MOSTRAR CABECERA

;;;;;;;;;;;;;;;;;;;;;;;;;;;;;;;;;;;;;;;;;;;;;;;;;;;;;;;;;;;;;;;;;;;;;;;;;;;;;;;; ;; A continuación se espera que pase el tiempo en el que la muestra debe
;; dejar reposar bajo presión. ;;;;;;;;;;;;;;;;;;;;;;;;;;;;;;;;;;;;;;;;;;;;;;;;;;;;;;;;;;;;;;;;;;;;;;;;;;;;;;;;
DISPLAY MACRO PUT STRING STATIC | i18n Settling sample, | 2d, 0d

; Se muestra la cantidad de segundos a esperar:
WIDGETS MACRO PUT INT ensayos tiempo reposo L,ensayos tiempo reposo H,6d,7d

; Se inicia el cronómetro de segundos:
CALL | TIMERS START SECONDS CRON

ENSAYOS REALIZAR ACTUAL REPOSO LOOP:

; Se muestra el tiempo transcurrido:
WIDGETS MACRO PUT INT timers seconds L, timers seconds H, 4d, 7d

; Se itera hasta que se alcance el tiempo necesario:
ENSAYOS REALIZAR ACTUAL REPOSO RETRY:
MOV | A, timers seconds H
MOV | R6, timers seconds L
CJNE | A, timers seconds H, ENSAYOS REALIZAR ACTUAL REPOSO RETRY
MOV | R7, A
MOV | A, R6
CJNE | A, ensayos tiempo reposo L, ENSAYOS REALIZAR ACTUAL REPOSO LOOP
MOV | A, R7
CJNE | A, ensayos tiempo reposo H, ENSAYOS REALIZAR ACTUAL REPOSO LOOP

; Se detiene al cronómetro de segundos:
CALL | TIMERS STOP SECONDS CRON
CALL | DISPLAY CLEAR
; Se informa el ensayo actual en la cabecera:
CALL | ENSAYOS MOSTRAR CABECERA
;;;;;;;;;;;;;;;;;;;;;;;;;;;;;;;;;;;;;;;;;;;;;;;;;;;;;;;;;;;;;;;;;;;;;;;;;;;;;;;; ;; Luego se comienza la carga de los capacitores. Se muestra en pantalla
;; la lectura del canal del ADC conectado al punto de medición de tensión. ;;;;;;;;;;;;;;;;;;;;;;;;;;;;;;;;;;;;;;;;;;;;;;;;;;;;;;;;;;;;;;;;;;;;;;;;;;;;;;;;
DISPLAY MACRO PUT STRING STATIC | i18n Charging capacitors, | 2d, 0d

; Se realiza la conversión [0;255] −−> [0;1000]:
MOV | A, ensayos tension
CALL | ENSAYOS CONVERTIR TENSION ADC2HUMAN
; Se muestra el valor objetivo:
WIDGETS MACRO PUT INT A , B, 6d, 7d
; Por seguridad, se asegura que el banco de capacidores esté desconectado ; de la segunda etapa del circuito:
CLR | ENSAYOS RELAY TIRISTOR
; Se cierra la llave que permite la carga:
SETB | ENSAYOS RELAY BANCO CAPACITORES

;;;;;;;;;;;;;;;;;;;;;;;;;;;;;;;;;;;;;;;;;;;;;;;;;;;;;;;;;;;;;;;;;;;;;;;;;;;;;;;; ;;;;;;;;;;;;;;;;;;;;;;;;;;;;;;;;;;;;;;;;;;;;;;;;;;;;;;;;;;;;;;;;;;;;;;;;;;;;;;;;

Albani - Arbelo Arrocha - Figueroa | 98 | 1.er cuatrimestre 2008

;;;;;;;;;;;;;;;;;;;;;;;;;;;;;;;;;;;;;;;;;;;;;;;;;;;;;;;;;;;;;;;;;;;;;;;;;;;;;;;;

ENSAYOS REALIZAR ACTUAL TENSION LOOP:

; Por seguridad, se asegura en cada iteración que la llave esté cerrada:
SETB | ENSAYOS RELAY BANCO CAPACITORES

ENSAYOS MACRO LEER TENSION

; Se realiza la conversión [0;255] −−> [0;1000]:
MOV | A, ensayos adc tension
CALL | ENSAYOS CONVERTIR TENSION ADC2HUMAN
; Se muestra la tensión medida:
WIDGETS MACRO PUT INT A, B, 4d, 7d

; Se muestra una barra de progreso:
WIDGETS MACRO PROGRESS BAR DIFF ensayos adc tension, ensayos tension, 5d

; Se compara la lectura del ADC con el objetivo:
MOV | A, ensayos adc tension
CJNE | A, ensayos tension, ($+3)
; C = actual < objetivo.
JC | ENSAYOS REALIZAR ACTUAL TENSION LOOP

;;;;;;;;;;;;;;;;;;;;;;;;;;;;;;;;;;;;;;;;;;;;;;;;;;;;;;;;;;;;;;;;;;;;;;;;;;;;;;;; ;;;;;;;;;;;;;;;;;;;;;;;;;;;;;;;;;;;;;;;;;;;;;;;;;;;;;;;;;;;;;;;;;;;;;;;;;;;;;;;;

; Se detiene la carga del banco de capacitores:
CLR | ENSAYOS RELAY BANCO CAPACITORES
CALL | DELAY ONE SECOND
CALL | DELAY ONE SECOND

;;;;;;;;;;;;;;;;;;;;;;;;;;;;;;;;;;;;;;;;;;;;;;;;;;;;;;;;;;;;;;;;;;;;;;;;;;;;;;;; ;;;;;;;;;;;;;;;;;;;;;;;;;;;;;;;;;;;;;;;;;;;;;;;;;;;;;;;;;;;;;;;;;;;;;;;;;;;;;;;;

; Se activa el circuito del tiristor para descargar los capacitores
; sobre la muestra:
SETB | ENSAYOS RELAY TIRISTOR

; Se inicia al cronómetro de milisegundos:
CALL | TIMERS START MSECS CRON

ENSAYOS REALIZAR ACTUAL TIEMPO DESCARGA LOOP:

MOV | A, timers msecs
CJNE | A, ensayos tiempo descarga, ($+3)
; C = actual < objetivo.
JC | ENSAYOS REALIZAR ACTUAL TIEMPO DESCARGA LOOP
CLR | ENSAYOS RELAY TIRISTOR

; Se detiene al cronómetro de milisegundos:
CALL | TIMERS STOP MSECS CRON

;;;;;;;;;;;;;;;;;;;;;;;;;;;;;;;;;;;;;;;;;;;;;;;;;;;;;;;;;;;;;;;;;;;;;;;;;;;;;;;; ;;;;;;;;;;;;;;;;;;;;;;;;;;;;;;;;;;;;;;;;;;;;;;;;;;;;;;;;;;;;;;;;;;;;;;;;;;;;;;;;

CALL | DISPLAY CLEAR
DISPLAY MACRO PUT STRING STATIC | i18n Spark, 3d, 3d
CALL | DELAY ONE SECOND
CALL | DELAY ONE SECOND
CALL | DISPLAY CLEAR
Albani - Arbelo Arrocha - Figueroa | 99 | 1.er cuatrimestre 2008

; Se informa el ensayo actual en la cabecera:
CALL | ENSAYOS MOSTRAR CABECERA

;;;;;;;;;;;;;;;;;;;;;;;;;;;;;;;;;;;;;;;;;;;;;;;;;;;;;;;;;;;;;;;;;;;;;;;;;;;;;;;; ;; Antes de terminar, se espera que el operario retire la muestra
;; del compartimiento.
;;;;;;;;;;;;;;;;;;;;;;;;;;;;;;;;;;;;;;;;;;;;;;;;;;;;;;;;;;;;;;;;;;;;;;;;;;;;;;;;
DISPLAY MACRO PUT STRING STATIC | i18n Take sample, | 3d, 0d
DISPLAY MACRO PUT STRING STATIC | i18n Enter to continue, 7d, 0d
KEYPAD MACRO WAIT KEY | KEYPAD ENTER

RET
;;;;;;;;;;;;;;;;;;;;;;;;;;;;;;;;;;;;;;;;;;;;;;;;;;;;;;;;;;;;;;;;;;;;;;;;;;;;;;;; ;;;;;;;;;;;;;;;;;;;;;;;;;;;;;;;;;;;;;;;;;;;;;;;;;;;;;;;;;;;;;;;;;;;;;;;;;;;;;;;;

;;;;;;;;;;;;;;;;;;;;;;;;;;;;;;;;;;;;;;;;;;;;;;;;;;;;;;;;;;;;;;;;;;;;;;;;;;;;;;;; ;;;;;;;;;;;;;;;;;;;;;;;;;;;;;;;;;;;;;;;;;;;;;;;;;;;;;;;;;;;;;;;;;;;;;;;;;;;;;;;; ENSAYOS ELIMINAR:
;;;;;;;;;;;;;;;;;;;;;;;;;;;;;;;;;;;;;;;;;;;;;;;;;;;;;;;;;;;;;;;;;;;;;;;;;;;;;;;; ;;;;;;;;;;;;;;;;;;;;;;;;;;;;;;;;;;;;;;;;;;;;;;;;;;;;;;;;;;;;;;;;;;;;;;;;;;;;;;;; ;; "Elimina" un ensayo de la lista. En realidad lo que hace es intercambiarlo ;; por el último y reducir la lista. ;;;;;;;;;;;;;;;;;;;;;;;;;;;;;;;;;;;;;;;;;;;;;;;;;;;;;;;;;;;;;;;;;;;;;;;;;;;;;;;; ;;;;;;;;;;;;;;;;;;;;;;;;;;;;;;;;;;;;;;;;;;;;;;;;;;;;;;;;;;;;;;;;;;;;;;;;;;;;;;;;

; Se carga de ROM la información de contexto, para conocer
; la posición del último:
CALL | ENSAYOS CARGAR CONTEXTO

; Si sólo hay un ensayo en la lista, se ignora la llamada:
MOV | A, ensayos ultimo
JZ | ENSAYOS ELIMINAR END

; Si se quizo eliminar al último, sólo se necesita ; decrementar a ensayos ultimo:
CJNE | A, ensayos actual, ($+3+2)
SJMP | ENSAYOS ELIMINAR ULTIMO

; Se salva la posición del ensayo que se desea eliminar:
PUSH | ensayos actual

; Se mueve hasta el final y carga en RAM al último ensayo:
MOV | ensayos actual, ensayos ultimo
CALL | ENSAYOS CARGAR

; Se sobrescribe al actual por el último:
POP | ensayos actual
CALL | ENSAYOS GRABAR

ENSAYOS ELIMINAR ULTIMO:

; Y finalmente decrementa la posición del último y graba el contexto:
DEC | ensayos ultimo
CALL | ENSAYOS GRABAR CONTEXTO

ENSAYOS ELIMINAR END:
RET
;;;;;;;;;;;;;;;;;;;;;;;;;;;;;;;;;;;;;;;;;;;;;;;;;;;;;;;;;;;;;;;;;;;;;;;;;;;;;;;; ;;;;;;;;;;;;;;;;;;;;;;;;;;;;;;;;;;;;;;;;;;;;;;;;;;;;;;;;;;;;;;;;;;;;;;;;;;;;;;;;
Albani - Arbelo Arrocha - Figueroa | 100 | 1.er cuatrimestre 2008

# 6.12. interfaz.asm

;;;;;;;;;;;;;;;;;;;;;;;;;;;;;;;;;;;;;;;;;;;;;;;;;;;;;;;;;;;;;;;;;;;;;;;;;;;;;;;; ;;;;;;;;;;;;;;;;;;;;;;;;;;;;;;;;;;;;;;;;;;;;;;;;;;;;;;;;;;;;;;;;;;;;;;;;;;;;;;;; ;; Descripción de la interfaz con el usuario. ;;;;;;;;;;;;;;;;;;;;;;;;;;;;;;;;;;;;;;;;;;;;;;;;;;;;;;;;;;;;;;;;;;;;;;;;;;;;;;;; ;;;;;;;;;;;;;;;;;;;;;;;;;;;;;;;;;;;;;;;;;;;;;;;;;;;;;;;;;;;;;;;;;;;;;;;;;;;;;;;; ;;
;; Las "rutinas" que aquí se definen, no deben ser llamadas nunca con CALL.
;; Fueron concebidas para tomar un control temprano de la ejecución y luego
;; guiar todo el comportamiento.
;;
;; El punto de inicio recomendado es INTERFAZ MENU PRINCIPAL y debe ser
;; alcanzado con una instrucción del tipo JMP.
;;
;;;;;;;;;;;;;;;;;;;;;;;;;;;;;;;;;;;;;;;;;;;;;;;;;;;;;;;;;;;;;;;;;;;;;;;;;;;;;;;; ;;;;;;;;;;;;;;;;;;;;;;;;;;;;;;;;;;;;;;;;;;;;;;;;;;;;;;;;;;;;;;;;;;;;;;;;;;;;;;;;
;; | INTERFAZ MENU PRINCIPAL
;; | INTERFAZ MENU EDITAR ENSAYO
;; | INTERFAZ ANILLO ENSAYOS
;; | INTERFAZ ANILLO ENSAYOS CYCLE
;;
;;;;;;;;;;;;;;;;;;;;;;;;;;;;;;;;;;;;;;;;;;;;;;;;;;;;;;;;;;;;;;;;;;;;;;;;;;;;;;;; ;;;;;;;;;;;;;;;;;;;;;;;;;;;;;;;;;;;;;;;;;;;;;;;;;;;;;;;;;;;;;;;;;;;;;;;;;;;;;;;;

CSEG

;;;;;;;;;;;;;;;;;;;;;;;;;;;;;;;;;;;;;;;;;;;;;;;;;;;;;;;;;;;;;;;;;;;;;;;;;;;;;;;; ;;;;;;;;;;;;;;;;;;;;;;;;;;;;;;;;;;;;;;;;;;;;;;;;;;;;;;;;;;;;;;;;;;;;;;;;;;;;;;;; INTERFAZ MENU PRINCIPAL:
;;;;;;;;;;;;;;;;;;;;;;;;;;;;;;;;;;;;;;;;;;;;;;;;;;;;;;;;;;;;;;;;;;;;;;;;;;;;;;;; ;;;;;;;;;;;;;;;;;;;;;;;;;;;;;;;;;;;;;;;;;;;;;;;;;;;;;;;;;;;;;;;;;;;;;;;;;;;;;;;;
CALL | DISPLAY CLEAR

; Se pasa el control a la rutina que muestra el texto de las opciones ; de un menú y permite recorrerlas:
MOV | DPTR, #i18n Main menu labels
CALL | WIDGETS MENU INTERACT
; Al volver, se obtiene la opción elegida en widgets menu option
; y la tecla presionada en keypad pressed key.

; Si se salió del menú presionando ESC, se vuelve a mostrar a sí mismo:
MOV | A, keypad pressed key
CJNE | A, #KEYPAD ESC, ($+3+2)
SJMP | INTERFAZ MENU PRINCIPAL

; La estructura siguiente es equivalente a el típico SWITCH ; de los lenguajes de nivel más alto:

; Switch (widgets menu option):
MOV | A, widgets menu option

; Case 0:
CJNE | A, #0d, ($+5)
SJMP | INTERFAZ MENU PRINCIPAL OPTION 0
; Case 1:
CJNE | A, #1d, ($+5)
SJMP | INTERFAZ MENU PRINCIPAL OPTION 1
; Case 2:
CJNE | A, #2d, ($+5)
SJMP | INTERFAZ MENU PRINCIPAL OPTION 2
; Case 3:
Albani - Arbelo Arrocha - Figueroa | 101 | 1.er cuatrimestre 2008

CJNE | A, #3d, ($+5)
SJMP | INTERFAZ MENU PRINCIPAL OPTION 3
; Default:
SJMP | INTERFAZ MENU PRINCIPAL

INTERFAZ MENU PRINCIPAL OPTION 0:
; La opción 0 muestra al anillo de ensayos:
JMP | INTERFAZ ANILLO ENSAYOS

INTERFAZ MENU PRINCIPAL OPTION 1:
; La opción 1 permite agregar un ensayo a la lista.

; Primero se carga desde ROM la información necesaria para saber ; si queda lugar para agregar otro ensayo:
CALL | ENSAYOS CARGAR CONTEXTO

; Si el último ensayo no está en la posición 255, entonces hay lugar:
MOV | A, ensayos ultimo
CJNE | A, #255d, INTERFAZ MENU PRINCIPAL OPTION 1 HAY ESPACIO

; Si el último ensayo está en la posición 255, entonces no hay más lugar:
CALL | DISPLAY CLEAR

; Se muestra un texto informando sobre el incidente:
DISPLAY MACRO PUT STRING STATIC | i18n Out of space, | 3d, 0d
DISPLAY MACRO PUT STRING STATIC | i18n Enter to continue, 7d, 0d

; Se espera a que el usuario presione ENTER
; antes de volver al menú principal:
KEYPAD MACRO WAIT KEY | KEYPAD ENTER
JMP | INTERFAZ MENU PRINCIPAL

INTERFAZ MENU PRINCIPAL OPTION 1 HAY ESPACIO:
; Se incrementa la posición del último ensayo,
; se lo apunta y se llama a la rutina que graba el contexto ; para actualizar el valor de ensayos ultimo en ROM:
INC | ensayos ultimo
MOV | ensayos actual, ensayos ultimo
CALL | ENSAYOS GRABAR CONTEXTO

; Se inicializan los valores del nuevo experimento:
MOV | ensayos tension, | #0d
MOV | ensayos presion, | #0d
MOV | ensayos tiempo reposo L, | #0d
MOV | ensayos tiempo descarga, | #0d

; Se pasa el control a la interfaz que permite editar
; los parámetros del ensayo seleccionado, que en este caso ; es el que acaba de crearse:
JMP | INTERFAZ MENU EDITAR ENSAYO

INTERFAZ MENU PRINCIPAL OPTION 2:
; Se llama a la rutina que realiza la serie de ensayos ; almacenador en ROM:
CALL | ENSAYOS REALIZAR SERIE

; Al finalizar, se vuelve a mostrar el menú principal:
JMP | INTERFAZ MENU PRINCIPAL

INTERFAZ MENU PRINCIPAL OPTION 3:
; Menú loco:
JMP | INTERFAZ MENU EXTRAS
;;;;;;;;;;;;;;;;;;;;;;;;;;;;;;;;;;;;;;;;;;;;;;;;;;;;;;;;;;;;;;;;;;;;;;;;;;;;;;;; ;;;;;;;;;;;;;;;;;;;;;;;;;;;;;;;;;;;;;;;;;;;;;;;;;;;;;;;;;;;;;;;;;;;;;;;;;;;;;;;;
Albani - Arbelo Arrocha - Figueroa | 102 | 1.er cuatrimestre 2008

;;;;;;;;;;;;;;;;;;;;;;;;;;;;;;;;;;;;;;;;;;;;;;;;;;;;;;;;;;;;;;;;;;;;;;;;;;;;;;;; ;;;;;;;;;;;;;;;;;;;;;;;;;;;;;;;;;;;;;;;;;;;;;;;;;;;;;;;;;;;;;;;;;;;;;;;;;;;;;;;; INTERFAZ MENU EDITAR ENSAYO: ;;;;;;;;;;;;;;;;;;;;;;;;;;;;;;;;;;;;;;;;;;;;;;;;;;;;;;;;;;;;;;;;;;;;;;;;;;;;;;;; ;;;;;;;;;;;;;;;;;;;;;;;;;;;;;;;;;;;;;;;;;;;;;;;;;;;;;;;;;;;;;;;;;;;;;;;;;;;;;;;;

CALL | DISPLAY CLEAR

; Se pasa el control a la rutina que muestra el texto de las opciones ; de un menú y permite recorrerlas:
MOV | DPTR, #i18n Edit menu labels
CALL | WIDGETS MENU INTERACT
; Al volver, se obtiene la opción elegida en widgets menu option ; y la tecla presionada en keypad pressed key.

; Si se salió del menú presionando ESC, se cancela la edición
; y se pasa el control al ciclo del anillo de ensayos.
; Es importante notar que al no seguir la estructura de CALL/RET, ; se volverá al ciclo del anillo de ensayos
; independientemente de la ubicación anterior.
MOV | A, keypad pressed key
CJNE | A, #KEYPAD ESC, ($+3+3)
LJMP | INTERFAZ ANILLO ENSAYOS CYCLE

; La estructura siguiente es equivalente a el típico SWITCH ; de los lenguajes de nivel más alto:

; Switch (widgets menu option):
MOV | A, widgets menu option

; Case 0:
CJNE | A, #0d, ($+3+2)
SJMP | INTERFAZ MENU EDITAR ENSAYO OPTION 0
; Case 1:
CJNE | A, #1d, ($+3+2)
SJMP | INTERFAZ MENU EDITAR ENSAYO OPTION 1
; Case 2:
CJNE | A, #2d, ($+3+2)
SJMP | INTERFAZ MENU EDITAR ENSAYO OPTION 2
; Case 3:
CJNE | A, #3d, ($+3+2)
SJMP | INTERFAZ MENU EDITAR ENSAYO OPTION 3
; Case 4:
CJNE | A, #4d, ($+3+2)
SJMP | INTERFAZ MENU EDITAR ENSAYO OPTION 4
; Default:
JMP | INTERFAZ MENU EDITAR ENSAYO

; La estructura de las opciones 0 a 3 es idéntica y consiste en ; llamar a la rutina que lee dígitos desde el teclado y los
; transforma en números.
INTERFAZ MENU EDITAR ENSAYO OPTION 0:
; Lectura de la tensión:
WIDGETS MACRO PROMPT | A, B, | 7d, 6d
; A <− parte baja del valor de 2 bytes ingresado en Volts. ; B <− parte alta del valor de 2 bytes ingresado en Volts.
CALL | ENSAYOS CONVERTIR TENSION HUMAN2ADC
MOV | ensayos tension, A
JMP | INTERFAZ MENU EDITAR ENSAYO
INTERFAZ MENU EDITAR ENSAYO OPTION 1:
; Lectura de la presión:
WIDGETS MACRO PROMPT | A, B, | 7d, 6d
; A <− parte baja del valor de 2 bytes ingresado en kilogramos. ; B <− parte alta del valor de 2 bytes ingresado en kilogramos.
CALL | ENSAYOS CONVERTIR PRESION HUMAN2ADC
Albani - Arbelo Arrocha - Figueroa | 103 | 1.er cuatrimestre 2008

MOV | ensayos presion, A
JMP | INTERFAZ MENU EDITAR ENSAYO
INTERFAZ MENU EDITAR ENSAYO OPTION 2:

WIDGETS MACRO PROMPT ensayos tiempo reposo L, ensayos tiempo reposo H,7d,6d

JMP | INTERFAZ MENU EDITAR ENSAYO
INTERFAZ MENU EDITAR ENSAYO OPTION 3:
WIDGETS MACRO PROMPT | ensayos tiempo descarga, Acc, 7d, 6d
JMP | INTERFAZ MENU EDITAR ENSAYO

INTERFAZ MENU EDITAR ENSAYO OPTION 4:
; Esta opción muestra en pantalla todos los datos ingresados ; y da la oportunidad de confirmarlos o descartarlos.
CALL | DISPLAY CLEAR
DISPLAY MACRO PUT STRING STATIC | i18n Title Confirm data, | 0d, 0d
DISPLAY MACRO PUT STRING STATIC | i18n Voltage, | 1d, 0d
MOV | A, ensayos tension
CALL | ENSAYOS CONVERTIR TENSION ADC2HUMAN
WIDGETS MACRO PUT INT | A, B, | 1d, 15d
DISPLAY MACRO PUT STRING STATIC | i18n Preassure, | 2d, 0d
MOV | A, ensayos presion
CALL | ENSAYOS CONVERTIR PRESION ADC2HUMAN
WIDGETS MACRO PUT INT | A, B, | 2d, 15d
DISPLAY MACRO PUT STRING STATIC | i18n Settling time, | 3d, 0d
WIDGETS MACRO PUT INT ensayos tiempo reposo L,ensayos tiempo reposo H,3d,15d
DISPLAY MACRO PUT STRING STATIC | i18n Discharge time, | 4d, 0d
WIDGETS MACRO PUT INT | ensayos tiempo descarga, #0d, 4d, 15d
DISPLAY MACRO PUT STRING STATIC | i18n Enter to accept, | 6d, 0d
DISPLAY MACRO PUT STRING STATIC | i18n Esc to cancel, | 7d, 0d

INTERFAZ MENU EDITAR ENSAYO WAIT ENTER:

; Se detiene la ejecución hasta que se presione alguna tecla:
CALL | KEYPAD SCAN WAIT

; Si se presiona ESC es porque no se aceptan los datos
; y se quiere editarlos:
MOV | A, keypad pressed key
CJNE | A, #KEYPAD ESC, ($+3+3)
LJMP | INTERFAZ MENU EDITAR ENSAYO

; Hasta que no se presione ESC o ENTER no se continua:
CJNE | A, #KEYPAD ENTER, INTERFAZ MENU EDITAR ENSAYO WAIT ENTER

; Si se presiona ENTER se guardan los datos en ROM:
CALL | DISPLAY CLEAR

DISPLAY MACRO PUT STRING STATIC i18n Saving data, 3d, 0d

CALL | ENSAYOS GRABAR

; Delay ficticio:
CALL | DELAY ONE SECOND
Albani - Arbelo Arrocha - Figueroa | 104 | 1.er cuatrimestre 2008

; Se podría agregar una progress bar para hacerlo más fantoche todavía.

; Al finalizar, se regresa al ciclo del anillo de ensayos:
JMP | INTERFAZ ANILLO ENSAYOS CYCLE
;;;;;;;;;;;;;;;;;;;;;;;;;;;;;;;;;;;;;;;;;;;;;;;;;;;;;;;;;;;;;;;;;;;;;;;;;;;;;;;; ;;;;;;;;;;;;;;;;;;;;;;;;;;;;;;;;;;;;;;;;;;;;;;;;;;;;;;;;;;;;;;;;;;;;;;;;;;;;;;;;

;;;;;;;;;;;;;;;;;;;;;;;;;;;;;;;;;;;;;;;;;;;;;;;;;;;;;;;;;;;;;;;;;;;;;;;;;;;;;;;; ;;;;;;;;;;;;;;;;;;;;;;;;;;;;;;;;;;;;;;;;;;;;;;;;;;;;;;;;;;;;;;;;;;;;;;;;;;;;;;;; INTERFAZ ANILLO ENSAYOS:
;;;;;;;;;;;;;;;;;;;;;;;;;;;;;;;;;;;;;;;;;;;;;;;;;;;;;;;;;;;;;;;;;;;;;;;;;;;;;;;; ;;;;;;;;;;;;;;;;;;;;;;;;;;;;;;;;;;;;;;;;;;;;;;;;;;;;;;;;;;;;;;;;;;;;;;;;;;;;;;;;

; Se comienza mostrando el primer ensayo de la lista:
MOV | ensayos actual, #0d

; Se carga desde ROM toda la información de contexto para saber ; cuantos ensayos hay cargados:
CALL | ENSAYOS CARGAR CONTEXTO

INTERFAZ ANILLO ENSAYOS CYCLE:

CALL | DISPLAY CLEAR

; Se cargan de ROM los datos del experimento actual ; para poder mostrarlos:
CALL | ENSAYOS CARGAR
CALL | DISPLAY CLEAR

; Se informa en la cabecera el número del experimento actual:
CALL | ENSAYOS MOSTRAR CABECERA

; Se muestran los parámetros del ensayo seleccionado:

DISPLAY MACRO PUT STRING STATIC | i18n Voltage, | 1d, 0d
MOV | A, ensayos tension
CALL | ENSAYOS CONVERTIR TENSION ADC2HUMAN
WIDGETS MACRO PUT INT | A, B, | 1d, 15d
DISPLAY MACRO PUT STRING STATIC | i18n Preassure, | 2d, 0d
MOV | A, ensayos presion
CALL | ENSAYOS CONVERTIR PRESION ADC2HUMAN
WIDGETS MACRO PUT INT | A, B, | 2d, 15d
DISPLAY MACRO PUT STRING STATIC | i18n Settling time, | 3d, 0d
WIDGETS MACRO PUT INT ensayos tiempo reposo L,ensayos tiempo reposo H,3d,15d
DISPLAY MACRO PUT STRING STATIC | i18n Discharge time, | 4d, 0d
WIDGETS MACRO PUT INT | ensayos tiempo descarga,#0d, 4d, 15d

; Se muestran las opciones con sus teclas asociadas:
DISPLAY MACRO PUT STRING STATIC | i18n Enter for edit, | 5d, 0d
DISPLAY MACRO PUT STRING STATIC | i18n F1 for excute, | 6d, 0d
DISPLAY MACRO PUT STRING STATIC | i18n DEL for delete, | 7d, 0d

; Se detiene la ejecución hasta que se presione alguna tecla:
CALL | KEYPAD SCAN WAIT

; La estructura siguiente es equivalente a el típico SWITCH ; de los lenguajes de nivel más alto.

Albani - Arbelo Arrocha - Figueroa | 105 | 1.er cuatrimestre 2008

; Se acompaña con su cuasi−equivalente en lenguaje C.

; Switch (keypad pressed key):
MOV | A, keypad pressed key

; Case KEYPAD RIGHT:
CJNE | A, #KEYPAD RIGHT, ($+3+2)
SJMP | INTERFAZ ANILLO ENSAYOS RIGHT
; Case KEYPAD LEFT:
CJNE | A, #KEYPAD LEFT, ($+3+2)
SJMP | INTERFAZ ANILLO ENSAYOS LEFT
; Case KEYPAD HELP:
CJNE | A, #KEYPAD HELP, ($+3+2)
SJMP | INTERFAZ ANILLO ENSAYOS HELP
; Case KEYPAD ESC:
CJNE | A, #KEYPAD ESC, ($+3+3)
LJMP | INTERFAZ ANILLO ENSAYOS ESC
; Case KEYPAD ENTER:
CJNE | A, #KEYPAD ENTER, ($+3+3)
LJMP | INTERFAZ ANILLO ENSAYOS ENTER
; Case KEYPAD DEL:
CJNE | A, #KEYPAD DEL, ($+3+3)
LJMP | INTERFAZ ANILLO ENSAYOS DEL
; Default:
JMP | INTERFAZ ANILLO ENSAYOS CYCLE

INTERFAZ ANILLO ENSAYOS RIGHT:
; Si se presiona esta tecla, y no se superó al último,
; hay que mostrar al próximo:
MOV | A, ensayos actual
CJNE | A, ensayos ultimo, INTERFAZ ANILLO ENSAYOS RIGHT NOT LAST

; Si se superó al último, se vuelve al primero (topología circular):
MOV | ensayos actual, #0d
JMP | INTERFAZ ANILLO ENSAYOS CYCLE

INTERFAZ ANILLO ENSAYOS RIGHT NOT LAST:
INC | ensayos actual
JMP | INTERFAZ ANILLO ENSAYOS CYCLE

INTERFAZ ANILLO ENSAYOS LEFT:
; Si se presiona esta tecla, y no se superó al primero, ; hay que mostrar al anterio:
MOV | A, ensayos actual
CJNE | A, #0d, INTERFAZ ANILLO ENSAYOS LEFT NOT LAST

; Si se superó al primero, se vuelve al último (topología circular):
MOV | ensayos actual, ensayos ultimo
JMP | INTERFAZ ANILLO ENSAYOS CYCLE

INTERFAZ ANILLO ENSAYOS LEFT NOT LAST:
DEC | ensayos actual
JMP | INTERFAZ ANILLO ENSAYOS CYCLE

INTERFAZ ANILLO ENSAYOS HELP:
; Si se presiona HELP, se llama a la rutina que ; ejecuta el ensayo seleccionado:
CALL | ENSAYOS REALIZAR ACTUAL
JMP | INTERFAZ ANILLO ENSAYOS CYCLE

INTERFAZ ANILLO ENSAYOS DEL:

CALL | DISPLAY CLEAR

; Se informa en qué consiste el procedimiento de "borrado":

Albani - Arbelo Arrocha - Figueroa | 106 | 1.er cuatrimestre 2008

DISPLAY MACRO PUT STRING STATIC | i18n Delete message A, | 2d, 0d
DISPLAY MACRO PUT STRING STATIC | i18n Delete message B, | 3d, 0d
DISPLAY MACRO PUT STRING STATIC | i18n Delete message C, | 4d, 0d

; Se muestran las opciones con sus teclas asociadas:
DISPLAY MACRO PUT STRING STATIC | i18n Enter to accept, | 6d, 0d
DISPLAY MACRO PUT STRING STATIC | i18n Esc to cancel, | 7d, 0d

INTERFAZ ANILLO ENSAYOS DEL WAIT ENTER OR ESC:

; Se detiene la ejecución hasta que se presione alguna tecla:
CALL | KEYPAD SCAN WAIT

; Si se presiona ESC es porque se arrepiente de eliminar:
MOV | A, keypad pressed key
CJNE | A, #KEYPAD ESC, ($+3+3)
LJMP | INTERFAZ ANILLO ENSAYOS CYCLE

; Hasta que no se presione ENTER o ESC no continua:
CJNE | A, #KEYPAD ENTER, INTERFAZ ANILLO ENSAYOS DEL WAIT ENTER OR ESC

; Si se presiona ENTER se procede a eliminar el ensayo:
CALL | DISPLAY CLEAR
DISPLAY MACRO PUT STRING STATIC | i18n Updating data, | 3d, 0d
CALL | ENSAYOS ELIMINAR

; Delay ficticio:
CALL | DELAY ONE SECOND

; Se recarga la información de contexto para actualizar la posición del ; último:
CALL | ENSAYOS CARGAR CONTEXTO

;; Si el que se acaba de eliminar era el último, entonces se debe ;; ajustar la posición antes de salir, para evitar comportamientos ;; anómalos:
MOV | A, ensayos ultimo
CJNE | A, ensayos actual, ($+3)
; Si ultimo < actual, hay que decrementar actual:
JNC | ($+2+2)
DEC | ensayos actual
JMP | INTERFAZ ANILLO ENSAYOS CYCLE

INTERFAZ ANILLO ENSAYOS ENTER:
; Si se presiona enter, se pasa el control al menú ; para editar parámetros de un ensayo:
JMP | INTERFAZ MENU EDITAR ENSAYO

INTERFAZ ANILLO ENSAYOS ESC:
JMP | INTERFAZ MENU PRINCIPAL
;;;;;;;;;;;;;;;;;;;;;;;;;;;;;;;;;;;;;;;;;;;;;;;;;;;;;;;;;;;;;;;;;;;;;;;;;;;;;;;; ;;;;;;;;;;;;;;;;;;;;;;;;;;;;;;;;;;;;;;;;;;;;;;;;;;;;;;;;;;;;;;;;;;;;;;;;;;;;;;;;
Albani - Arbelo Arrocha - Figueroa | 107 | 1.er cuatrimestre 2008

# 6.13. screens.asm

;;;;;;;;;;;;;;;;;;;;;;;;;;;;;;;;;;;;;;;;;;;;;;;;;;;;;;;;;;;;;;;;;;;;;;;;;;;;;;;; ;;;;;;;;;;;;;;;;;;;;;;;;;;;;;;;;;;;;;;;;;;;;;;;;;;;;;;;;;;;;;;;;;;;;;;;;;;;;;;;; ;; Rutinas para manipular pantallas gráficas. ;;;;;;;;;;;;;;;;;;;;;;;;;;;;;;;;;;;;;;;;;;;;;;;;;;;;;;;;;;;;;;;;;;;;;;;;;;;;;;;; ;;;;;;;;;;;;;;;;;;;;;;;;;;;;;;;;;;;;;;;;;;;;;;;;;;;;;;;;;;;;;;;;;;;;;;;;;;;;;;;;

;;;;;;;;;;;;;;;;;;;;;;;;;;;;;;;;;;;;;;;;;;;;;;;;;;;;;;;;;;;;;;;;;;;;;;;;;;;;;;;; ;;;;;;;;;;;;;;;;;;;;;;;;;;;;;;;;;;;;;;;;;;;;;;;;;;;;;;;;;;;;;;;;;;;;;;;;;;;;;;;; ;; Definiciones:
;;;;;;;;;;;;;;;;;;;;;;;;;;;;;;;;;;;;;;;;;;;;;;;;;;;;;;;;;;;;;;;;;;;;;;;;;;;;;;;; ;;;;;;;;;;;;;;;;;;;;;;;;;;;;;;;;;;;;;;;;;;;;;;;;;;;;;;;;;;;;;;;;;;;;;;;;;;;;;;;;

; Dirección en memoria ROM del logo de FIUBA:
SCREENS LOGOFIUBA ADDRESS | EQU | 1000H
;;;;;;;;;;;;;;;;;;;;;;;;;;;;;;;;;;;;;;;;;;;;;;;;;;;;;;;;;;;;;;;;;;;;;;;;;;;;;;;; ;;;;;;;;;;;;;;;;;;;;;;;;;;;;;;;;;;;;;;;;;;;;;;;;;;;;;;;;;;;;;;;;;;;;;;;;;;;;;;;;

;;;;;;;;;;;;;;;;;;;;;;;;;;;;;;;;;;;;;;;;;;;;;;;;;;;;;;;;;;;;;;;;;;;;;;;;;;;;;;;; ;;;;;;;;;;;;;;;;;;;;;;;;;;;;;;;;;;;;;;;;;;;;;;;;;;;;;;;;;;;;;;;;;;;;;;;;;;;;;;;; ;; Macros:
;;;;;;;;;;;;;;;;;;;;;;;;;;;;;;;;;;;;;;;;;;;;;;;;;;;;;;;;;;;;;;;;;;;;;;;;;;;;;;;; ;;;;;;;;;;;;;;;;;;;;;;;;;;;;;;;;;;;;;;;;;;;;;;;;;;;;;;;;;;;;;;;;;;;;;;;;;;;;;;;;

;;;;;;;;;;;;;;;;;;;;;;;;;;;;;;;;;;;;;;;;;;;;;;;;;;;;;;;;;;;;;;;;;;;;;;;;;;;;;;;; ;; Simplifica la grabación de una pantalla desde memoria de código a ROM. ;;;;;;;;;;;;;;;;;;;;;;;;;;;;;;;;;;;;;;;;;;;;;;;;;;;;;;;;;;;;;;;;;;;;;;;;;;;;;;;;
SCREENS MACRO WRITE FROM CODE | MACRO | rom address, code addres
MOV | rom address L, | #LOW(rom address)
MOV | rom address H, | #HIGH(rom address)
MOV | DPTR, #code addres
CALL | SCREENS WRITE TO ROM FROM CODE
ENDM
;;;;;;;;;;;;;;;;;;;;;;;;;;;;;;;;;;;;;;;;;;;;;;;;;;;;;;;;;;;;;;;;;;;;;;;;;;;;;;;; ;;;;;;;;;;;;;;;;;;;;;;;;;;;;;;;;;;;;;;;;;;;;;;;;;;;;;;;;;;;;;;;;;;;;;;;;;;;;;;;;

CSEG

;;;;;;;;;;;;;;;;;;;;;;;;;;;;;;;;;;;;;;;;;;;;;;;;;;;;;;;;;;;;;;;;;;;;;;;;;;;;;;;; ;;;;;;;;;;;;;;;;;;;;;;;;;;;;;;;;;;;;;;;;;;;;;;;;;;;;;;;;;;;;;;;;;;;;;;;;;;;;;;;; SCREENS WRITE TO ROM FROM CODE: ;;;;;;;;;;;;;;;;;;;;;;;;;;;;;;;;;;;;;;;;;;;;;;;;;;;;;;;;;;;;;;;;;;;;;;;;;;;;;;;; ;;;;;;;;;;;;;;;;;;;;;;;;;;;;;;;;;;;;;;;;;;;;;;;;;;;;;;;;;;;;;;;;;;;;;;;;;;;;;;;; ;; Rutina para enviar una pantalla de 1024 bytes desde memoria de código
;; hacia ROM.
;;;;;;;;;;;;;;;;;;;;;;;;;;;;;;;;;;;;;;;;;;;;;;;;;;;;;;;;;;;;;;;;;;;;;;;;;;;;;;;; ;;;;;;;;;;;;;;;;;;;;;;;;;;;;;;;;;;;;;;;;;;;;;;;;;;;;;;;;;;;;;;;;;;;;;;;;;;;;;;;; ;; Requisitos:
;; −−−−−−−−−−
;; | La dirección del primer byte en DPTR.
;;
;; Registros alterados:
;; −−−−−−−−−−−−−−−−−−−
;; | B, A, C
;;;;;;;;;;;;;;;;;;;;;;;;;;;;;;;;;;;;;;;;;;;;;;;;;;;;;;;;;;;;;;;;;;;;;;;;;;;;;;;; ROM MACRO SELECT
MOV | B, #16d
SCREENS WRITE TO ROM FROM CODE LOOP:
CALL | ROM WRITE PAGE FROM CODE
CALL | ROM INC ADDRESS 64
DJNZ | B, SCREENS WRITE TO ROM FROM CODE LOOP
Albani - Arbelo Arrocha - Figueroa | 108 | 1.er cuatrimestre 2008

RET
;;;;;;;;;;;;;;;;;;;;;;;;;;;;;;;;;;;;;;;;;;;;;;;;;;;;;;;;;;;;;;;;;;;;;;;;;;;;;;;; ;;;;;;;;;;;;;;;;;;;;;;;;;;;;;;;;;;;;;;;;;;;;;;;;;;;;;;;;;;;;;;;;;;;;;;;;;;;;;;;;

;;;;;;;;;;;;;;;;;;;;;;;;;;;;;;;;;;;;;;;;;;;;;;;;;;;;;;;;;;;;;;;;;;;;;;;;;;;;;;;; ;;;;;;;;;;;;;;;;;;;;;;;;;;;;;;;;;;;;;;;;;;;;;;;;;;;;;;;;;;;;;;;;;;;;;;;;;;;;;;;; SCREENS DUMP TO DISPLAY FROM ROM: ;;;;;;;;;;;;;;;;;;;;;;;;;;;;;;;;;;;;;;;;;;;;;;;;;;;;;;;;;;;;;;;;;;;;;;;;;;;;;;;; ;;;;;;;;;;;;;;;;;;;;;;;;;;;;;;;;;;;;;;;;;;;;;;;;;;;;;;;;;;;;;;;;;;;;;;;;;;;;;;;; ;; Rutina para mostrar una pantalla grabada en ROM en el display. ;;;;;;;;;;;;;;;;;;;;;;;;;;;;;;;;;;;;;;;;;;;;;;;;;;;;;;;;;;;;;;;;;;;;;;;;;;;;;;;; ;;;;;;;;;;;;;;;;;;;;;;;;;;;;;;;;;;;;;;;;;;;;;;;;;;;;;;;;;;;;;;;;;;;;;;;;;;;;;;;; ;; Requisitos:
;; −−−−−−−−−−
;;
;;
;; Registros alterados:
;; −−−−−−−−−−−−−−−−−−−
;;
;;;;;;;;;;;;;;;;;;;;;;;;;;;;;;;;;;;;;;;;;;;;;;;;;;;;;;;;;;;;;;;;;;;;;;;;;;;;;;;;
CALL | DISPLAY OFF
MOV | B, #64d
CALL | SCREENS DUMP TO DISPLAY FROM ROM SECTOR
MOV | B, #128d
CALL | SCREENS DUMP TO DISPLAY FROM ROM SECTOR
CALL | DISPLAY ON
RET

SCREENS DUMP TO DISPLAY FROM ROM SECTOR:
MOV | display page, #0d
SCREENS DUMP TO DISPLAY FROM ROM LOOP PAGES:
CALL | ROM READ PAGE TO BUFFER
CALL | ROM INC ADDRESS 64
MOV | A, B
CLR | C
SUBB | A, #64d
MOV | display column, A
MOV | R0, #rom page buffer
SCREENS DUMP TO DISPLAY FROM ROM LOOP COLUMNS:
MOV | A, @R0
MOV | display data, A
CALL | DISPLAY PUT BYTE
INC | R0
MOV | A, display column
CJNE | A, B, SCREENS DUMP TO DISPLAY FROM ROM LOOP COLUMNS
INC | display page
MOV | A, display page
CJNE | A, #8d, SCREENS DUMP TO DISPLAY FROM ROM LOOP PAGES

RET
;;;;;;;;;;;;;;;;;;;;;;;;;;;;;;;;;;;;;;;;;;;;;;;;;;;;;;;;;;;;;;;;;;;;;;;;;;;;;;;; ;;;;;;;;;;;;;;;;;;;;;;;;;;;;;;;;;;;;;;;;;;;;;;;;;;;;;;;;;;;;;;;;;;;;;;;;;;;;;;;;

;;;;;;;;;;;;;;;;;;;;;;;;;;;;;;;;;;;;;;;;;;;;;;;;;;;;;;;;;;;;;;;;;;;;;;;;;;;;;;;; ;;;;;;;;;;;;;;;;;;;;;;;;;;;;;;;;;;;;;;;;;;;;;;;;;;;;;;;;;;;;;;;;;;;;;;;;;;;;;;;; SCREEN:
; Esta línea debe ser habilitada cuando se desee ensamblar un programa
; para cargar una imagen desde memoria de código a memoria ROM: ;$INCLUDE(imagenes/logofiuba.asm) ;;;;;;;;;;;;;;;;;;;;;;;;;;;;;;;;;;;;;;;;;;;;;;;;;;;;;;;;;;;;;;;;;;;;;;;;;;;;;;;; ;;;;;;;;;;;;;;;;;;;;;;;;;;;;;;;;;;;;;;;;;;;;;;;;;;;;;;;;;;;;;;;;;;;;;;;;;;;;;;;;
Albani - Arbelo Arrocha - Figueroa | 109 | 1.er cuatrimestre 2008

# 6.14. misc.asm

;;;;;;;;;;;;;;;;;;;;;;;;;;;;;;;;;;;;;;;;;;;;;;;;;;;;;;;;;;;;;;;;;;;;;;;;;;;;;;;; ;;;;;;;;;;;;;;;;;;;;;;;;;;;;;;;;;;;;;;;;;;;;;;;;;;;;;;;;;;;;;;;;;;;;;;;;;;;;;;;; ;; Conjunto de rutinas y definiciones misceláneas. ;;;;;;;;;;;;;;;;;;;;;;;;;;;;;;;;;;;;;;;;;;;;;;;;;;;;;;;;;;;;;;;;;;;;;;;;;;;;;;;; ;;;;;;;;;;;;;;;;;;;;;;;;;;;;;;;;;;;;;;;;;;;;;;;;;;;;;;;;;;;;;;;;;;;;;;;;;;;;;;;; ;;
;; | Rutinas disponibles:
;; | −−−−−−−−−−−−−−−−−−−
;; | BCD2HEX: convierte 5 dígitos BCD a HEX.
;; | HEX2ASCII: convierte 2 bytes HEX a 5 dígitos ASCII.
;; | DIV16: realiza divisiones enteras de 16 bits.
;; | MUL16: realiza multiplicaciones enteras de 16 bits.
;; | DELAY ONE SECOND: delay por software de 1 segundo.
;; | DELAY ONE MSEC: delay por software de 1 milisegundo.
;; | DELAY TEN MSEC: delay por software de 10 milisegundos.
;;
;;;;;;;;;;;;;;;;;;;;;;;;;;;;;;;;;;;;;;;;;;;;;;;;;;;;;;;;;;;;;;;;;;;;;;;;;;;;;;;; ;;;;;;;;;;;;;;;;;;;;;;;;;;;;;;;;;;;;;;;;;;;;;;;;;;;;;;;;;;;;;;;;;;;;;;;;;;;;;;;;

CSEG

;;;;;;;;;;;;;;;;;;;;;;;;;;;;;;;;;;;;;;;;;;;;;;;;;;;;;;;;;;;;;;;;;;;;;;;;;;;;;;;; ;;;;;;;;;;;;;;;;;;;;;;;;;;;;;;;;;;;;;;;;;;;;;;;;;;;;;;;;;;;;;;;;;;;;;;;;;;;;;;;; BCD2HEX:
;;;;;;;;;;;;;;;;;;;;;;;;;;;;;;;;;;;;;;;;;;;;;;;;;;;;;;;;;;;;;;;;;;;;;;;;;;;;;;;; ;;;;;;;;;;;;;;;;;;;;;;;;;;;;;;;;;;;;;;;;;;;;;;;;;;;;;;;;;;;;;;;;;;;;;;;;;;;;;;;; ;; Rutina para convertir un entero de 5 dígitos en BCD,
;; a su representación binaria de 2 bytes.
;; (Sólo arroja resultados coherentes para números menores a 2ˆ16 − 1) ;;;;;;;;;;;;;;;;;;;;;;;;;;;;;;;;;;;;;;;;;;;;;;;;;;;;;;;;;;;;;;;;;;;;;;;;;;;;;;;; ;;;;;;;;;;;;;;;;;;;;;;;;;;;;;;;;;;;;;;;;;;;;;;;;;;;;;;;;;;;;;;;;;;;;;;;;;;;;;;;; ;;
;; Requisitos:
;; −−−−−−−−−−
;; | Unidades en R1.
;; | Decenas en R2.
;; | Centenas en R3.
;; | Millares en R4.
;; | Decenas de millares en R5.
;; | Espacio de 5 bytes disponible en el stack.
;;
;; Registros afectados:
;; −−−−−−−−−−−−−−−−−−−
;; | Todos los registros del banco seleccionado.
;; | R2 <− parte alta del entero.
;; | R3 <− parte baja del entero.
;;
;;;;;;;;;;;;;;;;;;;;;;;;;;;;;;;;;;;;;;;;;;;;;;;;;;;;;;;;;;;;;;;;;;;;;;;;;;;;;;;; ;;;;;;;;;;;;;;;;;;;;;;;;;;;;;;;;;;;;;;;;;;;;;;;;;;;;;;;;;;;;;;;;;;;;;;;;;;;;;;;;

; Se salvan las unidades:
MOV | A, R1
PUSH | Acc

; Se salvan las decenas:
MOV | A, R2
PUSH | Acc

; Se salvan las centenas:
MOV | A, R3
PUSH | Acc

; Se salvan los millares:

Albani - Arbelo Arrocha - Figueroa | 110 | 1.er cuatrimestre 2008

MOV | A, R4
PUSH | Acc

; Se pesan las decenas de millares:
MOV | A, R5
MOV | R6, #0d ; Parte alta.
MOV | R7, A
MOV | R4, #HIGH(10000d)
MOV | R5, | #LOW(10000d)
CALL | MUL16
; R2 <− Byte alto del producto. ; R3 <− Byte bajo del producto.

; Se recuperan los millares:
POP | Acc
MOV | R4, A

; Se salva el resultado intermedio en el stack:
MOV | A, R2
PUSH | Acc
MOV | A, R3
PUSH | Acc

; Se pesan los millares:
MOV | A, R4
MOV | R6, #0d ; Parte alta.
MOV | R7, A
MOV | R4, #HIGH(1000d)
MOV | R5, | #LOW(1000d)
CALL | MUL16
; R2 <− Byte alto del producto.
; R3 <− Byte bajo del producto.

; Se recupera la parte baja del resultado intermedio:
POP | Acc

; Se suma la parte baja del aporte de los millares:
ADD | A, R3
MOV | R3, A

; Se recupera la parte alta del resultado intermedio:
POP | Acc

; Se suma la parte alta del aporte de los millares:
ADDC | A, R2
MOV | R2, A

; Se recuperan las centenas y se las pesa:
POP | Acc
MOV | B, #100d
MUL | AB

; Se suma la parte baja del aporte de las centenas:
ADD | A, R3
MOV | R3, A

; Se suma la parte alta del aporte de las centenas:
MOV | A, B
ADDC | A, R2
MOV | R2, A

; Se recuperan las decenas:
POP | Acc
MOV | B, #10d
MUL | AB
Albani - Arbelo Arrocha - Figueroa | 111 | 1.er cuatrimestre 2008

; Se suma el aporte de las decenas
; a la parte baja del resultado intermedio:
ADD | A, R3
MOV | R3, A

; Se suma el carry a la parte alta del resultado intermedio:
CLR | A
ADDC | A, R2
MOV | R2, A

; Se recuperan las unidades:
POP | Acc
ADD | A, R3
MOV | R3, A

; Se suma el carry a la parte alta del resultado intermedio:
CLR | A
ADDC | A, R2
MOV | R2, A

; R2 <− Byte alto del resultado. ; R3 <− Byte bajo del resultado.

RET
;;;;;;;;;;;;;;;;;;;;;;;;;;;;;;;;;;;;;;;;;;;;;;;;;;;;;;;;;;;;;;;;;;;;;;;;;;;;;;;; ;;;;;;;;;;;;;;;;;;;;;;;;;;;;;;;;;;;;;;;;;;;;;;;;;;;;;;;;;;;;;;;;;;;;;;;;;;;;;;;;

;;;;;;;;;;;;;;;;;;;;;;;;;;;;;;;;;;;;;;;;;;;;;;;;;;;;;;;;;;;;;;;;;;;;;;;;;;;;;;;; ;;;;;;;;;;;;;;;;;;;;;;;;;;;;;;;;;;;;;;;;;;;;;;;;;;;;;;;;;;;;;;;;;;;;;;;;;;;;;;;; HEX2ASCII:
;;;;;;;;;;;;;;;;;;;;;;;;;;;;;;;;;;;;;;;;;;;;;;;;;;;;;;;;;;;;;;;;;;;;;;;;;;;;;;;; ;;;;;;;;;;;;;;;;;;;;;;;;;;;;;;;;;;;;;;;;;;;;;;;;;;;;;;;;;;;;;;;;;;;;;;;;;;;;;;;; ;; Rutina para convertir un entero de 2 bytes representado en binario,
;; a sus 5 dígitos decimales en código ASCII.
;;
;; Construida sobre la base del algoritmo disponible en
;; http://www.8052.com/codelib/bcd.asm ;;;;;;;;;;;;;;;;;;;;;;;;;;;;;;;;;;;;;;;;;;;;;;;;;;;;;;;;;;;;;;;;;;;;;;;;;;;;;;;; ;;;;;;;;;;;;;;;;;;;;;;;;;;;;;;;;;;;;;;;;;;;;;;;;;;;;;;;;;;;;;;;;;;;;;;;;;;;;;;;; ;;
;; Requisitos:
;; −−−−−−−−−−
;; | El byte alto en R1 y el byte bajo en R2.
;;
;; Registros afectados:
;; −−−−−−−−−−−−−−−−−−−
;; | A, B, C
;; | R3 <− Decenas de millares.
;; | R4 <− Millares.
;; | R5 <− Centenas.
;; | R6 <− Decenas.
;; | R7 <− Unidades.
;; | R1 <− 0
;;
;;;;;;;;;;;;;;;;;;;;;;;;;;;;;;;;;;;;;;;;;;;;;;;;;;;;;;;;;;;;;;;;;;;;;;;;;;;;;;;; ;;;;;;;;;;;;;;;;;;;;;;;;;;;;;;;;;;;;;;;;;;;;;;;;;;;;;;;;;;;;;;;;;;;;;;;;;;;;;;;;

; Se limpian los registros que se utilizarán para devolver el resultado:
MOV | R3, #0d
MOV | R4, #0d
MOV | R5, #0d
MOV | R6, #0d
MOV | R7, #0d

; Se guardan las unidades en R7:

Albani - Arbelo Arrocha - Figueroa | 112 | 1.er cuatrimestre 2008

MOV | B, #10d
MOV | A, R2
DIV | AB
MOV | R7, B

; Se guardan las decenas en R6:
MOV | B, #10d
DIV | AB
MOV | R6, B

; Se guardan las centenas en R5:
MOV | R5, A

; Si no hay parte alta, no hay más nada que hacer:
CJNE | R1, #0d, HEX2ASCII HIGH
SJMP | HEX2ASCII END

; Hasta el momento se tienen las centenas (R5), las decenas (R6) y las ; unidades (R7) de la parte *baja del número completo*.
;
; Dado que R1 contiene la parte alta, el numero completo puede escribirse ; de la siguiente manera: R1*(256) + B, donde B=R5R6R7. Expresado de otra ; forma:
; | R1
; | \
; | / | 256 + B = B +256 + 256 +256 +.... donde la cantidad de veces
; | n=1 | que se suma 256 es
; | | justamente R1.
; Entonces se suma R1 veces 256 más la parte baja ya convertida (B). HEX2ASCII HIGH:
MOV | A, #6d
ADD | A, R7
MOV | B, #10d
DIV | AB
MOV | R7, B
ADD | A, #5d
ADD | A, R6
MOV | B, #10d
DIV | AB
MOV | R6, B
ADD | A, #2d
ADD | A, R5
MOV | B, #10d
DIV | AB
MOV | R5, B

; Se realiza una consideracion importante:
; Es posible que al sumar 256, el resultado no pueda ser representado por ; tres dígitos. Éste se almacena en R4:
CJNE | R4, #0d, ($+3+2)
SJMP | $+2+1
ADD | A, R4
MOV | R4, A
DJNZ | R1, HEX2ASCII HIGH

; Hasta el momento se tiene un numero que tiene la siguiente forma:
; N=R4R5R6R7 , donde R7 representa las unidades del número *completo*, R6 ; las decenas y R5 las centenas. R4 representa los millares y las decenas ; de millares, codigicado en hexadecimal. Se realiza una nueva división ; por diez.
Albani - Arbelo Arrocha - Figueroa | 113 | 1.er cuatrimestre 2008

MOV | B, #10d
MOV | A, R4
DIV | AB
MOV | R4, B
MOV | R3, A

HEX2ASCII END:
; Finalmente, se suma el código ASCII del '0' a todos ; los dígitos BCD para convertirlos a ASCII:
MOV | A, R3
ADD | A, #'0'
MOV | R3, A
MOV | A, R4
ADD | A, #'0'
MOV | R4, A
MOV | A, R5
ADD | A, #'0'
MOV | R5, A
MOV | A, R6
ADD | A, #'0'
MOV | R6, A
MOV | A, R7
ADD | A, #'0'
MOV | R7, A

RET
;;;;;;;;;;;;;;;;;;;;;;;;;;;;;;;;;;;;;;;;;;;;;;;;;;;;;;;;;;;;;;;;;;;;;;;;;;;;;;;; ;;;;;;;;;;;;;;;;;;;;;;;;;;;;;;;;;;;;;;;;;;;;;;;;;;;;;;;;;;;;;;;;;;;;;;;;;;;;;;;;

;;;;;;;;;;;;;;;;;;;;;;;;;;;;;;;;;;;;;;;;;;;;;;;;;;;;;;;;;;;;;;;;;;;;;;;;;;;;;;;; ;;;;;;;;;;;;;;;;;;;;;;;;;;;;;;;;;;;;;;;;;;;;;;;;;;;;;;;;;;;;;;;;;;;;;;;;;;;;;;;; DIV16:
;;;;;;;;;;;;;;;;;;;;;;;;;;;;;;;;;;;;;;;;;;;;;;;;;;;;;;;;;;;;;;;;;;;;;;;;;;;;;;;; ;;;;;;;;;;;;;;;;;;;;;;;;;;;;;;;;;;;;;;;;;;;;;;;;;;;;;;;;;;;;;;;;;;;;;;;;;;;;;;;; ;; Rutina para dividir dos enteros de 2 bytes cada uno. ;;;;;;;;;;;;;;;;;;;;;;;;;;;;;;;;;;;;;;;;;;;;;;;;;;;;;;;;;;;;;;;;;;;;;;;;;;;;;;;; ;;;;;;;;;;;;;;;;;;;;;;;;;;;;;;;;;;;;;;;;;;;;;;;;;;;;;;;;;;;;;;;;;;;;;;;;;;;;;;;; ;;
;; Requisitos:
;; −−−−−−−−−−
;; | Dividendo: byte alto en R1; byte bajo en R0.
;; | Divisor: | byte alto en R3; byte bajo en R2.
;;
;; Registros afectados:
;; −−−−−−−−−−−−−−−−−−−
;; | A, B, C
;; | Cociente: byte alto en R3; byte bajo en R2.
;; | Resto: | byte alto en R1; byte bajo en R0.
;;
;;;;;;;;;;;;;;;;;;;;;;;;;;;;;;;;;;;;;;;;;;;;;;;;;;;;;;;;;;;;;;;;;;;;;;;;;;;;;;;; ;;;;;;;;;;;;;;;;;;;;;;;;;;;;;;;;;;;;;;;;;;;;;;;;;;;;;;;;;;;;;;;;;;;;;;;;;;;;;;;;

; Limpieza preliminar de registros necesarios:
CLR | C
MOV | R4, #0d
MOV | R5, #0d
MOV | B, #0d

; En el bucle siguiente, se rota hacia la izquierda al divisor ; hasta que alcance los 16 dígitos:

Albani - Arbelo Arrocha - Figueroa | 114 | 1.er cuatrimestre 2008

DIV16 ROTATE DIVISOR UNTIL 16 DIGIT:
; En B se cuenta la cantidad de bits rotados:
INC | B

; Se rota primero la parte baja, incluye al Carry, ; para utilizarlo luego con la parte alta:
MOV | A, R2
RLC | A
MOV | R2, A

; Se rota a la parte alta, junto al Carry que quedó ; de la rotación de la parte baja:
MOV | A, R3
RLC | A
MOV | R3, A

; Cuando luego de rotar hacia la izquiera a la parte alta el carry ; se enciende, es porque el divisor ya alcanzó los 16 dígitos.
; En ese caso, se finaliza la rotación:
JNC | DIV16 ROTATE DIVISOR UNTIL 16 DIGIT

; En el bucle siguiente, se rota hacia la derecha al nuevo divisor ; de 16 dígitos y en cada iteración se realiza una resta:
DIV16 ROTATE DIVISOR AND SUBSTRACT:
; Se rota hacia la derecha a la parte alta, incluyendo al Carry, ; para utilizarlo luego con la parte baja:
MOV | A, R3
RRC | A
MOV | R3, A

; Se rota hacia la derecha a la parte baja, junto al Carry que quedó ; de la rotación de la parte alta:
MOV | A, R2
RRC | A
MOV | R2, A

; Se guarda una copia del dividendo en R7/R6:
MOV | A, R1
MOV | R7, A
MOV | A, R0
MOV | R6, A

; Eliminamos el Carry (Borrow) para la resta.
CLR | C
; Se realiza la resta entre el dividendo (o lo que va quedando de él) ; y el divisor (rotado un paso en cada iteración):
; Parte baja:
MOV | A, R0
SUBB | A, R2
MOV | R0, A
; Parte alta:
MOV | A, R1
SUBB | A, R3
MOV | R1, A
JNC | DIV16 C | ;No hay Borrow. Sigue más adelante.

; Hubo Borrow. Se recupera la copia del dividendo para deshacer ; la substracción:
MOV | A, R7
MOV | R1, A
MOV | A, R6
MOV | R0, A

DIV16 C:

Albani - Arbelo Arrocha - Figueroa | 115 | 1.er cuatrimestre 2008

CPL | C
MOV | A, R4
RLC | A
MOV | R4, A
MOV | A, R5
RLC | A
MOV | R5, A

; Itera hasta que se rotaron hacia la derecha todos los bits
; del divisor que previamente se habían rotado hacia la izquierda:
DJNZ | B, DIV16 ROTATE DIVISOR AND SUBSTRACT

; Finalmente, se devuelve el resultado:
; Parte alta en R3:
MOV | A, R5
MOV | R3, A
; Parte baja en R2:
MOV | A, R4
MOV | R2, A

RET
;;;;;;;;;;;;;;;;;;;;;;;;;;;;;;;;;;;;;;;;;;;;;;;;;;;;;;;;;;;;;;;;;;;;;;;;;;;;;;;; ;;;;;;;;;;;;;;;;;;;;;;;;;;;;;;;;;;;;;;;;;;;;;;;;;;;;;;;;;;;;;;;;;;;;;;;;;;;;;;;;

;;;;;;;;;;;;;;;;;;;;;;;;;;;;;;;;;;;;;;;;;;;;;;;;;;;;;;;;;;;;;;;;;;;;;;;;;;;;;;;; ;;;;;;;;;;;;;;;;;;;;;;;;;;;;;;;;;;;;;;;;;;;;;;;;;;;;;;;;;;;;;;;;;;;;;;;;;;;;;;;; MUL16:
;;;;;;;;;;;;;;;;;;;;;;;;;;;;;;;;;;;;;;;;;;;;;;;;;;;;;;;;;;;;;;;;;;;;;;;;;;;;;;;; ;;;;;;;;;;;;;;;;;;;;;;;;;;;;;;;;;;;;;;;;;;;;;;;;;;;;;;;;;;;;;;;;;;;;;;;;;;;;;;;; ;; Rutina para multiplicar dos enteros de 2 bytes cada uno y obtener un
;; resultado de 24 bits.
;;
;; Tomada de http://www.8052.com/mul16.phtml
;;
;; Idea:
;; −−−−
;;
;; | Byte 4 | Byte 3 | Byte 2 | Byte 1
;; Factor 1: | | | R6 | R7
;; Factor 2: | | | R4 | R5
;; | −−−−−−−−−−−−−−−−−−−−−−−−−−−−−−−−−−−−−−−−−−
;; Producto: | R0 | R1 | R2 | R3
;;
;; 1. Se multiplica a R5 por R7, dejando el resultado de 16−bit en R2 y R3. ;; 2. Se multiplica a R5 por R6, sumando el resultado de 16−bit a R1 y a R2. ;; 3. Se multiplica a R4 por R7, sumando el resultado de 16−bit a R1 y a R2. ;; 4. Se multiplica a R4 por R6, sumando el resultado de 16−bit a R0 y a R1. ;;
;;;;;;;;;;;;;;;;;;;;;;;;;;;;;;;;;;;;;;;;;;;;;;;;;;;;;;;;;;;;;;;;;;;;;;;;;;;;;;;; ;;;;;;;;;;;;;;;;;;;;;;;;;;;;;;;;;;;;;;;;;;;;;;;;;;;;;;;;;;;;;;;;;;;;;;;;;;;;;;;; ;;
;; Requisitos:
;; −−−−−−−−−−
;; | Factor 1: byte alto en R6; byte bajo en R7.
;; | Factor 2: byte alto en R4; byte bajo en R5.
;;
;; Registros afectados:
;; −−−−−−−−−−−−−−−−−−−
;; | A, B, C
;; | Producto: 32 bits ordenados en R0/R1/R2/R3.
;;
;;;;;;;;;;;;;;;;;;;;;;;;;;;;;;;;;;;;;;;;;;;;;;;;;;;;;;;;;;;;;;;;;;;;;;;;;;;;;;;; ;;;;;;;;;;;;;;;;;;;;;;;;;;;;;;;;;;;;;;;;;;;;;;;;;;;;;;;;;;;;;;;;;;;;;;;;;;;;;;;;

; Se multiplica a R5 por R7:

Albani - Arbelo Arrocha - Figueroa | 116 | 1.er cuatrimestre 2008

MOV | A, R5
MOV | B, R7
MUL | AB
; Se dejan el resultado de 16−bit en R2 y R3: ;Parte alta a R2:
MOV | R2, B
;Parte baja a R3:
MOV | R3, A

; Se multiplica a R5 por R6:
MOV | A, R5
MOV | B, R6
MUL | AB
; Se suma el resultado de 16−bit a R1 y a R2: ; Parte baja a R2:
ADD | A, R2
MOV | R2, A
; Parte alta a R1:
MOV | A, B
ADDC | A, #0d
MOV | R1, A
; Se suma el eventual carry a R0:
CLR | A
ADDC | A, #0d
MOV | R0, A

; Se multiplica a R4 por R7:
MOV | A, R4
MOV | B, R7
MUL | AB
; Se suma el resultado de 16−bit a R1 y a R2: ; Parte baja a R2:
ADD | A, R2
MOV | R2, A
; Parte alta a R1:
MOV | A, B
ADDC | A, R1
MOV | R1, A
; Se suma el eventual carry a R0:
CLR | A
ADDC | A, R0
MOV | R0, A

; Se multiplica a R4 por R6:
MOV | A, R4
MOV | B, R6
MUL | AB
; Se suma el resultado de 16−bit a R0 y a R1: ; Parte baja a R1:
ADD | A, R1
MOV | R1, A
; Parte alta a R0:
MOV | A, B
ADDC | A, R0
MOV | R0, A

RET
;;;;;;;;;;;;;;;;;;;;;;;;;;;;;;;;;;;;;;;;;;;;;;;;;;;;;;;;;;;;;;;;;;;;;;;;;;;;;;;; ;;;;;;;;;;;;;;;;;;;;;;;;;;;;;;;;;;;;;;;;;;;;;;;;;;;;;;;;;;;;;;;;;;;;;;;;;;;;;;;;

;;;;;;;;;;;;;;;;;;;;;;;;;;;;;;;;;;;;;;;;;;;;;;;;;;;;;;;;;;;;;;;;;;;;;;;;;;;;;;;; ;;;;;;;;;;;;;;;;;;;;;;;;;;;;;;;;;;;;;;;;;;;;;;;;;;;;;;;;;;;;;;;;;;;;;;;;;;;;;;;;

Albani - Arbelo Arrocha - Figueroa | 117 | 1.er cuatrimestre 2008

;; Rutinas de delay por software.
;;
;; En un AT89S52, cada CM equivale a 12 Ciclos de clock, o sea 1 CM equivale
;; a 1 microsegundo si el clock es de 12 MHz.
;;
;;;;;;;;;;;;;;;;;;;;;;;;;;;;;;;;;;;;;;;;;;;;;;;;;;;;;;;;;;;;;;;;;;;;;;;;;;;;;;;; ;;;;;;;;;;;;;;;;;;;;;;;;;;;;;;;;;;;;;;;;;;;;;;;;;;;;;;;;;;;;;;;;;;;;;;;;;;;;;;;;

DELAY ONE SECOND:
; Se necesitan ejecutar 1000000 CM para lograr 1 segundo.

; Ciclos de máquina de cada instrucción:
MOV | R7, #130d | ; 1 CM * 1
DELAY ONE SECOND A:
MOV | R6, #15d | ; 1 CM * R7
DELAY ONE SECOND B:
MOV | R5, #255d | ; 1 CM * R6 * R7
DJNZ | R5, $ | ; 2 CM * R5 * R6 * R7
DJNZ | R6, DELAY ONE SECOND B | ; 2 CM * R6 * R7
NOP | | ; 1 CM * R7
DJNZ | R7, DELAY ONE SECOND A | ; 2 CM * R7
RET | | ; 2 CM * 1
| | ; Total: 3 + R7·(4 + R6·(3 + 2·R5))
| | ; Con R5 = 255d, R6 = 15d y R7 = 130d,
| | ; se logran 1000873 CM.
| | ; Error menor al 0.1 %.

DELAY ONE MSEC:
; Se necesitan ejecutar 1000 CM para lograr 1 milisegundo.
| | ; Ciclos de máquina de cada instrucción:
MOV | R7, #165d | ; 1 CM * 1
MOV | R6, #2d | ; 1 CM * 1
DELAY ONE MSEC LOOP:
NOP | | ; 1 CM * R7 * R6
DJNZ | R7, DELAY ONE MSEC LOOP ; 2 CM * R7 * R6
MOV | R7, #165d | ; 1 CM * R6
DJNZ | R6, DELAY ONE MSEC LOOP ; 2 CM * R6
RET | | ; 2 CM * 1
| | ; Total: 4 + R6·(3 + 3·R7)
| | ; Con R7 = 165 y R6 = 2,
| | ; se logran 1000 CM.

DELAY TEN MSEC:
; Se necesitan ejecutar 10000 CM para lograr 10 milisegundo.

; Ciclos de máquina de cada instrucción:
MOV | R7, #166d | ; 1 CM * 1
MOV | R6, #20d | ; 1 CM * 1
DELAY TEN MSEC LOOP:
NOP | | ; 1 CM * R7 * R6
DJNZ | R7, DELAY TEN MSEC LOOP ; 2 CM * R7 * R6
MOV | R7, #166d | ; 1 CM * R6
DJNZ | R6, DELAY TEN MSEC LOOP ; 2 CM * R6
RET | | ; 2 CM * 1
| | ; Total: 4 + R6·(3 + 3·R7)
| | ; Con R7 = 166 y R6 = 20,
| | ; se logran 10024 CM.

;;;;;;;;;;;;;;;;;;;;;;;;;;;;;;;;;;;;;;;;;;;;;;;;;;;;;;;;;;;;;;;;;;;;;;;;;;;;;;;; ;;;;;;;;;;;;;;;;;;;;;;;;;;;;;;;;;;;;;;;;;;;;;;;;;;;;;;;;;;;;;;;;;;;;;;;;;;;;;;;;

Albani - Arbelo Arrocha - Figueroa | 118 | 1.er cuatrimestre 2008

# 6.15. macros.asm

;;;;;;;;;;;;;;;;;;;;;;;;;;;;;;;;;;;;;;;;;;;;;;;;;;;;;;;;;;;;;;;;; ;;;;;;;;;;;;;;;;;;;;;;;;;;;;;;;;;;;;;;;;;;;;;;;;;;;;;;;;;;;;;;;;;
DISPLAY MACRO SELECT | MACRO
MOV | DISPLAY DATABUS, #00h
MOV | decoder selected device, #DECODER DISPLAY
CALL | DECODER SELECT DEVICE
ENDM
KEYPAD MACRO SELECT | MACRO
MOV | KEYPAD DATABUS, #00h
MOV | decoder selected device, #DECODER KEYPAD
CALL | DECODER SELECT DEVICE
ENDM
ROM MACRO SELECT | MACRO
MOV | decoder selected device, #DECODER ROM
CALL | DECODER SELECT DEVICE
ENDM
ADC MACRO SELECT | MACRO
MOV | decoder selected device, #DECODER ADC
CALL | DECODER SELECT DEVICE
ENDM
;;;;;;;;;;;;;;;;;;;;;;;;;;;;;;;;;;;;;;;;;;;;;;;;;;;;;;;;;;;;;;;;; ;;;;;;;;;;;;;;;;;;;;;;;;;;;;;;;;;;;;;;;;;;;;;;;;;;;;;;;;;;;;;;;;;

START SENSIBLE OP MACRO
CLR | EA
NOP
ENDM

END SENSIBLE OP MACRO
SETB | EA
NOP
ENDM
;;;;;;;;;;;;;;;;;;;;;;;;;;;;;;;;;;;;;;;;;;;;;;;;;;;;;;;;;;;;;;;;; ;;;;;;;;;;;;;;;;;;;;;;;;;;;;;;;;;;;;;;;;;;;;;;;;;;;;;;;;;;;;;;;;;
MACRO SELECT BANK 0 | MACRO
CLR | RS0
CLR | RS1
ENDM
MACRO SELECT BANK 1 | MACRO
SETB | RS0
CLR | RS1
ENDM
MACRO SELECT BANK 2 | MACRO
CLR | RS0
SETB | RS1
ENDM
MACRO SELECT BANK 3 | MACRO
SETB | RS0
SETB | RS1
ENDM
Albani - Arbelo Arrocha - Figueroa | 119 | 1.er cuatrimestre 2008

Albani - Arbelo Arrocha - Figueroa | 120 | 1.er cuatrimestre 2008

# 7. Esquemáticos

# 7.1. Dispositivo

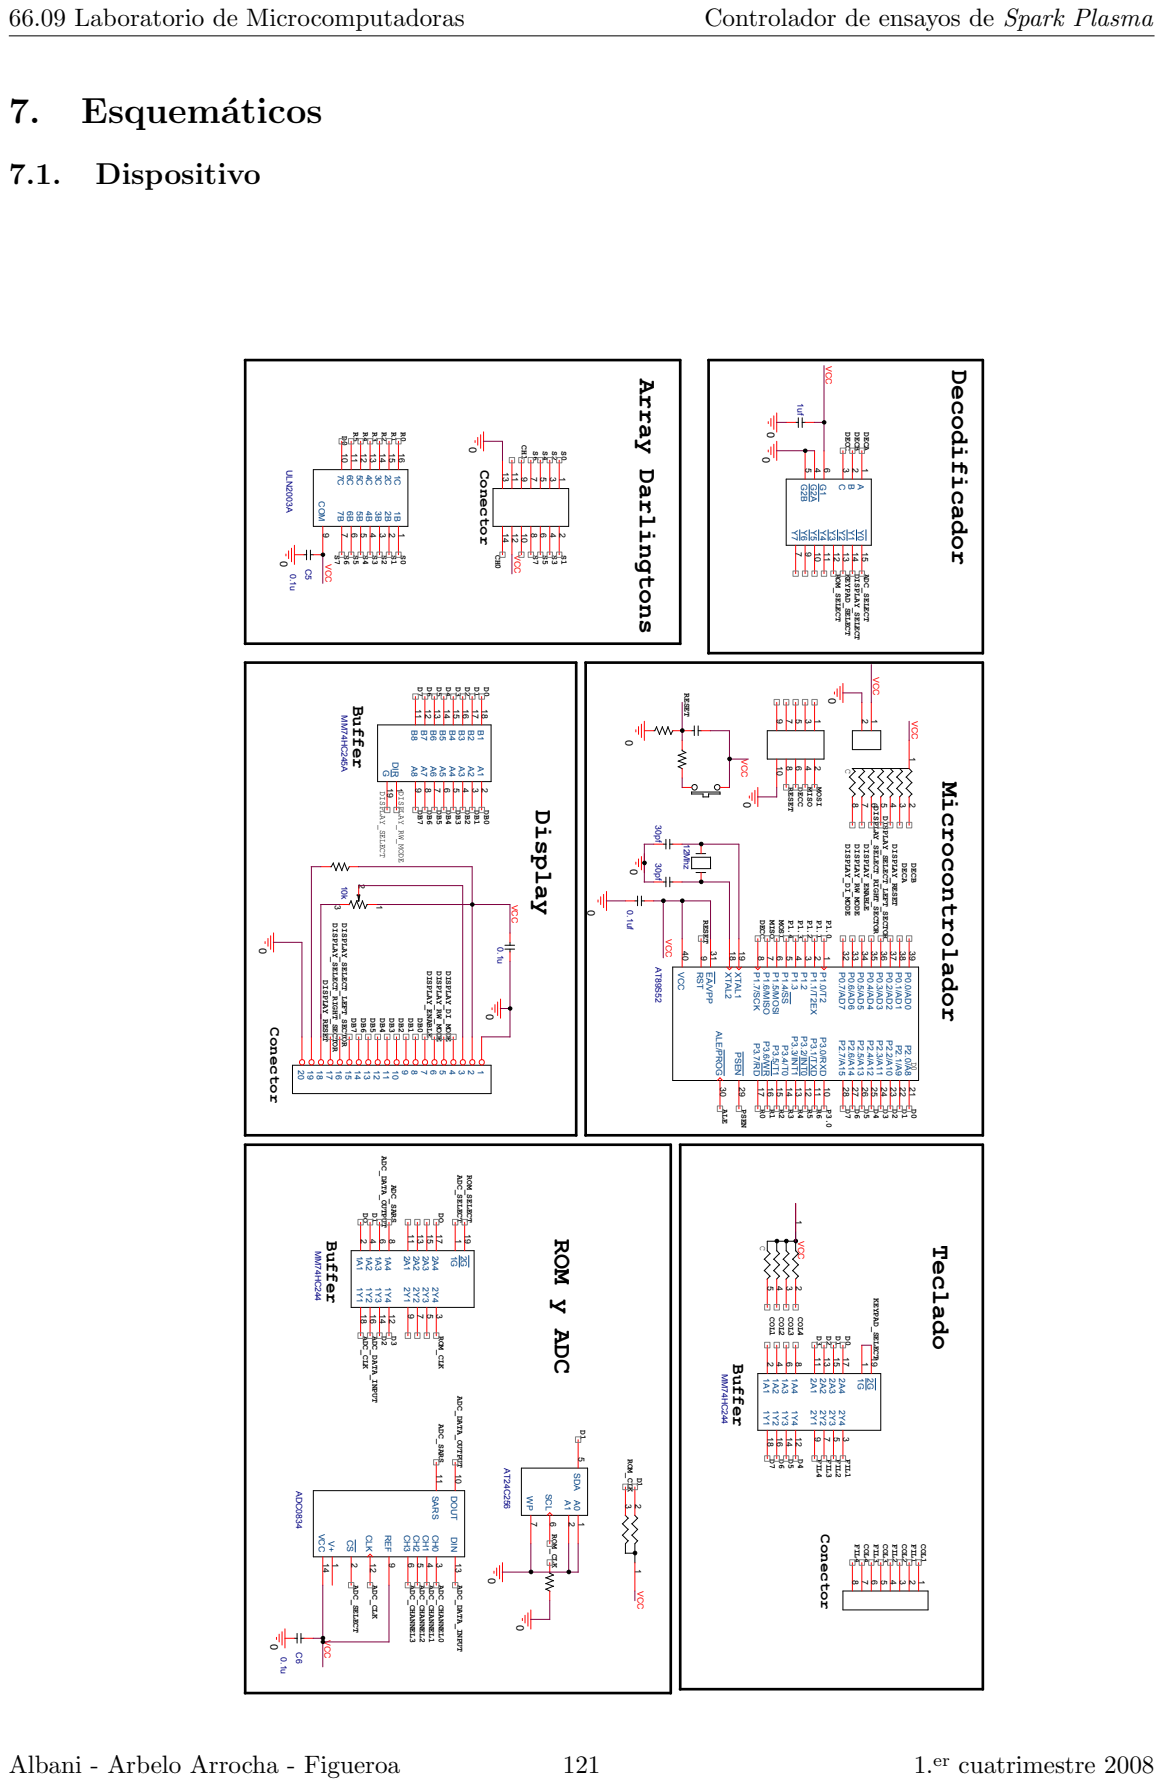
[picture p17: page 121]

# 7.2. Circuito de prueba

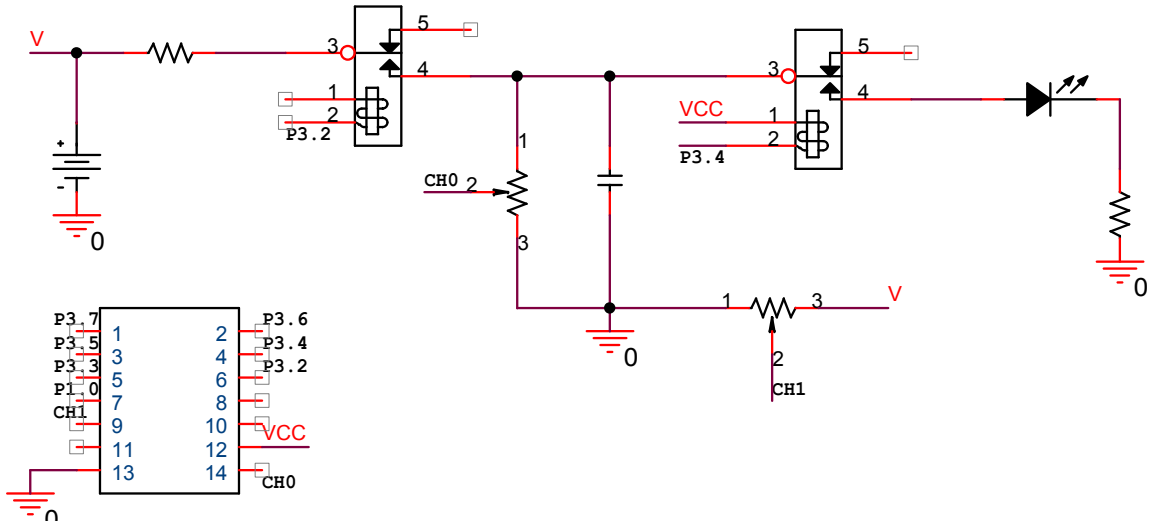
[picture p18: figure]
VCC

0

Albani - Arbelo Arrocha - Figueroa | 122 | 1.er cuatrimestre 2008
