Stachovsky/TrabajoProfesional/Documentacion/Diagramas/diagramaBloquesDetalle.pdf

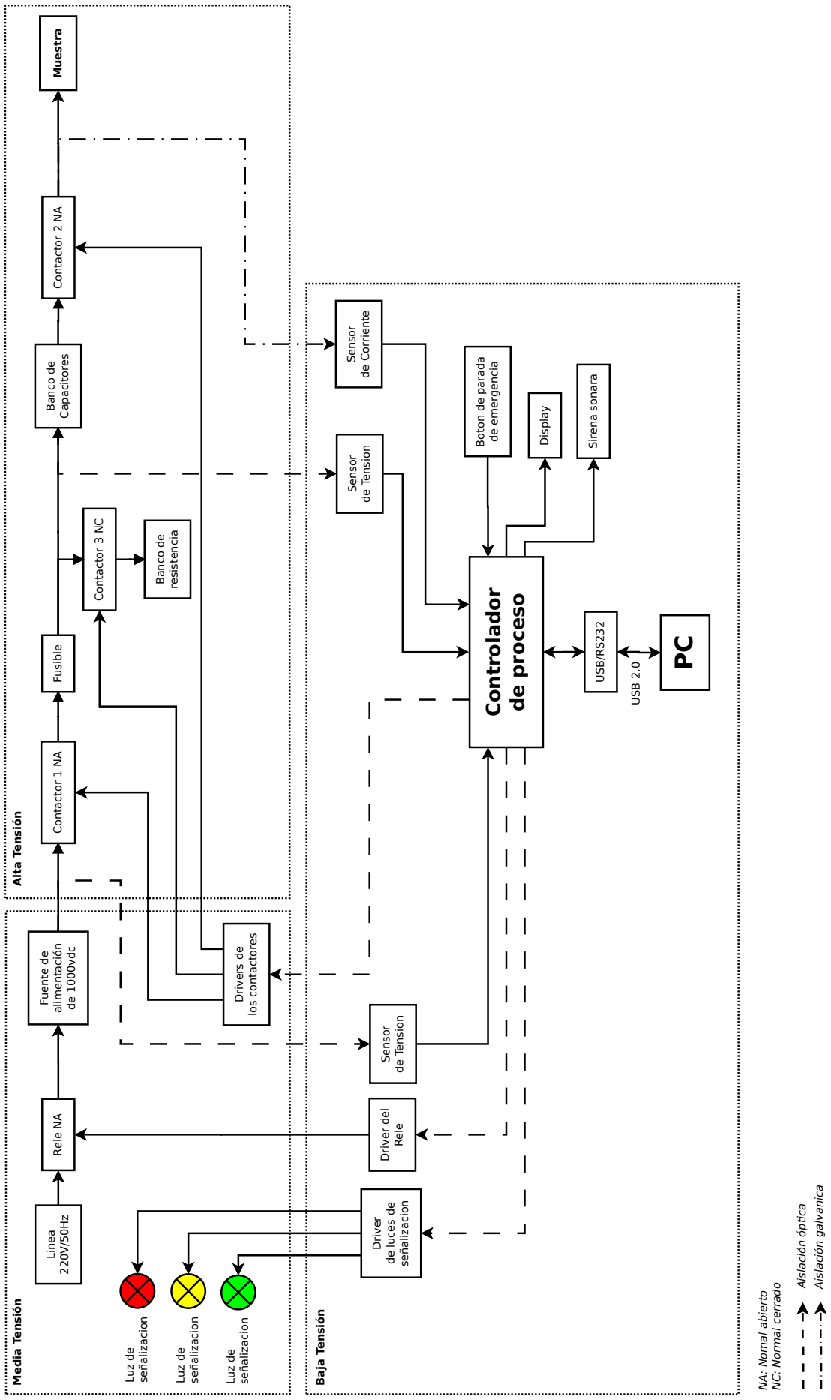
[picture p19: figure]
Linea; Banco de; Capacitores Contactor 1 NA; Sensor; de Corriente; de Tension; Contactor 2 NA; Controlador; de proceso; Display; Contactor 3 NC; resistencia; Muestra Fusible; Luz de; señalizacion; Sirena sonara; Fuente de; alimentación; de 1000vdc; USB 2.0; Rele NA; Driver del; Rele; NA: Nomal abierto; NC: Normal cerrado; Drivers de; los contactores; Driver; de luces de; Media Tensión; Alta Tensión; Baja Tensión; Aislación óptica; Aislación galvanica; USB/RS232; Boton de parada; de emergencia
