Stachovsky/TrabajoProfesional/Documentacion/Diagramas/diagramaBloquesEspecificaciones.pdf

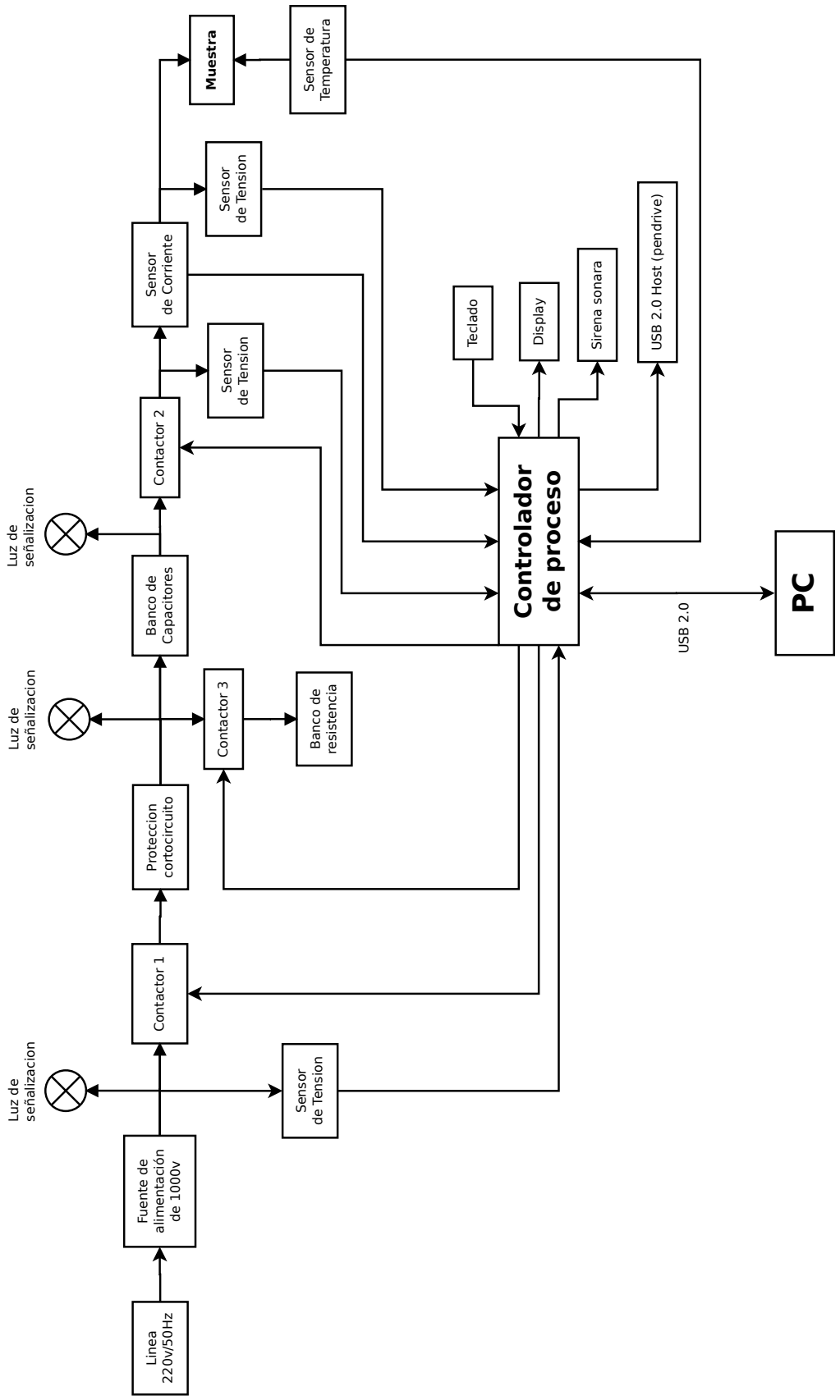
[picture p20: figure]
Linea; Banco de; Sensor; de Tension; Contactor 2; Controlador; de proceso Display; Contactor 3; resistencia; Muestra; Sensor de; Temperatura; Proteccion; cortocircuito; Luz de; señalizacion; Teclado; Sirena sonara; Fuente de; alimentación; USB 2.0; USB 2.0 Host (pendrive)

# Capacitores Contactor 1 Sensor de Corriente
