Stachovsky/TrabajoProfesional/Documentacion/Diagramas/InterfacesMicro.pdf

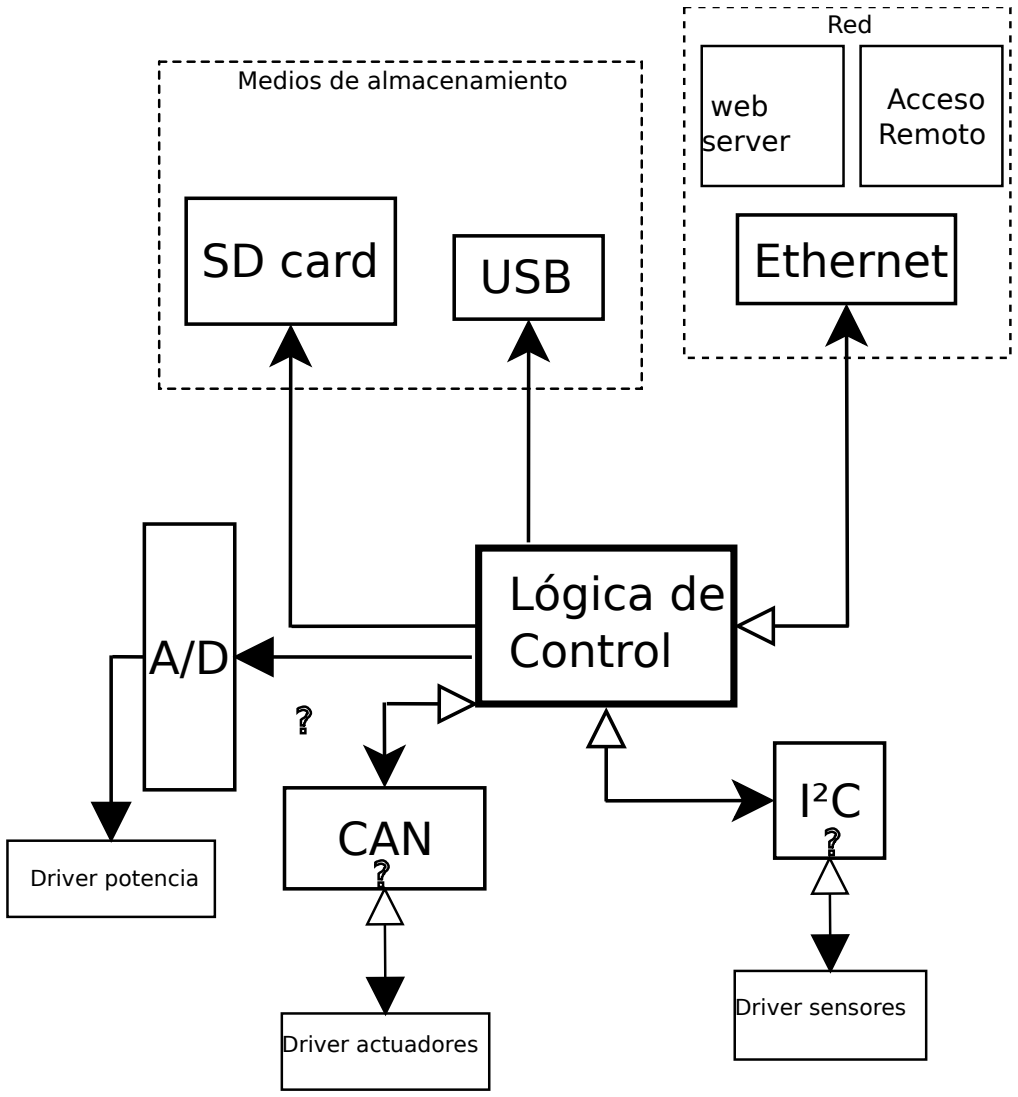
[picture p21: figure]
Lógica de Control; USB; Ethernet; CAN; SD card; I²C; Driver actuadores; Driver sensores; web server; Acceso Remoto; Medios de almacenamiento; Red; Driver potencia

*) Tanto CAN como I2C pueden llegar a ser complementarios y/o excluyentes entre si, el diagrama propone un ejemplo de aplicación siendo solo eso. Lo mismo ocurre con el conversor A/D, sin embargo esto esta pensado para controlar el driver de disparo del capacitor (en una primera instancia)
