Stachovsky/TrabajoProfesional/Documentacion/DocumentacionProyectoAnterior/Micro_Soft/66.12_tp2.pdf

# 66.12 - Introducción a proyectos

# Compactador por Spark plasma: Superimanes

# Trabajo Práctico No

2

Figueroa, Gonzalo | 84255

2.do cuatrimestre 2009

66.12 - Introducción a proyectos | Compactador por Spark plasma: Superimanes

## Índice

1. Introducción | 2
2. Competencia | 4
3. Análisis de características y prestaciones del producto | 10
4. Patentes | 14
4.2.4. Method of and apparatus for sintering a mass of particles with a powdery mold . . | 19
5. Conclusión | 25
1.er cuatrimestre 2009 | 1

66.12 - Introducción a proyectos | Compactador por Spark plasma: Superimanes

## 1. Introducción

### 1.1. Objetivo

El objetivo de este trabajo práctico radica, básicamente, en el estudio de los productos similares al equipo propuesto.
Se tendrán en cuenta las características de los productos que ofrece la competencia para poder realizar una comparación de lo que se puede encontrar hoy en día en el mercado.
También se analizarán las patentes que cubren los productos en cuestión y su incidencia sobre el compactador por Spark Plasma.

### 1.2. Breve reseña histórica

El sinterizado por Spark Plasma es un proceso nuevo en desarrollo - una técnica de tratamiento y síntesis - que hace posible la sinterización a bajas temperaturas y en períodos cortos de tiempo. Es considerado como un método rápido de sinterización, al igual que los denominados self-propagation high temperature synthesis (SHS) y el sinterizado por microondas. SPS (Spark plasma sintering) ofrece ventajas con respecto a los sistemas convencionales de sinterización por prensa caliente (HP) o prensado isostático en caliente (HIP), incluyendo la facilidad de operación y control preciso de la energía de sinterización,

así como la sinterización de alta velocidad y alta reproducibilidad, la seguridad y la fiabilidad.
La historia de la tecnología relacionada con el proceso en cuestión se inició a fines de los años 1930, cuando se introdujo en los Estados Unidos de América el proceso de sinterización utilizando energía eléctrica. En Japón, un proceso similar basado en la aplicación de un pulso de corriente de sinterización fue investigado y patentado en los años 60 y es conocido como Electric-discharge sintering. El inventor de ésta técnica fue Kiyoshi Inoue quien propuso en su patente el siguiente esquema para su realización.

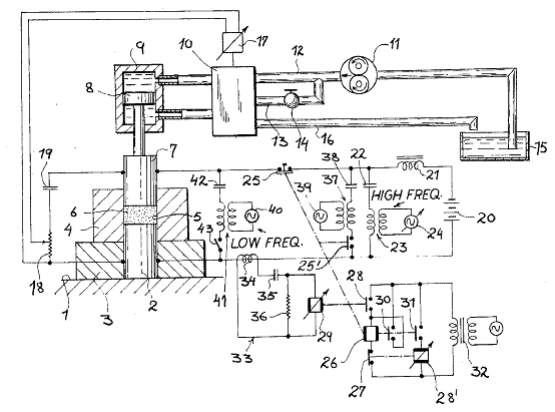
[picture p23: figure]

66.12 - Introducción a proyectos | Compactador por Spark plasma: Superimanes

La invención de Kiyoshi describe un método de sinterizado de cuerpos discretos y un equipo para llevarlo a cabo. Su propuesta fue revolucionaria ya que la aplicación de EDS (electric-discharge sintering)

podría realizar un sinterizado sin el uso excesivo de presión y temperatura en tiempos considerablemente cortos respecto de las técnicas utilizadas hasta el momento.
Sin embargo no fue posible un uso generalizado de dicha técnica debido a:

La falta de aplicación tecnológica en ese momento.

La existencia de campos limitados donde se podría aplicar para problemas relacionados con la industria.

El costo del equipo de sinterización.

La eficiencia.

Existió poca literatura sobre investigaciones en este proceso hasta los años 70. Es por eso que recién a mediados de los años 80, principios de los años 90, se comenzaron a desarrollar pequeñas unidades experimentales denominadas Plasma Activated Sintering (PAS). Dichas unidades proporcionaban una

máxima presión de sinterización de alrededor de 5 toneladas y la generación de pulsos de hasta 800 ampers y fueron utilizadas para la investigación de materiales.
Sin embargo, tras el reciente estreno del proceso de sinterización por Spark Plasma como la tercera generación de esta avanzada tecnología, se logran presiones de 10 a 100 toneladas y corrientes de 2000 a 20.000 ampers.
Como se puede apreciar, no existe una diferencia sustancial entre este método y el de SPS, sólo varían los valores de presión y corriente con que se trabaja. Esto se debe, básicamente, al avance tecnológico. El proceso de SPS ha ganado una inmensa reputación dentro de los nuevos procesos industriales de síntesis para el procesamiento de materiales nanocompuestos. Este proceso es de creciente atención entre ingenieros relacionados con la producción y los investigadores de materiales.

66.12 - Introducción a proyectos | Compactador por Spark plasma: Superimanes

## 2. Competencia

Como se mencionó en el trabajo anterior la competencia actual está relacionada con aquellos fabricantes de prensas isostáticas ya que, la técnica de Spark plasma todavía no se utiliza en el ámbito nacional.
Entonces, no solo se consideraron aquellas empresas que proveen sistemas de sinterizado por Spark plasma. Además, se tendrán en cuenta los proveedores de equipos HIP.
En función de lo antedicho, se realizó una búsqueda de aquellas empresas que producen los equipos encargados de realizar las técnicas ya descritas. Debido a que no existe producción nacional se realizó una búsqueda de productos de características similares en el mercado internacional.

### 2.1. Prensas Isostáticas en caliente

### 2.1.1. Thermal Technologies

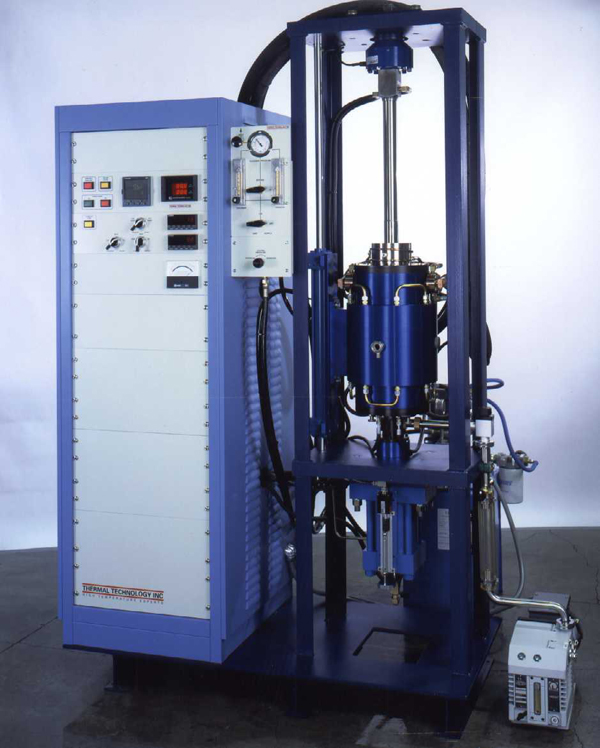
[picture p24: figure]
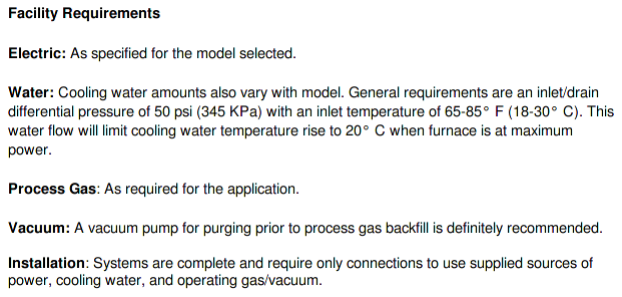
[picture p25: figure]
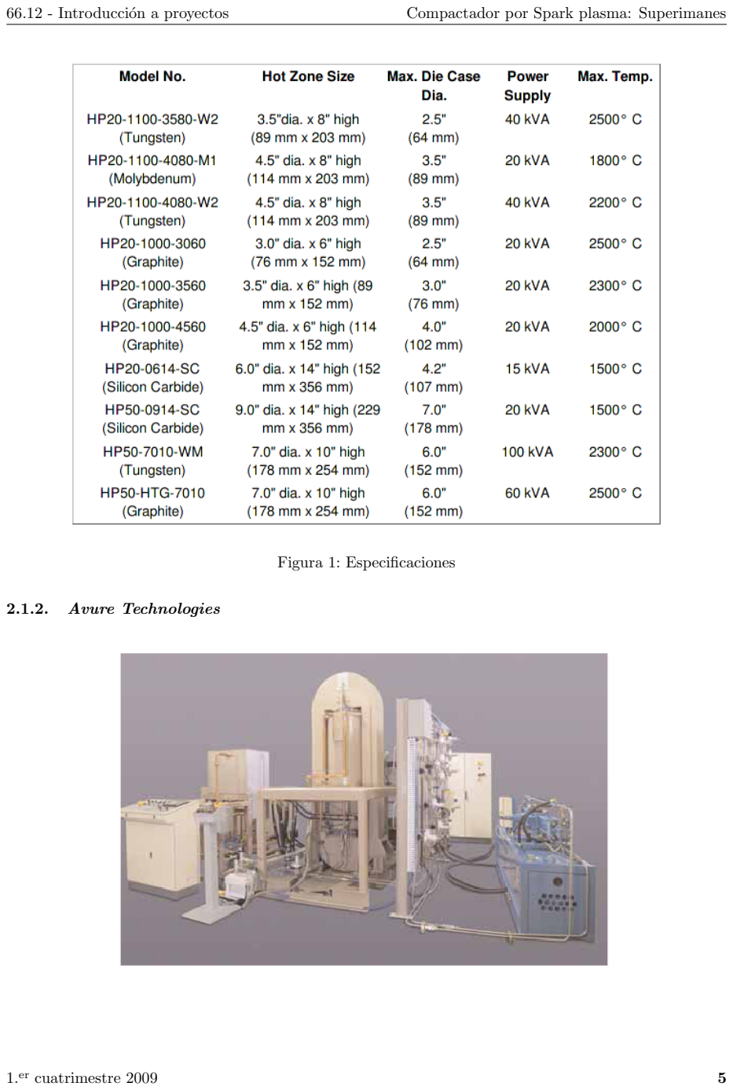
[picture p26: page 6]

66.12 - Introducción a proyectos | Compactador por Spark plasma: Superimanes

Figura 1: Especificaciones

### 2.1.2. Avure Technologies

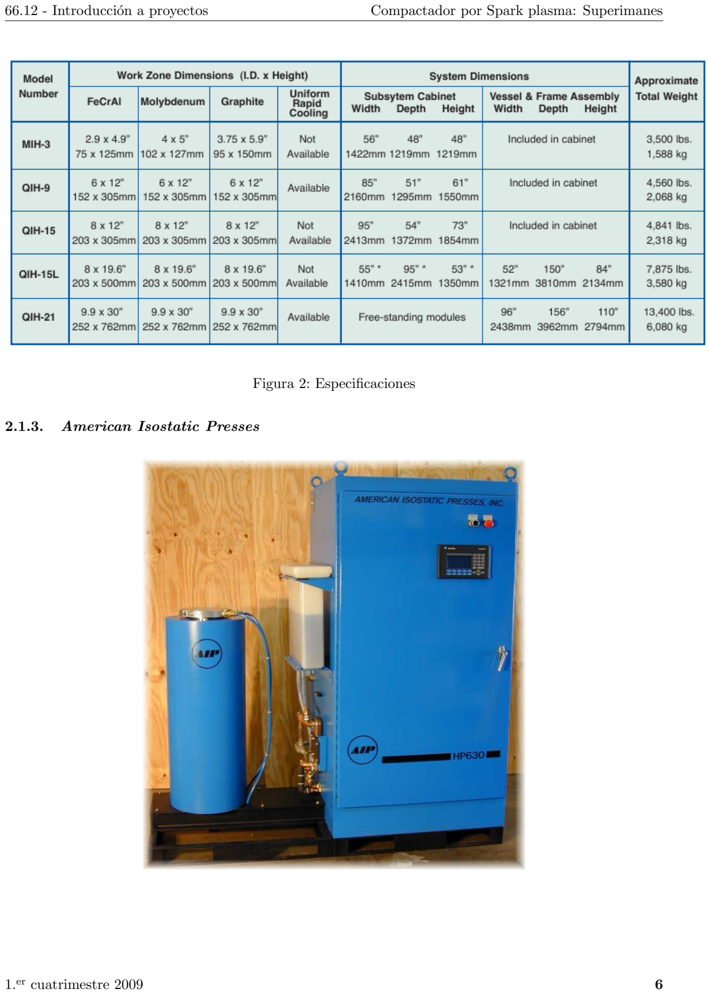
[picture p27: page 7]

66.12 - Introducción a proyectos | Compactador por Spark plasma: Superimanes

Figura 2: Especificaciones

### 2.1.3. American Isostatic Presses

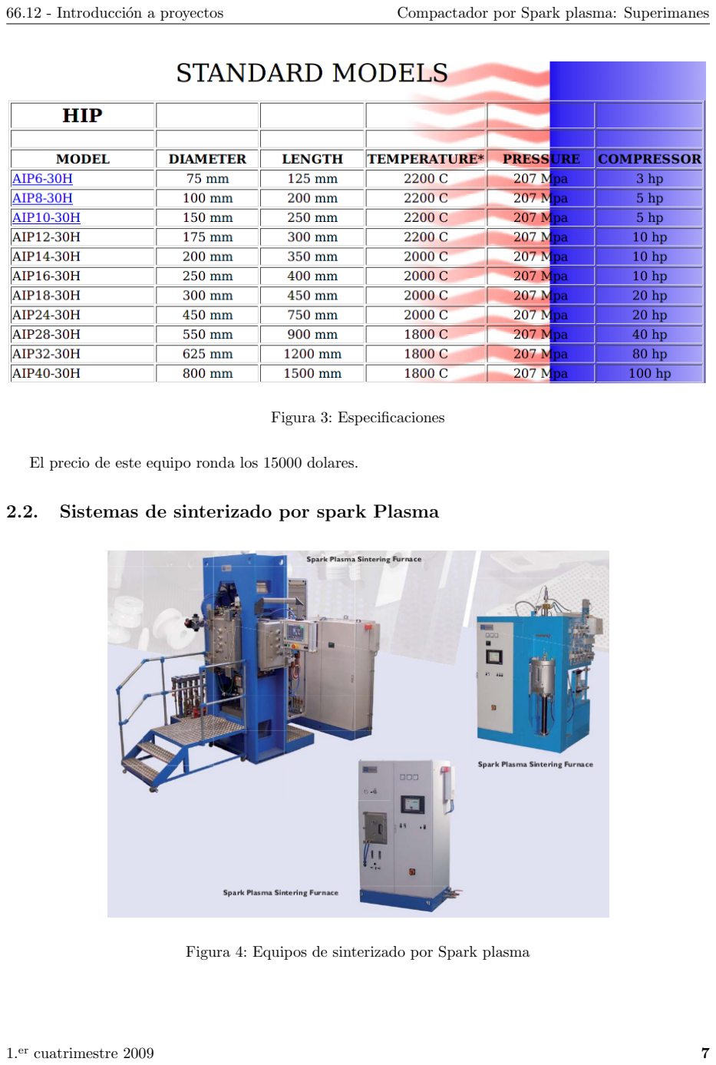
[picture p28: page 8]

66.12 - Introducción a proyectos | Compactador por Spark plasma: Superimanes

Figura 3: Especificaciones

El precio de este equipo ronda los 15000 dolares.

### 2.2. Sistemas de sinterizado por spark Plasma

Figura 4: Equipos de sinterizado por Spark plasma

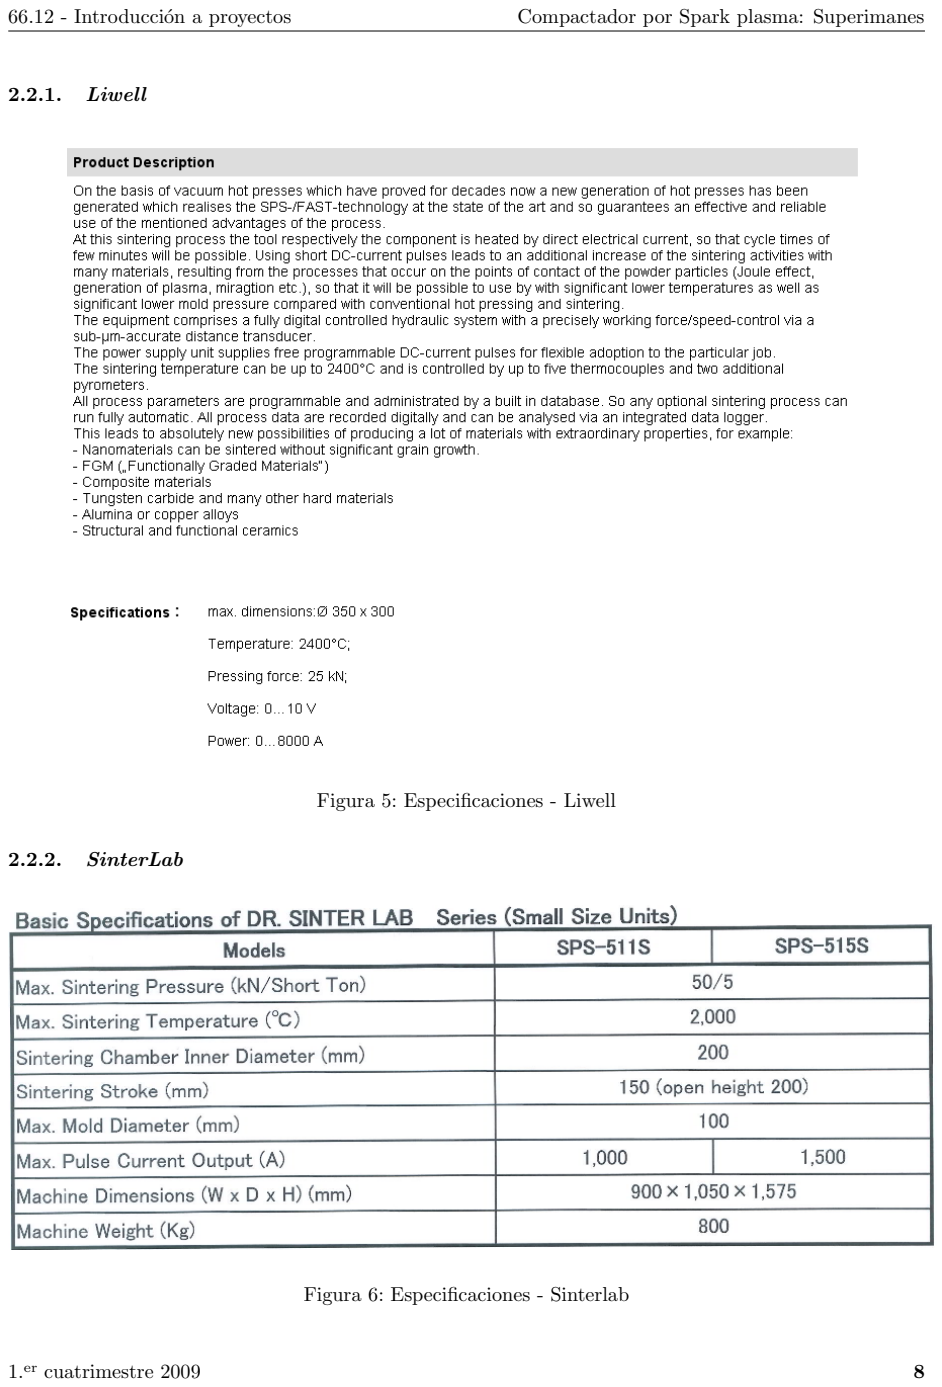
[picture p29: page 9]

66.12 - Introducción a proyectos | Compactador por Spark plasma: Superimanes

### 2.2.1. Liwell

Figura 5: Especificaciones - Liwell

### 2.2.2. SinterLab

Figura 6: Especificaciones - Sinterlab

66.12 - Introducción a proyectos | Compactador por Spark plasma: Superimanes

### 2.2.3. Thermal Technology

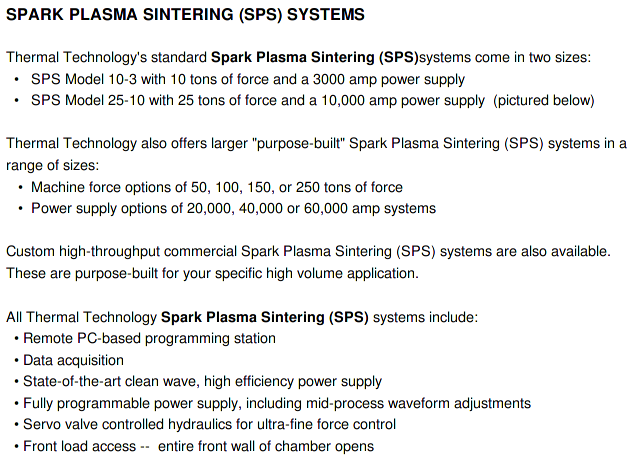
[picture p30: figure]

Figura 7: Especificaciones - Thermal technology

### 2.2.4. Metal Processing systems

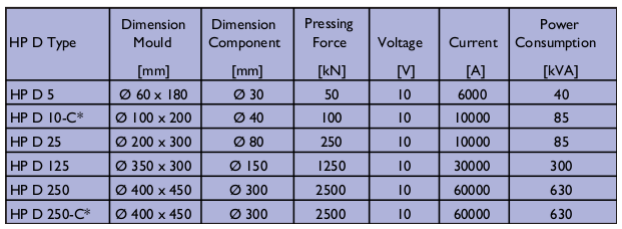
[picture p31: figure]

Figura 8: Especificaciones - MPS

66.12 - Introducción a proyectos | Compactador por Spark plasma: Superimanes

## 3. Análisis de características y prestaciones del producto

En esta sección se realizará un análisis de las características del producto con el objetivo final de lograr una comparación con los equipos que hay en el mercado.
Las prensas isostáticas en caliente (HIP) son las utilizadas hoy en día (en el ámbito nacional) para

la producción de imanes. Sin embargo, resulta difícil realizar una comparación entre las prestaciones de dichos equipos con el producto propuesto. Por lo tanto, se realizará un análisis de las ventajas y desventajas que presenta el método de sinterizado por spark plasma. Esta es una manera de brindarle a ´

los posibles clientes un punto de comparación a la hora de determinar por qué es conveniente invertir en el producto en cuestión.
Como se mencionó anteriormente, los equipos construidos para aplicar el método SPS (Spark Plasma Sintering) son relativamente nuevos. Entonces, la desventaja principal está relacionada con la inserción

en el mercado, ya que es necesario las empresas tengan cierto interés en la innovación tecnológica.
Vale decir que los equipos de sinterizado por spark plasma presentan varias vantajas frente a las HIP. Esto es lo que hace factible su comercialización. A continuación se muestra un gráfico sumamente ´

descriptivo que refleja lo dicho anteriormente:
Fenómeno | Efectos | Ventajas

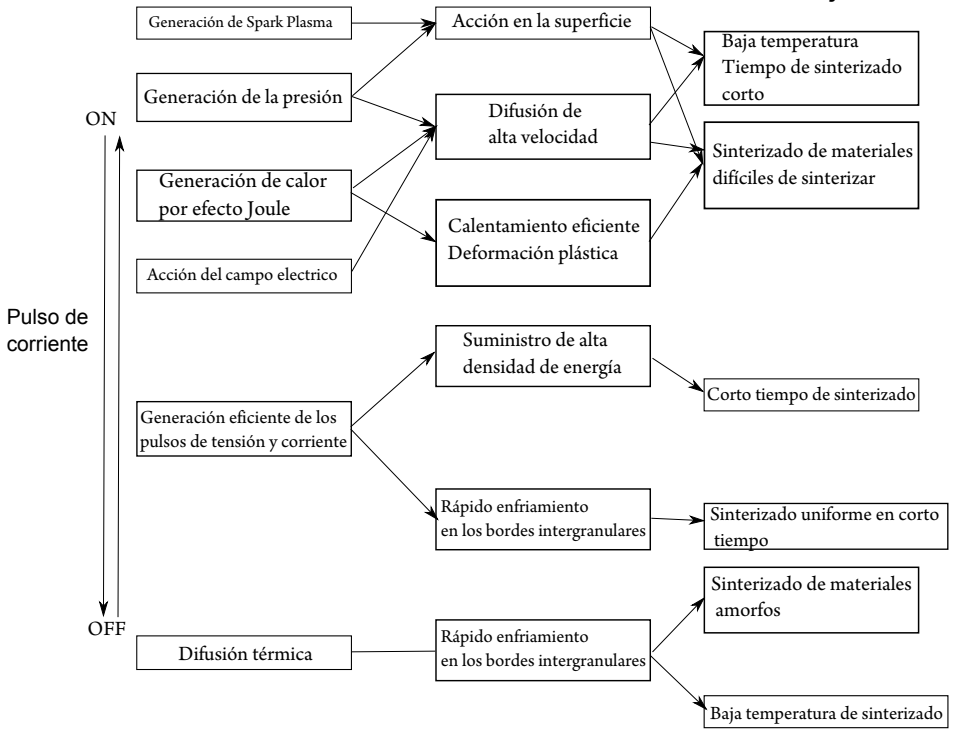
[picture p32: figure]
Pulso de corriente; OFF; Generación de Spark Plasma; Generación de la presión; Generación de calor por efecto Joule; Acción del campo electrico; Generación eficiente de los pulsos de tensión y corriente; Difusión térmica; Acción en la superficie; Difusión de alta velocidad; Calentamiento eficiente Deformación plástica; Suministro de alta densidad de energía; Rápido enfriamiento en los bordes intergranulares; Baja temperatura Tiempo de sinterizado corto; Sinterizado de materiales difíciles de sinterizar; Corto tiempo de sinterizado; Sinterizado uniforme en corto tiempo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

66.12 - Introducción a proyectos | Compactador por Spark plasma: Superimanes

### 3.1. Sistemas de sinterizado por Spark Plasma

A continuación se presenta un gráfico comparativo entre los productos que se encontraron en el

mercado:

Característica / Modelo | Modelo Propuesto | Liwell | Sinterlab | Thermal Tech. | MPS
Presión máxima [Tn] | 25 | 25 | 10 | 10 | 50
Temperatura máxima[oC] | 2400 | 2400 | 1300 | 2400 | 2400
Corriente máxima[A] | 2000 | 8000 | 2000 | 3000 | 6000
Tensión máxima[V] | 10 | 10 | 10 | 10 | 10
Diámetro del molde[mm] | 300 | 300 | 300 | 300 | 30
Control - PC | Sí | Sí | Sí | Sí | Sí
Control remoto | Sí | No | No | No | No

A continuación se realizará una descripción del proceso de sinterizado por spark plasma para justificar las características propuestas en el cuadro anterior.
El sinterizado por spark plasma (SPS) es una tecnología de alta velocidad tecnología capaz de procesar

materiales conductores y no-conductores.
La teoría sobre el proceso de SPS varía, pero la mayoría sigue el concepto de micro-spark/plasma,

que se basa en el fenómeno de descarga eléctrica de alta energía. Baja tensión y pulsos de corrientes altos producen SPS.

### 3.2. Proceso

SPS utiliza presión uniaxial y un pulso de alta conrriente continua. Dicho pulso de voltaje y corriente crea la chispa (spark) dando lugar al efecto Joule entre las partículas del material a sinterizar. Debido a

la frecuencia alta del pulso, el calor se transfiere y dispersa a lo largo de toda la muestra, lo que resulta en una rápida y completa distribución de calor y una densidad homogenea.
La chispa crea una descarga local de alta temperatura llegando hasta 10.000 o C, causando la vapor-

ización de las impurezas en la superficie de las partículas. Inmediatamente después de ésto, las partículas de la superficie se funden. El calor producido por efecto Joule crea deformación plástica en la superficie haciendo necesaria la aplicación de una presión constante a la muestra.
Todo el proceso se completa rápidamente, con una alta uniformidad y sin cambiar las características de las partículas.
A continucación se muestra un esquema que describe el proceso y su efecto sobre el polvo magnético:

66.12 - Introducción a proyectos | Compactador por Spark plasma: Superimanes

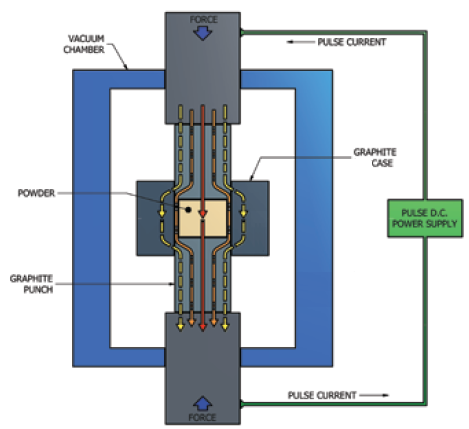
[picture p33: figure]
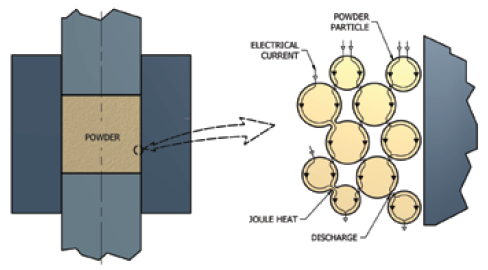
[picture p34: figure]

La presión desempeña un papel importante y predecible en la reducción del crecimiento de las particulas e influye en la densidad global.

### 3.3. Beneficios

El método SPS permite la sinterización de materiales disímiles sin acudir a una fase líquida en la parte inferior de temperatura materiales. En el caso de los materiales compuestos de alta homogeneidad es posible incluso con una menor densidad.
Debido al fenómeno de soldadura superficial, en el interior de las partículas, la temperatura no alcanza los valores correspondientes como para promover la difusión atómica que provoca el crecimiento de granos, o si lo hace, su cinética de calentamiento es tan rápida que no permite el crecimiento excesivo de los mismos. Esto permite que el material en cuestión conserve en mayor medida las propiedades magnéticas. ´

Por último, en SPS los gastos de funcionamiento son de 50 a 80 % menos que las tecnologías conven-

cionales de sinterización, debido principalmente a la velocidad. En algunas aplicaciones, la tecnología de SPS es hasta 20 veces más rápida que las tecnologías convencionales de sinterización tales como HIP. La mayoría de las aplicaciones SPS sólo requieren 20 minutos en comparación con las horas necesarias con los sistemas convencionales.

66.12 - Introducción a proyectos | Compactador por Spark plasma: Superimanes

### 3.4. Producto propuesto

En función de las características de los productos de la competencia se propone un equipo que pueda competir en por lo menos un aspecto con los sistemas que se encuentran hoy en día en el mercado. Esto ´

da lugar a un producto que ofrece una buena performance en todos los aspectos. Además se agrego una característica de la cual carecen los equipos de la competencia. Se trata del control remoto. Esto último permite al operador controlar el equipo desde cualquier lugar en caso de que se reporte un error que repercuta en la realización adecuada del sinterizado.

66.12 - Introducción a proyectos | Compactador por Spark plasma: Superimanes

## 4. Patentes

Debido a las características de la competencia del producto se tuvieron en cuenta patentes relacionadas con los dos métodos de sinterizado tratados en secciones anteriores.
A continuación se incluye una breve descripción de las patentes más relevantes relacionadas con el proyecto con el fin de realizar un análisis de las mismas.

### 4.1. Hot isostatic presses

### 4.1.1. Hot isostatic press

Abstract
A hot isostatic press comprising a working vessel, formed of at least two pieces, having a working chamber within it. The working medium supplied to the working chamber, for transmitting pressure to work pieces within the chamber, may be a molten metal. Heating means within the vessel and cooling means at the exterior of the vessel cooperate to produce a continuous isothermal region completely surrounding the working chamber. The isothermal region is at the solidification temperature of the metal working medium, so that any potential leaks of molten metal working medium from the vessel are sealed by solidification of metal reaching the isothermal region. There is a heat-resistant liner within the vessel, the isothermal region being within the liner. A storage vessel for the working medium and a high pressure

vessel, which may be a plunger pump, are connected to each other and to the working vessel through conduits furnished with valves.

Patent number: 4279581

Filing date: Jul 18, 1980

Issue date: Jul 21, 1981

Inventor: Wolfgang Betz

Assignee: MTU Motoren-Und Turbinen-Union Munchen GmbH

U.S. Classification
425/78; 425/405H

International Classification

B29C 300; B30B 502; B30B 1100; B22F 300

66.12 - Introducción a proyectos | Compactador por Spark plasma: Superimanes

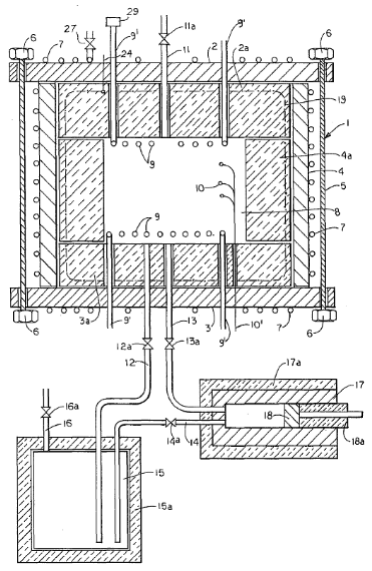
[picture p35: figure]

### 4.1.2. Hot isostatic pressing system

Abstract
A HIP system of the type which includes a high pressure vessel with top and bottom plugs for closing top and bottom open ends thereof or a high pressure vessel closed at one end and having a plug for closing the other open end thereof, and a high pressure and temperature processing chamber defined in the pressure vessel and having a heat insulating mantle and a heater disposed around the inner periphery thereof for subjecting a workpiece supported on the plug to sintering or other treatment in a high pressure and temperature gas atmosphere, the HIP system including: a removable shield casing hermetically engageable with the workpiece supporting plug and adapted to be loaded into and unloaded from the high pressure vessel along with the workpiece, holding the processing chamber in a sealed state; and a valve member provided in the shield casing for selectively establishing and blocking communication of the processing chamber with an exterior atmosphere such that the processing chamber is selectively placed in a vacuumized state, filled with a high pressure gas and evacuated to an atmospheric pressure.

Patent number: 4471949

Filing date: Apr 12, 1983

Issue date: Sep 18, 1984

Inventor: Takahiko Ishii

Assignee: Kabushiki Kaisha Kobe Seiko Sho

Primary Examiner: Christopher W. Brody

66.12 - Introducción a proyectos | Compactador por Spark plasma: Superimanes

U.S. Classification
266/252; 425/405H; 266/250

International Classification

B22F 300; C21C 900

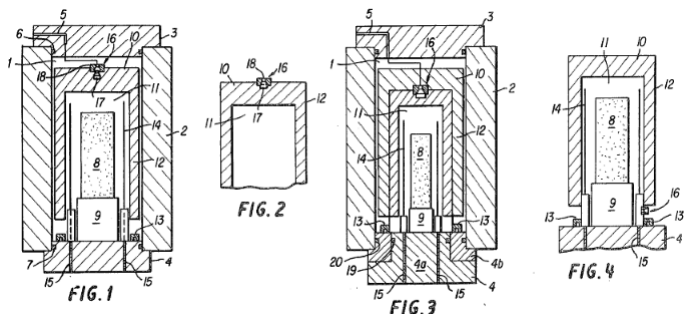
[picture p36: figure]

### 4.1.3. Hot isostatic pressing apparatus

Abstract
A hot isostatic pressing apparatus having a high pressure vessel, a heat insulating layer and a heater

disposed inside the heat insulating layer, the heat insulating layer and the heater being disposed within a high pressure chamber defined by upper and lower covers. The heat insulating layer is composed of at least two inner and outer inverted cup-like casings, the outer casing being metallic and having a hermetic structure and the inner casing having a hermetic structure. A passage is formed in the upper surface of the outer casing and a valve capable of being opened and closed is provided therein. Further, a mechanism for opening and closing the valve is mounted on the upper cover, and a gas passage is formed in the lower portion of the het insulating layer. The above arrangement creates a convection of gas in the cooling step after the HIP treatment whereby a remarkable improvement can be attained in cooling efficiency, cooling time and productivity.

Patent number: 4629412

Filing date: Aug 9, 1984

Issue date: Dec 16, 1986

Inventors: Yoichi Inoue, Takahiko Ishii

Assignee: Kabushiki Kaisha Kobe Seiko Sho

Primary Examiner: J. Fortenberry

U.S. Classification

66.12 - Introducción a proyectos | Compactador por Spark plasma: Superimanes

425/405H; 266/252; 419/49; 425DIG26

International Classification

B22F 312

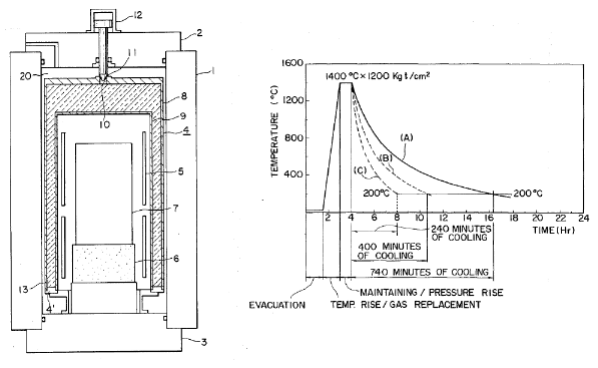
[picture p37: figure]

### 4.2. Spark plasma sintering

### 4.2.1. Electric-discharge sintering

Patent number: 3241956

Filing date: Oct 29, 1963

Issue date: Mar 1966

Inventor: Kiyoshi Inoue

66.12 - Introducción a proyectos | Compactador por Spark plasma: Superimanes

### 4.2.2. Servocontrol system for discharge sintering

Abstract
A servocontrol system for a movable electrode of a discharge system, especially for the spark-discharge sintering of conductive and nanoconductive particles, where in reversible drive means is provided for the movable electrode, and a servomechanism responsive to a parameter of the conditions of the gap between the electrodes, detects the parameter and converts it into a control signal for operating the drive means whereby the movable electrode follows the shrinkage of the sintered mass. Programming means can be connected in the servocontrol circuit for augmenting the reponse of the drive means to the control signal when, for instance, it is desired to increase the pressure applied by moving electrode to the mass of particles or the speed thereof after an initial movement at a lesser rate.

Patent number: 3508029

Filing date: Jul 11, 1967

Issue date: Apr 1970

Inventor: Kiyoshi Inoue

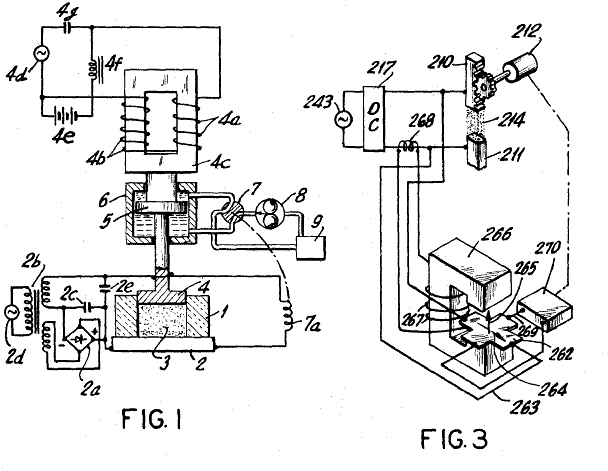
[picture p38: figure]

### 4.2.3. Method of spark sitering electrically

Abstract
A method of spark sintering electrically conductive particles, e.g. copper, nickel, ferrochronium and tungsten carbide, onto a metallic substrate in which a mass of particles is positioned along the substrate in light-contacting relationship therewith. An electric current pulse is applied across the mass of particles to effect a spark discharge among them and between the mass and the substrate to sinter the particles

66.12 - Introducción a proyectos | Compactador por Spark plasma: Superimanes

to one another and to the substrate. The method also increases the fatigue resistance of iron and steel when tungsten carbide is spark-sintered thereto.

Patent number: 3670137

Filing date: Feb 16, 1970

Issue date: Jun 1972

Inventor: Kiyoshi Inoue

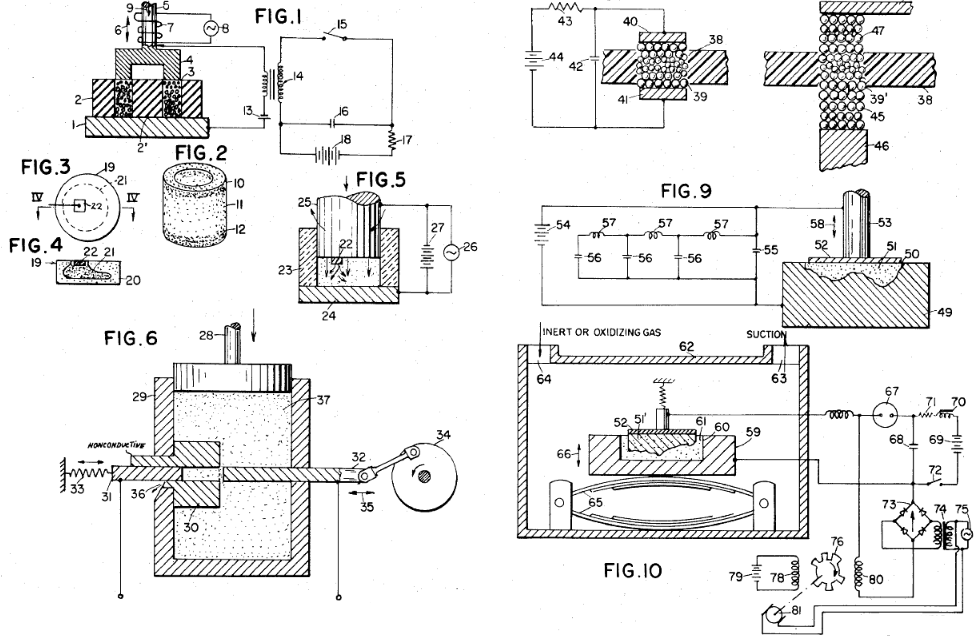
[picture p39: figure]

### 4.2.4. Method of and apparatus for sintering a mass of particles with a powdery mold

Abstract
A particulate mass to be sintered is imbedded in a mold which comprises a porous mass of particulate refractory material enclosed within a flexible membrane. Six press units are provided for applying compressive pressures externally to the mold, together or in sequence, whereby to subject the sinterable mass to pressures in the respective directions, under the control of a preprogrammed control unit which receives clock pulses from a source and stimulates the respective press units. A flexible heating coil imbedded in the mold is supplied with alternating current from a source to inductively heat up the sinterable mass and the adjacent mold material, to enable sintering to occur. The sinterable mass may have been precompacted into a self-supporting so-called ”green compact”, or it may be supported in a

66.12 - Introducción a proyectos | Compactador por Spark plasma: Superimanes

self-supporting shell carried within and forming part of the mold. The mold preferably comprises three layers having characteristics chosen so as to assist in heating up the sinterable mass uniformly.

Patent number: 4414028

Filing date: Apr 8, 1980

Issue date: Nov 8, 1983

Inventor: Kiyoshi Inoue

Assignee: Inoue-Japax Research Incorporated

Primary Examiner: J. J. Zimmerman

U.S. Classification
419/31; 264/120; 100/232; 425/330; 419/42; 419/44; 419/49; 419/52; 419/53; 419/60

International Classification

B22F 316; B22F 314; B30B 704

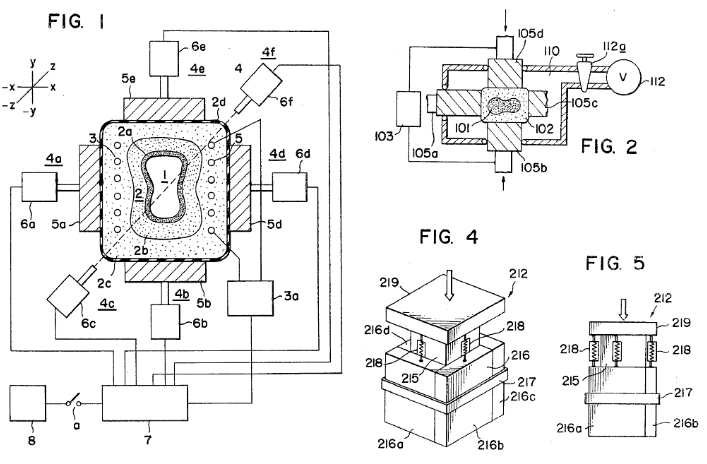
[picture p40: figure]

### 4.2.5. Perfected sintering machine and method of operation

Abstract
A sintering machine for applying heat and pressure to a die retained between two plate sets, includes a temperature sensor, a position sensor and a pressure sensor which are all connected to a computer for sensing the temperature of and pressure applied to the die, as well as the position of a movable one of the plate sets. This information is used to control a power supply unit which supplies current through the die to heat the die, and a hydraulic press for moving the movable one of the plate sets. Pressure

66.12 - Introducción a proyectos | Compactador por Spark plasma: Superimanes

and temperature are controlled in a discontinuous fashion during discrete intervals until a selected final temperature and pressure are reached. This more closely controls the sintering process over earlier systems which applied continously increasing temperature and pressure to the die.

Patent number: 4989153

Filing date: Aug 19, 1988

Issue date: Jan 29, 1991

Inventor: Giuseppe Bonvini

Assignee: Sintris S.r.L.

Primary Examiner: Jim Trammell

U.S. Classification
364/477; 219/149; 419/48; 419/52; 419/54

International Classification

G06F 1546; B21J 106; B22F 3302

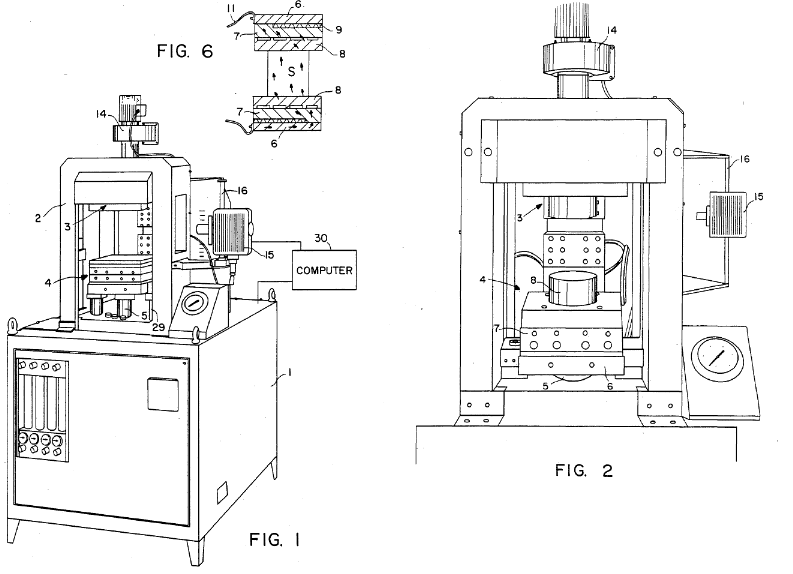
[picture p41: figure]

### 4.2.6. Process for producing a rare earth element-iron anisotropic magnet

Abstract

66.12 - Introducción a proyectos | Compactador por Spark plasma: Superimanes

A process for producing a rare earth element-iron-boron anisotropic magnet that may generate a strong static magnetic field in vacant spaces of a magnetic circuit mounted in a motor is disclosed. The process comprises the steps of placing a billet produced of rapid solidification powder of a rare earth element-iron-boron alloy into a mold cavity, applying a primary pressure to said billet, while allowing a primary current to pass through said billet, applying to said billet a secondary pressure which is increased up to at least five times as much as the primary pressure, and applying a secondary current greater than the primary current through said billet, wherein the billet is finally subjected to plastic deformation at the temperature between the crystalline temperature and 750.degree. C.

Patent number: 5178691

Filing date: May 28, 1991

Issue date: Jan 12, 1993

Inventors: Fumitoshi Yamashita, Masami Wada

Assignees: Matsushita Electric Industrial Co., Ltd.

U.S. Classification
148/101; 148/104; 419/12; 419/52

International Classification

H01F 102

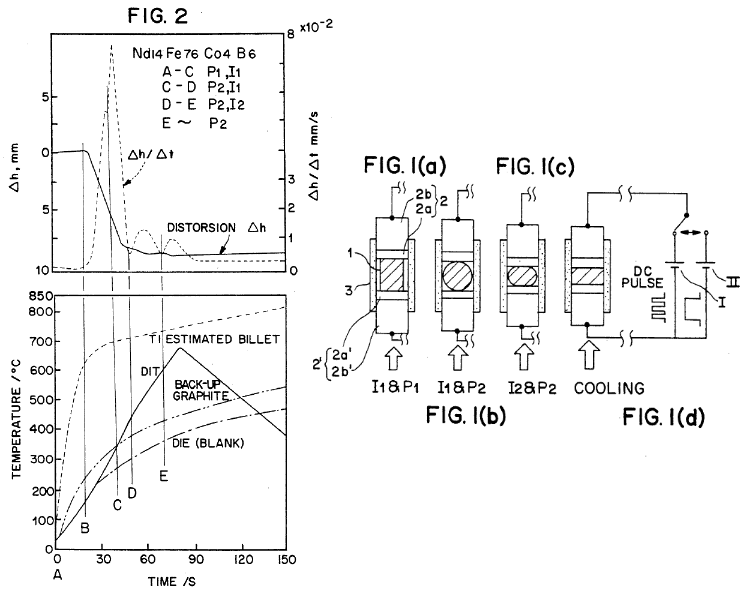
[picture p42: figure]

66.12 - Introducción a proyectos | Compactador por Spark plasma: Superimanes

### 4.2.7. Electric joining method and apparatus and a joined unit of members

Abstract
Disclosed is a novel electric joining method and apparatus that can overcome the defects associated with the prior art while taking advantage of the technology for the pulse excited sintering process such as spark plasma sintering process or the hot-press joining process. According to the present invention, an electric joining apparatus for joining a plurality of members to be joined at the joining surfaces thereof, comprises: a pair of current-currying electrodes 13, 16 capable of contacting with the members so as to apply electricity to the members; a power supply 17 connected to the pair of energizing electrodes for supplying the energizing electrodes with at least either one of a DC current or a pulsated current; and a pressurizing unit 14 for compressing each of the pair of electrodes against the joining surfaces, wherein the pair of members are sandwiched between the energizing electrodes and applied with at least either one of the DC current or the pulsated current from the power supply under the desired pressure, thus to be joined, without using a die made of graphite.

Application number: 10/345,333

Publication number: US 2003/0106877 A1

Filing date: Jan 16, 2003

Inventors: Yoshito Miyasaka, Masao Tokita, Hitoshi Karasawa, Fumitake Nishiyama

Assignees: SUMITOMO COAL MINING CO., LTD.
Issued patent: 6899265 (Issue date May 31, 2005)

U.S. Classification

219078020

International Classification B23K011/00

66.12 - Introducción a proyectos | Compactador por Spark plasma: Superimanes

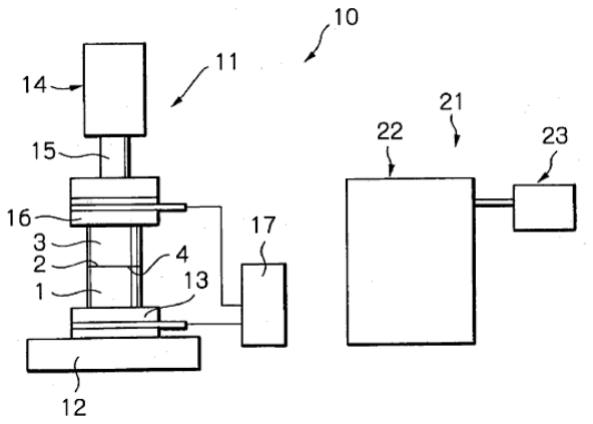
[picture p43: figure]

### 4.3. Análisis de las patentes

Para este análisis se tuvieron en cuenta los efectos de la ley sobre las mismas. La protección por patente es de 20 años improrrogables y es de tipo territorial, es decir, solo es válida donde se concede. No existe patente mundial o internacional. Por lo tanto se tendrá en cuenta la última patente que se listó en la subsección anterior.
Se trata de la patente: “Electric joining method and apparatus and a joined unit of members”. Vale aclarar que la misma describe un sistema de sinterizado y no su control electrónico. Entonces deberá tenerse en cuenta y estudiar en detalle a la hora de la construcción del equipo es caso de comercializarse en el exterior.

66.12 - Introducción a proyectos | Compactador por Spark plasma: Superimanes

## 5. Conclusión

En este trabajo práctico se realizó un análisis completo de la competencia y de las patentes relacionadas con el equipo. Es preciso destacar que el 100 % de los competidores son de origen extranjero debido a las

características tecnológicas del equipo. Sin embargo es posible afirmar que el sistema puede construirse completamente en Argentina sin ningún tipo de inconvenientes.
Con respecto a las patentes fue posible identificar una que deberá tenerse en cuenta para la construcción de la maquinaria de compactación.
Con respecto a la factibilidad tecnológica del Compactador por Spark Plasma se puede decir que, los componentes electrónicos requeridos se encuentran en el mercado nacional. El análisis completo de dichos componentes se realizará en trabajos posteriores.
