Stachovsky/TrabajoProfesional/Informes/InformeFinal/InformeProyectoFinal.tex

\documentclass[12pt]{article}

\usepackage{graphicx}
\usepackage{graphicx}
\usepackage{caption}
\usepackage[spanish]{babel}
\usepackage[utf8]{inputenx}
\usepackage{anysize} 
\usepackage{amsmath}
\usepackage{listings}
\marginsize{2cm}{2cm}{1cm}{2cm} %izq der arriba abajo
\usepackage{hyperref}
\usepackage{wrapfig} % paquete gráfico

\hypersetup{
    colorlinks,%
    citecolor=black,%
    filecolor=black,%
    linkcolor=black,%
    urlcolor=black
}

\title{Informe Trabajo Profesional}
\author{Facundo Nahuel Uriel Silva, Estanislao López Morgan}

\begin{document}

  %Caratula
  \newpage
  \thispagestyle{empty}
  
  \begin{center}
     

  \vspace{100px}

  \huge{Trabajo Profesional de Ingeniería Electrónica}
  \vspace{50px}

  \bf{ \huge{Sistema de control de fabricación de nano polvos mediante el proceso de sinterizado} }

  \vspace{80px}

  \end{center}
  
  \begin{bf}
    \begin{Large}
      \begin{tabbing}
	\= ----- \= ----- \= --------------------- \= \kill
	\> Integrantes:\\
	\\
	  \>\> Estanislao López Morgan \\
	  \>\>\>  Padrón:	\> 84546 \\
	  \>\>\>  Mail:	\>\url{estanux@gmail.com} \\
	\\
	  \>\> Facundo Nahuel Uriel Silva\\
	  \>\>\>  Padrón:	\> 86881 \\
	  \>\>\>  Mail:	\> \url{fanaur@gmail.com}\\
      \end{tabbing}
    \end{Large}
  \end{bf}
  
  %Indice de contenidos
  \newpage
%-------------------------------------------------------------------------------------------------------------------  
%--------------------------------------------------------------------------------------------------------------------  
\section*{Prefacio}

\section*{Agradecimientos}  

\newpage

%-----------------------------------------------------------------------------------------------------  
  
  \thispagestyle{empty} \tableofcontents \thispagestyle{empty} %así se hace el número de página
  %Comienzo
  \newpage
  \setcounter{page}{1}

%--------------------------------------------------------------------------------------------------------------------  
%--------------------------------------------------------------------------------------------------------------------
  \section{Resumen}  
  
  \input{1_Resumen/Resumen}

  \newpage

%--------------------------------------------------------------------------------------------------------------------  
%--------------------------------------------------------------------------------------------------------------------

  \section{Introducción}  

  \input{2_Introduccion/Introduccion}

  \newpage

%--------------------------------------------------------------------------------------------------------------------  
%--------------------------------------------------------------------------------------------------------------------

  \section{Objetivos. (Propuesta técnica)}  

    \input{3_Objetivos/Objetivos}

  \newpage

%--------------------------------------------------------------------------------------------------------------------  
%--------------------------------------------------------------------------------------------------------------------

  \section{Definición de Producto}  

    \input{4_DefinicionProducto/DefinicionProducto}

  \newpage

%--------------------------------------------------------------------------------------------------------------------  
%--------------------------------------------------------------------------------------------------------------------

  \section{Análisis de Factibilidad}  

    \input{5_AnalisisFactibilidad/AnalisisFactibilidad}
  
  \newpage

%--------------------------------------------------------------------------------------------------------------------  
%--------------------------------------------------------------------------------------------------------------------

  \section{Ingeniería de detalle}  

    \input{6_IngenieriaDetalle/IngenieriaDetalle}

  \newpage

%--------------------------------------------------------------------------------------------------------------------  
%--------------------------------------------------------------------------------------------------------------------

  \section{Construcción del prototipo}  

    \input{7_ConstruccionPrototipo/ConstruccionPrototipo}

  \newpage

%--------------------------------------------------------------------------------------------------------------------  
%--------------------------------------------------------------------------------------------------------------------
% 
  \section{Validación del prototipo}  

    \input{8_ValidacionPrototipo/ValidacionPrototipo}

  \newpage

%--------------------------------------------------------------------------------------------------------------------  
%--------------------------------------------------------------------------------------------------------------------

  \section{Estudios de confiabilidad de hardware y de software}  
  
  \input{9_EstudioConfiabilidad/EstudioConfiabilidad}
  
  \newpage

%--------------------------------------------------------------------------------------------------------------------  
%--------------------------------------------------------------------------------------------------------------------

  \section{Conclusiones}  

    \input{10_Conclusiones/Conclusiones}

  \newpage

%--------------------------------------------------------------------------------------------------------------------  
%--------------------------------------------------------------------------------------------------------------------

  \section{Anexos: Técnicos. Justificativos. Descriptivos. Documentales}  

    \input{11_Anexos/Anexos}

  \newpage

%--------------------------------------------------------------------------------------------------------------------  
%--------------------------------------------------------------------------------------------------------------------

  %Bibliografia

% Bibliografía 
%  LIBROS.- Autor. Título. Editorial. Fecha 
%  REVISTAS.- Autor. Título. Nombre de la revista. FechaVolumen. Páginas, Notas de aplicación (incluir copia de las importantes)

  \newpage

  \begin{thebibliography}{1}
    \bibitem{} 

  \end{thebibliography}

\end{document}
