Stachovsky/TrabajoProfesional/Informes/InformeProyectoFinal/InformeProyectoFinal.tex

\documentclass[12pt]{article}

\usepackage{graphicx}
\usepackage[spanish]{babel}
\usepackage[utf8]{inputenx}
\usepackage{anysize} 
\usepackage{amsmath}
\usepackage{listings}
\marginsize{2cm}{2cm}{1cm}{2cm} %izq der arriva abajo
\usepackage{hyperref}

\hypersetup{
    colorlinks,%
    citecolor=black,%
    filecolor=black,%
    linkcolor=black,%
    urlcolor=black
}

\title{}
\author{Facundo Nahuel Uriel Silva}

\begin{document}

  %Caratula
  \newpage
  \thispagestyle{empty}
  
  \begin{center}
     

  \vspace{100px}

  \huge{Trabajo Profesional de Ingeniería Electrónica}
  \vspace{50px}

  \bf{ \huge{Sistema de control de fabricación de nano polvos mediante el proceso de sinterizado} }

  \vspace{80px}

  \end{center}
  
  \begin{bf}
    \begin{Large}
      \begin{tabbing}
	\= ----- \= ----- \= --------------------- \= \kill
	\> Integrantes:\\
	\\
	  \>\> Estanislao López Morgan \\
	  \>\>\>  Padrón:	\> 84546 \\
	  \>\>\>  Mail:	\>\url{estanux@gmail.com} \\
	\\
	  \>\> Facundo Nahuel Uriel Silva\\
	  \>\>\>  Padrón:	\> 86881 \\
	  \>\>\>  Mail:	\> \url{fanaur@gmail.com}\\
      \end{tabbing}
    \end{Large}
  \end{bf}
  
  %Indice de contenidos
  \newpage

  \thispagestyle{empty} \tableofcontents \thispagestyle{empty} %así se hace el número de página

  %Comienzo
  \newpage
  \setcounter{page}{1}

%--------------------------------------------------------------------------------------------------------------------  
%--------------------------------------------------------------------------------------------------------------------

  \section{Prefacio, agradecimientos}  

  \newpage

%--------------------------------------------------------------------------------------------------------------------  
%--------------------------------------------------------------------------------------------------------------------

  \section{Resumen}  

  \newpage

%--------------------------------------------------------------------------------------------------------------------  
%--------------------------------------------------------------------------------------------------------------------

  \section{Introducción}  

  \newpage

%--------------------------------------------------------------------------------------------------------------------  
%--------------------------------------------------------------------------------------------------------------------

  \subsection{Historia y antecedentes}  

  \newpage

%--------------------------------------------------------------------------------------------------------------------  
%--------------------------------------------------------------------------------------------------------------------

  \subsection{Definiciones y glosario de términos}  

  \newpage

%--------------------------------------------------------------------------------------------------------------------  
%--------------------------------------------------------------------------------------------------------------------

  \subsection{Justificación del proyecto}  

  \newpage

%--------------------------------------------------------------------------------------------------------------------  
%--------------------------------------------------------------------------------------------------------------------

  \section{Objetivos. (Propuesta técnica)}  

  \newpage

%--------------------------------------------------------------------------------------------------------------------  
%--------------------------------------------------------------------------------------------------------------------

  \subsection{Finalidad del proyecto (a quien ayuda, para que sirve)}  

  \newpage

%--------------------------------------------------------------------------------------------------------------------  
%--------------------------------------------------------------------------------------------------------------------

  \subsection{Planteamiento del problema a resolver}  

  \newpage

%--------------------------------------------------------------------------------------------------------------------  
%--------------------------------------------------------------------------------------------------------------------

  \section{Definición de Producto}  

  \newpage

%--------------------------------------------------------------------------------------------------------------------  
%--------------------------------------------------------------------------------------------------------------------

  \subsection{Requerimientos}  

  \newpage

%--------------------------------------------------------------------------------------------------------------------  
%--------------------------------------------------------------------------------------------------------------------

  \subsection{Construcción de la Casa de calidad (análisis de valor y competitividad)}  

  \newpage

%--------------------------------------------------------------------------------------------------------------------  
%--------------------------------------------------------------------------------------------------------------------

  \subsection{Especificaciones funcionales y de diseño}  

  \newpage

%--------------------------------------------------------------------------------------------------------------------  
%--------------------------------------------------------------------------------------------------------------------

  \subsubsection{Especificaciones del hardware}  

  \newpage

%--------------------------------------------------------------------------------------------------------------------  
%--------------------------------------------------------------------------------------------------------------------

  \subsubsection{Especificación del sofá (interfaces y protocolos)}  

  \newpage

%--------------------------------------------------------------------------------------------------------------------  
%--------------------------------------------------------------------------------------------------------------------

  \section{Análisis de Factibilidad}  

  \newpage

%--------------------------------------------------------------------------------------------------------------------  
%--------------------------------------------------------------------------------------------------------------------

  \subsection{Factibilidad tecnológica}  

  \newpage

%--------------------------------------------------------------------------------------------------------------------  
%--------------------------------------------------------------------------------------------------------------------

  \subsubsection{Propuesta de alternativas de diseño}  

  \newpage

%--------------------------------------------------------------------------------------------------------------------  
%--------------------------------------------------------------------------------------------------------------------

  \subsubsection{Elección de una solución}  

  \newpage

%--------------------------------------------------------------------------------------------------------------------  
%--------------------------------------------------------------------------------------------------------------------

  \subsubsection{DFMEA}  

  \newpage

%--------------------------------------------------------------------------------------------------------------------  
%--------------------------------------------------------------------------------------------------------------------

  \subsection{Factibilidad de tiempos. Planificación (PERT y simulación de Montecarlo) y programación (Gant). Análisis de Riesgos}  

  \newpage

%--------------------------------------------------------------------------------------------------------------------  
%--------------------------------------------------------------------------------------------------------------------

  \subsection{Factibilidad económica. (Mercado, costos, ciclo de vida, VAN, TIR)}  

  \newpage

%--------------------------------------------------------------------------------------------------------------------  
%--------------------------------------------------------------------------------------------------------------------

  \subsection{Factibilidad legal y responsabilidad civil (regulaciones y licencias}  

  \newpage

%--------------------------------------------------------------------------------------------------------------------  
%--------------------------------------------------------------------------------------------------------------------

  \section{Ingeniería de detalle}  

  \newpage

%--------------------------------------------------------------------------------------------------------------------  
%--------------------------------------------------------------------------------------------------------------------

  \subsection{Hardware}  

  \newpage

%--------------------------------------------------------------------------------------------------------------------  
%--------------------------------------------------------------------------------------------------------------------

  \subsubsection{Diagrama de bloques (hardware)}  

  \newpage

%--------------------------------------------------------------------------------------------------------------------  
%--------------------------------------------------------------------------------------------------------------------

  \subsubsection{Detalles de selección y calculo de los elementos circuitales de cada bloque}  

  \newpage

%--------------------------------------------------------------------------------------------------------------------  
%--------------------------------------------------------------------------------------------------------------------

  \subsubsection{Plan de pruebas de cada modulo}  

  \newpage

%--------------------------------------------------------------------------------------------------------------------  
%--------------------------------------------------------------------------------------------------------------------

  \subsection{Software}  

  \newpage

%--------------------------------------------------------------------------------------------------------------------  
%--------------------------------------------------------------------------------------------------------------------

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
  \newpage

%--------------------------------------------------------------------------------------------------------------------  
%--------------------------------------------------------------------------------------------------------------------

  \subsection{Listado de partes}  

  \newpage

%--------------------------------------------------------------------------------------------------------------------  
%--------------------------------------------------------------------------------------------------------------------

  \subsection{Códigos de software}  

  \newpage

%--------------------------------------------------------------------------------------------------------------------  
%--------------------------------------------------------------------------------------------------------------------

  \subsection{Experiencias accesorias}  

  \newpage

%--------------------------------------------------------------------------------------------------------------------  
%--------------------------------------------------------------------------------------------------------------------

  \subsection{Hojas de datos de componentes}  

  \newpage

%--------------------------------------------------------------------------------------------------------------------  
%--------------------------------------------------------------------------------------------------------------------

  \subsection{Hojas de aplicación, etc.}  

  \newpage

%--------------------------------------------------------------------------------------------------------------------  
%--------------------------------------------------------------------------------------------------------------------

  \subsection{Manuales de operación, soporte e instalación}  

  \newpage

  %Bibliografia

% Bibliografía 
%  LIBROS.- Autor. Título. Editorial. Fecha 
%  REVISTAS.- Autor. Título. Nombre de la revista. FechaVolumen. Páginas, Notas de aplicación (incluir copia de las importantes)

  \newpage

  \begin{thebibliography}{1}
    \bibitem{} 

  \end{thebibliography}

\end{document}
