Stachovsky/TrabajoProfesional/Informes/InformeFinal/12_EstudioConfiabilidad/EstudioConfiabilidad.tex

%------------------------------------------------------------

\section{Estudios de confiabilidad de hardware y software }
