Stachovsky/TrabajoProfesional/Informes/PlanDeNegocio/Canvas.pdf

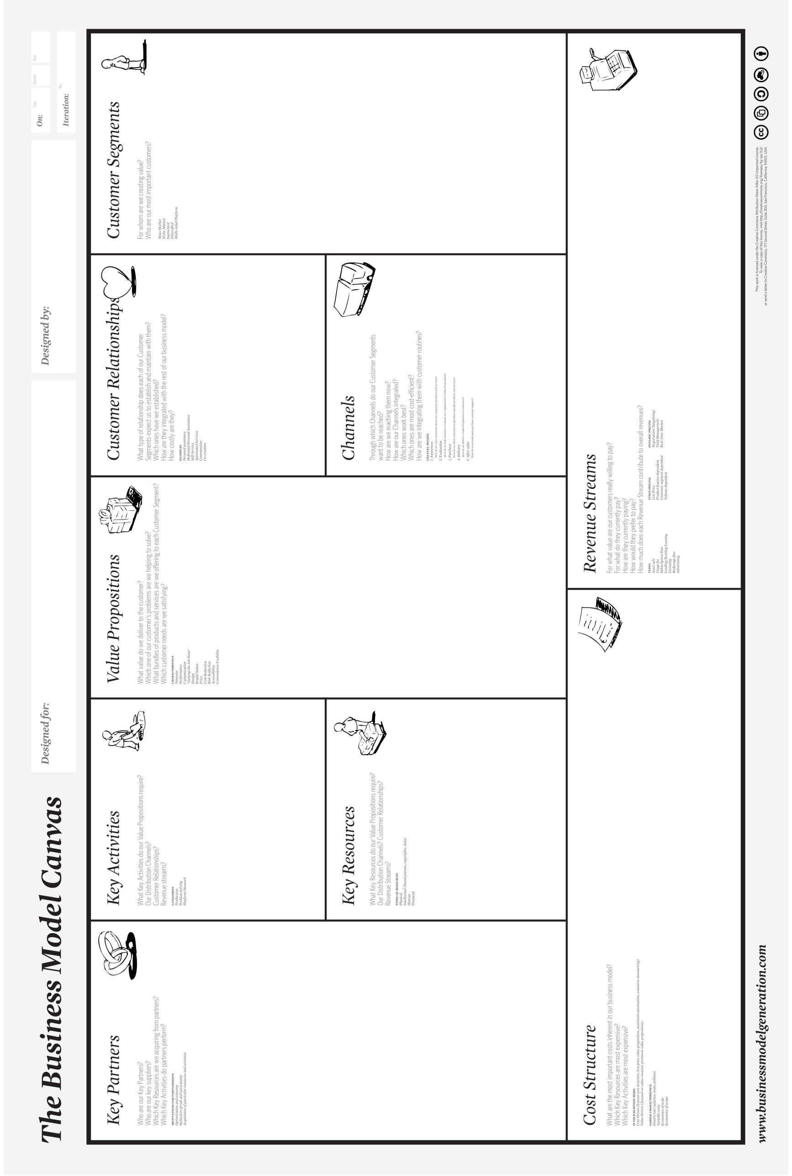
[picture p46: page 1]
