Stachovsky/TrabajoProfesional/Informes/PlanDeNegocio/PlanDeNegociosTemplate.pdf

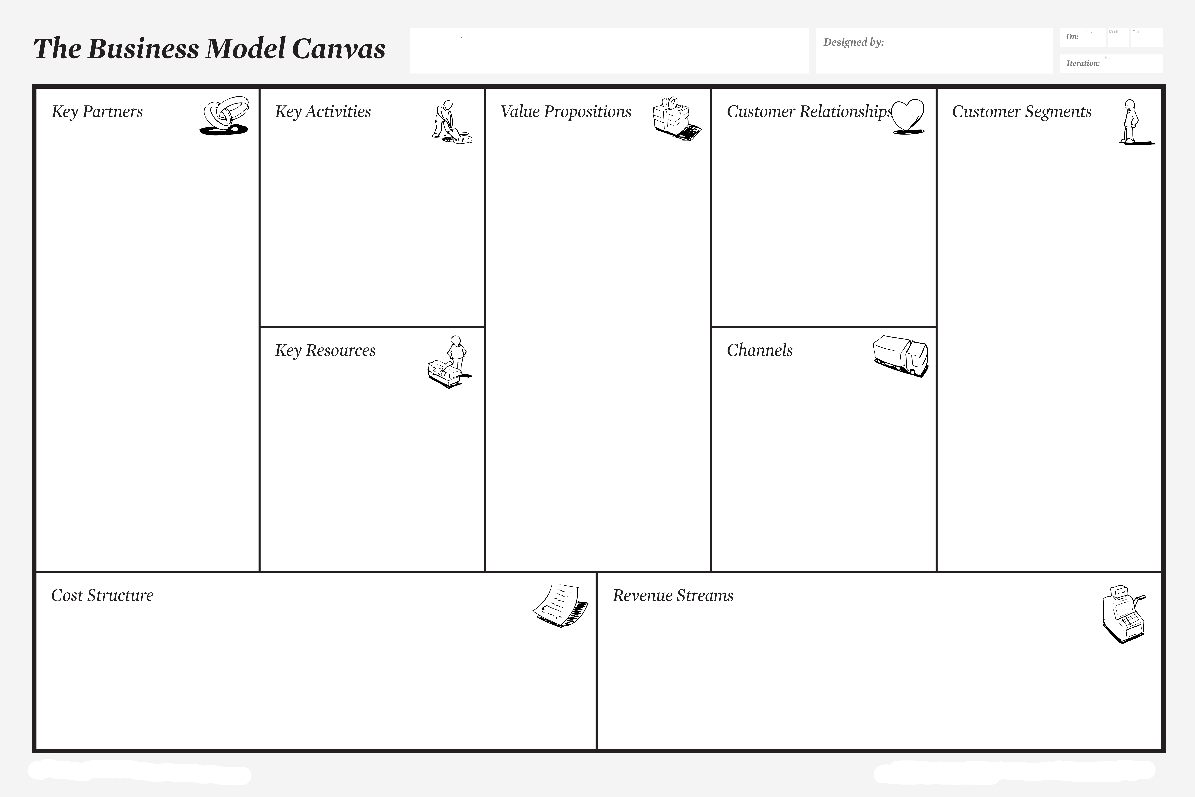
[picture p47: figure]
