Stachovsky/TrabajoProfesional/Informes/PlanDeNegocio/PlanDeNegociosTemplateV2.pdf

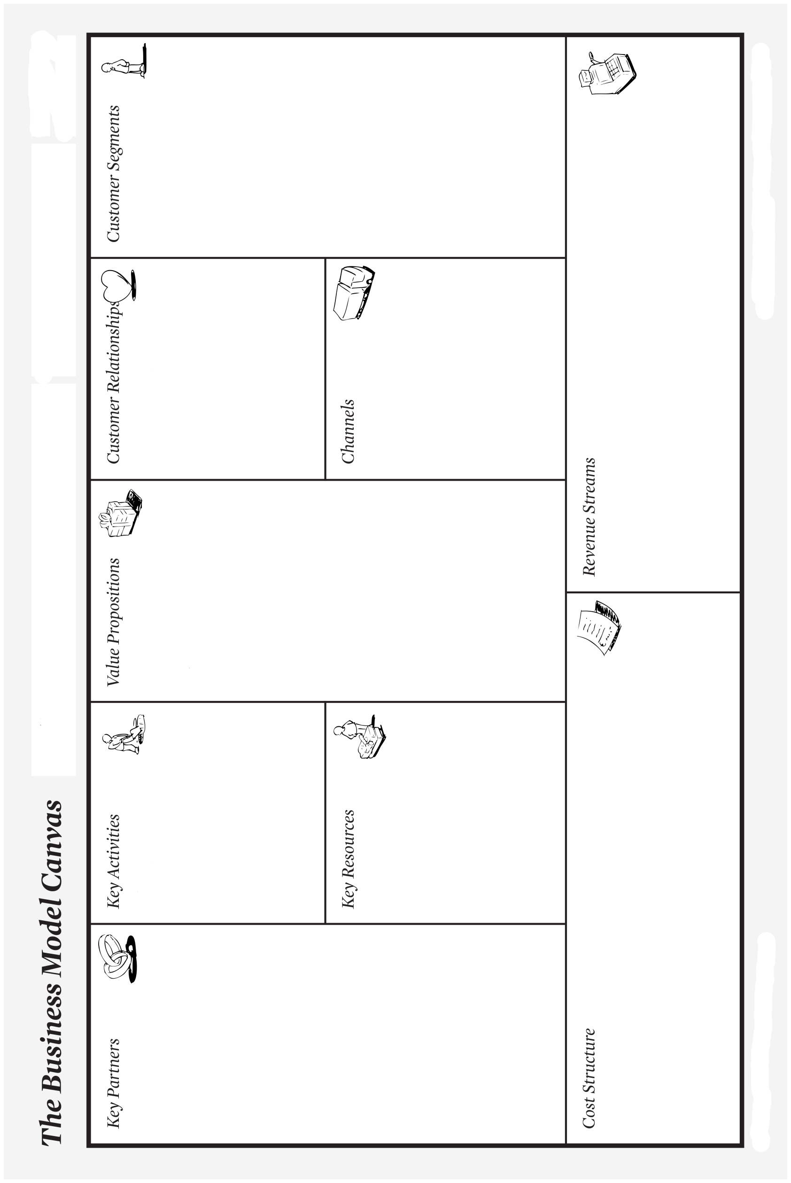
[picture p48: page 1]
