Stachovsky/TrabajoProfesional/Informes/PlanDeNegocio/PlanDeNegociosUECAS.pdf

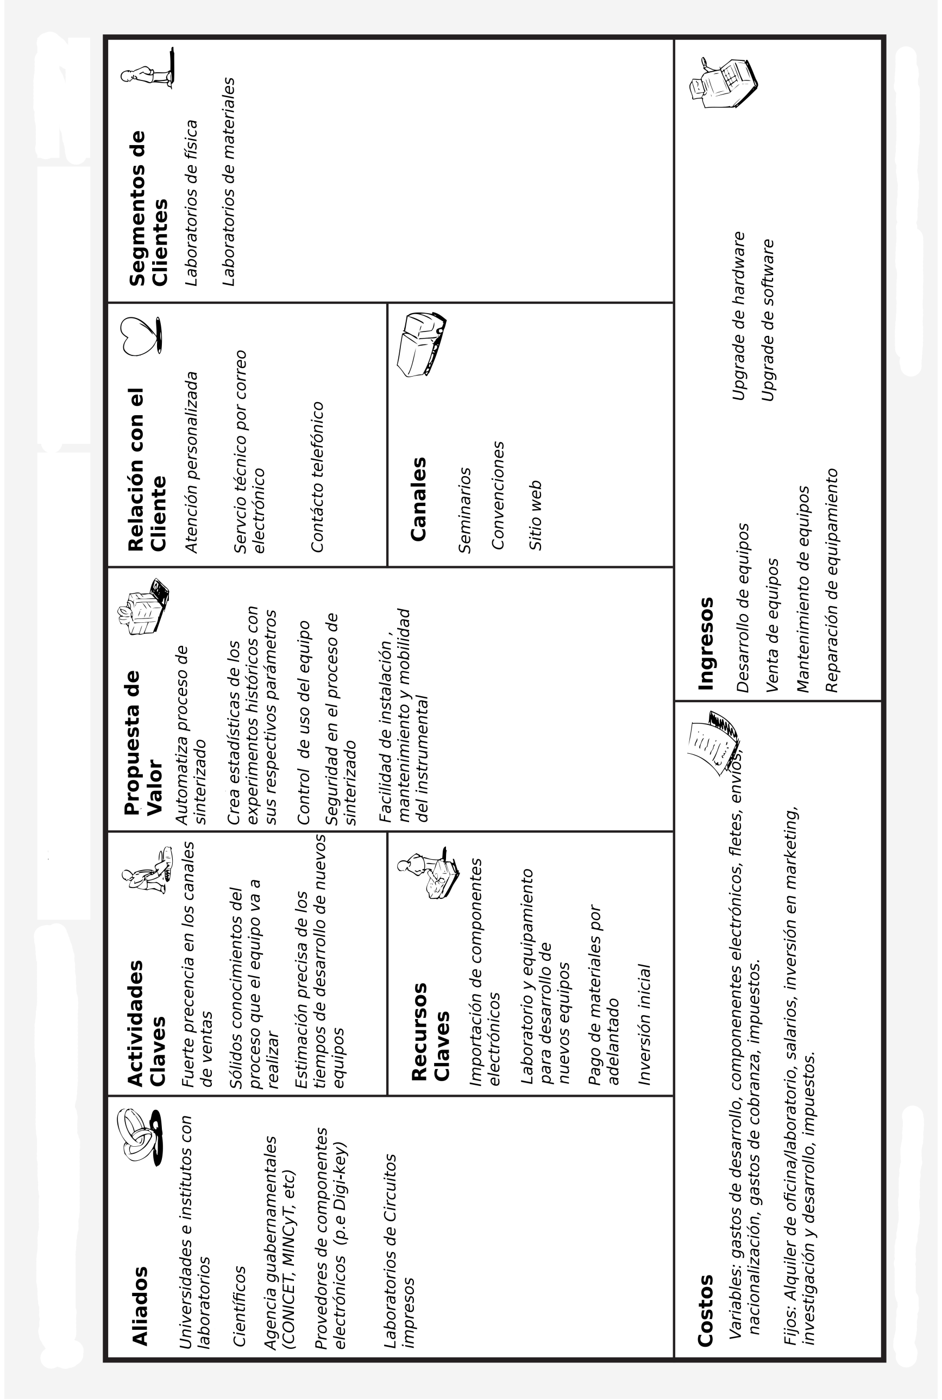
[picture p49: page 1]
