Stachovsky/TrabajoProfesional/Documentacion/DocumentacionProyectoAnterior/Micro_Hardware/Circuito Impreso REV 0.1-01.pdf

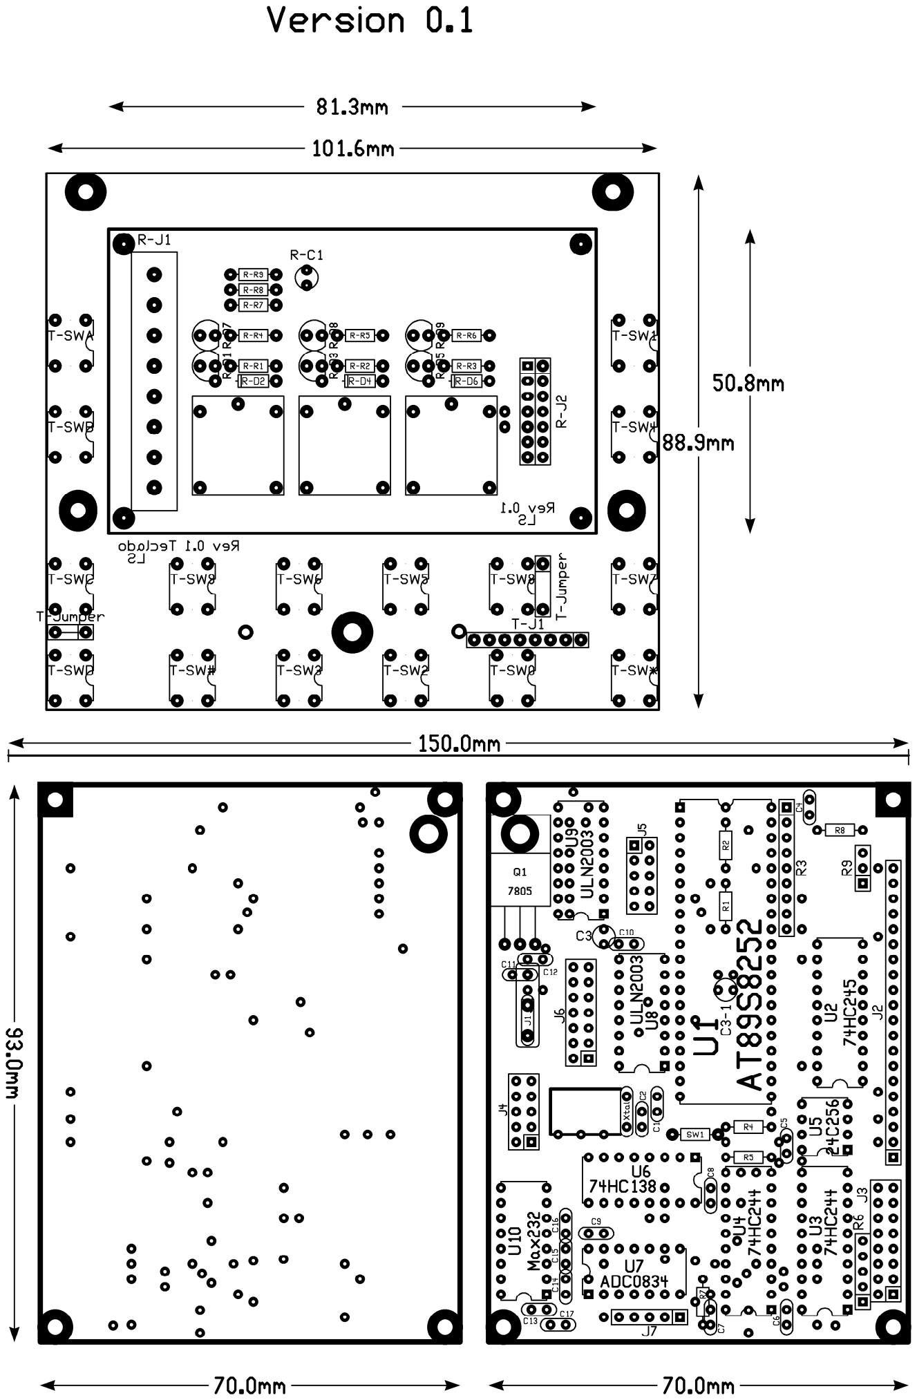
[picture p51: page 1]
