Stachovsky/TrabajoProfesional/Documentacion/DocumentacionProyectoAnterior/Micro_Hardware/Circuito Impreso REV 0.1-02.pdf

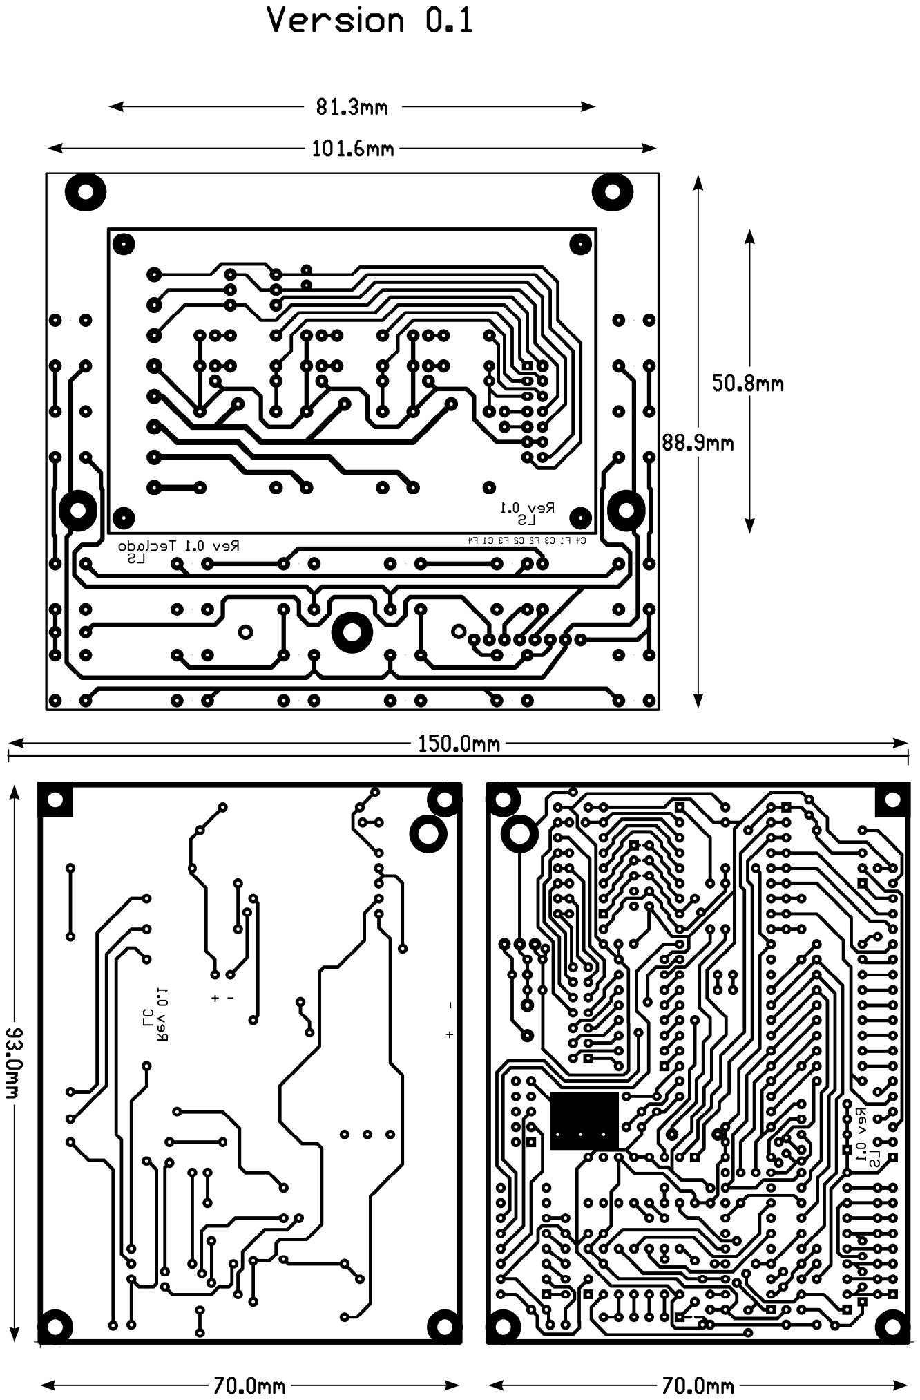
[picture p52: page 1]
