Stachovsky/TrabajoProfesional/Informes/AnalisisEconomico/MontecarloEstaniTPprof.ods

Tareas | To | Tm | Tp | E(t) | a | b | Número de simulación | Tareas |  |  |  |  |  |  |  |  |  |  |  |  |  |  |  |  |  |  |  | Camino |  |  |  |  |  |  | Camino de mayor duración | Camino | Número de apariciones | Porcentaje de apariciones | Duración media en días | Camino | Tareas
1 | 7 | 10 | 12 | 9,83 | 3,40 | 2,60 |  | 1 | 2 | 3 | 4 | 5 | 6 | 7 | 8 | 9 | 10 | 11 | 12 | 13 | 14 | 15 | 16 | 17 | 18 | 19 | 20 | 1 | 2 | 3 | 4 | 5 | 6 | 7 |  |  |  |  |  | 1 | 1 | 2 | 3 | 4 | 5 | 6 | 7 | 14 | 15 | 16 | 17 | 18 | 19 | 20 | ¬¬¬ | ¬¬¬
2 | 4 | 5 | 7 | 5,17 | 2,56 | 3,44 | 1 | 10,851 | 6,083 | 18,779 | 5,816 | 3,089 | 2,986 | 5,583 | 5,387 | 4,490 | 4,249 | 3,489 | 2,533 | 3,018 | 16,807 | 3,649 | 10,458 | 8,003 | 7,069 | 6,996 | 25,799 | 131,965 | 122,230 | 121,332 | 121,469 | 120,572 | 112,949 | 113,847 | 1 | 1 | 852 | 85,20% | 130,7 | 2 | 1 | 2 | 3 | 4 | 5 | 6 | 8 | 10 | 13 | 15 | 16 | 17 | 19 | 18 | 19 | 20
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
