Stachovsky/TrabajoProfesional/Informes/AnalisisEconomico/TIRyVANtpProf.xls

COSTO DIRECTO X EQUIPO |  | $138.11
 | Ganancia 45% | 200.2595
PRECIO DE VENTA X EQUIPO |  | $200.26
Año | Ventas | Ingresos | Egresos
 |  | Ventas | Costo fijo producción | Costo variable producción | Costo fijo administración | Costo variable administración (Estimacion fija) | Costo fijo comercialización | Costo variable comercialización | Amortización | Inversiones | Impuestos
0 | 0 | 0 | $73455.00 | $0.00 | 0 | 0 | 0 | 0 |  | $41500.00
1 | 4000 | 801038 | $324000.00 | $552440.00 | $65000.00 | $72000.00 | $128400.00 | $1967.21 | $8300.00 |  | 30%
2 | 8000 | 1602076 | $324000.00 | $1104880.00 | $65000.00 | $72000.00 | $128400.00 | $3934.43 | $8300.00 |  | 30%
3 | 15000 | 3003892.5 | $324000.00 | $2071650.00 | $65000.00 | $72000.00 | $128400.00 | $7377.05 | $8300.00 |  | 30%
4 | 20000 | 4005190 | $324000.00 | $2762200.00 | $65000.00 | $72000.00 | $128400.00 | $9836.07 | $8300.00 |  | 30%
5 | 14000 | 2803633 | $324000.00 | $1933540.00 | $65000.00 | $72000.00 | $128400.00 | $6885.25 | $8300.00 |  | 30%
 |  |  |  | Año 0 | Año 1 | Año 2 | Año 3 | Año 4 | Año 5 | Total
 |  |  | Inversión (amortizable) | $41500.00
Costos Variables de comercializacion |  |  | Gastos desarrollo | $73455.00
12200 | $6000.00 |  | Ingresos por ventas |  | 801038 | 1602076 | 3003892.5 | 4005190 | 2803633 | 12215829.5
4000 | $1967.21 |  | Egresos |  | $1143807.21 | $1698214.43 | $2668427.05 | $3361436.07 | $2529825.25 | $11401710.00
8000 | $3934.43 |  | Beneficio bruto |  | -$342769.21 | -$96138.43 | $335465.45 | $643753.93 | $273807.75 | $814119.50
15000 | $7377.05 |  | Amortizaciones |  | $8300.00 | $8300.00 | $8300.00 | $8300.00 | $8300.00 | $41500.00
20000 | $9836.07 |  | Utilidad bruta |  | -$351069.21 | -$104438.43 | $327165.45 | $635453.93 | $265507.75 | $772619.50
14000 | $6885.25 |  | Impuestos |  | -$105320.76 | -$31331.53 | $98149.64 | $190636.18 | $79652.33 | $231785.85
 |  |  | Utilidad neta |  | -$245748.45 | -$73106.90 | $229015.82 | $444817.75 | $185855.43 | $540833.65
 |  |  | Flujo de fondos | -$114955.00 | -$237448.45 | -$64806.90 | $237315.82 | $453117.75 | $194155.43 | $467378.65
 |  |  | Flujo de fondos acumulado | -$114955.00 | -$352403.45 | -$417210.35 | -$179894.53 | $273223.22 | $467378.65
 |  |  | VAN |  |  |  |  |  |  | $141204.87
 |  |  | TIR |  |  |  |  |  |  | 27.80874442%
 |  |  |  |  |  |  |  |  |  | $ 929,941,09
