Stachovsky/TrabajoProfesional/Documentacion/DataSheet/SensorTension/CircuitoIL300.png

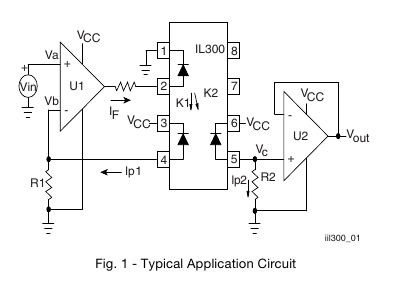
Documentacion/DataSheet/SensorTension/CircuitoIL300.png
