Stachovsky/TrabajoProfesional/Documentacion/DataSheet/SensorTension/CircuitoIL300Unipolar.png

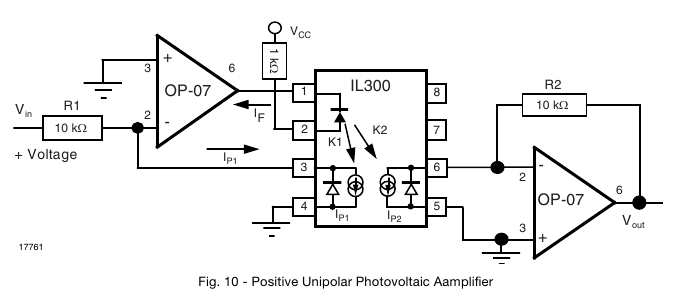
Documentacion/DataSheet/SensorTension/CircuitoIL300Unipolar.png
