Stachovsky/TrabajoProfesional/Documentacion/Diagramas/CapacitoresDimensiones.png

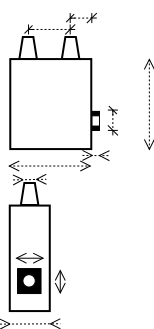
Documentacion/Diagramas/CapacitoresDimensiones.png
