Stachovsky/TrabajoProfesional/Documentacion/Diagramas/diagramaBloquesMacro.png

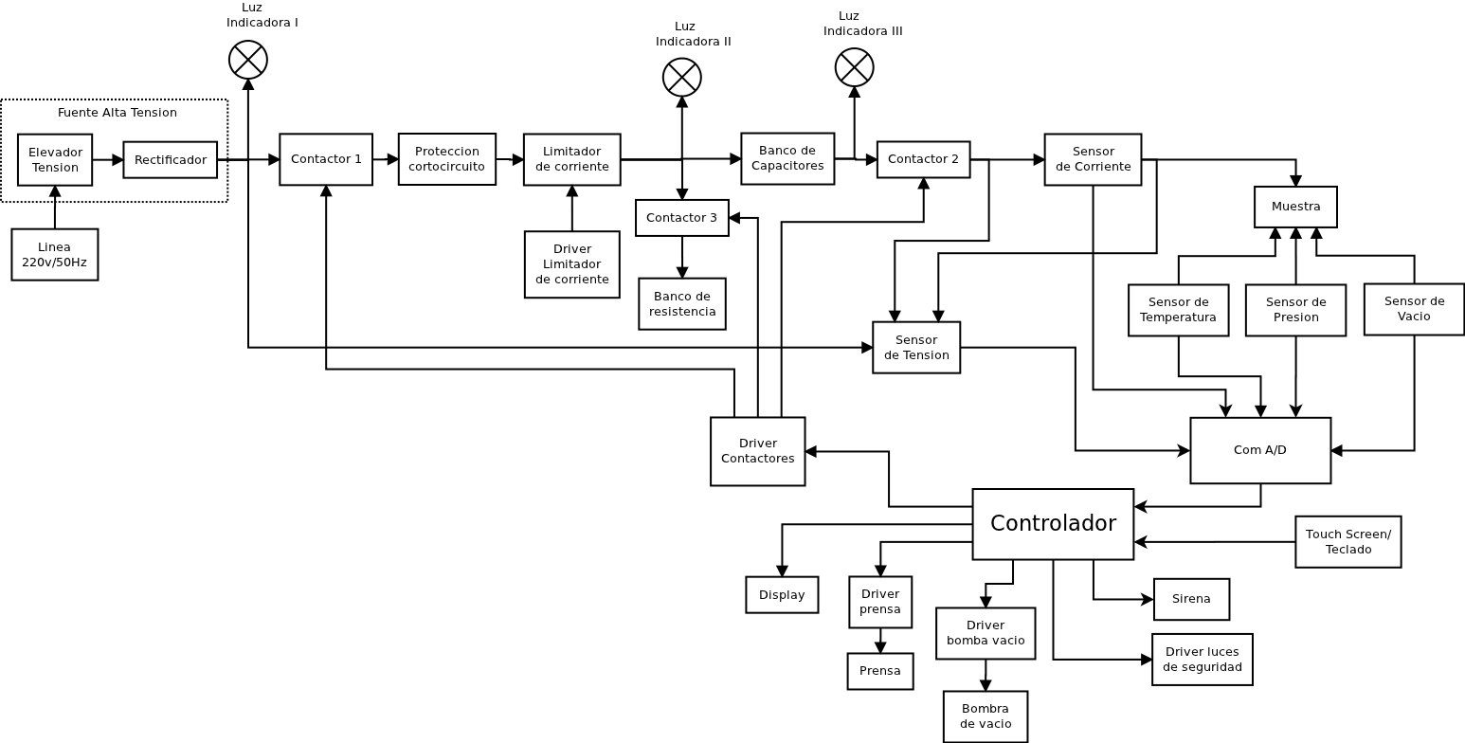
Documentacion/Diagramas/diagramaBloquesMacro.png
