Stachovsky/TrabajoProfesional/Documentacion/Diagramas/diagramaPreliminar_0.jpg

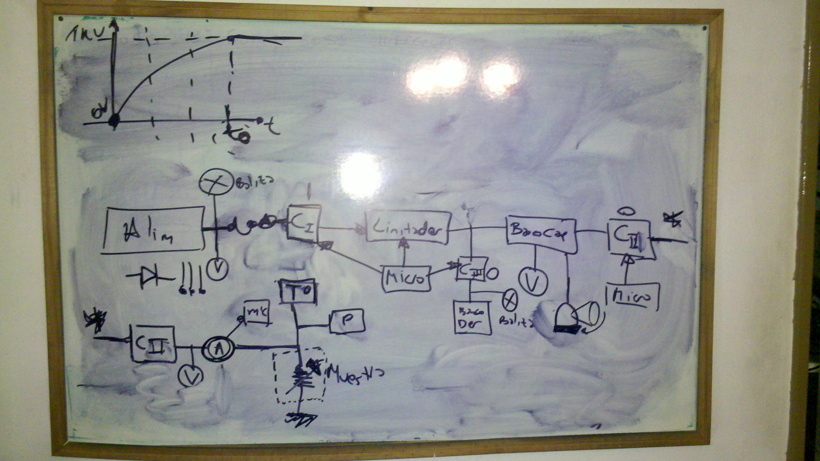
Documentacion/Diagramas/diagramaPreliminar_0.jpg
