Stachovsky/TrabajoProfesional/Documentacion/Diagramas/diagramaPreliminar_1.jpg

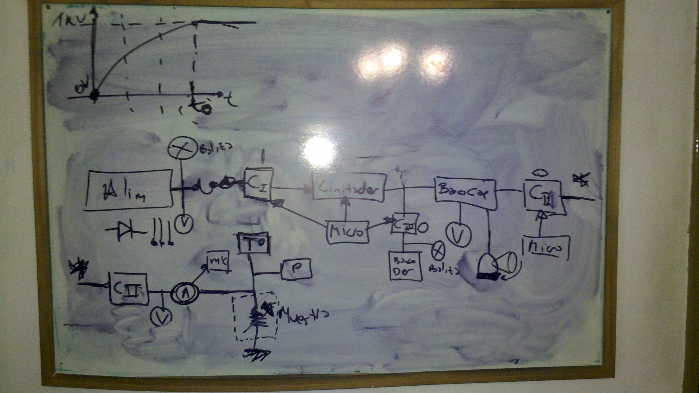
Documentacion/Diagramas/diagramaPreliminar_1.jpg
