Stachovsky/TrabajoProfesional/Documentacion/Diagramas/diagramaPreliminar_2.jpg

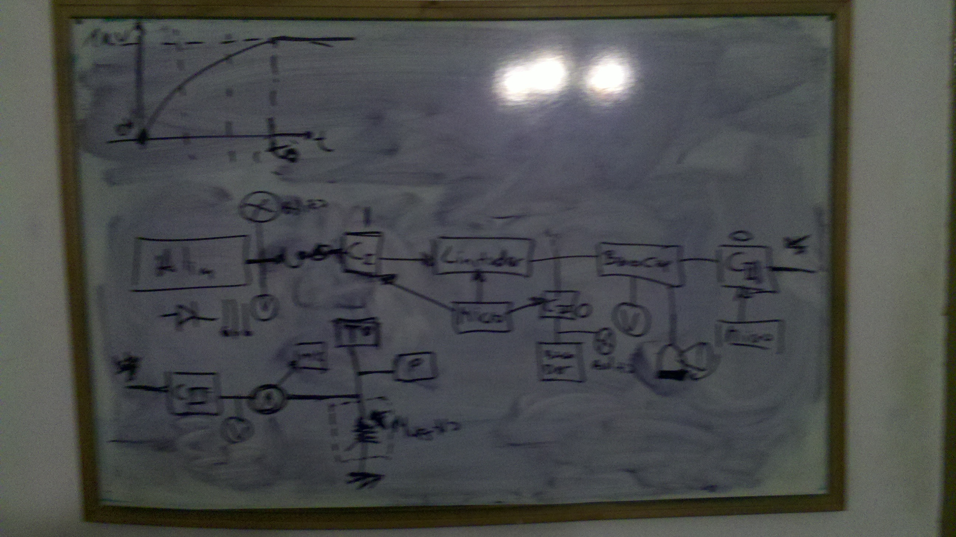
Documentacion/Diagramas/diagramaPreliminar_2.jpg
