Stachovsky/TrabajoProfesional/Documentacion/Diagramas/ECAS_control.png

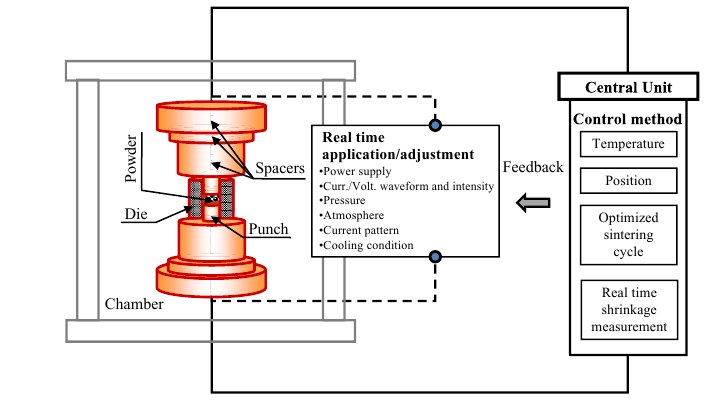
Documentacion/Diagramas/ECAS_control.png
