Stachovsky/TrabajoProfesional/Documentacion/Diagramas/Flor.jpg

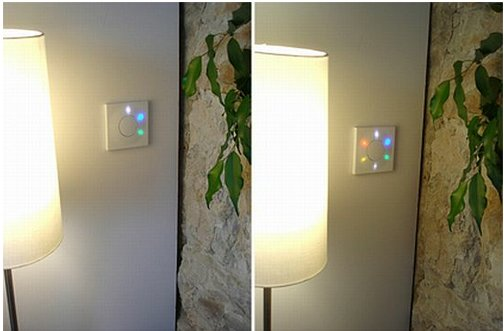
Documentacion/Diagramas/Flor.jpg
