Stachovsky/TrabajoProfesional/Documentacion/Diagramas/FotosRelevamiento/CajaLR.JPG

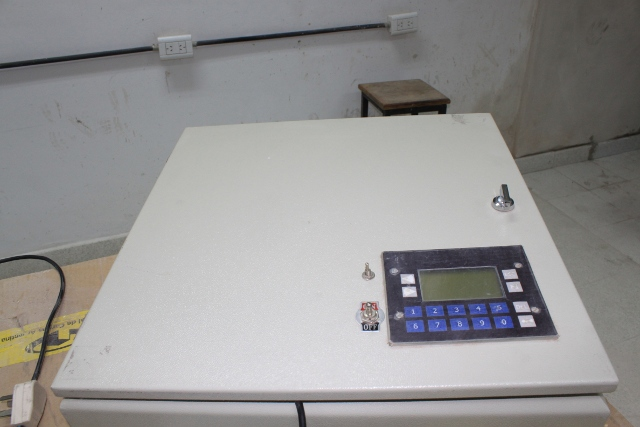
Documentacion/Diagramas/FotosRelevamiento/CajaLR.JPG
