Stachovsky/TrabajoProfesional/Documentacion/Diagramas/FotosRelevamiento/CapacitoresDetalleLR.JPG

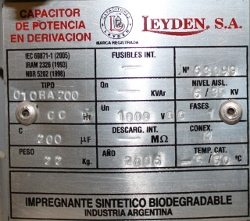
Documentacion/Diagramas/FotosRelevamiento/CapacitoresDetalleLR.JPG
