Stachovsky/TrabajoProfesional/Documentacion/Diagramas/FotosRelevamiento/ControlLR.JPG

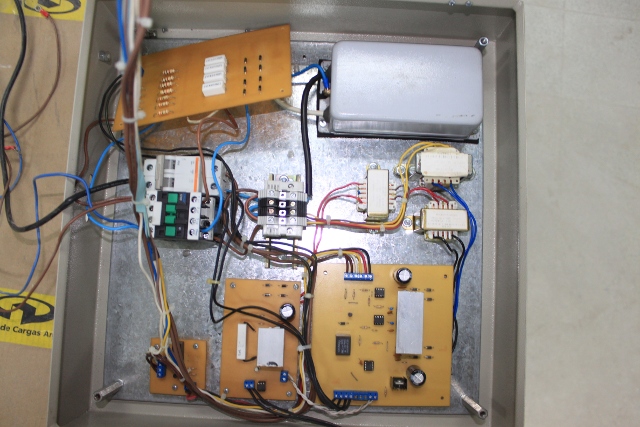
Documentacion/Diagramas/FotosRelevamiento/ControlLR.JPG
