Stachovsky/TrabajoProfesional/Documentacion/Diagramas/FotosRelevamiento/PrensaLR.JPG

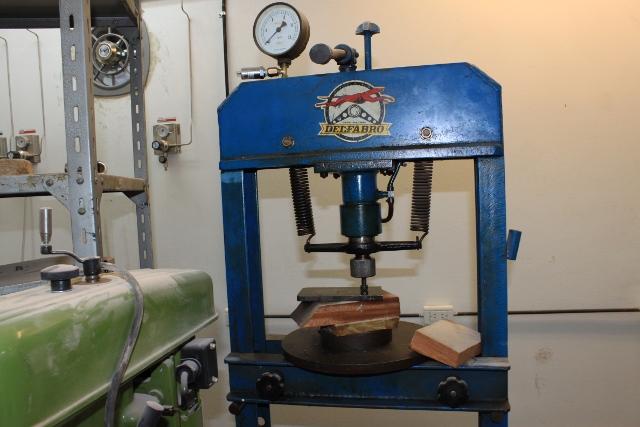
Documentacion/Diagramas/FotosRelevamiento/PrensaLR.JPG
