Stachovsky/TrabajoProfesional/Documentacion/Diagramas/FotosRelevamiento/SensorPresion1LR.JPG

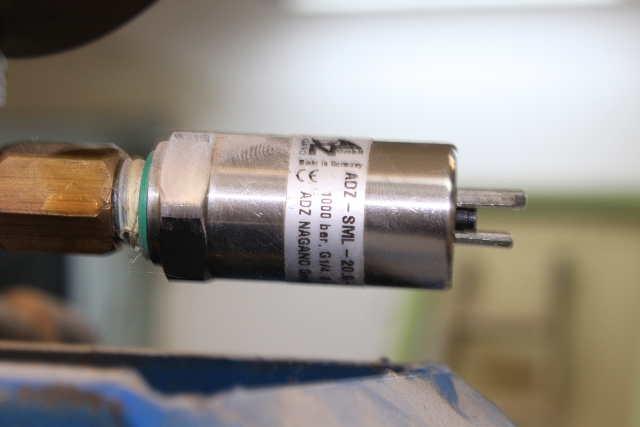
Documentacion/Diagramas/FotosRelevamiento/SensorPresion1LR.JPG
