Stachovsky/TrabajoProfesional/Documentacion/Diagramas/FotosRelevamiento/SensorPresion2LR.JPG

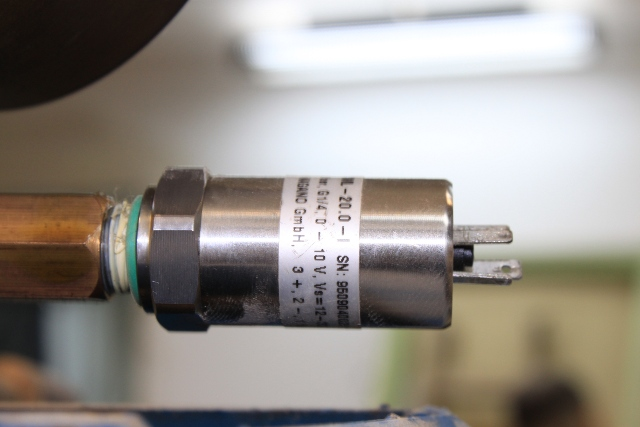
Documentacion/Diagramas/FotosRelevamiento/SensorPresion2LR.JPG
