Stachovsky/TrabajoProfesional/Documentacion/Diagramas/FotosRelevamiento/SensorPresion3LR.JPG

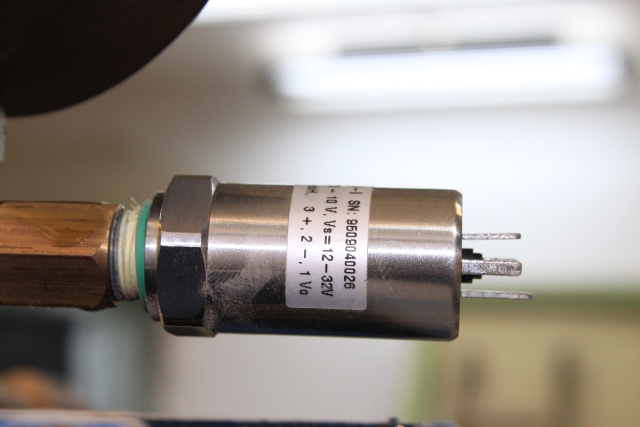
Documentacion/Diagramas/FotosRelevamiento/SensorPresion3LR.JPG
