Stachovsky/TrabajoProfesional/Documentacion/Diagramas/image002.jpg

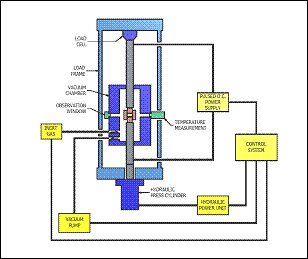
Documentacion/Diagramas/image002.jpg
