Stachovsky/TrabajoProfesional/Documentacion/Diagramas/Micro.png

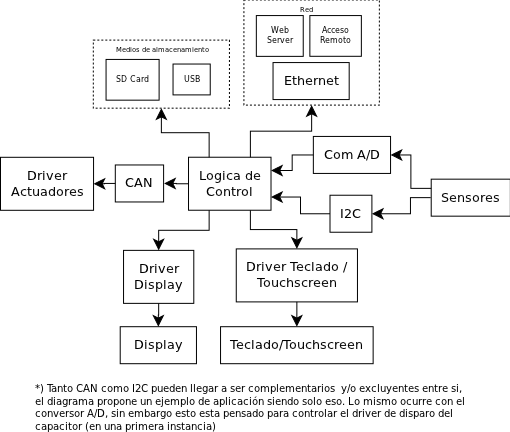
Documentacion/Diagramas/Micro.png
