Stachovsky/TrabajoProfesional/Documentacion/Diagramas/saverclip.jpg

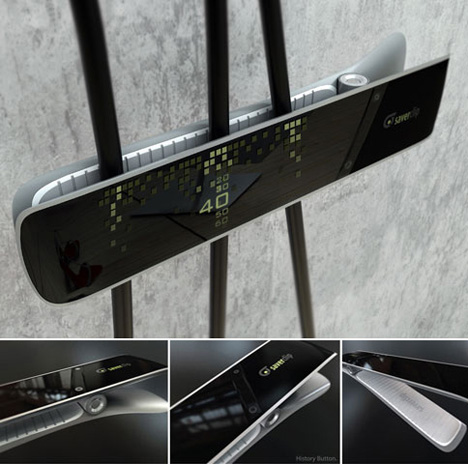
Documentacion/Diagramas/saverclip.jpg
