Stachovsky/TrabajoProfesional/Documentacion/Diagramas/vampiro.jpg

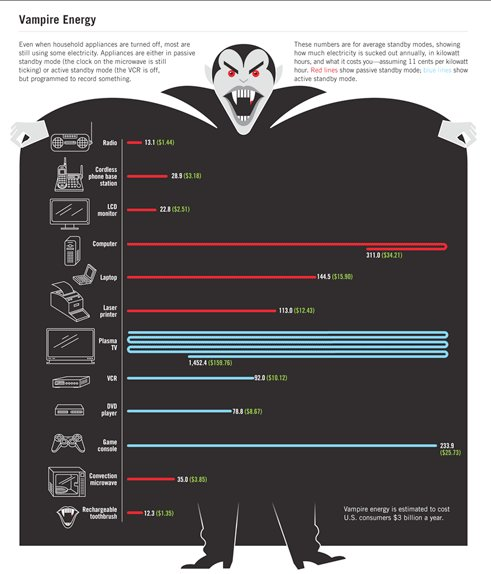
Documentacion/Diagramas/vampiro.jpg
