Stachovsky/TrabajoProfesional/Documentacion/FotosRelevamiento/anclajeCapacitoresFrontal.jpg

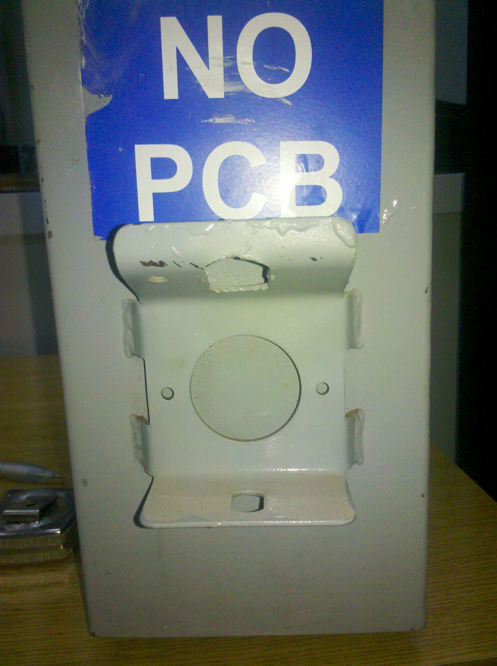
Documentacion/FotosRelevamiento/anclajeCapacitoresFrontal.jpg
