Stachovsky/TrabajoProfesional/Documentacion/FotosRelevamiento/anclajeCapacitoresLateral.jpg

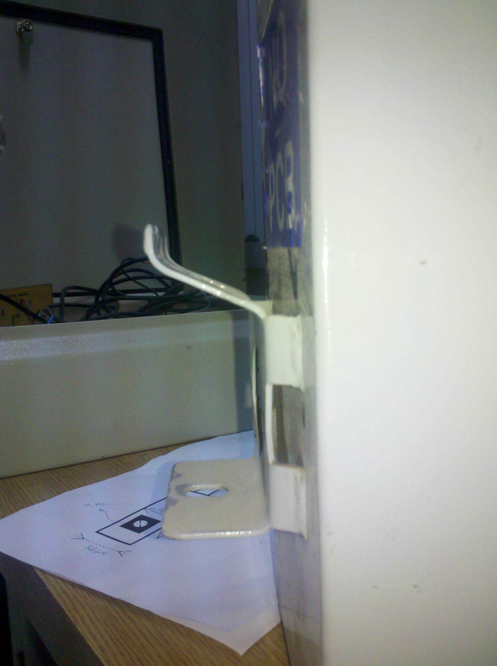
Documentacion/FotosRelevamiento/anclajeCapacitoresLateral.jpg
