Stachovsky/TrabajoProfesional/Documentacion/FotosRelevamiento/capacitores.jpg

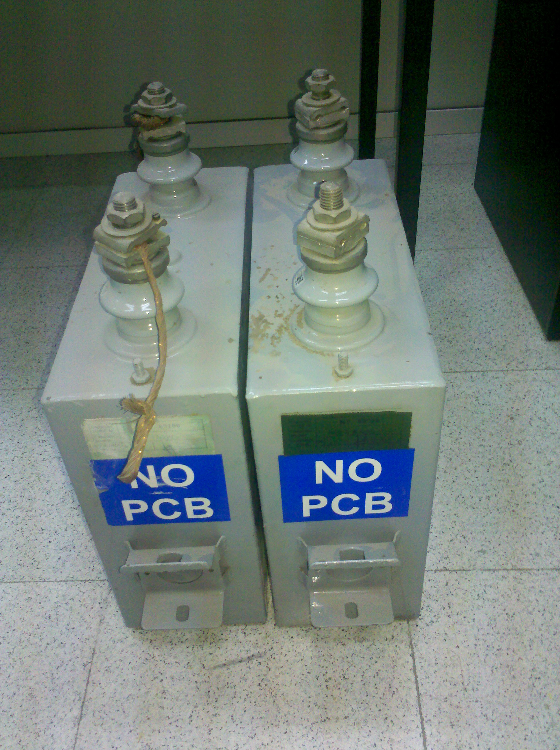
Documentacion/FotosRelevamiento/capacitores.jpg
