Stachovsky/TrabajoProfesional/Documentacion/FotosRelevamiento/capacitoresVistaSUperiorRelacionBaldoza30cm.jpg

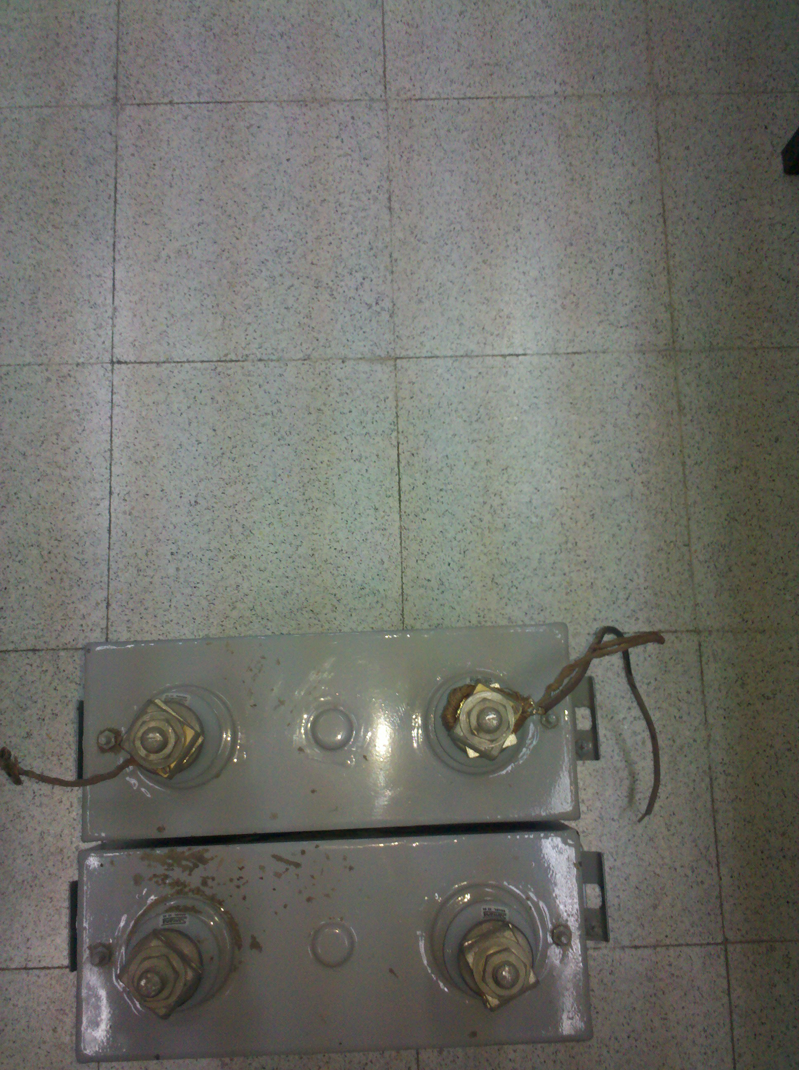
Documentacion/FotosRelevamiento/capacitoresVistaSUperiorRelacionBaldoza30cm.jpg
