Stachovsky/TrabajoProfesional/Documentacion/FotosRelevamiento/capcitoresVistaSuperior.jpg

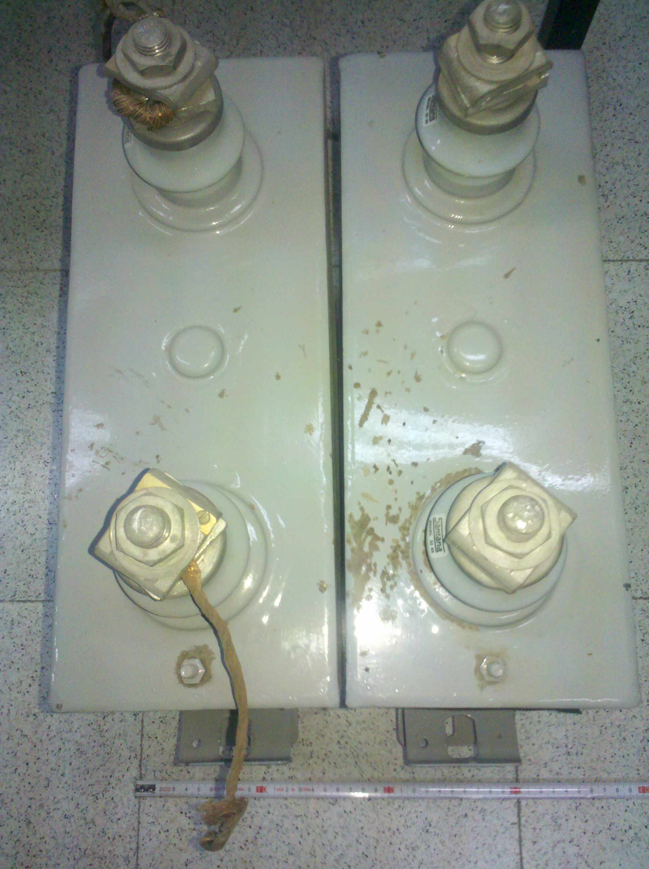
Documentacion/FotosRelevamiento/capcitoresVistaSuperior.jpg
