Stachovsky/TrabajoProfesional/Patallas/Descarga EDC 500V.BMP

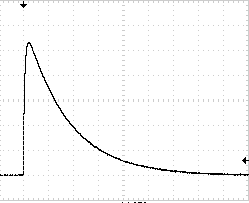
Patallas/Descarga EDC 500V.BMP
