Stachovsky/TrabajoProfesional/Patallas/PantallaDatos.png

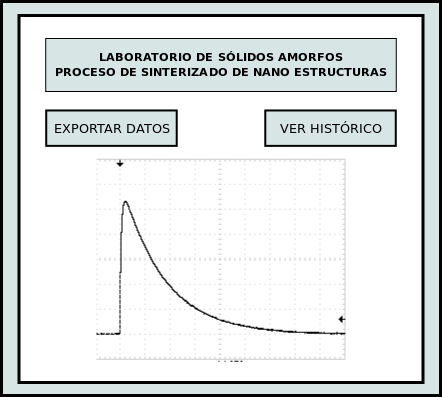
Patallas/PantallaDatos.png
