Stachovsky/TrabajoProfesional/Patallas/PantallaLogin.png

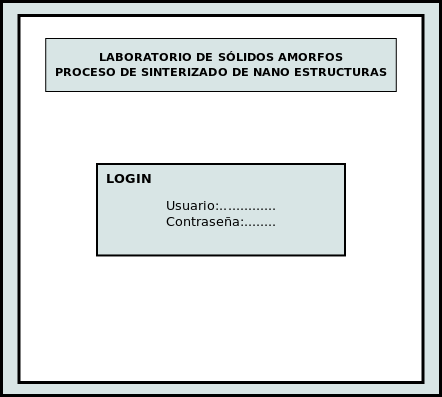
Patallas/PantallaLogin.png
