Stachovsky/TrabajoProfesional/Patallas/PantallaProceso.png

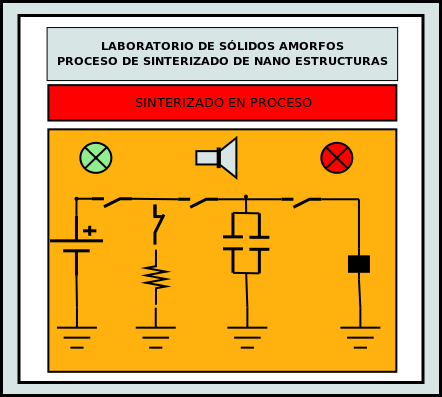
Patallas/PantallaProceso.png
