Stachovsky/TrabajoProfesional/Pcbs/12v-fan-directly-on-220vcircuit-diagram.png

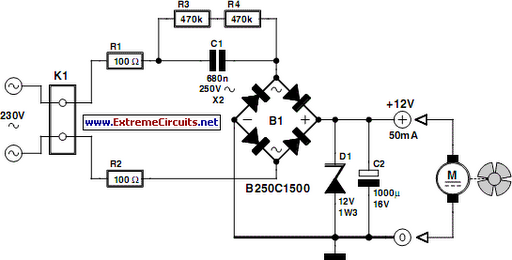
Pcbs/12v-fan-directly-on-220vcircuit-diagram.png
