Stachovsky/TrabajoProfesional/Pcbs/FuenteVariableAltaTension/Adjustable-High-voltage-power-supply.jpg

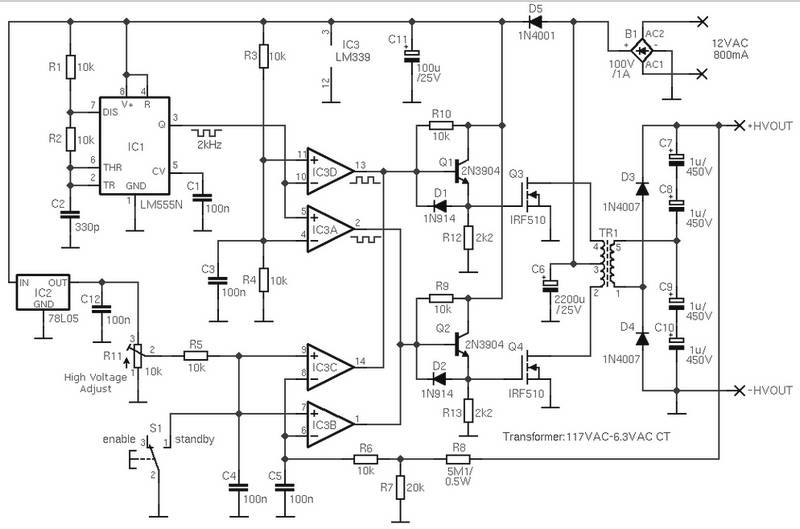
Pcbs/FuenteVariableAltaTension/Adjustable-High-voltage-power-supply.jpg
