Stachovsky/TrabajoProfesional/Pcbs/PcbsCotizacion/AcopladorAccionadoresPotencia/AcopladorAccionadoresPotencia.png

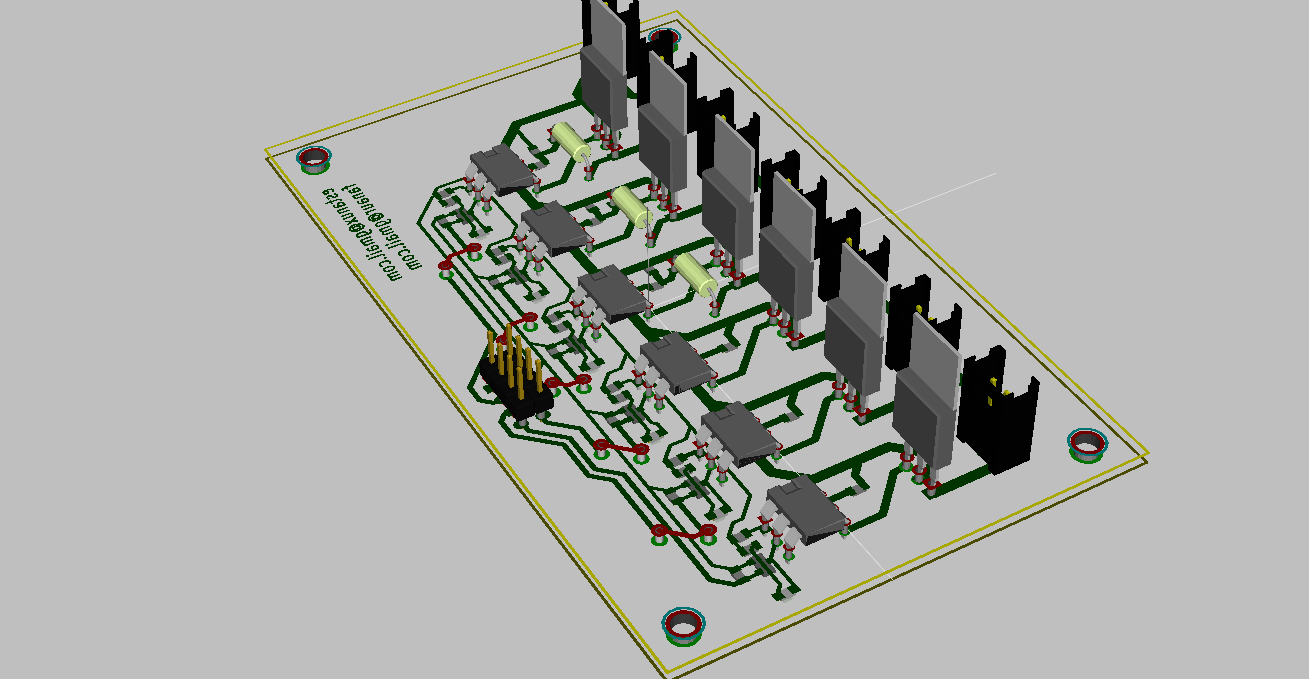
Pcbs/PcbsCotizacion/AcopladorAccionadoresPotencia/AcopladorAccionadoresPotencia.png
