Stachovsky/TrabajoProfesional/Pcbs/PcbsCotizacion/DisplayGraficoConectorUSB/DisplayGraficoConectorUSB.png

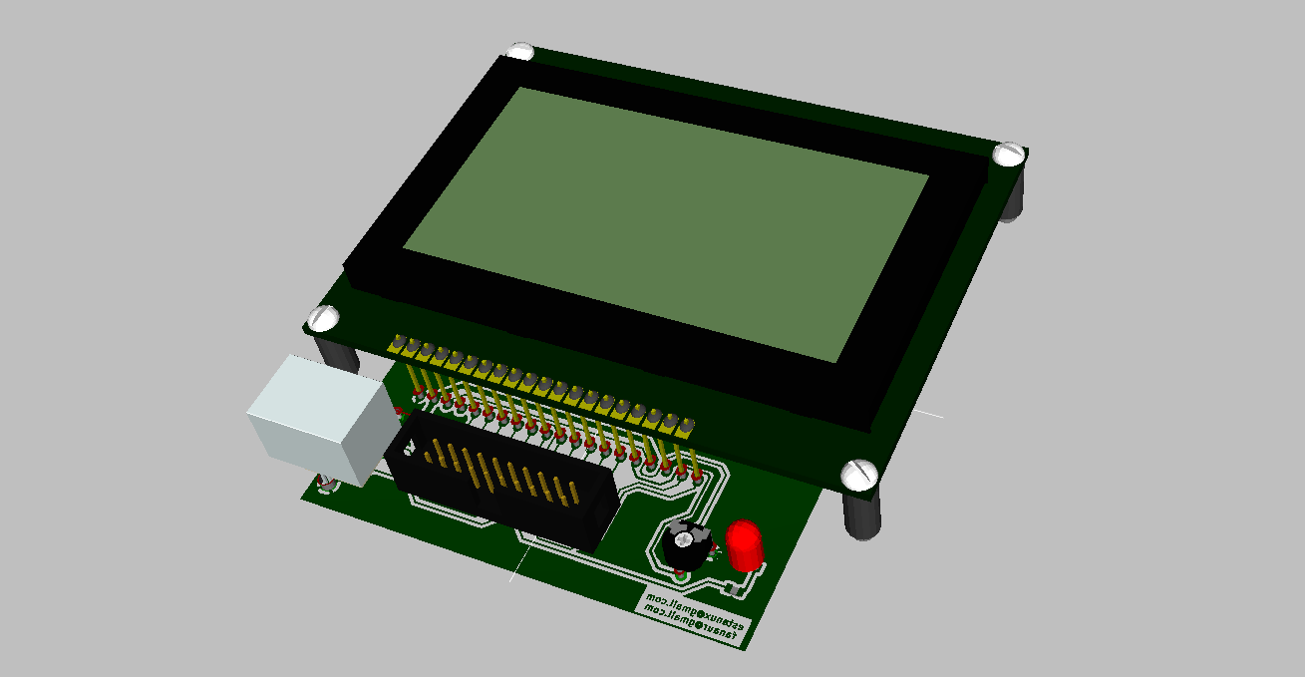
Pcbs/PcbsCotizacion/DisplayGraficoConectorUSB/DisplayGraficoConectorUSB.png
