Stachovsky/TrabajoProfesional/Pcbs/PcbsCotizacion/FuenteHvDC/FuenteHvDC.png

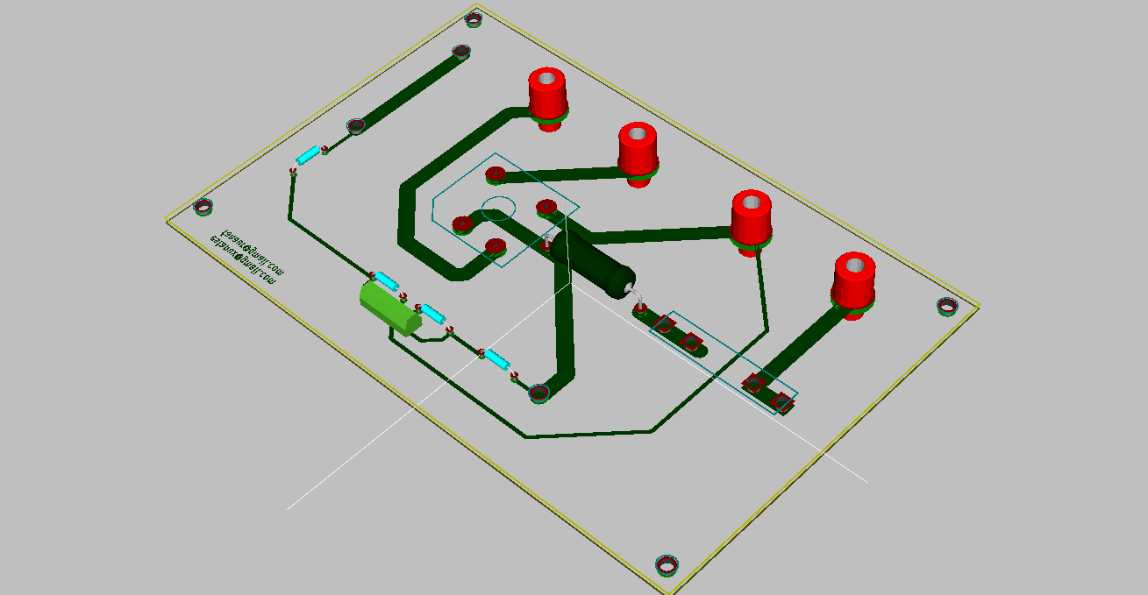
Pcbs/PcbsCotizacion/FuenteHvDC/FuenteHvDC.png
