Stachovsky/TrabajoProfesional/Pcbs/PcbsCotizacion/SensoresHvI_Accionadores/SensoresHvI_Accionadores.png

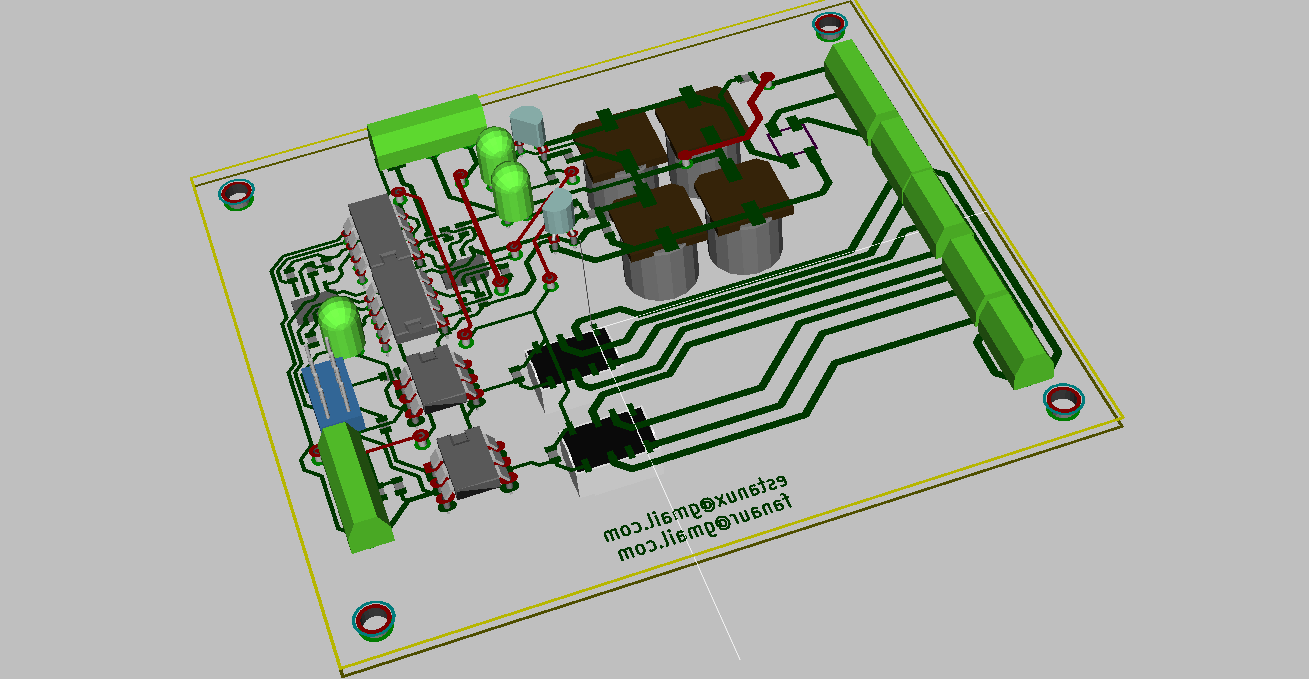
Pcbs/PcbsCotizacion/SensoresHvI_Accionadores/SensoresHvI_Accionadores.png
