Stachovsky/TrabajoProfesional/Simulaciones/circuitoAntiRebotePulsador.png

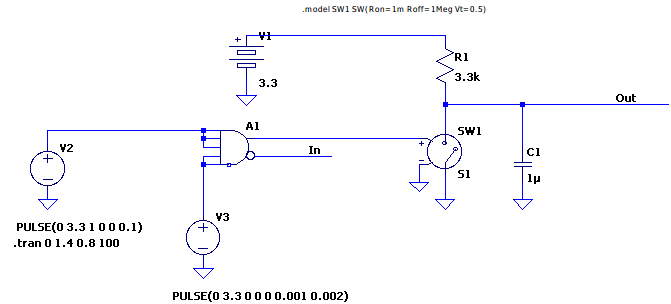
Simulaciones/circuitoAntiRebotePulsador.png
