Stachovsky/TrabajoProfesional/Simulaciones/DescargaCapacitores/CircuitoSimulacionDescargaCapacitores.png

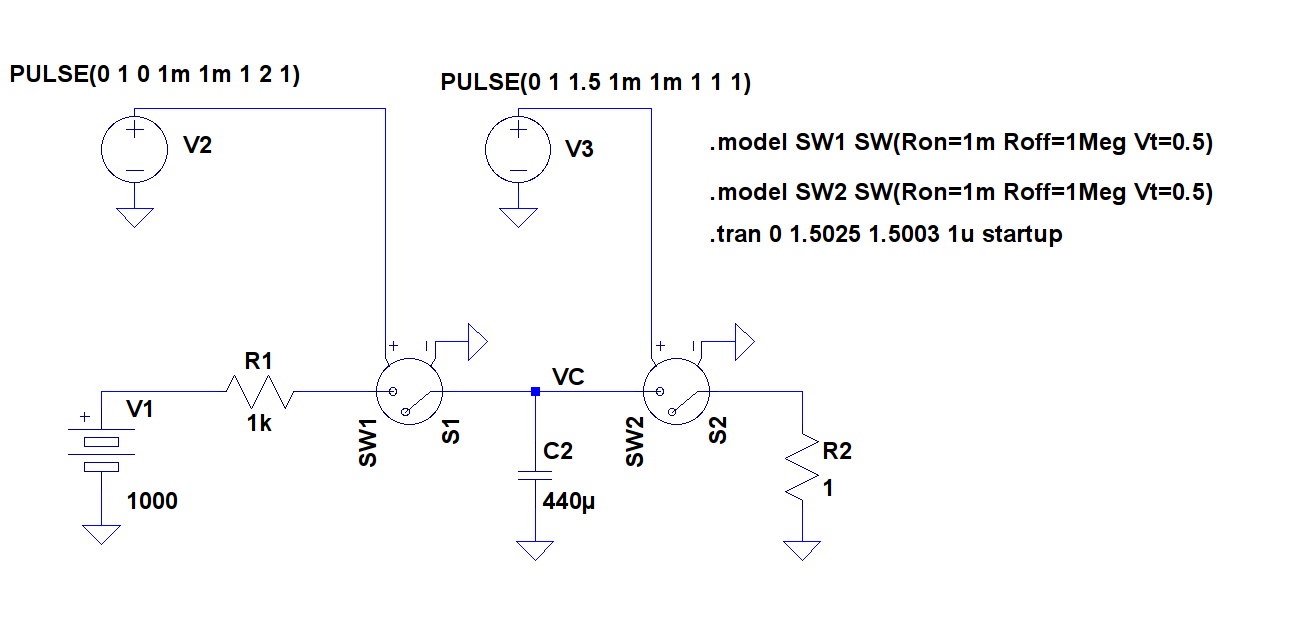
Simulaciones/DescargaCapacitores/CircuitoSimulacionDescargaCapacitores.png
