Stachovsky/TrabajoProfesional/Compras/20130607ListaDeCompras.ods

Lista de Compras
Item | Descripción | Cantidad | Precio | Comprado
Tira de pines Hembra a placa X 54 | Hembra para El stick | 1 |  | TRUE
Bornera de 3 | Bornera placa | 5 |  | TRUE
Bornera de 2 | Bornera placa | 5 |  | TRUE
LM7815 | Regulardor +15V TO-220 | 1 |  | TRUE
LM7915 | Regulador -15V TO-220 | 1 |  | TRUE
LM7805 | Regulador +5V TO-220 | 1 |  | TRUE
LM7905 | Regulador -5V TO-220 | 2 |  | TRUE
Termo contraibles X 1mts | Tamaño para Cable normal, Pequeño, Etc | 3 |  | TRUE
Riel Din | 15cm | 1 |  | TRUE
Trafo +/-15V | trafo para alimentar Los +/-15V del Sensor de I y +/-5 | 1 | $45.00 | TRUE
Botón Rojo tipo hongo | botón de parada | 1 |  | TRUE
Capacitor 2200v 2.2nF | Simulación descarga | 4 |  | TRUE
Luces torre | luces | 3 |  | FALSE
Conector inter lock Chasis EMI | inter lock | 1 |  | TRUE
Llave ignición | llave | 1 |  | TRUE
