Stachovsky/TrabajoProfesional/Informes/AnalisisEconomico/AnalsisEconomicoTPprof.ods

Sheet: CostosFijosNoRecurrentes
Tarea | Detalle Tarea | Tiempo en Días | Tiempo en horas | Personal | Honorarios | Sueldos del Personal
1 | Investigación y Normativa | 4 | 32 | Ingeniero | $2.182
2 | Solución Probable | 10 | 80 | Ingeniero | $5.455 | Personal | Sueldo Bruto | Costo Hora
3 | Diagrama en Bloques | 2 | 16 | Ingeniero | $1.091 | Ingeniero | $12.000 | $68
4 | Análisis de los Bloques | 2 | 16 | Ingeniero | $1.091 | Programador | $10.000 | $57
5 | Especificación de la Solución | 15 | 120 | Ingeniero | $8.182 | Técnico | $5.000 | $28
5.1 | Reunión con el cliente | 1 | 8 | Ingeniero | $545
5.2 | Especificaciones técnicas finales | 14 | 112 | Ingeniero | $7.636
6 | Desarrollo del Software | 135 | 1080 | Programador | $17.280
6.1 | Desarrollo software dispositivo | 80 | 640 | Programador | $10.240
6.1.1 | Desarrollo módulos individuales funcionales | 45 | 360 | Programador | $5.760
6.1.2 | Desarrollo firmware de dispositivo | 30 | 240 | Programador | $3.840
6.1.3 | Validación Firmware de dispositivo | 5 | 40 | Ingeniero | $2.727
6.2 | Desarrollo software programa PC | 35 | 280 | Programador | $4.480
6.2.1 | Desarrollo programa PC | 20 | 160 | Programador | $2.560
6.2.2 | Validación funcionamiento programa PC | 15 | 120 | Ingeniero | $8.182
6.3 | Integración Dispositivo – PC | 20 | 160 | Programador | $2.560
7 | Prueba de concepto | 20 | 160 | Ingeniero | $10.909
8 | Diseño del Circuito Electrónico | 20 | 160 | Técnico | $1.280
8.1 | Selección de los componentes | 15 | 120 | Técnico | $960
8.2 | Diseño de Circuito Impreso | 5 | 40 | Técnico | $320
9 | Compra de Elementos | 30 | 240 | Técnico | $1.920
10 | Construcción del Circuito Impreso | 13 | 104 | Técnico | $832
11 | Diseño y Construcción del gabinete | 15 | 120 | Técnico | $960
12 | Armado de dispositivo | 20 | 160 | Técnico | $1.280
13 | Validación final | 20 | 160 | Ingeniero | $10.909
14 | Optimización | 20 | 160 | Ingeniero | $10.909
15 | Generación de Documentación | 20 | 160 | Técnico | $1.280
 |  |  |  | Costo fijo no recurrente | $125.370
 |  |  |  | Costo fijo de De producción Anual | $125.370

Sheet: CostosVariablesDirectors
Index | Cantidad | Código | Descripción | Referencia Del Cliente | Cantidad Disponible | Precio Por Unidad USD | Precio Extendido USD
1 | 2 | F3568-ND | FUSE 1000V 3AB FAST CERM ,315A | FUSIBLE 1000V | 2 | 7,19 | $14,38
2 | 4 | 751-1292-5-ND | OPTOCOUPLER HI GAIN WIDE BW 8DIP | OPTOACOPLADOR LINEAL | 4 | 4,43 | $17,72
3 | 2 | 850F10KE-ND | RES ALUM HOUSED WW 10K OHM 50W | RESISTENCIA DESCARGA | 2 | 7,68 | $15,36
4 | 1 | MT7348-ND | SENSOR CURRENT +/-1500A +/-15V | SENSOR CORRIENTE EFECTO HALL | 1 | 85 | $85,00
5 | 1 | EA-XPR-003-ND | BOARD LPCXPRESSO LPC1769 | LpcXpresso | 1 | 29,95 | $29,95
6 | 2 | 768-1007-1-ND | IC USB FS SERIAL UART 28-SSOP | IC Usb-Uart | 2 | 4,5 | $9,00
7 | 1 | 679-1358-ND | SWITCH OPERATOR 24MM EMERGENCY | Boton Paro de Emergencia | 1 | 9,25 | $9,25
8 | 6 | 732-1927-ND | HEADER MALE 4,20MM DUAL VERT 2P | Conector drivers contactores y luces | 6 | 0,81 | $4,86
9 | 6 | 296-1284-1-ND | IC OPAMP JFET 3MHZ DUAL 8SOIC | Operacional Doble | 6 | 0,66 | $3,96
10 | 4 | 4N28VS-ND | OPTOCOUPLER PHOTOTRANS 10% 6DIP | Optoacoplador salida transistor | 4 | 0,57 | $2,28
11 | 2 | SRR1260-331KCT-ND | INDUCTOR POWER 330UH 1,15A SMD | Inductancia 330mH fuente | 2 | 0,93 | $1,86
12 | 2 | 296-21824-1-ND | IC REG BUCK 5V 1A 5-DDPAK | DC Switching Regulators | 2 | 2,39 | $4,78
13 | 4 | 1N5819HW-FDICT-ND | DIODE SCHOTTKY 40V 1A SOD123 | Diodo SCHOTTKY | 4 | 0,52 | $2,08
14 | 10 | MOC3011M-ND | OPTOCOUPLER TRIAC-OUT 6-DIP | Optotriac | 10 | 0,559 | $5,59
15 | 15 | 2N7002K-T1-E3CT-ND | MOSFET N-CH 60V 300MA SOT-23 | MOSFET N | 15 | 0,38 | $5,70
16 | 8 | 568-5670-5-ND | TRIAC 600V 4A TO220AB | Traic | 8 | 0,64 | $5,12
17 | 1 | NHD-12864WG-CTFH-V#N-ND | LCD GRAPHIC 128X64 TRANSFL | Display Grafico | 1 | 25 | $25,00
18 | 2 | PCE3625CT-ND | CAP ALUM 2200UF 16V 20% SMD | Capacitor 2200uF | 2 | 2,81 | $5,62
19 | 3 | PB1172CT-ND | RELAY TELECOM DPDT 5A 5V | Rele doble SMD | 3 | 3,17 | $9,51
20 | 1 | A31725-ND | CONN USB RECEPT R/A TYPE B 4POS | Conector USB B | 1 | 1,92 | $1,92
21 | 6 | F4187-ND | CLIP FUSE 1/4" EARLESS PC MOUNT | Porta fusible | 6 | 0,19 | $1,14
22 | 4 | HVS20H-ND | CONN HEADER 20PS VERT SHORT GOLD | Conector 20 pines placa | 4 | 1,53 | $6,12
23 | 2 | 101-00708-64-ND | CONN SD/MMC 9PIN PCB GOLD FLASH | Slot SdCard | 2 | 1,94 | $3,88
24 | 4 | 568-4140-1-ND | DIODE ESD PROTECTION SOT143B | Proteccion USB | 4 | 0,57 | $2,28
25 | 4 | HSC20S-ND | CONN SOCKT IDC 20POS W/O KEY TIN | Conector 20 pines cable | 4 | 0,56 | $2,24
26 | 8 | 609-3531-ND | CONN HEADER 8POS DUAL VERT PCB | Conector 8 pines placa | 8 | 1,05 | $8,40
27 | 8 | 609-3568-ND | CONN SOCKET IDC 8POS DL SR 30AU | Conector 8 pines cable | 8 | 0,94 | $7,52
28 | 20 | A33231-ND | CONN HEADER 3MM 2POS DUAL GOLD | Conector 2 pines placa | 20 | 0,926 | $18,52
29 | 20 | A30293-ND | CONN RCPT 3MM 2POS DL MATE-N-L | Conector 2 pines cable | 20 | 0,405 | $8,10
30 | 50 | A33279-ND | CONN SOCKET 26-30AWG GOLD CRIMP | Crimp conector 2 pines cable | 50 | 0,1392 | $6,96
31 | 2 | A30259-ND | CONN RECEPT 3MM 3POS MATE-N-LOK | Conector 3 pines cable sensor corriente | 2 | 0,44 | $0,88
32 | 2 | A33198-ND | CONN HEADER 3MM 3POS GOLD T/H | Conector 3 pines placa sensor corriente | 2 | 0,91 | $1,82
33 | 6 | A102007-ND | CONN HOUSING 1POS BLACK | Conector HV cable | 6 | 0,67 | $4,02
34 | 6 | 1744042-1-ND | CONN TERM NON GENDERED 16-20AWG | Pin HV placa | 6 | 0,27 | $1,62
35 | 6 | MDB10SFSCT-ND | IC BRIDGE DIODE 1000V 4-MICRODIP | Punte diodos 1A | 6 | 0,45 | $2,70
36 | 1 | GBPC3512W-ND | RECT BRIDGE 1-PH 1200V 35A GBPCW | Puente diodos 1200v | 1 | 4,16 | $4,16
37 | 10 | 160-1443-1-ND | LED GREEN CLEAR THIN 0603 SMD | Leds Verde | 10 | 0,243 | $2,43
38 | 10 | 160-1447-1-ND | LED SUPER RED CLR THIN 0603 SMD | Leds Rojo | 10 | 0,248 | $2,48
39 | 5 | 160-1647-1-ND | LED 468NM BLUE CLEAR 0603 SMD | Leds Azul | 5 | 0,45 | $2,25
40 | 5 | 160-1737-1-ND | LED WHITE YELLOW 260MCD 1206 | Leds Blancos | 5 | 0,58 | $2,90
41 | 25 | P1,0KECT-ND | RES 1,0K OHM 1/4W 5% 1206 SMD | Resistencia 1K | 25 | 0,1 | $2,50
42 | 25 | P10KECT-ND | RES 10K OHM 1/4W 5% 1206 SMD | Resistencia 10K | 25 | 0,1 | $2,50
43 | 25 | P560GCT-ND | RES 560 OHM 1/10W 5% 0603 SMD | Resistencia 560 | 25 | 0,1 | $2,50
44 | 25 | P270GCT-ND | RES 270 OHM 1/10W 5% 0603 SMD | Resistencia 270 | 25 | 0,1 | $2,50
45 | 10 | P5,6KGCT-ND | RES 5,6K OHM 1/10W 5% 0603 SMD | Resistencia 5,6K | 10 | 0,1 | $1,00
46 | 10 | P3,3KGCT-ND | RES 3,3K OHM 1/10W 5% 0603 SMD | Resistencia 3,3K | 10 | 0,1 | $1,00
47 | 6 | PCE3874CT-ND | CAP ALUM 330UF 10V 20% SMD | Capacitor 330uF | 6 | 0,75 | $4,50
48 | 6 | PCE3880CT-ND | CAP ALUM 100UF 16V 20% SMD | Capacitor 100uF | 6 | 0,55 | $3,30
49 | 10 | P2,2KGCT-ND | RES 2,2K OHM 1/10W 5% 0603 SMD | Resistencia 2,2K | 10 | 0,1 | $1,00
50 | 6 | RNX10,0MBCT-ND | RES 10,0M OHM 1% 100 PPM 1W | Resistencia 10M 1000v | 6 | 1,73 | $10,38
51 | 6 | P22KW-1BK-ND | RES 22K OHM 1W 5% METAL OXIDE | Resistencia 22K | 6 | 0,34 | $2,04
52 | 10 | 1N4148WXTPMSCT-ND | DIODE SWITCH 75V 150MA SOD323 | Diodo 1n4148 | 10 | 0,202 | $2,02
53 | 2 | D4AA14-ND | TRIMMER 10K OHM 0,1W TH | Presets | 2 | 0,54 | $1,08
54 | 6 | 490-4217-ND | CAP CER 10000PF 250V 20% RADIAL | Capacitor 0,1uF 220V | 6 | 0,62 | $3,72
55 | 2 | PCE3869CT-ND | CAP ALUM 22UF 10V 20% SMD | Capacitor 22uF | 2 | 0,44 | $0,88
56 | 2 | PCE3910CT-ND | CAP ALUM 4,7UF 25V 20% SMD | Capacitor 4,7uF | 2 | 0,44 | $0,88
57 | 20 | 445-1268-1-ND | CAP CER 0,1UF 16V Y5V 0402 | Capacitor 100nF | 20 | 0,024 | $0,48
58 | 4 | 445-4998-1-ND | CAP CER 1UF 6,3V 10% X5R 0402 | Capacitor 1uF | 4 | 0,1 | $0,40
TOTAL COMPRA DIGI-KEY
 |  |  |  |  |  | Subtotal | $392,04
 |  |  |  |  |  | Shipping | $145,87
 |  |  |  |  |  | Total | $537,91
 |  |  |  |  |  | Retención (20%) | $645,49
 |  |  |  |  |  | Nacionalización | $968,24
 |  |  |  |  |  | Cambio USD | 5,15
 |  |  |  |  |  | Total ARG Digi-key | 4986,43
59 | 1 | - | CONTACTOR NA | Contactor NA 1000V, 20A | 1 | $268,57 | $268,57
60 | 1 | - | CONTACTOR NA | Contactor NA 1000V, 1000A para t<2ms | 1 | $1.177,17 | $1.177,17
61 | 1 | - | CONTACTOR NC | Contactor NC 1000V, 20A | 1 | $268,57 | $268,57
62 | 1 | - | GABINETE | Carro tipo taller para gabinete | 1 | $700,00 | $700,00
63 | 1 | - | Extra para gabinete | Extra para gabinete | 1 | $0,00 | $0,00
64 | 2 | - | CAPACITORES ACEITE | Capacitores 200uF, 1000V | 2 | $4.436,83 | $8.873,66
65 | 3 | - | Placas PCB | Placas de circuito impreso | 3 | $66,67 | $200,01
66 | 1 | - | Cables | Cables para carga de capacitores | 1 |  | $0,00
67 | 1 | - | Cables | Cables para descarga de capacitores | 1 |  | $0,00
68 | 1 | - | Cables | Cables varios | 1 |  | $0,00
69 | 1 | - | Luces | Luces señalización de proceso | 1 | $450,00 | $450,00
70 | 1 | - | Sirena | Sirena señalización de proceso | 1 |  | $0,00
71 | 1 | - | Resistencia | Resistencia de carga de 47K, 15W | 2 | $5,00 | $10,00
72 | 1 | - | Goma aislante | Goma aislante para el gabinete | 1 |  | $0,00
73 | 1 | - | Separadores | Separadores de placa | 1 |  | $0,00
TOTAL |  |  |  |  |  |  | $16.274,39

Sheet: Desarrollo
Sueldos del Personal |  |  |  | Costos fijos indirectos
Personal | Sueldo Bruto | Costo Hora |  | Concepto | Cantidad | Costo
Ingeniero | $12.000 | $68 |  | Artículos librería | varios | $50
Programador | $10.000 | $57 |  | Bibliografía | varios | $200
Técnico | $5.000 | $28
 |  |  |  | Costo fijo indirecto |  | $250
Costos fijos no recurrentes |  |  |  | Costo fijo indirecto anuales |  | $3.000
Costo fijo no recurrente |  | 125370,18 | COSTO EN PERSONAL
Costo fijos de producción anuales |  | 125370,18
 |  |  |  | Costos fijos indirectos recurrentes
 |  |  |  | Concepto | Periodo | Costo
 |  |  |  | Servicios varios | Cada 12 meses | $5.000
Costos variables directos |  |  |  | Alquiler | Cada 12 meses | $150.000
Costo variable directo |  | 16274,39 | COSTO DE ELEMENTOS DEL DESAROLLO | Seguro | Cada 12 meses | $5.000
Costo variable directo con IVA(10%) |  | 17901,83 | CHEQUEAR SI VA! (creo que no)
Costos Totales Desarrollo
Costo fijo no recurrente
+ |  | $141.644,57
Costos variables directos |  |  |  | Costo indirectos recurrentes Anual |  | $160.000
 |  |  |  | Costo indirectos recurrentes Mensual |  | $13.333
Inversión y amortización
Inversión | Cantidad | Costo |  | Costo indirectos de producción anuales |  | $163.000 | TODOS LOS COSTOS INDIRECTOS
Osciloscopio | 1 | $3.000
Multimetro | 1 | $200
Computadora | 1 | $7.000
Impresora Laser | 1 | $500 |  | Costo variable directo |  |  | 4986,4257
Herramientas | varios | $500 |  | Costo variable directo con IVA(10%) |  |  | 5485,06827
Muebles oficina | varios | $20.000
Acondicionamiento Oficina | varios | $10.000
Inversión |  | $41.200
Amortización anual (en 4 años) |  | $10.300 | EQUIPAMIENTO LABORATORIO
 |  |  | CON MATERIALES DE DESARROLLO INCLUIDOS
Costos Operativos |  | $298.670 | $314.945

Sheet: AdminCom
Personal |  |  |  | Costos variables de administración
Personal | Cantidad | Costo | Hora | Concepto | Costo
Ingeniero | 1 | $12.000 | $68 | Insumos informáticos | $1.000
Técnico | 1 | $5.000 | $28 | Embalaje productos | $2.000
Programador | 1 | $10.000 | $57 | Insumos oficina | $1.000
Costo de Personal en Producción por equipo
Personal | Cantidad | Horas | Costo
Técnico | 1 | 8 | $227
Ingeniero | 1 | 2 | $136
TOTAL |  |  | $364
 |  |  |  | Costo variable de administración mensual | $4.000
 |  |  |  | Costo variable de administración anual | $48.000
Costos Administrativo |  |  |  | Costo variables administrativo Anual | $48.000
Empleados | Cantidad | Costo
Cadete | 1 | $2.000
Administrativo | 1 | $4.000
Costo Administrativo |  | $6.000
Costo fijos administrativo Anual |  | $72.000
Costos de comercialización
Concepto | Cantidad | Costo
Pagina Internet | 1 | $2.000
Publicidad Google | 1 | $1.500
Registro marca | 1 | $200
Responsable ventas | 1 | $3.500
Folletos | 2000 | $500
Costo comercialización mensual |  | $7.700
Costo comercialización anual |  | $92.400

Sheet: Ventas
Estimación de la evolución de las ventas
Año | Mes | Equipos Vendidos | Promedio anual de equipos vendidos | 6
1 | 1 | 3
2 | 2 | 5
3 | 3 | 9
4 | 4 | 8
5 | 5 | 6

Sheet: Costos
Costos
Costo | Total | Por equipo
Costo directo de producción | $16.274,39 | $16.274,39 | TODOS DE COMPONENTESS DEL PRODUCTO
Costo indirecto de producción | $163.000 | $27.166,67 | ALQUILERES, SEGUROS, ETC
Costos fijos producción | 0 | $363,64 | COSTO DEL PERSONAL POR EQUIPO
Costos fijos de administración | $72.000 | $12.000,00 | CADETE, ADMINISTRATIVO, ETC
Costos variables de administración | $48.000 | $8.000,00 | INSUMOS OFICINA, INFORMATICOS, EMBALAJE, ETC
Costos fijos de comercialización | $92.400 | $15.400,00 | MARKETING, PUBLICIDAD, ETC
Total Gastos fijos anuales | $375.400
 | Costo producto | $79.204,69
 | Ganancia [%] | 50
 | Precio Venta | $118.807,04
Gastos producción equipo por año
Año 1 | Año 2 | Año 3 | Año 4 | Año 5
$237.614 | $396.023 | $712.842 | $633.638 | $475.228
Ingresos producción por año
Año 1 | Año 2 | Año 3 | Año 4 | Año 5
$356.421 | $594.035 | $1.069.263 | $950.456 | $712.842

Sheet: FlujoDeFondo
COSTO DIRECTO X EQUIPO |  | $ 79.204,69
 | Ganancia | 50 | %
PRECIO DE VENTA X EQUIPO |  | $ 118.807,04
Año | Ventas | Ingresos | Egresos
 |  | Ventas | Costo fijo producción | Costo variable producción | Costo fijo administración | Costo variable administración (Estimacion fija) | Costo fijo comercialización | Costo variable comercialización | Amortización | Inversiones | Impuestos A las Ganancias | Impuesto Ingresos Brutos
0 | 0 | 0 | $ 141.644,57 | 0 | 0 | 0 | 0 | 0 |  | $ 41.200,00
1 | 3 | 356.421 | $ 1.090,91 | $ 48.823,18 | $ 72.000,00 | $ 48.000,00 | $ 92.400,00 | $2.903,23 | $ 8.240,00 |  | 0% | 3%
2 | 5 | 594.035 | $ 1.818,18 | $ 81.371,96 | $ 72.000,00 | $ 48.000,00 | $ 92.400,00 | $4.838,71 | $ 8.240,00 |  | 35% | 3%
3 | 9 | 1.069.263 | $ 3.272,73 | $ 712.842,25 | $ 72.000,00 | $ 48.000,00 | $ 92.400,00 | $8.709,68 | $ 8.240,00 |  | 35% | 3%
4 | 8 | 950.456 | $ 2.909,09 | $ 130.195,13 | $ 72.000,00 | $ 48.000,00 | $ 92.400,00 | $7.741,94 | $ 8.240,00 |  | 35% | 3%
5 | 6 | 712.842 | $ 2.181,82 | $ 97.646,35 | $ 72.000,00 | $ 48.000,00 | $ 92.400,00 | $5.806,45 | $ 8.240,00 |  | 35% | 3%
 |  |  | Costos por equipo (personal) | Costo por equipo (materiales)
 |  |  |  | Año 0 | Año 1 | Año 2 | Año 3 | Año 4 | Año 5 | Total
 |  |  | Inversión (amortizable) | $ 41.200,00
Costos Variables de comercializacion |  |  | Gastos desarrollo | $ 141.644,57
6,2 | $6.000,00 |  | Ingresos por ventas |  | 356.421 | 594.035 | 1.069.263 | 950.456 | 712.842 | 3.683.018
3 | $2.903,23 |  | Egresos |  | $ 265.217,31 | $ 300.428,85 | $ 937.224,66 | $ 353.246,16 | $ 318.034,62 | $ 2.174.151,60
5 | $4.838,71 |  | Beneficio bruto |  | $ 91.203,82 | $ 293.606,36 | $ 132.038,72 | $ 597.210,18 | $ 394.807,63 | $ 1.508.866,71
9 | $8.709,68 |  | Amortizaciones |  | $ 8.240,00 | $ 8.240,00 | $ 8.240,00 | $ 8.240,00 | $ 8.240,00 | $ 41.200,00
8 | $7.741,94 |  | Utilidad bruta |  | $ 82.963,82 | $ 285.366,36 | $ 123.798,72 | $ 588.970,18 | $ 386.567,63 | $ 1.467.666,71
6 | $5.806,45 |  | Impuestos a las ganancias |  | $ 0,00 | $ 99.878,23 | $ 43.329,55 | $ 206.139,56 | $ 135.298,67 | $ 484.646,01
 |  |  | Impuesto a los ingresos Brutos |  | $ 2.736,11 | $ 8.808,19 | $ 3.961,16 | $ 17.916,31 | $ 11.844,23 | $45.266,0
 |  |  | Utilidad neta |  | $ 80.227,70 | $ 176.679,94 | $ 76.508,01 | $ 382.830,61 | $ 239.424,73 | $ 955.671,00
 |  |  | Flujo de fondos | $ -182.844,57 | $ 88.467,70 | $ 184.919,94 | $ 84.748,01 | $ 391.070,61 | $ 247.664,73 | $ 814.026,43
 |  |  | Flujo de fondos acumulado | $ -182.844,57 | $ -94.376,87 | $ 90.543,07 | $ 175.291,08 | $ 566.361,69 | $ 814.026,43
 |  |  | VAN |  |  |  |  |  |  | $ 436.362,13
 |  |  | TIR |  |  |  |  |  |  | 75%
 |  |  | ROI | -21,51% | 10,41% | 21,76% | 9,97% | 46,02% | 29,14%
 |  |  | ROI Total | 95,78%
