Stachovsky/TrabajoProfesional/Informes/CasaDeCalidad/QualhouseSinterizado.ods

 |  |  |  |  |  |  |  |  |  |  |  |  |  |  |  |  |  |  | Puntuación Peso relativo de los RQ del Cliente
 |  |  |  |  |  |  |  |  |  |  |  |  |  |  |  |  |  |  | 1 | Baja importancia
 |  |  |  |  |  |  |  |  |  |  |  |  |  |  |  |  |  |  | 5 | Alta importancia
 |  |  |  |  |  |  |  |  |  |  |  |  |  |  |  |  |  |  | Mejoras = Planeado / Nuestro Producto
 |  |  |  |  |  |  |  |  |  |  |  |  |  |  |  |  |  |  | Peso Total = Peso Relat.Cliente x Mejora x Pto.de Venta
 |  | Especificaciones Técnicas
Dirección de la Mejora |  |  |  |  |  |  |  |  |  | Peso relativo de los RQ del Cliente | Nuestro Producto | Producto de la Competencia A (Codigo de barras) | Producto de la Competencia B (Compra por internet) | Metas Planeadas | Mejora | Punto de venta | Peso Total | Peso Total % | Peso Total % = Peso Total / Suma Pesos Totales
 |  | Pico de corriente en el momento de sinterizado |  |  |  | Norma de seguridad I | Norma de seguridad II
Requerimientos del Cliente |  |  |  |  |  |  |  |  |  |  |  |  |  |  |  |  |  |  | Puntuación Mapeo RQ del Cleinte en Especificaciones
Medición de corriente y tensión en Momento del sinterizado |  |  |  |  |  |  |  |  |  | 5 | 5 | 1 | 4 | 3 | 0,6 | 1,5 | 4,5 | 13% | 1 | Baja inter-relacióno
Escalabilidad futuras |  |  |  |  |  |  |  |  |  | 4 | 4 | 5 | 2 | 4 | 1,0 | 1,2 | 4,8 | 14% | 3 | Media inter-relacióm
Prensado de la pieza |  |  |  |  |  |  |  |  |  | 4 | 2 | 4 | 3 | 4 | 2,0 | 1,2 | 9,6 | 28% | 5 | Alta inter-relación
Interfaz gráfica amigable |  | 9 |  |  |  |  |  |  |  | 5 | 5 | 1 | 1 | 5 | 1,0 | 1,5 | 7,5 | 22%
Almacenamiento de datos externo (p.e. Pendrive) |  |  |  |  |  |  |  |  |  | 2 | 3 | 1 | 2 | 3 | 1,0 | 1,3 | 2,6 | 8%
Seguridad en el proceso |  |  |  |  |  |  |  |  |  | 2 | 2 | 1 | 2 | 4 | 2,0 | 1,2 | 4,8 | 14% | Peso total Prioridades Técnicas = S P Pesos Totales x Puntuación Mapeo de RQ en Espec.
 |  |  |  |  |  |  |  |  |  |  |  |  |  |  |  |  |  |  | E1:tiempo de procesamiento por producto menor a 10ms
Peso total Prioridades Técnicas |  | 68 | 0 | 0 | 0 | 0 | 0 | 0 | 0 | 68 |  |  |  |  | Total 100% |  | 33,8 | 100% | E2: tiempo de respuesta del protocolo anticolisión
Peso Relativo Prioridades Técnicas |  | 100% | 0% | 0% | 0% | 0% | 0% | 0% | 0% | 100% |  |  |  |  |  |  |  |  | E3: grado de encriptación de la información de las etiquetas
Benchmarking | Nuestro Producto |  |  |  |  |  |  |  |  | Total 100% |  |  |  |  |  |  |  |  | E4: alimentación de las etiquetas pasivas (sin alimentación externa)
 | Producto de la Competencia A (Producto Japonés) |  |  |  |  |  |  |  |  |  |  |  |  |  |  |  |  |  | E5: memoria
 | Producto de la Competencia B () |  |  |  |  |  |  |  |  |  |  |  |  |  |  |  |  |  | E6: tamaño de las etiquetas
Metas |  |  |  |  |  |  |  |  |  |  |  |  |  |  |  |  |  |  | E7: tamaño de las antenas
