Stachovsky/TrabajoProfesional/Documentacion/Material/Descarga EDC 500V.BMP

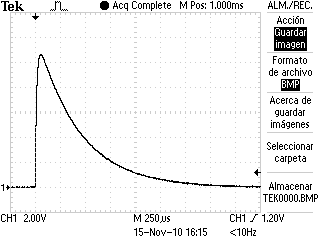
Documentacion/Material/Descarga EDC 500V.BMP
