Stachovsky/TrabajoProfesional/Documentacion/DataSheet/SensorTension/TestSensorTension.ods

Vin(mV) | Vout(mV)
0.4 | 0
55.1 | 67.6
188.3 | 239.9
255.8 | 320.9
321 | 403.1
