Stachovsky/TrabajoProfesional/Simulaciones/DescargaCapacitores/ResultadoSimulacionCargaDescargaCapacitores.png

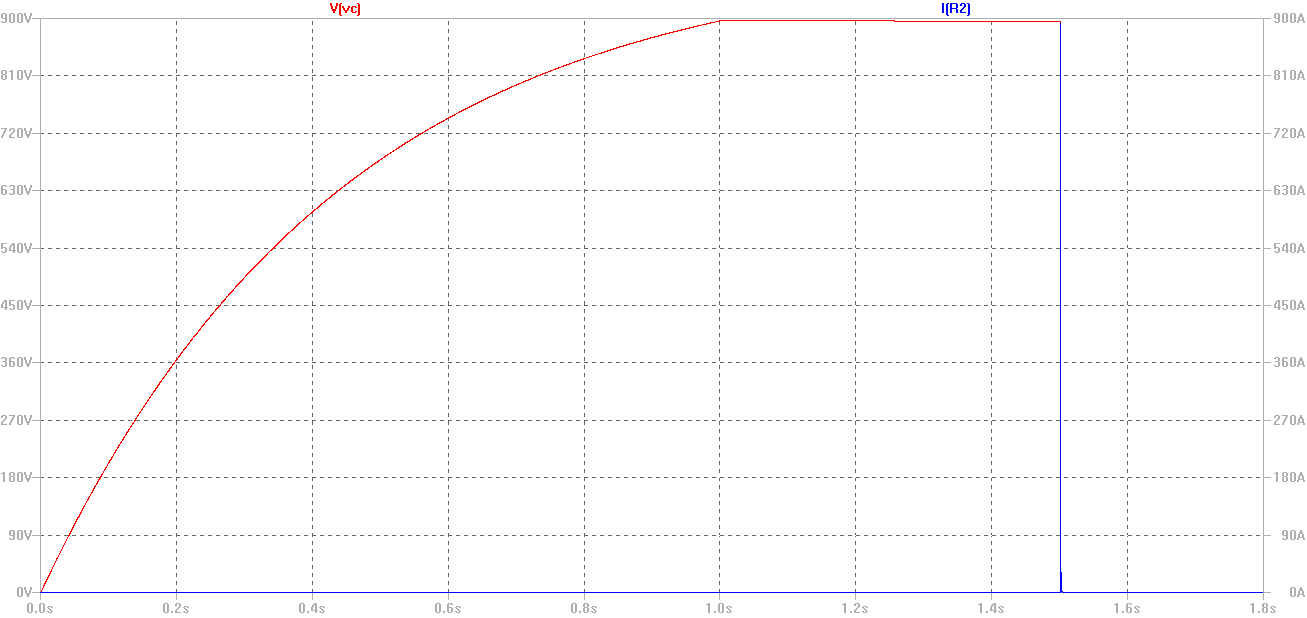
Simulaciones/DescargaCapacitores/ResultadoSimulacionCargaDescargaCapacitores.png
