Stachovsky/TrabajoProfesional/Simulaciones/DescargaCapacitores/ResultadoSimulacionDescargaCapacitores.png

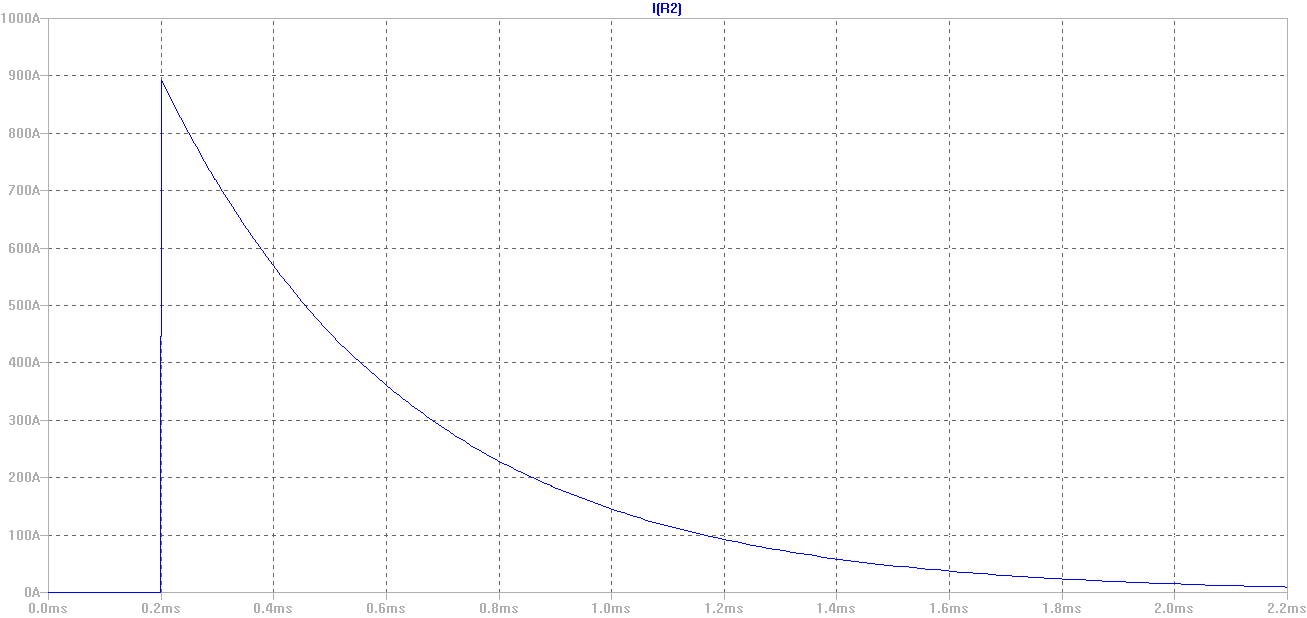
Simulaciones/DescargaCapacitores/ResultadoSimulacionDescargaCapacitores.png
