Stachovsky/TrabajoProfesional/Simulaciones/resultadoSimulacionAntiRebotePulsador.png

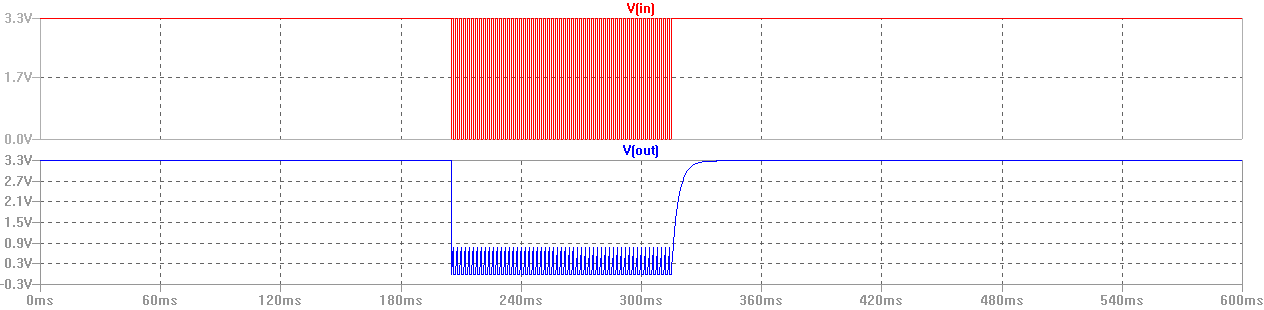
Simulaciones/resultadoSimulacionAntiRebotePulsador.png
