Stachovsky/TrabajoProfesional/Informes/FMEA/FMEA.pdf

# Módulo fuente alimentación

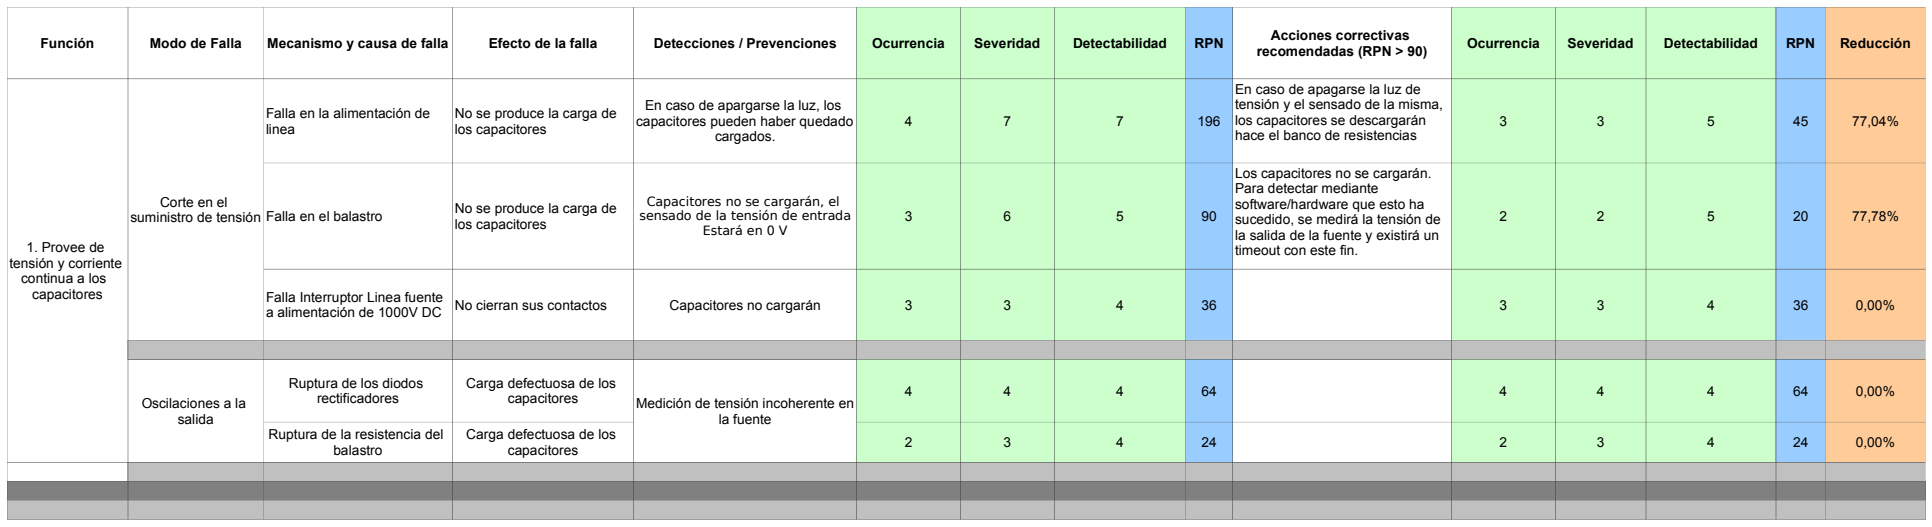
[picture p134: figure]
Función; Modo de Falla; Mecanismo y causa de falla; Efecto de la falla; Detecciones / Prevenciones; Ocurrencia; Severidad; RPN; Reducción; Falla en el balastro; No cierran sus contactos; Detectabilidad; Acciones correctivas; recomendadas (RPN > 90); 1. Provee de tensión y corriente continua a los capacitores; Corte en el suministro de tensión; Falla en la alimentación de linea; No se produce la carga de los capacitores; En caso de apargarse la luz, los capacitores pueden haber quedado cargados.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

# Módulo microprocesador

Función | Modo de Falla | Mecanismo y causa de falla | Efecto de la falla | Detecciones / Prevenciones | Ocurrencia | Severidad | RPN | Ocurrencia | Severidad | RPN | Reducción
| 5 | 6 | 2 | 60 | 5 | 6 | 2 | 60 | 0,00%
Daño al microprocesador | 3 | 8 | 3 | 72 | 3 | 8 | 3 | 72 | 0,00%
Posible daño al sensor | 3 | 6 | 3 | 54 | 3 | 6 | 3 | 54 | 0,00%
| 5 | 6 | 2 | 60 | 5 | 6 | 2 | 60 | 0,00%
Daño al microprocesador | 3 | 8 | 3 | 72 | 3 | 8 | 3 | 72 | 0,00%
Posible daño al sensor | 3 | 6 | 3 | 54 | 3 | 6 | 3 | 54 | 0,00%
3 | 5 | 4 | 60 | 3 | 5 | 4 | 60 | 0,00%
Inducción de pistas próximas | 4 | 5 | 5 | 100 | 2 | 5 | 4 | 40 | 60,00%
4 | 5 | 3 | 60 | 4 | 5 | 3 | 60 | 0,00%
4 | 5 | 3 | 60 | 4 | 5 | 3 | 60 | 0,00%
Pistas con esquinas abruptas | 2 | 5 | 3 | 30 | 2 | 5 | 3 | 30 | 0,00%
Detectabilidad | Acciones correctivas
recomendadas (RPN > 90) | Detectabilidad
1. Procesa las
señales
provenien- tes de
los sensores.

Entrada en corto
circuito

Entrada en cortocircuito con la alimentación por soldadura defectuosa (pistas muy
proximas en el ruteo de la placa).

Daño a entrada del
microprocesador
Utilización de reglas de ruteo (clearence mínimos)

Entrada en cortocircuito por error en el ruteo de las pistas

Daño a entrada del
microprocesador | Uso de software con chequeo de
| conexiones

Entrada a circuito
abierto

Entrada a circuito abierto por

error en el ruteo de las pistas Lectura erronea del sensor. Uso de software con chequeo de conexiones

Señal ruidosa
(corrupción de datos)

Lectura erronea del sensor.

Uso de software con simulación de EMI (Interferencias
ElectroMagnéticas)

Armado de prototipo y testeo de transitorios y condiciones reales de trabajo.

Error en el ruteo del plano de masa

Lectura erronea del sensor.

Uso de software con simulación de EMI (Interferencias
ElectroMagnéticas)

Mala distribución de
componentes en la placa Lectura erronea del sensor.

Uso de software con simulación de EMI (Interferencias
ElectroMagnéticas)
| Lectura erronea del sensor.

Uso de software con simulación de EMI (Interferencias
ElectroMagnéticas)

Pistas actuando de antenas

2

5

3 | 30

2

5

3 | 30 | 0,00%

3

5

6 | 90

2

5

5 | 50 | 44,44%

3

6

5 | 90

2

6

5 | 60 | 33,33%

Daño al microprocesador

2

8

6 | 96

2

8

4 | 64 | 33,33%

2

6

5 | 60

2

6

5 | 60 | 0,00%

Daño al microprocesador

2

8

5 | 80

2

8

5 | 80 | 0,00%

2

6

5 | 60

2

6

5 | 60 | 0,00%

Daño al microprocesador

2

8

5 | 80

2

8

5 | 80 | 0,00%

4

6

3 | 72

4

6

3 | 72 | 0,00%

2

6

3 | 36

2

6

3 | 36 | 0,00%

Inducción de pistas próximas Errores en la comunicación

4

5

4 | 80

4

5

4 | 80 | 0,00%

Errores en la comunicación

4

5

4 | 80

4

5

4 | 80 | 0,00%

Errores en la comunicación

4

5

3 | 60

4

5

3 | 60 | 0,00%

Pistas con esquinas abruptas Errores en la comunicación

2

5

3 | 30

2

5

3 | 30 | 0,00%

Pistas actuando de antenas Errores en la comunicación

2

5

5 | 50

2

5

5 | 50 | 0,00%

Errores en la comunicación

3

5

6 | 90

3

5

4 | 60 | 33,33%

4

6

5 | 120

3

6

3 | 54 | 55,00%

Daño al microprocesador

3

8

6 | 144

3

8

3 | 72 | 50,00%

Posible daño al actuador

3

7

5 | 105

3

7

3 | 63 | 40,00%

3

6

3 | 54

3

6

3 | 54 | 0,00%

Daño al microprocesador

2

8

3 | 48

2

8

3 | 48 | 0,00%
Posible daño al actuador

2

7

3 | 42

2

7

3 | 42 | 0,00%

3

6

4 | 72

3

6

4 | 72 | 0,00%

Lectura erronea del sensor.

Uso de software con simulación de EMI (Interferencias
ElectroMagnéticas)
Pistas formando lazos de
corriente | Lectura erronea del sensor.

Uso de software con simulación de EMI (Interferencias
ElectroMagnéticas)

Armado de prototipo y testeo de transitorios y condiciones reales de trabajo.

2. Control del
proceso principal
del sinterizado

Puerto en corto
circuito

Puerto en cortocircuito con la alimentación por soldadura defectuosa (pistas muy
proximas en el ruteo de la placa).

Daño a entrada del
microprocesador | Utilización de reglas de ruteo
| (clearence minimos)

Testeo de continuidad entre pistas luego de la soldadura. Establecer clearence mínimo de ruteo

Testeo de continuidad entre pistas luego de la soldadura. Establecer clearence mínimo de ruteo
Puerto en cortocircuito por error en el ruteo de las pistas

Daño a entrada del
microprocesador | Uso de software con chequeo de
conexiones

Footprint inadecuado para el conector

Daño a entrada del
microprocesador | Chequeo con las hojas de datos
del fabricante del componente

Puerto a circuito
abierto | Puerto a circuito abierto por
error en el ruteo de las pistas

No se establece la
comunicación

Uso de software con chequeo de conexiones

Footprint inadecuado para el conector

No se establece la
comunicación

Chequeo con las hojas de datos del fabricante del componente

Señal ruidosa
(corrupción de datos) | Uso de software con simulación de
EMI (Interferencias
ElectroMagnéticas)

Error en el ruteo del plano de masa

Uso de software con simulación de EMI (Interferencias
ElectroMagnéticas)

Mala distribución de
componentes en la placa

Uso de software con simulación de EMI (Interferencias
ElectroMagnéticas)

Uso de software con simulación de EMI (Interferencias
ElectroMagnéticas)
Uso de software con simulación de EMI (Interferencias
ElectroMagnéticas)
Pistas formando lazos de
corriente

Uso de software con simulación de EMI (Interferencias
ElectroMagnéticas)

Rediseño de placa, cambio de posición de pistas

3. Manejo de
salida a
actuadores.

Puerto en corto
circuito

Puerto en cortocircuito con la alimentación por soldadura defectuosa (pistas muy
proximas en el ruteo de la placa).

Daño a salida del
microprocesador

Utilización de reglas de ruteo (clearence minimos)

Testeo de continuidad entre pistas luego de la soldadura. Establecer clearence mínimo de ruteo

Testeo de continuidad entre pistas luego de la soldadura. Establecer clearence mínimo de ruteo
Testeo de continuidad entre pistas luego de la soldadura. Establecer clearence mínimo de ruteo

Puerto en cortocircuito por error en el ruteo de las pistas

Daño a salida del
microprocesador | Uso de software con chequeo de
| conexiones

Puerto a circuito
abierto | Puerto a circuito abierto por
| error en el ruteo de las pistas

No se establece la
comunicación con los
actuadores

Uso de software con chequeo de conexiones

# Módulo de sensores

Función | Modo de Falla | Mecanismo y causa de falla | Efecto de la falla | Detecciones / Prevenciones | Ocurrencia | Severidad | RPN | Ocurrencia | Severidad | RPN | Reducción
4 | 6 | 5 | 120 | 2 | 6 | 2 | 24 | 80,00%

Posible daño al sensor

4 | 6 | 5 | 120 | 2 | 6 | 2 | 24 | 80,00%
2 | 6 | 2 | 24 | 2 | 6 | 2 | 24 | 0,00%
2 | 6 | 2 | 24 | 2 | 6 | 2 | 24 | 0,00%
3 | 6 | 3 | 54 | 3 | 6 | 3 | 54 | 0,00%
2 | 6 | 3 | 36 | 2 | 6 | 3 | 36 | 0,00%
3 | 6 | 2 | 36 | 3 | 6 | 2 | 36 | 0,00%
3 | 6 | 3 | 54 | 3 | 6 | 3 | 54 | 0,00%
2 | 6 | 3 | 36 | 2 | 6 | 3 | 36 | 0,00%
Inducción de pistas próximas | 3 | 3 | 4 | 36 | 3 | 3 | 4 | 36 | 0,00%
3 | 4 | 3 | 36 | 3 | 4 | 3 | 36 | 0,00%
3 | 3 | 3 | 27 | 3 | 3 | 3 | 27 | 0,00%
Pistas con esquinas abruptas | 3 | 2 | 2 | 12 | 3 | 2 | 2 | 12 | 0,00%
Pistas actuando de antenas | 3 | 4 | 5 | 60 | 3 | 4 | 5 | 60 | 0,00%
3 | 4 | 4 | 48 | 3 | 4 | 4 | 48 | 0,00%
2 | 6 | 3 | 36 | 2 | 6 | 3 | 36 | 0,00%
Detectabilidad | Acciones correctivas
recomendadas (RPN > 90) | Detectabilidad

1.Toma la
medición de
corriente y tensión

Salida en corto
circuito

Salida en cortocircuito con la alimentación por soldadura defectuosa (pistas muy
proximas en el ruteo de la placa)

Daño a entrada del
microprocesador

Utilización de reglas de ruteo (clearence minimos)
Aislación óptica y galvánica de sensore de tensió y corriente respectivamente

Aislación óptica y galvánica de sensore de tensió y corriente respectivamente

Salida en cortocircuito por error en el ruteo de las pistas

Lectura erronea del sensor. Uso de software con chequeo de conexiones
Posibilidad de dañar al
sensor
Footprint inadecuado para el componente

Lectura erronea del sensor. Chequeo con las hojas de datos del fabricante del componente. Posibilidad de dañar al
sensor

Salida a circuito
abierto

Salida a circuito abierto por error en el ruteo de las pistas

Lectura erronea del sensor. Uso de software con chequeo de conexiones

Footprint inadecuado para el componente

Lectura erronea del sensor. Chequeo con las hojas de datos del fabricante del componente. Posibilidad de dañar al
sensor

Señal ruidosa
(corrupción de datos)
Lectura erronea del sensor.

Uso de software con simulación de EMI (Interferencias
ElectroMagnéticas)

Error en el ruteo del plano de masa

Lectura erronea del sensor.

Uso de software con simulación de EMI (Interferencias
ElectroMagnéticas)

Mala distribución de
componentes en la placa Lectura erronea del sensor.

Uso de software con simulación de EMI (Interferencias
ElectroMagnéticas)
| Lectura erronea del sensor.

Uso de software con simulación de EMI (Interferencias
ElectroMagnéticas)
| Lectura erronea del sensor.

Uso de software con simulación de EMI (Interferencias
ElectroMagnéticas)

Pistas formando lazos de
corriente | Lectura erronea del sensor.

Uso de software con simulación de EMI (Interferencias
ElectroMagnéticas)

Disminuye la
exactitud más de lo
esperado con el
tiempo

Error en las especificaciones
del sensor | Lectura erronea del sensor.

Chequeo con las hojas de datos del fabricante del componente.

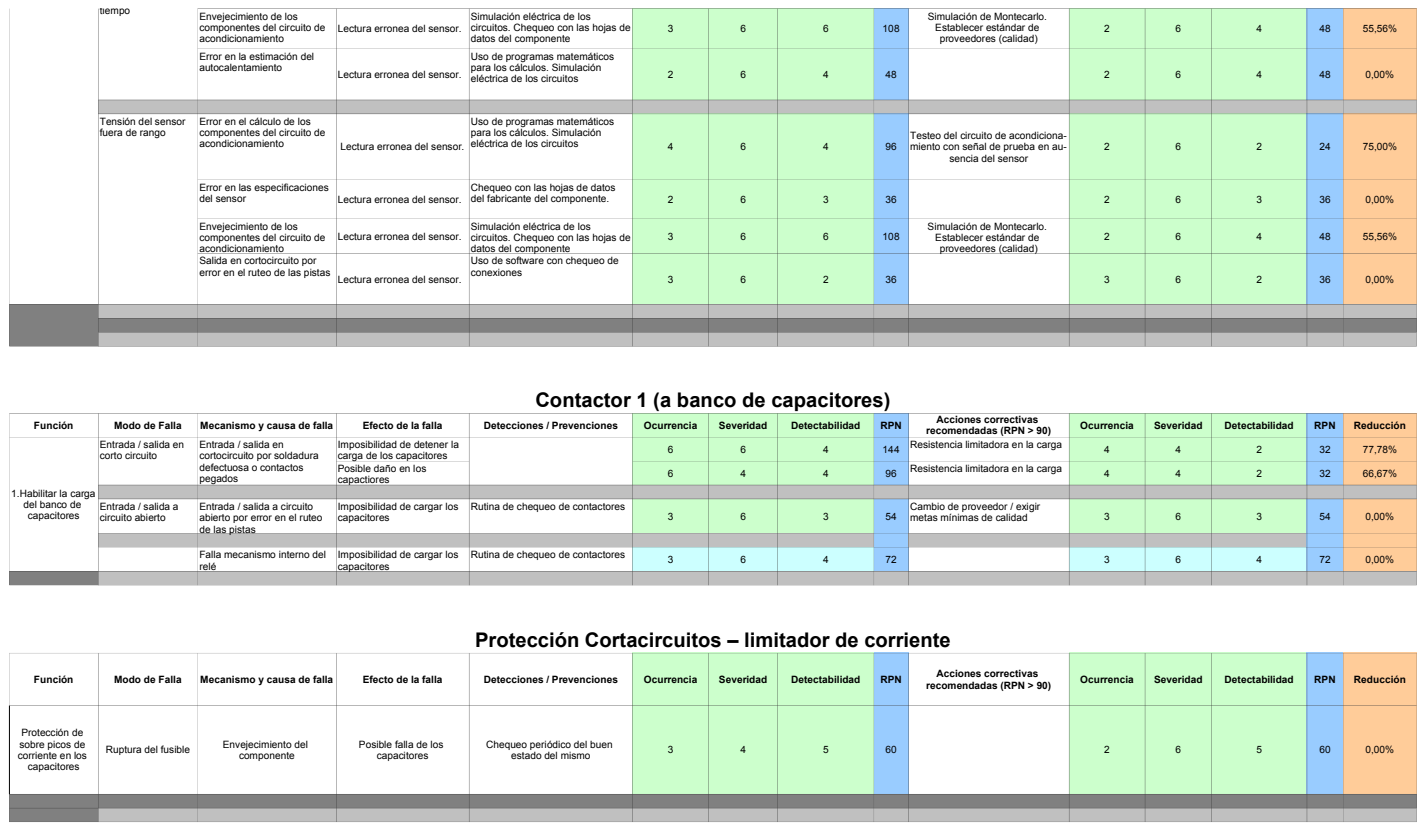
[picture p135: page 4]
Función; Modo de Falla; Mecanismo y causa de falla; Efecto de la falla; Detecciones / Prevenciones; Ocurrencia; Severidad; RPN; Reducción; Resistencia limitadora en la carga; Ruptura del fusible; tiempo; Envejecimiento de los; autocalentamiento; Lectura erronea del sensor.; acondicionamiento; del sensor; Detectabilidad; Acciones correctivas; recomendadas (RPN > 90); Entrada / salida a circuito abierto; Rutina de chequeo de contactores; Cambio de proveedor / exigir; Envejecimiento del componente

Simulación eléctrica de los
circuitos. Chequeo con las hojas de
datos del componente
Uso de programas matemáticos
para los cálculos. Simulación
eléctrica de los circuitos

Simulación de Montecarlo.
Establecer estándar de
proveedores (calidad)

componentes del circuito de
acondicionamiento
Error en la estimación del

Lectura erronea del sensor.

Tensión del sensor
fuera de rango

Error en el cálculo de los

Testeo del circuito de acondiciona-
miento con señal de prueba en au-

sencia del sensor

Error en las especificaciones

Chequeo con las hojas de datos
del fabricante del componente.

Envejecimiento de los
Salida en cortocircuito por
error en el ruteo de las pistas Lectura erronea del sensor.

Uso de software con chequeo de
conexiones

Contactor 1 (a banco de capacitores)

Entrada / salida en
corto circuito

cortocircuito por soldadura
defectuosa o contactos
pegados

Imposibilidad de detener la
carga de los capacitores
Posible daño en los
capactiores

1.Habilitar la carga
del banco de
capacitores

Entrada / salida a circuito
abierto por error en el ruteo
de las pistas

Imposibilidad de cargar los

metas mínimas de calidad

Falla mecanismo interno del
relé

Rutina de chequeo de contactores

Protección Cortacircuitos – limitador de corriente

Protección de
sobre picos de
corriente en los

Posible falla de los

Chequeo periódico del buen
estado del mismo

# Contactor 3 (a banco de resistencias)

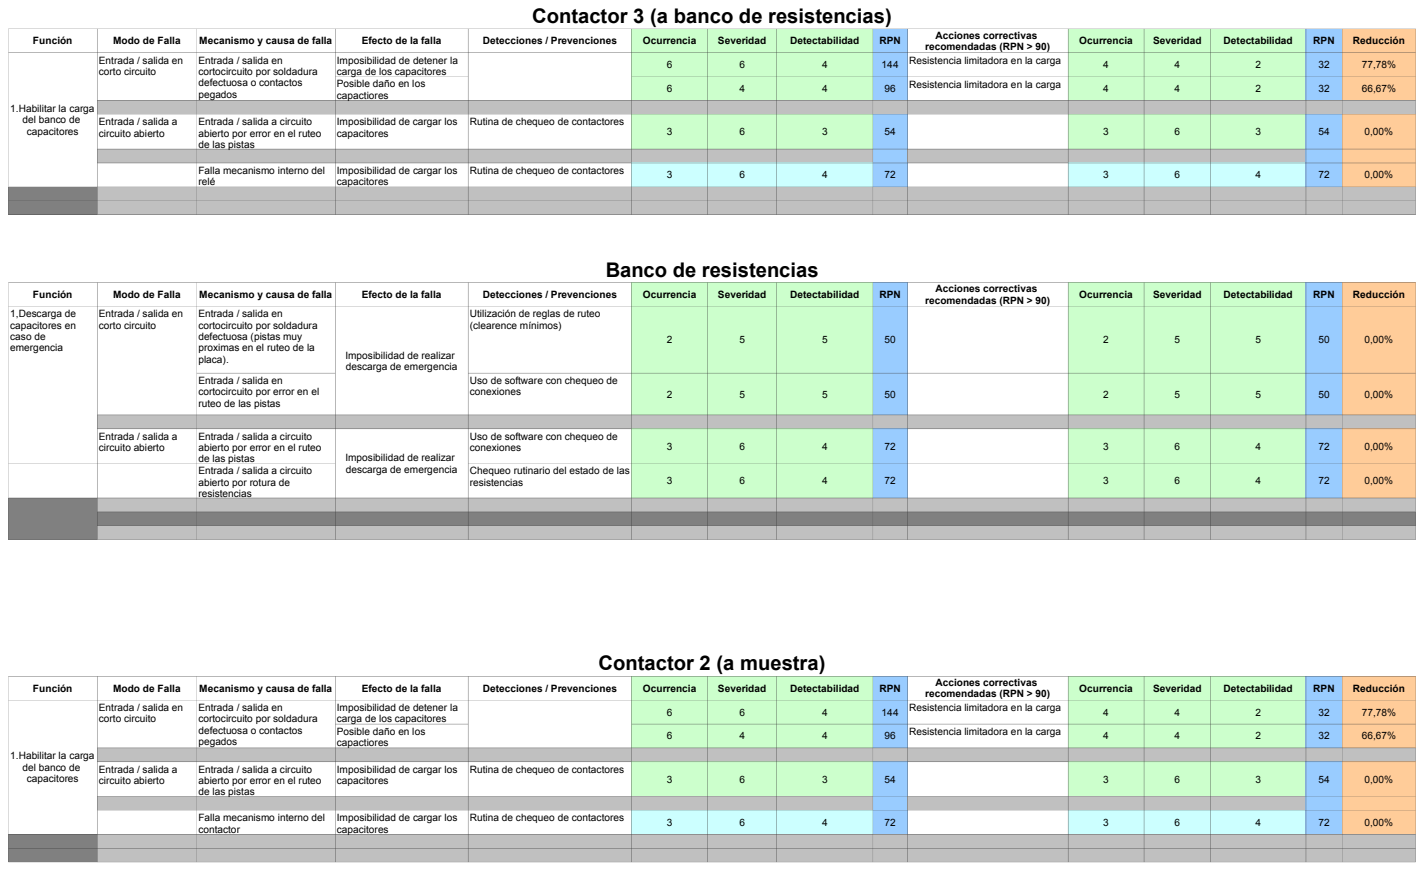
[picture p136: page 5]
Función; Modo de Falla; Mecanismo y causa de falla; Efecto de la falla; Detecciones / Prevenciones; Ocurrencia; Severidad; RPN; Reducción; Resistencia limitadora en la carga; Detectabilidad; Acciones correctivas; recomendadas (RPN > 90); Entrada / salida a circuito abierto; 1,Descarga de capacitores en caso de emergencia; placa).; Imposibilidad de realizar; de las pistas; Contactor 2 (a muestra)

Entrada / salida en
corto circuito

cortocircuito por soldadura
defectuosa o contactos
pegados

Imposibilidad de detener la
carga de los capacitores
Posible daño en los
capactiores

1.Habilitar la carga
del banco de
capacitores

Entrada / salida a circuito
abierto por error en el ruteo
de las pistas

Imposibilidad de cargar los

Rutina de chequeo de contactores

Falla mecanismo interno del
relé

Banco de resistencias

defectuosa (pistas muy
proximas en el ruteo de la

Utilización de reglas de ruteo
(clearence mínimos)

descarga de emergencia

cortocircuito por error en el
ruteo de las pistas

Uso de software con chequeo de
conexiones

abierto por rotura de
resistencias

Chequeo rutinario del estado de las

contactor

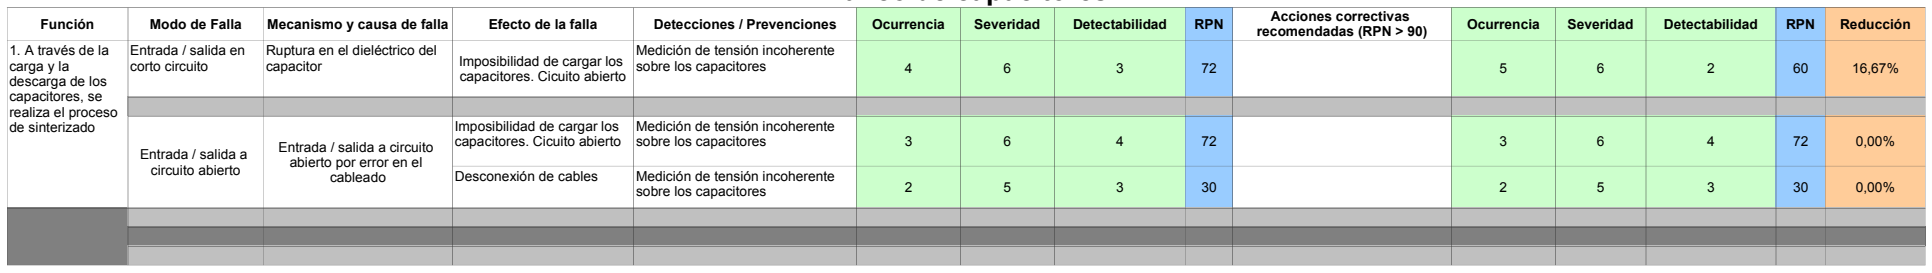
[picture p137: figure]
Función; Modo de Falla; Mecanismo y causa de falla; Efecto de la falla; Detecciones / Prevenciones; Ocurrencia; Severidad; RPN; Reducción; Desconexión de cables; Detectabilidad; Acciones correctivas; recomendadas (RPN > 90); 1. A través de la carga y la descarga de los capacitores, se realiza el proceso de sinterizado; Entrada / salida en corto circuito; Ruptura en el dieléctrico del; capacitor; Imposibilidad de cargar los; capacitores. Cicuito abierto; Medición de tensión incoherente sobre los capacitores; Entrada / salida a circuito abierto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

# Muestra

Función | Modo de Falla | Mecanismo y causa de falla | Efecto de la falla | Detecciones / Prevenciones | Ocurrencia | Severidad | RPN | Ocurrencia | Severidad | RPN | Reducción
5 | 6 | 2 | 60 | 5 | 6 | 2 | 60 | 0,00%

# Banco de capacitores

Detectabilidad | Acciones correctivas
recomendadas (RPN > 90) | Detectabilidad

1,Objeto a
sinterizar | Entrada / salida a
circuito abierto

Falso contacto de la muestra
con los cables de descarga No se realiza el sinterizado

Medición de corriente sobre la muestra
