Stachovsky/TrabajoProfesional/Informes/FMEA/FMEA.ods

Módulo fuente alimentación
Función | Modo de Falla | Mecanismo y causa de falla | Efecto de la falla | Detecciones / Prevenciones | Ocurrencia | Severidad | Detectabilidad | RPN | Acciones correctivas recomendadas (RPN > 90) | Ocurrencia | Severidad | Detectabilidad | RPN | Reducción
1. Provee de tensión y corriente continua a los capacitores | Corte en el suministro de tensión | Falla en la alimentación de linea | No se produce la carga de los capacitores | En caso de apargarse la luz, los capacitores pueden haber quedado cargados. | 4 | 7 | 7 | 196 | En caso de apagarse la luz de tensión y el sensado de la misma, los capacitores se descargarán hace el banco de resistencias | 3 | 3 | 5 | 45 | 77,04%
 |  | Falla en el balastro | No se produce la carga de los capacitores | Capacitores no se cargarán, el sensado de la tensión de entrada Estará en 0 V | 3 | 6 | 5 | 90 | Los capacitores no se cargarán. Para detectar mediante software/hardware que esto ha sucedido, se medirá la tensión de la salida de la fuente y existirá un timeout con este fin. | 2 | 2 | 5 | 20 | 77,78%
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
