Stachovsky/TrabajoProfesional/Documentacion/DocumentacionProyectoAnterior/Micro_Hardware/Circuito Esquematico Rev 0.1-03.pdf

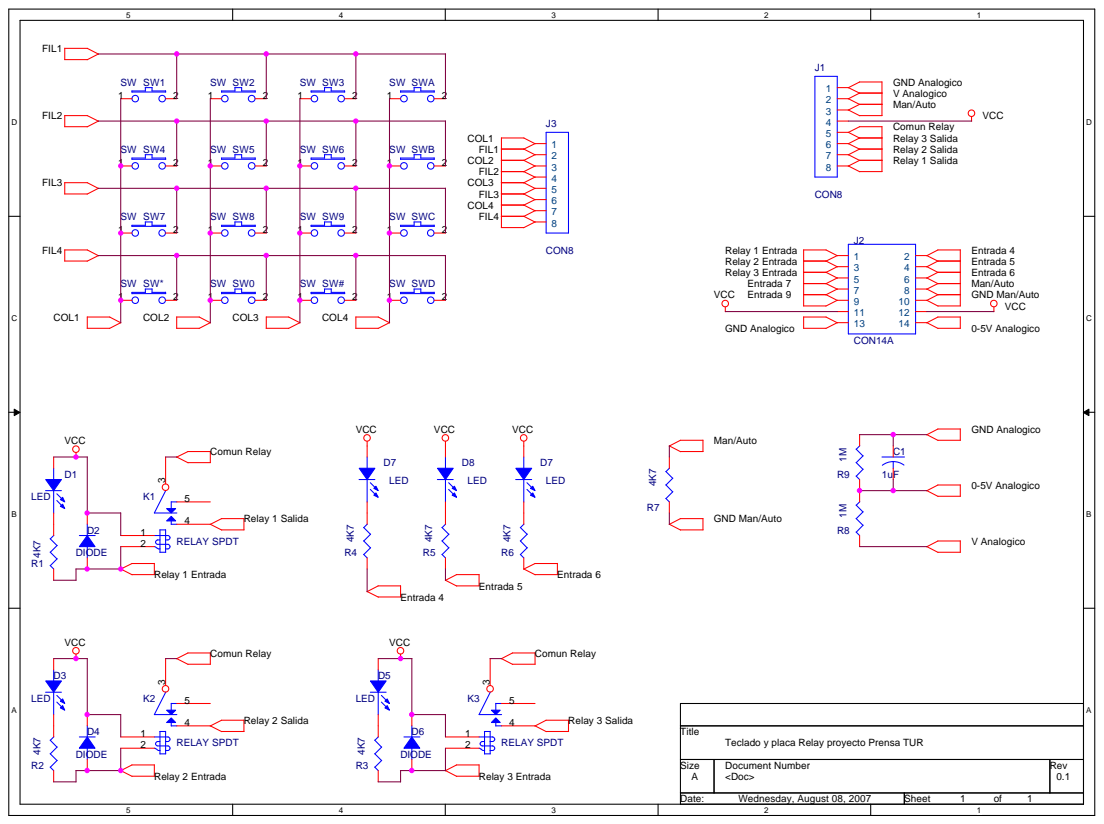
[picture p138: page 1]

Teclado y placa Relay proyecto Prensa TUR

Size A | Document Number <Doc> | Rev 0.1

Date: Wednesday, August 08, 2007 | Sheet 1 of 1
