Stachovsky/TrabajoProfesional/Pcbs/DisplayGraficoConectorUSB/DisplayGraficoConectorUSB.pdf

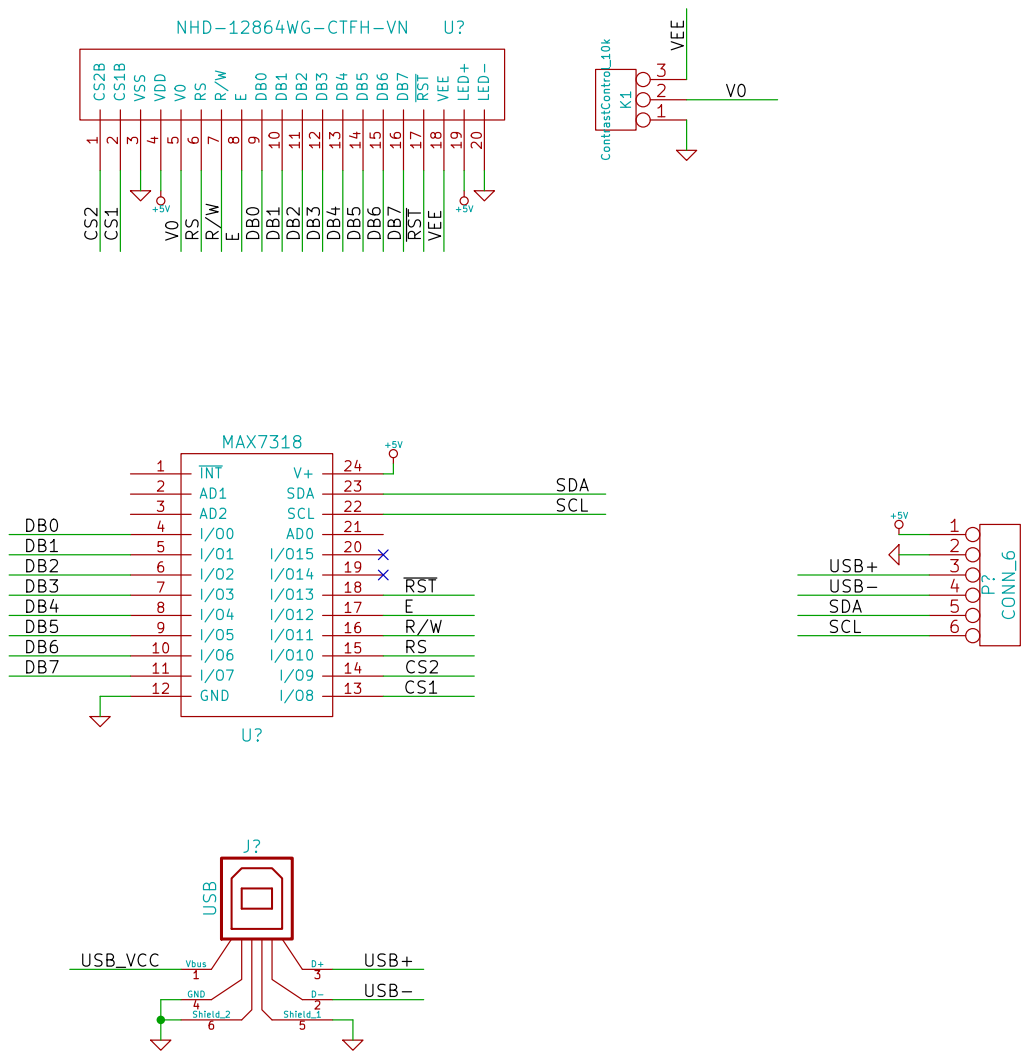
[picture p139: page 1]

9 DB1 10 LED- 20 DB2 11 DB3 12 DB4 13 DB5 14 DB6 15 DB7 16 RST 17 VEE 18 LED+ 19

File: DisplayGraficoConectorUSB.sch
Sheet: /
Title: Controlador Display Grafico. Conector Usb.
