Stachovsky/TrabajoProfesional/Pcbs/Motherboard/Motherboard.pdf

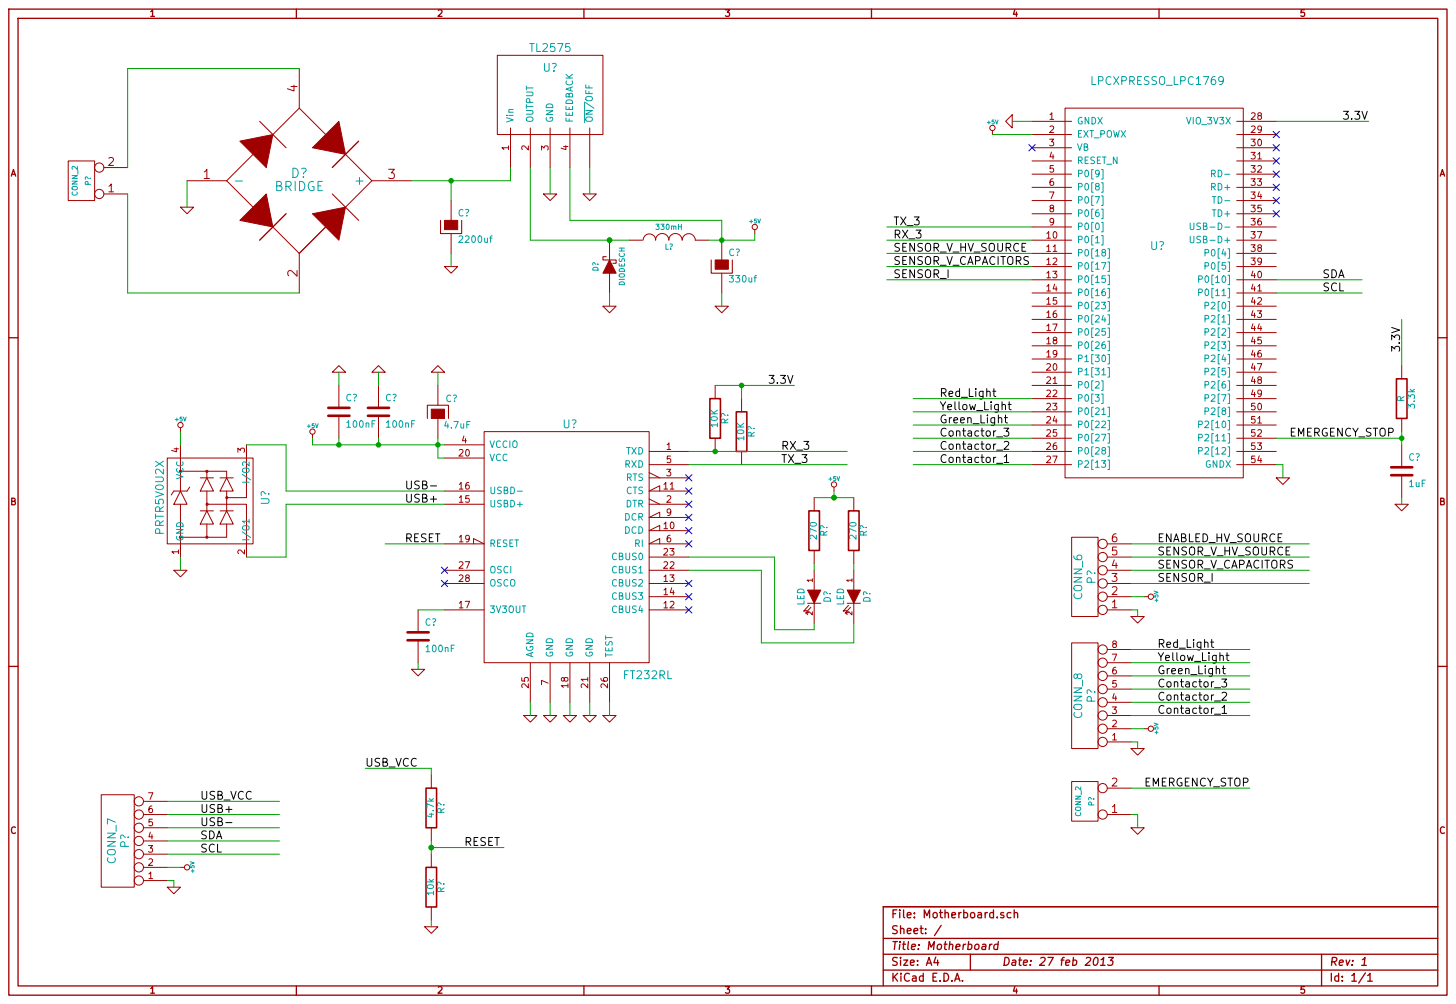
[picture p140: page 1]

7 DCR 9 DCD 10 VCC 20 CTS 11 GND 21 CBUS4 12 CBUS1 22 CBUS2 13 CBUS0 23 CBUS3 14 USBD+ 15 AGND 25 USBD- 16 TEST 26

Id: 1/1 Title: Motherboard File: Motherboard.sch Sheet: /
