Stachovsky/TrabajoProfesional/Pcbs/PcbsDefinitivos/AcopladorAccionadoresPotencia/AcopladorAccionadoresPotencia.pdf

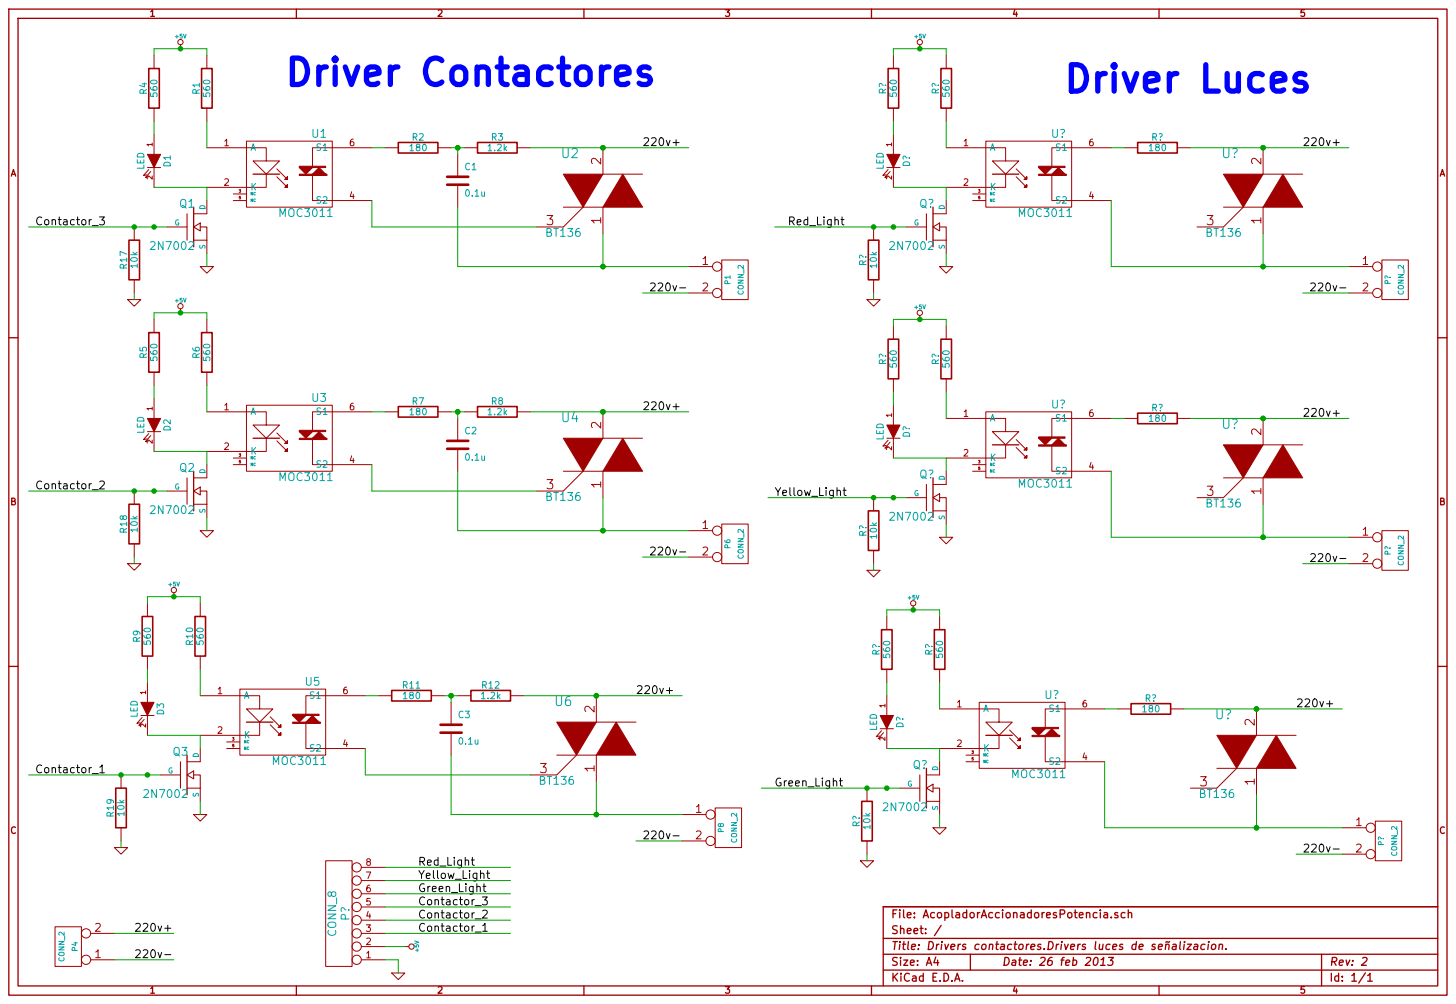
[picture p141: page 1]

Id: 1/1 Title: Drivers contactores.Drivers luces de señalizacion. File: AcopladorAccionadoresPotencia.sch
Sheet: /
