Stachovsky/TrabajoProfesional/Pcbs/PcbsDefinitivos/FuenteAltaTensionSensoresTension/FuenteAltaTensionSensoresTension.pdf

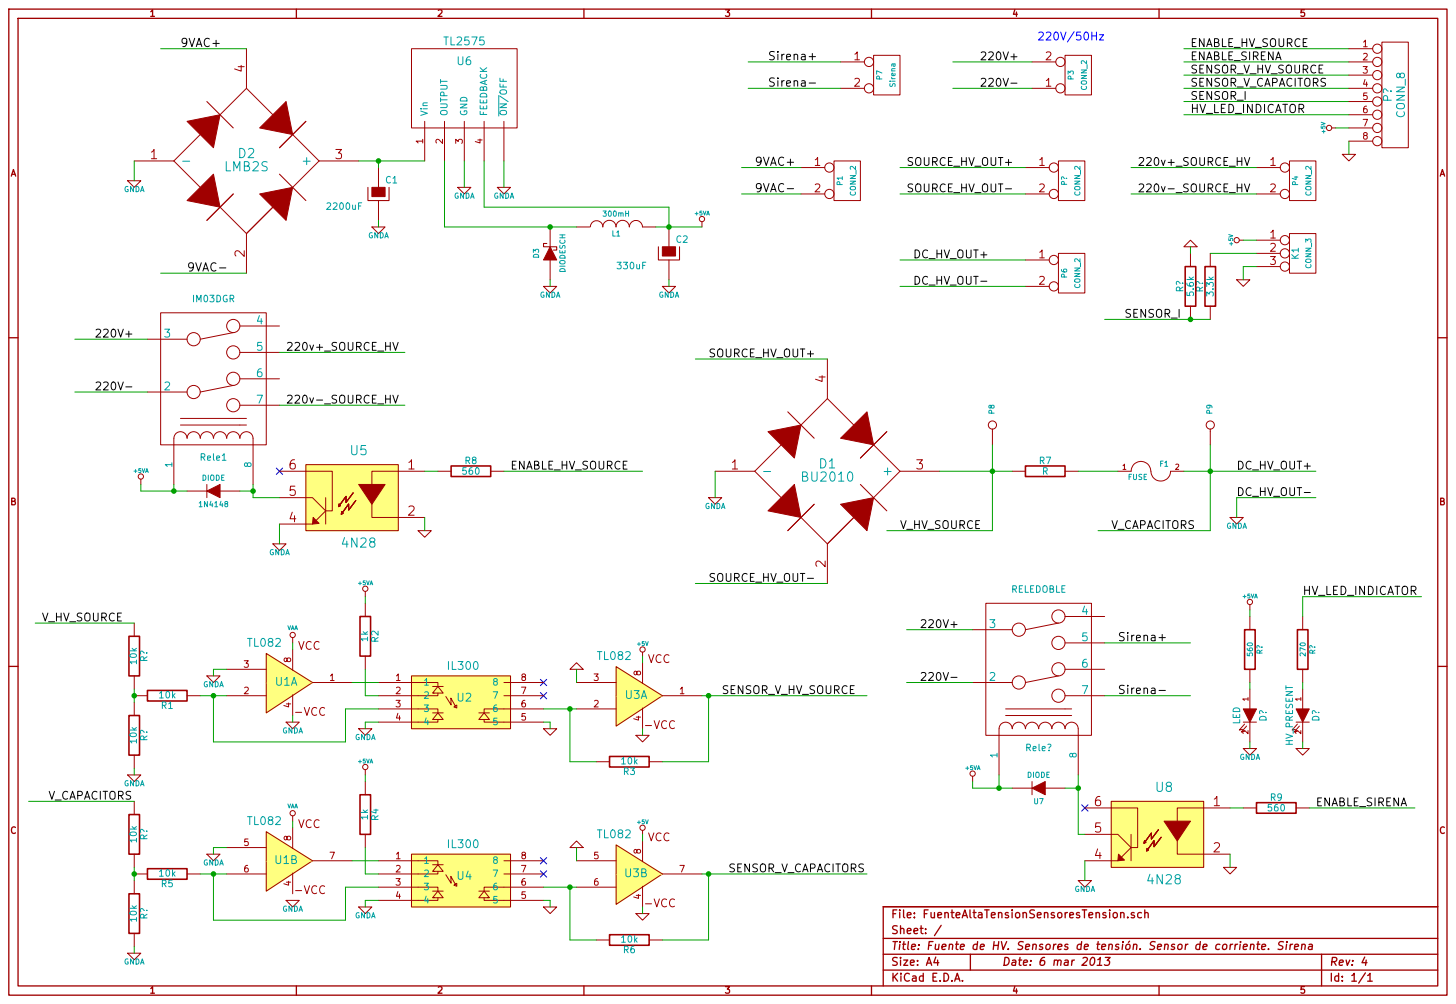
[picture p142: page 1]

File: FuenteAltaTensionSensoresTension.sch
Sheet: /
Title: Fuente de HV. Sensores de tensión. Sensor de corriente. Sirena
