Stachovsky/TrabajoProfesional/Documentacion/DocumentacionProyectoAnterior/Micro_Hardware/Circuito Esquematico Rev 0.1-02.pdf

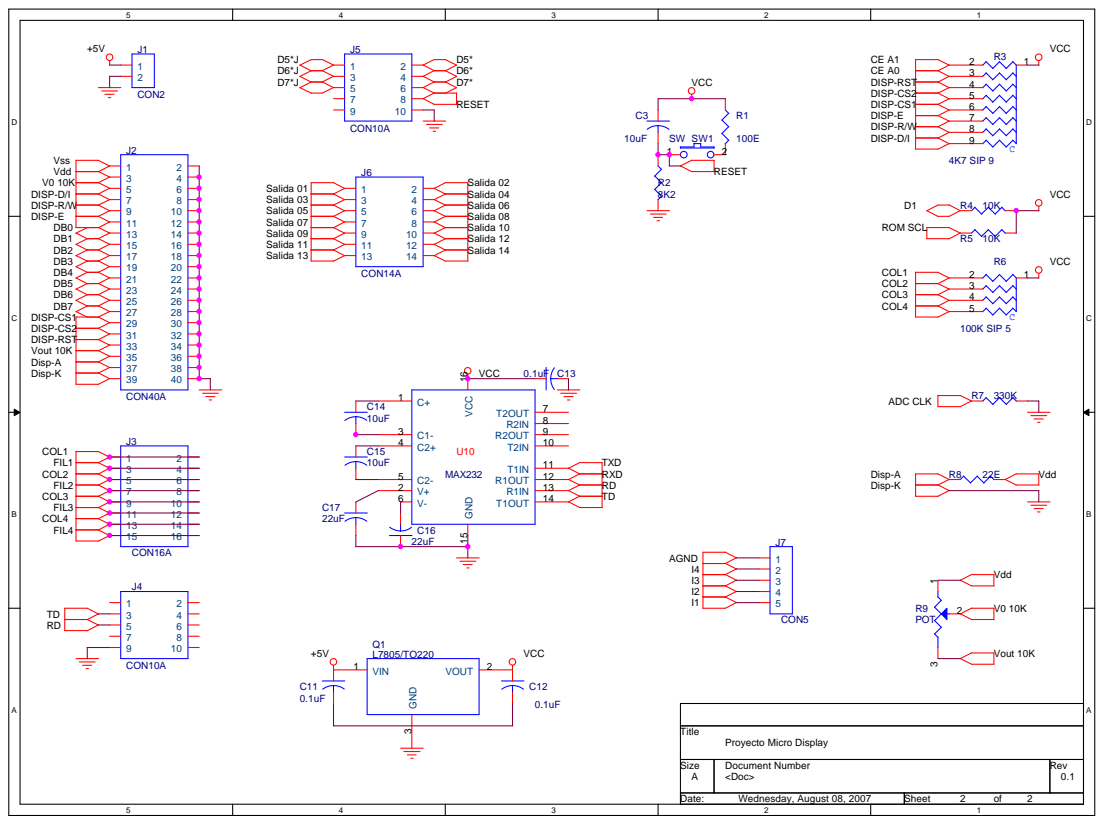
[picture p143: page 1]

Siz e A | Document Number <Doc> | Rev 0.1

Date: Wednesday, August 08, 2007 | Sheet 2 of 2
