Stachovsky/TrabajoProfesional/Gabinete/001_CARRO PARA CAPACITORES.pdf

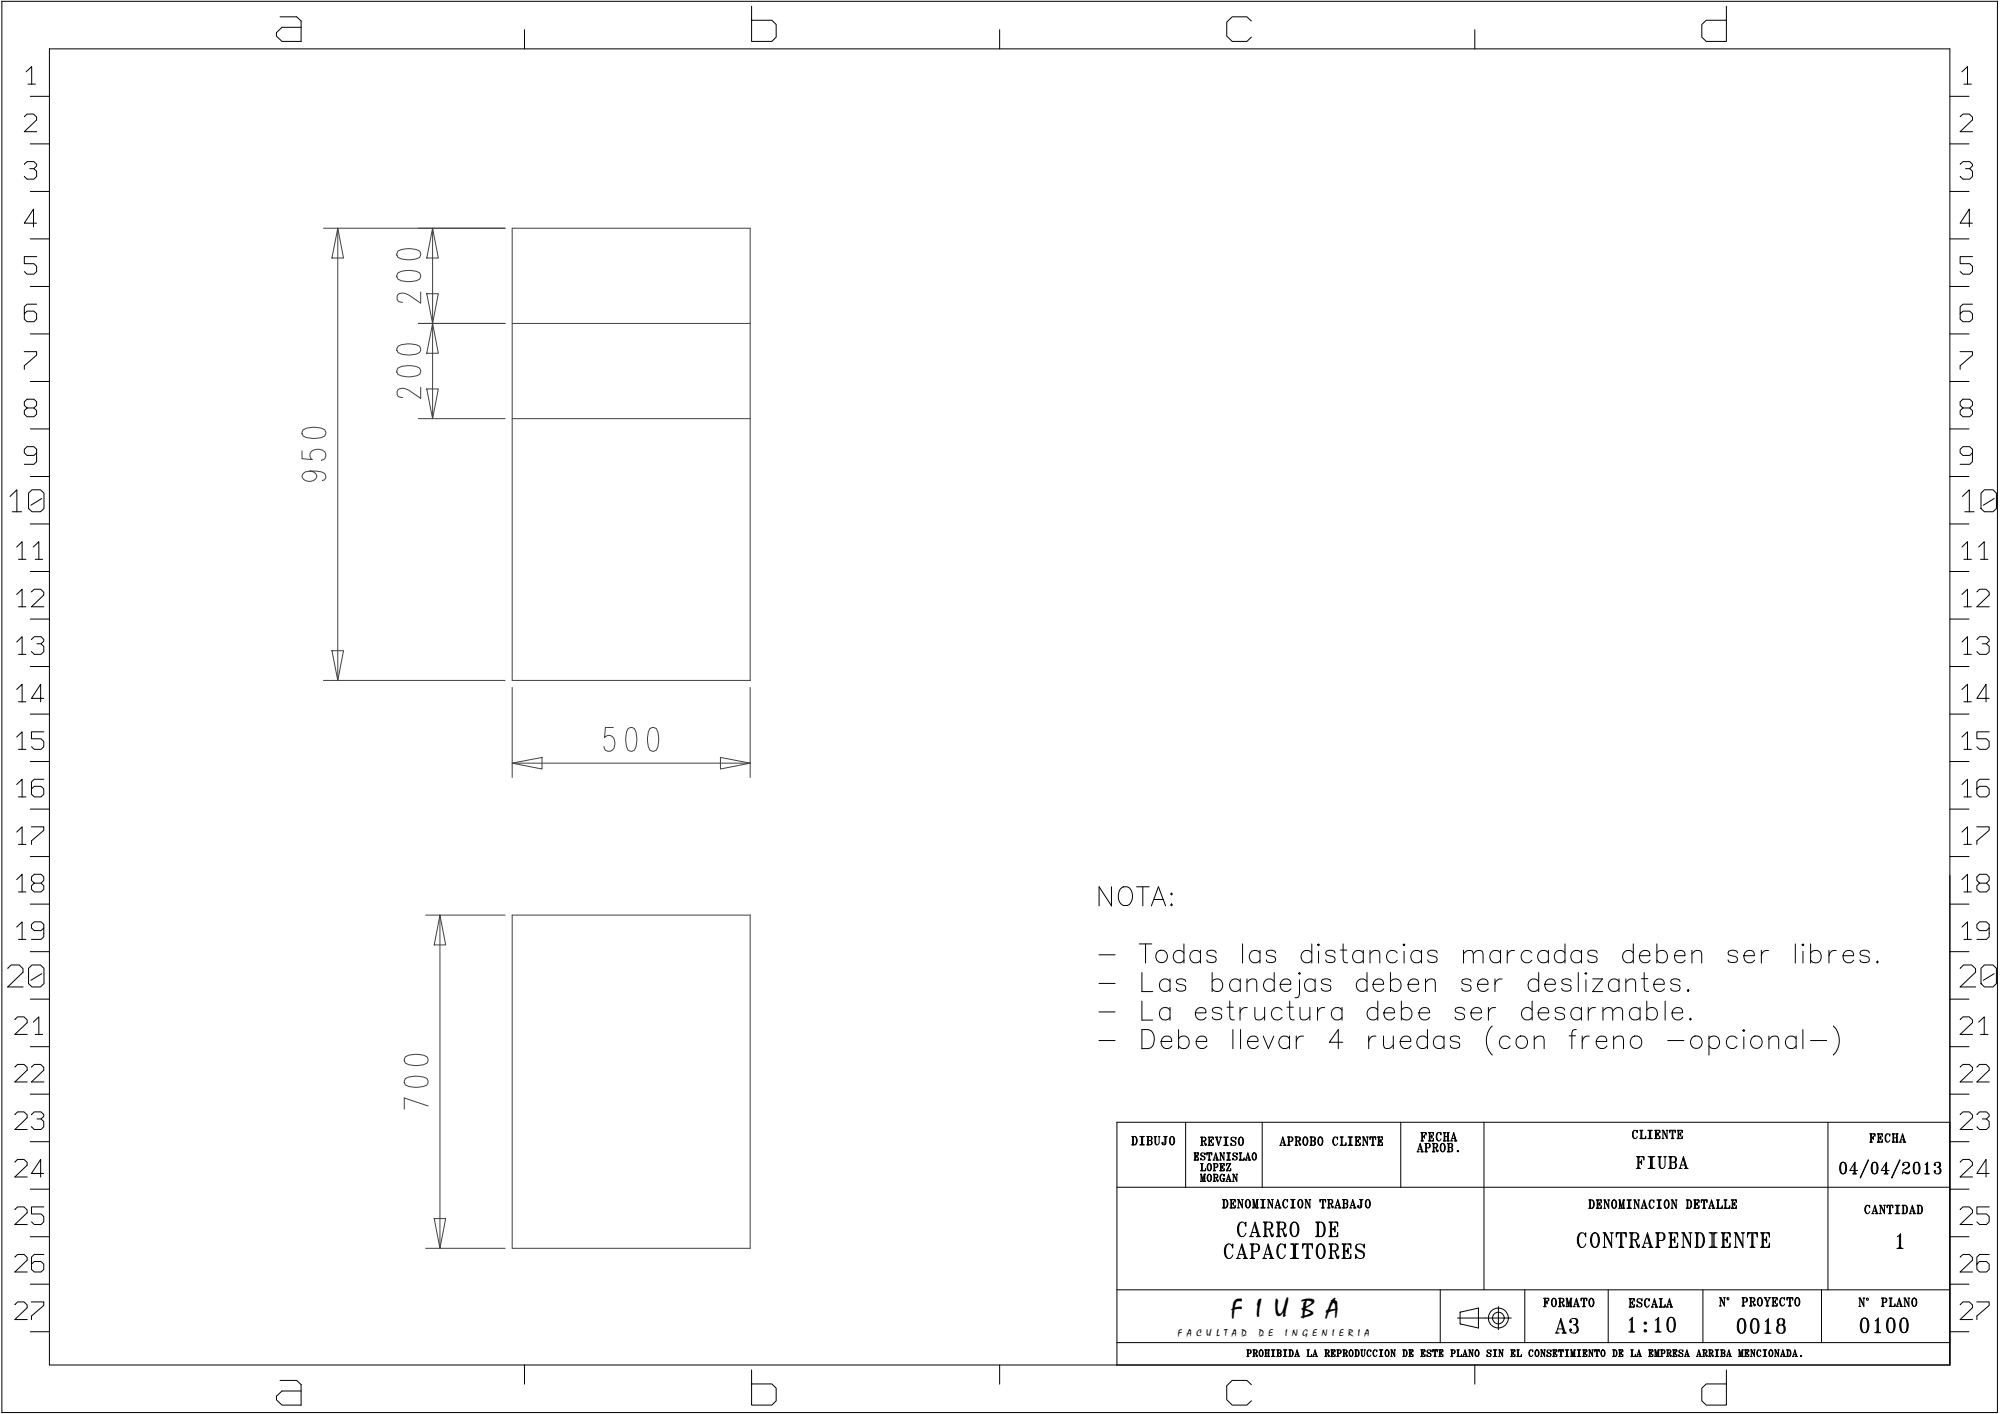
[picture p144: page 1]
