Stachovsky/TrabajoProfesional/Gabinete/carro Faculta de ing uba-Model.pdf

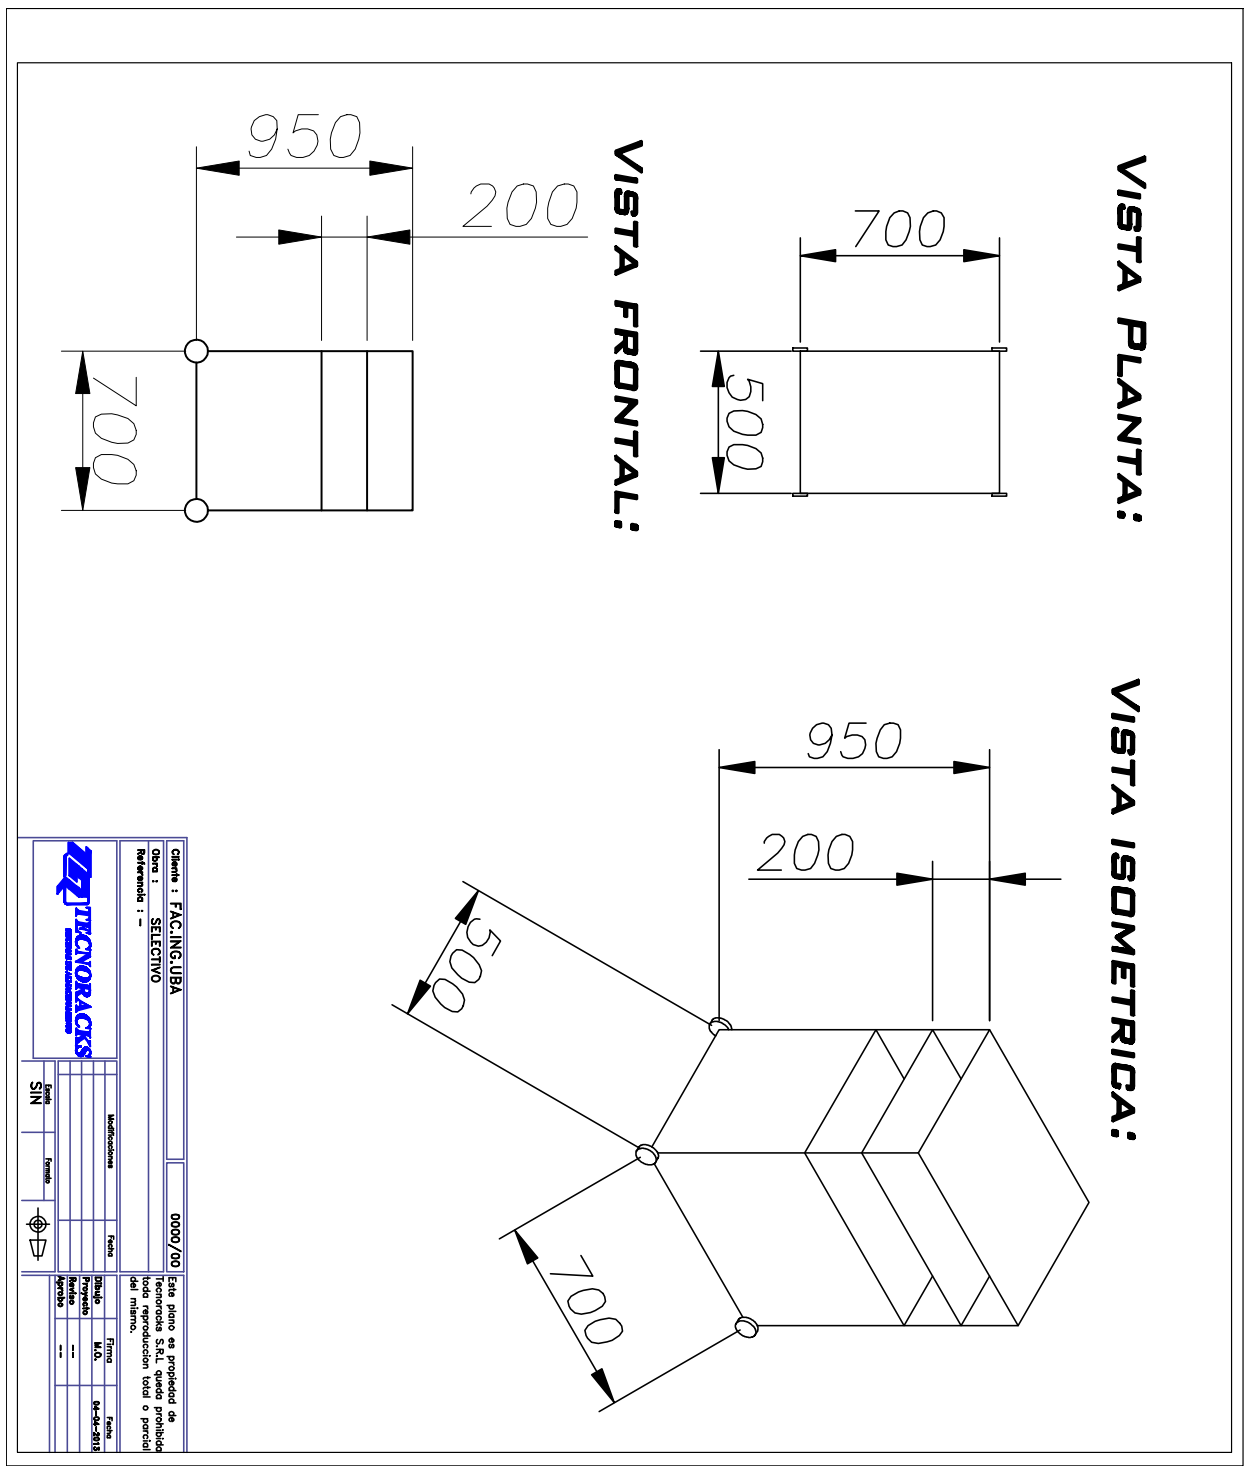
[picture p145: page 1]
