Stachovsky/TrabajoProfesional/Documentacion/Diagramas/Capacitores.pdf

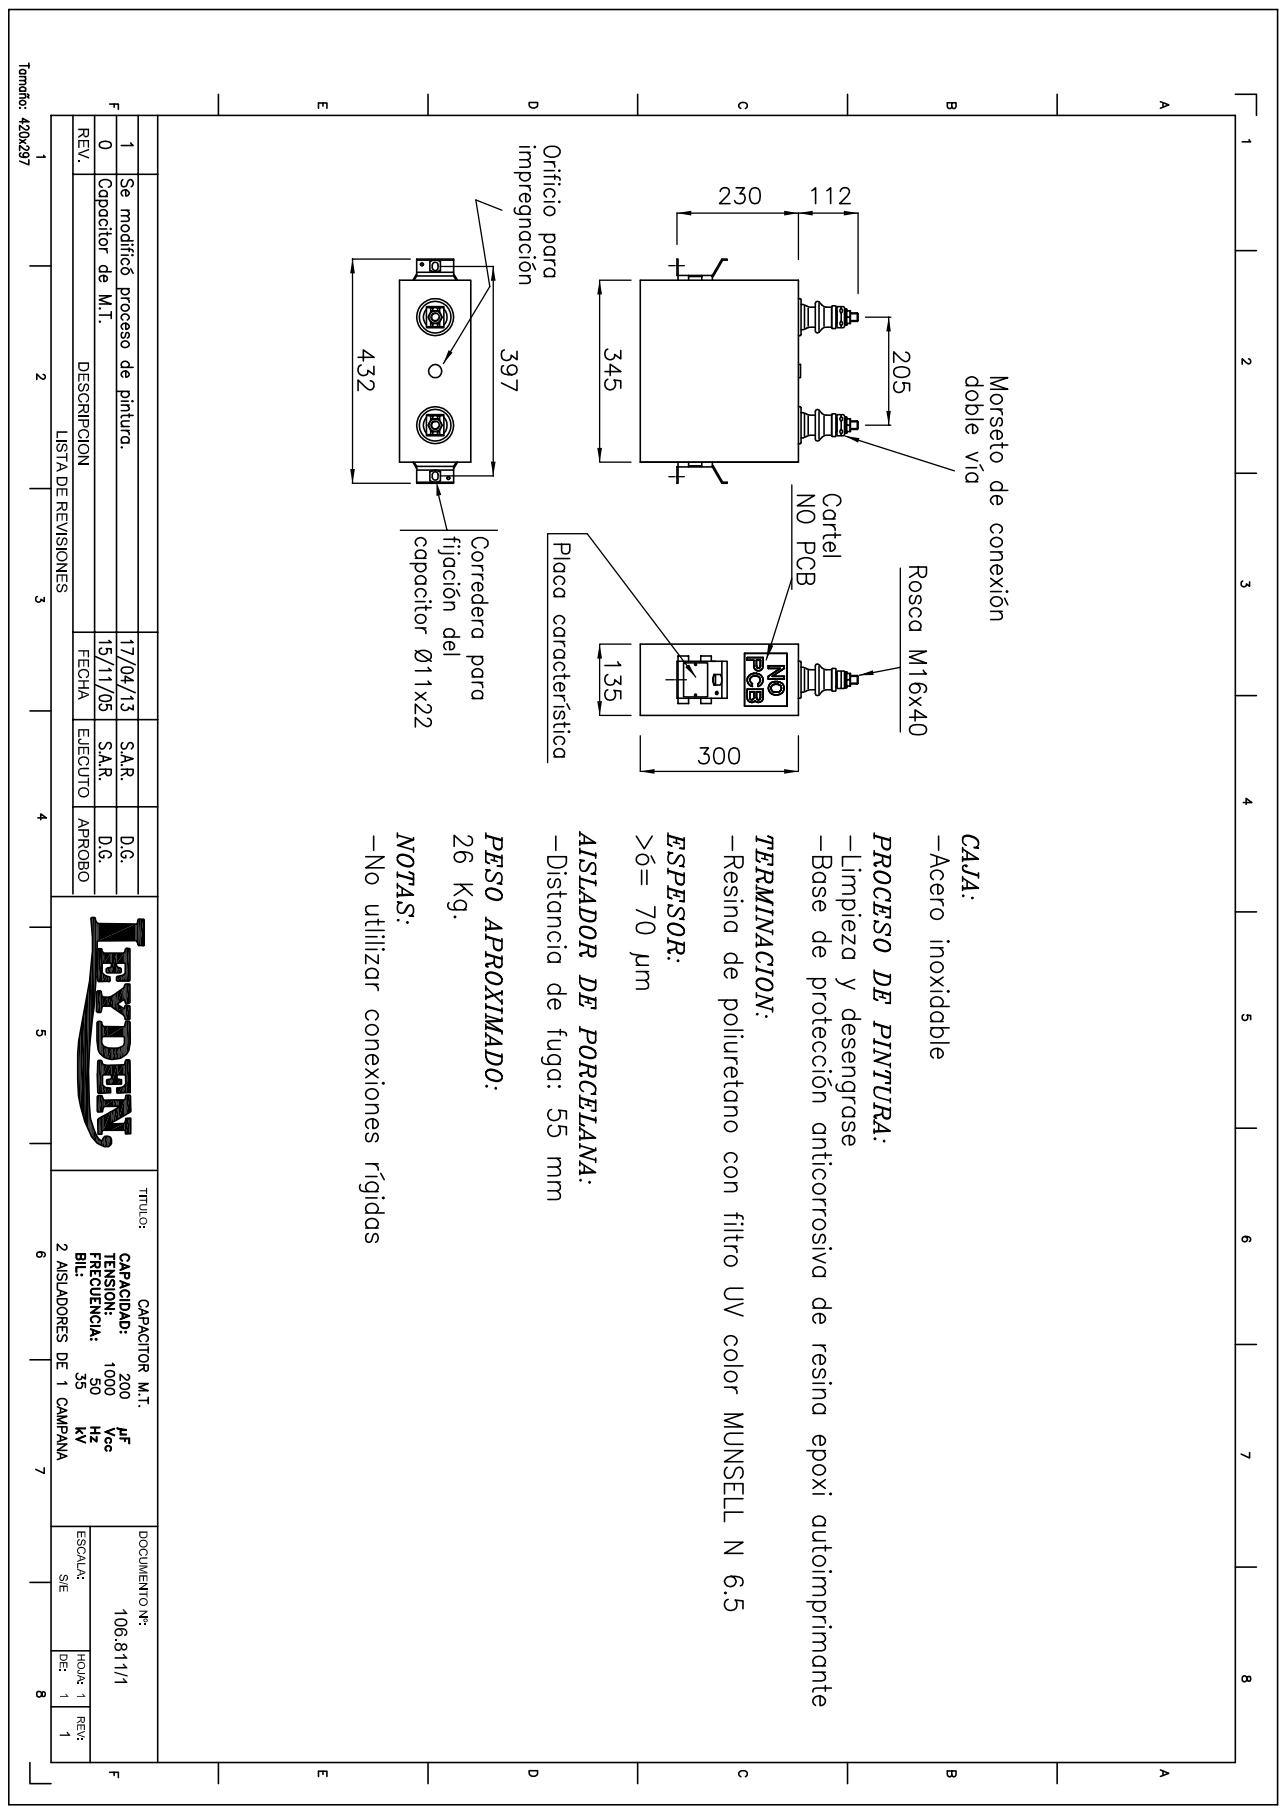
[picture p146: page 1]
