Stachovsky/TrabajoProfesional/Simulaciones/descargaCapacitor.asc

C2: cap; 440µ
R1: res; 1k
R2: res; 1
S1: sw; SW1
S2: sw; SW2
V1: battery; 1000
V2: voltage; PULSE(0 1 0 1m 1m 1 2 1)
V3: voltage; PULSE(0 1 1.5 1m 1m 1 1 1)
Named nets: 0, VC
.model SW1 SW(Ron=1m Roff=1Meg Vt=0.5)
.model SW2 SW(Ron=1m Roff=1Meg Vt=0.5)
.tran 0 1.5025 1.5003 1u startup
