Stachovsky/TrabajoProfesional/Simulaciones/SensadoTensión.asc

C1: cap; 250µF; V=1000V
C2: cap; 250µF; V=1000V
R1: res; 10Meg
R2: res; 50K; tol=1 pwr=0.1
U1: 4N25
V2: cell; 3.3
V3: signal; PWL(5u 1000 5u 0 5u 1000 5u 0)
Named nets: 0, Salida, OptoEntrada
.tran 0 20s 5us 0.01
