Stachovsky/TrabajoProfesional/Simulaciones/simulacionAntiRebote.asc

A1: and; Vhigh=3.3
C1: cap; 1µ
R1: res; 3.3k
S1: sw; SW1
V1: battery; 3.3
V2: voltage; PULSE(0 3.3 1 0 0 0.1)
V3: voltage; PULSE(0 3.3 0 0 0 0.001 0.002)
Named nets: 0, Out, In
.tran 0 1.4 0.8 100
.model SW1 SW(Ron=1m Roff=1Meg Vt=0.5)
