Stachovsky/TrabajoProfesional/Simulaciones/Sinterizado.asc

B1: bv
C1: cap
C2: cap
R1: res
Named nets: 0
