Stachovsky/TrabajoProfesional/Pcbs/PcbsDefinitivos/Motherboard/MotherboardV2/MotherboardV2.kicad_pcb

## KiCad design Pcbs/PcbsDefinitivos/Motherboard/MotherboardV2/MotherboardV2.kicad_pcb (2013-06-25)

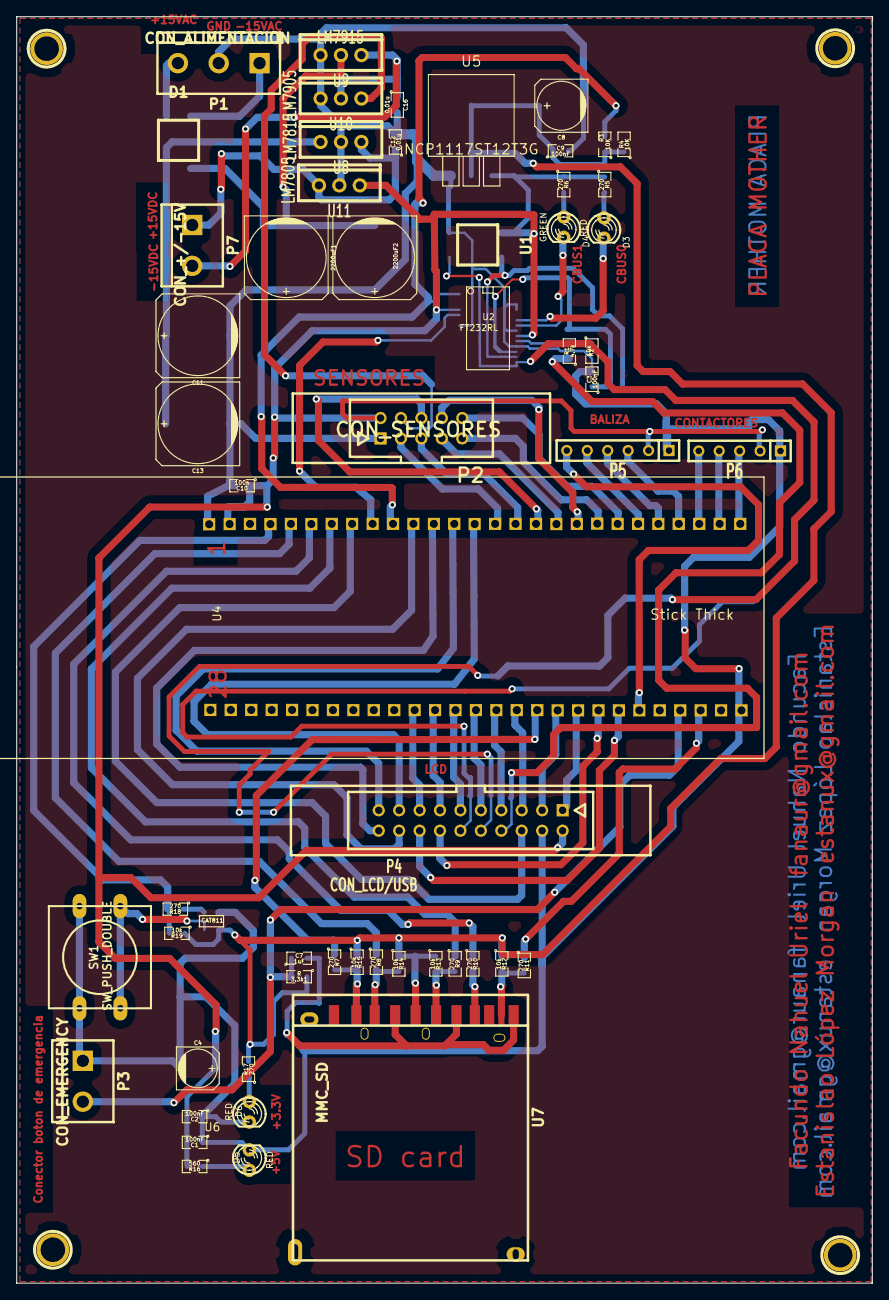
[picture p147: board MotherboardV2.kicad_pcb from above]

Board: 2 copper layers, 106.4 x 157.5 mm, 58 parts (0 on the bottom side), 66 nets.

Parts:
3.3k1: R; SM0805
2200uF1: C14; c_elec_10x10.5
2200uF2: C15; c_elec_10x10.5
C1, C2, C3, C9: 100nF; SM0805
C4: 4.7uF; c_elec_5x4.5
C7: 1uF; SM0805
C8: 22uF; c_elec_6.3x4.5
C10: 100n; SM0805
C11, C13: 2200uF; c_elec_10x10
C12, C16: 0.01u; SM0805
CAT811: VAL**; CAT811
CON_LCD/USB: P4; HE10_20D
CON_SENSORES: P2; he10-10d
D1: BRIDGE; bridge_1A
D3, D5, D6: RED; LED-3MM
D4: GREEN; LED-3MM
P1: CON_ALIMENTACION; bornier3
P3: CON_EMERGENCY; bornier2
P5: CON_BALIZA; SIL-6
P6: CON_CONTACTORES; SIL-5
P7: CON_+/-15V; bornier2
R1: 4.7k; SM0805
R2, R12, R13, R14, R15, R19: 10k; SM0805
R3, R4: 10K; SM0805
R5, R6, R7, R8, R9, R10, R11, R17, R18: 270; SM0805
R16: 560; SM0805
SW1: SW_PUSH_DOUBLE; SW_PUSH-12mm
U1: PRTR5V0U2X; LMB2S
U2: FT232RL; SSOP28
U4: LPCXPRESSO_LPC1769; LPCXpresso1769Thick
U5: NCP1117ST12T3G; DPAK3
U6: CAT811
U7: MMC_SD; SDCARD-REVERSE
U8: LM7815; TO220_VERT
U9: LM7915; TO220_VERT
U10: LM7905; TO220_VERT
U11: LM7805; TO220_VERT

Connections:
+5V: C1.2, C2.2, C4.1, C10.1, CON_LCD/USB.2, CON_SENSORES.2, P5.2, P6.2, R5.1, R6.1, R16.2, U1.4, U2.4, U2.20, U4.2, U5.3, U11.3
-5V: CON_SENSORES.4, U10.3
/3.3V: 3.3k1.1, C8.1, C9.1, CAT811.4, R3.1, R4.1, R12.1, R13.1, R14.1, R15.1, R17.2, R19.1, U5.2, U7.4
/15VAC+: D1.4, P1.3
/15VAC-: D1.2, P1.1
/15VDC+: C11.1, C13.1, D1.3, U8.1
/15VDC-: 2200uF1.2, 2200uF2.2, D1.1, U9.2
/+15V: C12.1, P7.1, U8.3, U11.1
/-15V: C16.1, P7.2, U9.3, U10.2
/BTN_RESET: CAT811.3, SW1.1, SW1.2
/CARD_DETECT: R11.1, U4.52
/CS1: CON_LCD/USB.18, U4.11
/CS2: CON_LCD/USB.20, U4.12
/Contactor_1: P6.3, U4.27
/Contactor_2: P6.4, U4.26
/Contactor_3: P6.5, U4.25
/DB0: CON_LCD/USB.15, U4.38
/DB1: CON_LCD/USB.13, U4.39
/DB2: CON_LCD/USB.11, U4.40
/DB3: CON_LCD/USB.9, U4.41
/DB4: CON_LCD/USB.7, U4.42
/DB5: CON_LCD/USB.5, U4.43
/DB6: CON_LCD/USB.3, U4.45
/DB7: CON_LCD/USB.1, U4.46
/E: CON_LCD/USB.14, U4.47
/EMERGENCY_STOP: 3.3k1.2, C7.1, P3.2, U4.51
/ENABLE_BALIZA: CON_SENSORES.10, U4.21
/ENABLE_HV_SOURCE: CON_SENSORES.9, U4.20
/Green_Light: P5.3, U4.24
/MISO: R10.1, U4.6
/MOSI: R8.1, U4.5
/R/W: CON_LCD/USB.16, U4.48
/RESET_MICRO: CAT811.2, R18.1
/RESET_USB_UART: R1.2, R2.1, U2.19
/RS: CON_LCD/USB.19, U4.13
/RX_3: R3.2, U2.1, U4.10
/Red_Light: P5.5, U4.22
/SCK: R9.1, U4.7
/SENSOR_AUX_0: CON_SENSORES.7, U4.18
/SENSOR_AUX_1: CON_SENSORES.8, U4.19
/SENSOR_I: CON_SENSORES.6, U4.17
/SENSOR_V_CAPACITORS: CON_SENSORES.5, U4.16
/SENSOR_V_HV_SOURCE: CON_SENSORES.3, U4.15
/SIRENA: P5.6, U4.49
/SSEL: R7.1, U4.44
/STATUS_LED: CON_LCD/USB.6, U4.8
/TX_3: U2.5, U4.9
/USB+: CON_LCD/USB.10, U1.2, U2.15
/USB-: CON_LCD/USB.12, U1.3, U2.16
/USB_VCC: CON_LCD/USB.8, R1.1
/Yellow_Light: P5.4, U4.23
/~RST: CON_LCD/USB.17, U4.14
GND: 2200uF1.1, 2200uF2.1, C1.1, C2.1, C3.2, C4.2, C7.2, C8.2, C9.2, C10.2, C11.2, C12.2, C13.2, C16.2, CAT811.1, CON_LCD/USB.4, CON_SENSORES.1, D5.2, D6.2, P1.2, P3.1, P5.1, P6.1, R2.2, U1.1, U2.7, U2.18, U2.21, U2.25, U2.26, U4.1, U4.54, U5.1, U7.3, U7.6, U7.11, U8.2, U9.1, U10.1, U11.2
unnamed: R8.2, R14.2, U7.2
unnamed: R9.2, R13.2, U7.5
unnamed: R10.2, U7.7
unnamed: R11.2, R12.2, U7.10
unnamed: R7.2, R15.2, U7.1
unnamed: R18.2, R19.2, U4.4
unnamed: D5.1, R16.1
unnamed: D6.1, R17.1
unnamed: D4.1, R6.2
unnamed: C3.1, U2.17
unnamed: D3.1, R5.2
unnamed: D3.2, U2.23
unnamed: D4.2, U2.22
