Stachovsky/TrabajoProfesional/Pcbs/PcbsDefinitivos/FuenteAltaTensionSensoresTension/FuenteAltaTensionSensoresTension.kicad_pcb

## KiCad design Pcbs/PcbsDefinitivos/FuenteAltaTensionSensoresTension/FuenteAltaTensionSensoresTension.kicad_pcb (2013-06-25)

Schematic: FuenteAltaTensionSensoresTension.sch, Fuente de HV. Sensores de tensión. Sensor de corriente. Sir…

Parts:
C1, C4, C7, C8: 2200uF
C2, C5: 0.33uF
C3: 0.01uF
C6: 0.1uF
D1: BU2010
D2: LMB2S
D3, D4: LED
D5: HV_PRESENT
F1: FUSE
K1: Sensor_I
K2: 9VAC
K3: Sensores_LV
K4: Sensores_HV
P1, P8, P9: CONN_1
P2: AC_HV_OUT
P3: 220VAC
P4: 220V_HV_SOURCE
P5: 220V_9VAC
P6: DC_HV_OUT
P7: Sirena
P10: CONN_8
R1, R14: 560
R2, R4: 100
R3, R5, R6, R11, R13, R18, R19, R20, R21, R22: 22K
R7: R
R8, R9: 560
R10, R12: 10M
R15: 5.6k
R16: 270
R17: 3.3k
R23, R24: 0
Rele1: ReleFuenteHV
Rele2: ReleSirena
U1, U3: TL082
U2, U4: IL300
U5, U8: 4N25
U6: LM78L05
U7, U10: DIODE
U9: LM79L05

Connections:
/9DC+: C1.1, C2.1, C7.1, D2.3 (+), U6.1 (VIN)
/9DC-: C4.2, C5.1, C8.2, D2.1 (-), U9.2 (VIN)
/9VAC+: D2.4, K2.1
/9VAC-: D2.2, K2.3
/220V+: P3.2 (PM), P5.2 (PM), Rele1.3, Rele2.3
/220V-: P3.1, P5.1, Rele1.2, Rele2.2
/220v+_SOURCE_HV: P4.1, Rele1.5
/220v-_SOURCE_HV: P4.2 (PM), Rele1.7
/DC_HV_OUT+: F1.2, P6.1
/ENABLE_HV_SOURCE: P10.4, R8.2
/ENABLE_SIRENA: P10.2, R9.2
/HV_LED_INDICATOR: P10.6, R16.1
/SENSOR_I: P10.5, R15.2, R17.1
/SENSOR_V_CAPACITORS: P10.3, R22.2, U3.7
/SENSOR_V_HV_SOURCE: P10.1, R18.2, U3.1
/SOURCE_HV_OUT+: D1.4, P2.1
/SOURCE_HV_OUT-: D1.2, P2.2 (PM)
/Sirena+: P7.1, Rele2.5
/Sirena-: P7.2 (PM), Rele2.7
/V_CAPACITORS: P1.1, P9.1, R12.1
/V_CAPACITORS_A: K4.1, R12.2, R13.1
/V_CAPACITORS_B: K3.1, R24.1
/V_HV_SOURCE: D1.3 (+), P8.1, R7.1, R10.1
/V_HV_SOURCE_A: K4.3, R10.2, R11.1
/V_HV_SOURCE_B: K3.3, R23.1
GNDA: C1.2, C2.2, C3.2, C4.1, C5.2, C6.2, C7.2, C8.1, D1.1 (-), D3.1 (A), D4.2 (K), K2.2 (PM), K3.2 (PM), K4.2 (PM), P6.2 (PM), R3.1, R11.2, R13.2, R20.1, U2.1, U4.1, U5.4, U6.2 (GND), U8.4, U9.3 (GND)
unnamed: Rele1.8, U5.5, U10.1 (A)
unnamed: Rele2.8, U7.1 (A), U8.5
unnamed: K1.2 (PM), R17.2
unnamed: R8.1, U5.1
unnamed: R23.2, U1.3
unnamed: R24.2, U1.5
unnamed: R9.1, U8.1
unnamed: R21.2, R22.1, U3.6
unnamed: R5.2, U2.5, U3.3
unnamed: R20.2, U1.6, U4.4
unnamed: R19.2, U3.5, U4.5
unnamed: R6.2, R18.1, U3.2
unnamed: D3.2 (K), R1.2
unnamed: D4.1 (A), R14.2
unnamed: D5.1 (A), R16.2
unnamed: F1.1, R7.2
unnamed: R4.1, U1.7
unnamed: R2.2, U2.2
unnamed: R4.2, U4.2
unnamed: R2.1, U1.1
unnamed: R3.2, U1.2, U2.4

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
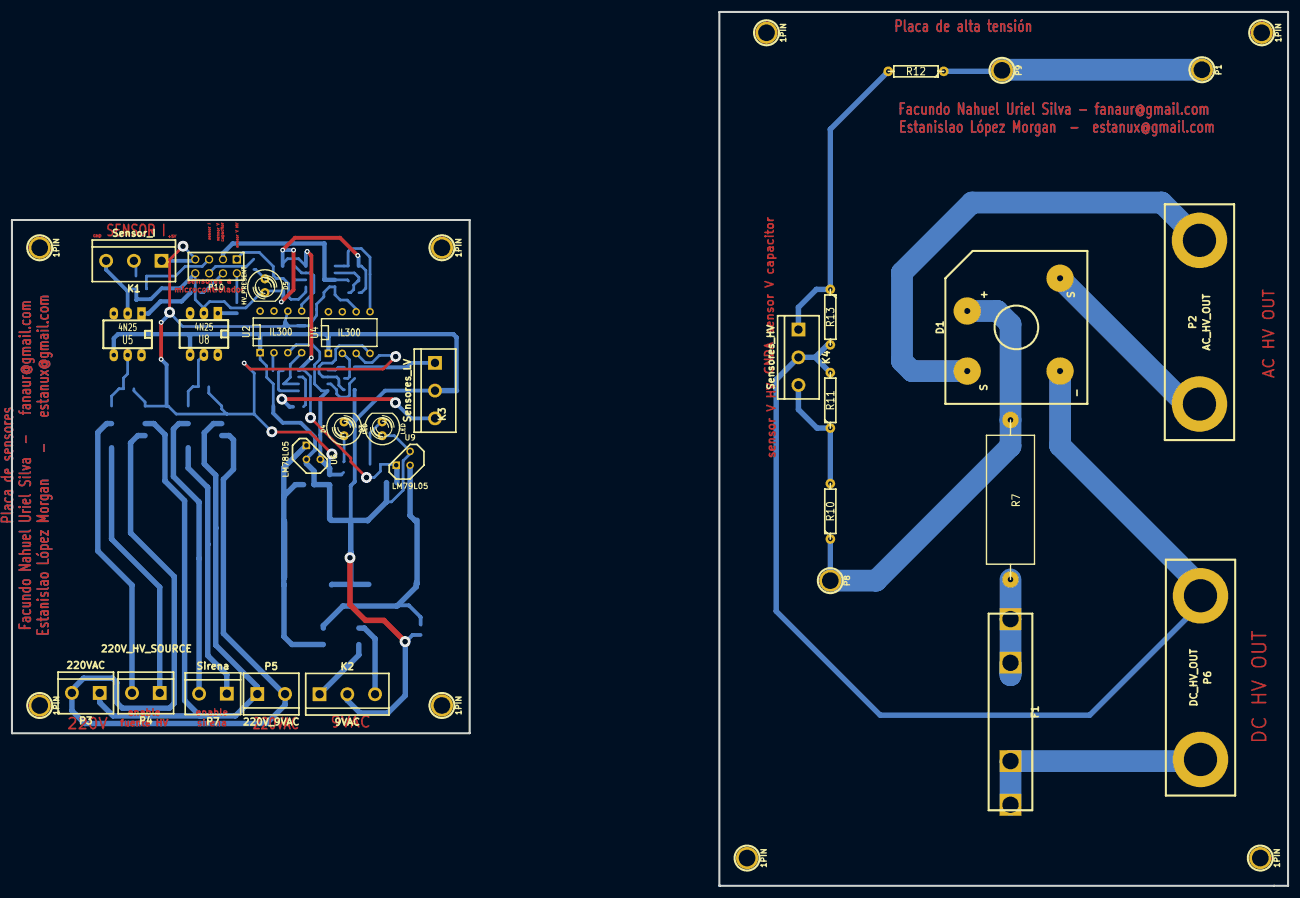
[picture p148: board FuenteAltaTensionSensoresTension.kicad_pcb from above]

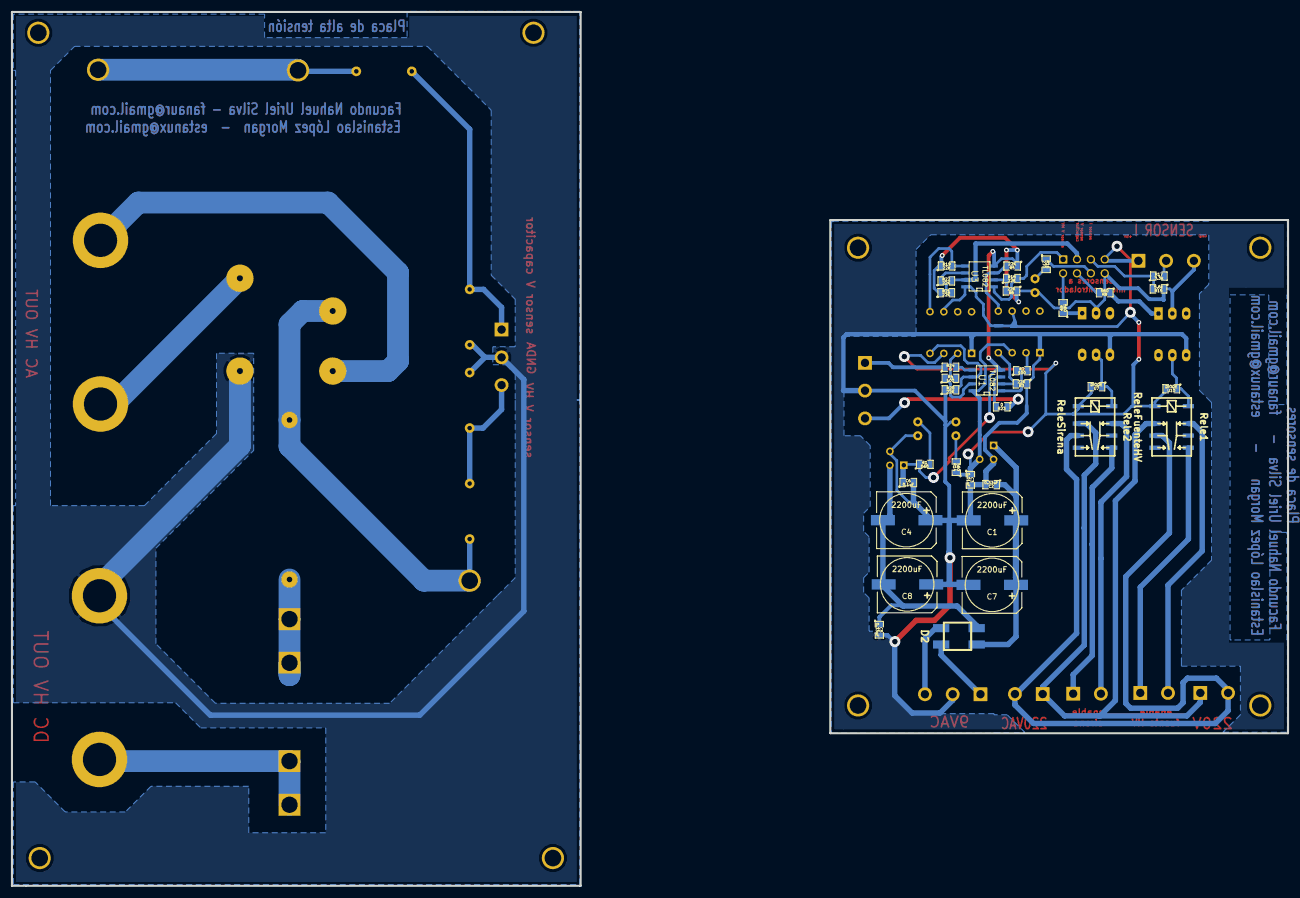
[picture p149: board FuenteAltaTensionSensoresTension.kicad_pcb from below]

Board: 2 copper layers, 233.7 x 160.0 mm, 72 parts (34 on the bottom side), 50 nets.

Other parts of the board:
1PIN, 1PIN#2, 1PIN#3, 1PIN#4, 1PIN#5, 1PIN#6, 1PIN#7, 1PIN#8: P***; 1pin
