Stachovsky/TrabajoProfesional/Pcbs/PcbsDefinitivos/testSensoresTension/testSensoresTension.kicad_pcb

## KiCad design Pcbs/PcbsDefinitivos/testSensoresTension/testSensoresTension.kicad_pcb (2013-06-25)

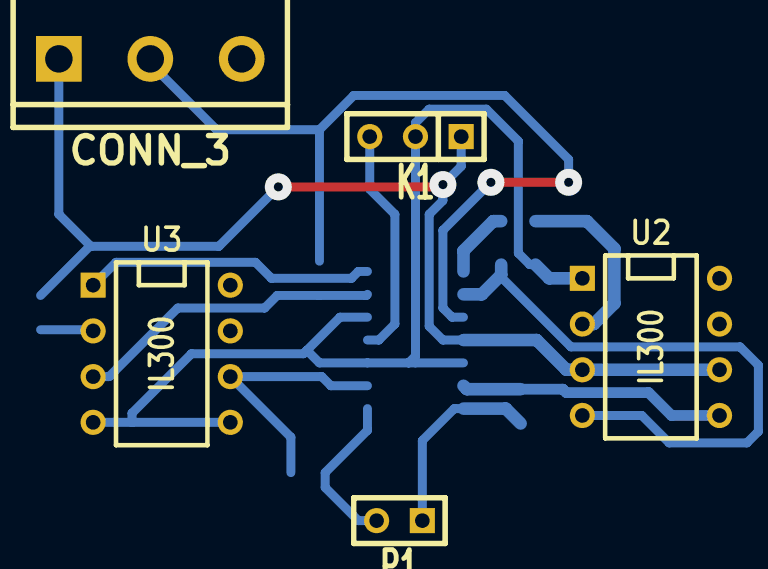
[picture p152: board testSensoresTension.kicad_pcb from above]

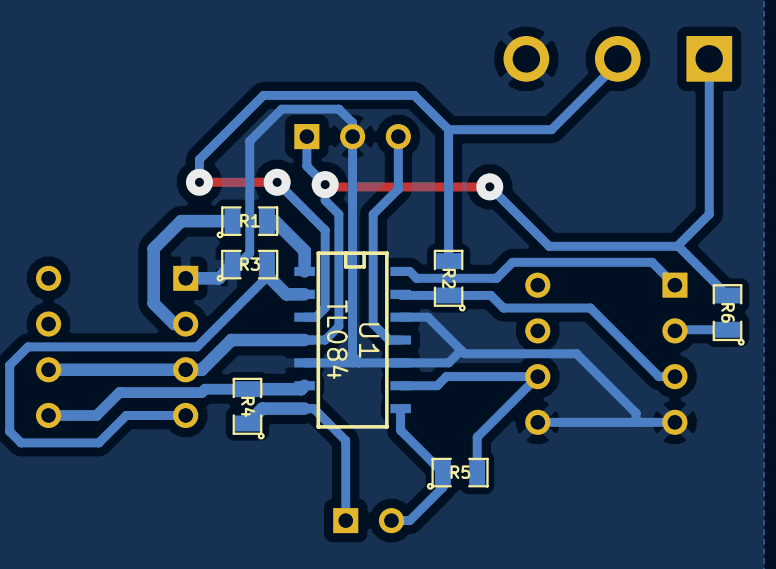
[picture p153: board testSensoresTension.kicad_pcb from below]

Board: 2 copper layers, 12 parts (7 on the bottom side), 14 nets.

Parts:
K1: CONN_3; SIL-3
K2: CONN_3; bornier3
P1: CONN_2; SIL-2
R1, R3, R4: R; SM0805
R2, R5: 10k; SM0805
R6: 1k; SM0805
U1: TL084; SO14E
U2, U3: IL300; DIP-8__300

Connections:
+5V: K1.1, K2.1, R6.2, U1.4, U2.3, U2.6
-5V: K1.3, U1.11
/In: K2.2, R2.2, U1.3
/Out1: P1.1, R4.1, U1.7
/Out2: P1.2, R5.1, U1.8
GND: K1.2, K2.3, R3.1, U1.5, U1.10, U1.12, U2.1, U3.4, U3.5
unnamed: R1.1, U2.2
unnamed: R3.2, U1.2, U2.4
unnamed: R4.2, U1.6, U2.5
unnamed: R1.2, U1.1
unnamed: R6.1, U3.2
unnamed: R5.2, U1.9, U3.6
unnamed: R2.1, U1.13, U3.3
unnamed: U1.14, U3.1
