Stachovsky/TrabajoProfesional/Pcbs/PcbsDefinitivos/Baliza/Baliza.kicad_pcb

## KiCad design Pcbs/PcbsDefinitivos/Baliza/Baliza.kicad_pcb (2013-06-25)

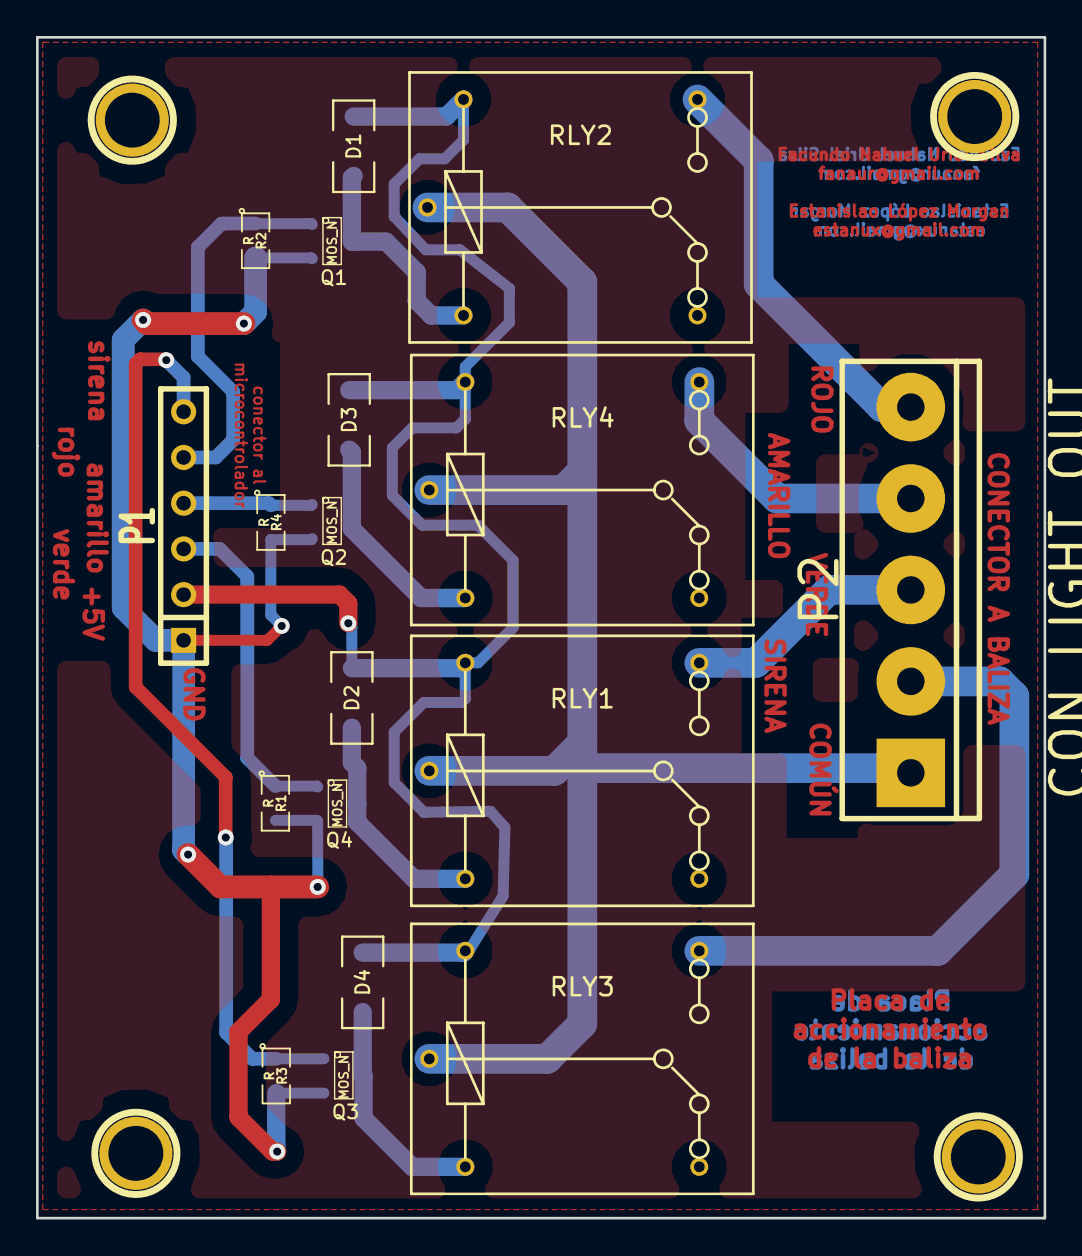
[picture p157: board Baliza.kicad_pcb from above]

Board: 2 copper layers, 56.0 x 65.6 mm, 18 parts (0 on the bottom side), 15 nets.

Parts:
D1, D2, D3, D4: DIODE; SM1206
P1: CON_LIGHT_IN; SIL-6
P2: CON_LIGHT_OUT; bornier5
Q1, Q2, Q3, Q4: MOS_N; SOT23
R1, R2, R3, R4: R; SM0805
RLY1, RLY2, RLY3, RLY4: RELAY_T9AS5X1; relay_JQC-3F-1C

Connections:
+5V: D1.2, D2.2, D3.2, D4.2, P1.2, RLY1.2, RLY2.2, RLY3.2, RLY4.2
/COMMON: P2.1, RLY1.3, RLY2.3, RLY3.3, RLY4.3
/GREEN_LIGHT_IN: P1.3, Q4.1, R1.1
/GREEN_LIGHT_OUT: P2.3, RLY1.4
/RED_LIGHT_IN: P1.5, Q1.1, R2.1
/RED_LIGHT_OUT: P2.5, RLY2.4
/SIREN_IN: P1.6, Q3.1, R3.1
/SIREN_OUT: P2.2, RLY3.4
/YELLOW_LIGHT_IN: P1.4, Q2.1, R4.1
/YELLOW_LIGHT_OUT: P2.4, RLY4.4
GND: P1.1, Q1.2, Q2.2, Q3.2, Q4.2, R1.2, R2.2, R3.2, R4.2
unnamed: D4.1, Q3.3, RLY3.1
unnamed: D3.1, Q2.3, RLY4.1
unnamed: D2.1, Q4.3, RLY1.1
unnamed: D1.1, Q1.3, RLY2.1
