Stachovsky/TrabajoProfesional/Pcbs/PcbsDefinitivos/FuenteAltaTensionSensoresTension/.kicad_pcbVersion1.kicad_pcb

## KiCad design Pcbs/PcbsDefinitivos/FuenteAltaTensionSensoresTension/.kicad_pcbVersion1.kicad_pcb (2013-06-25)

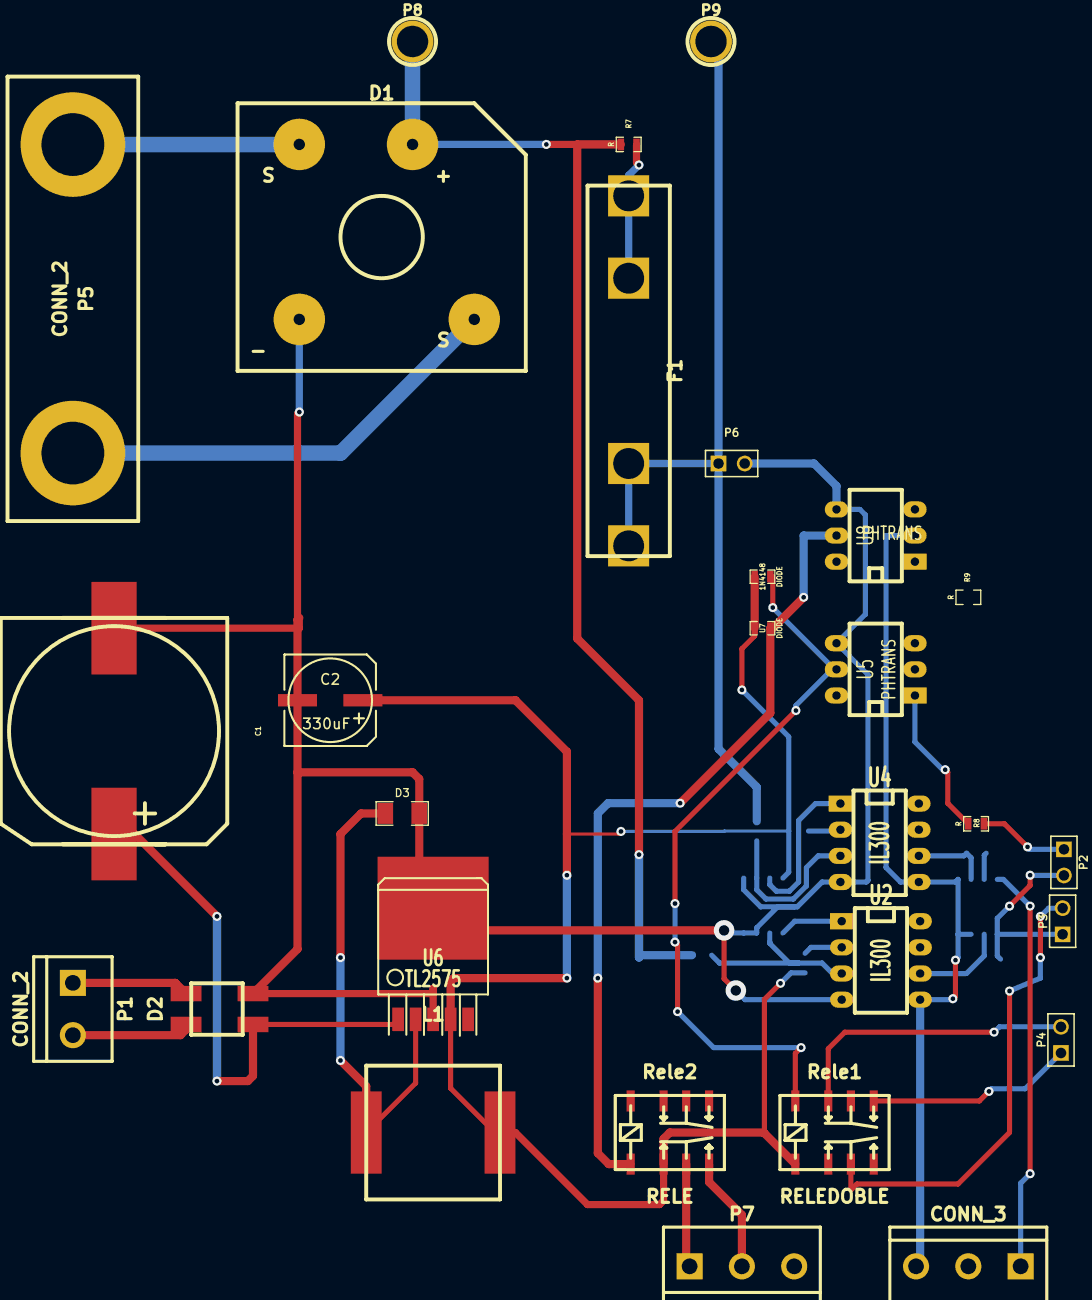
[picture p159: board .kicad_pcbVersion1.kicad_pcb from above]

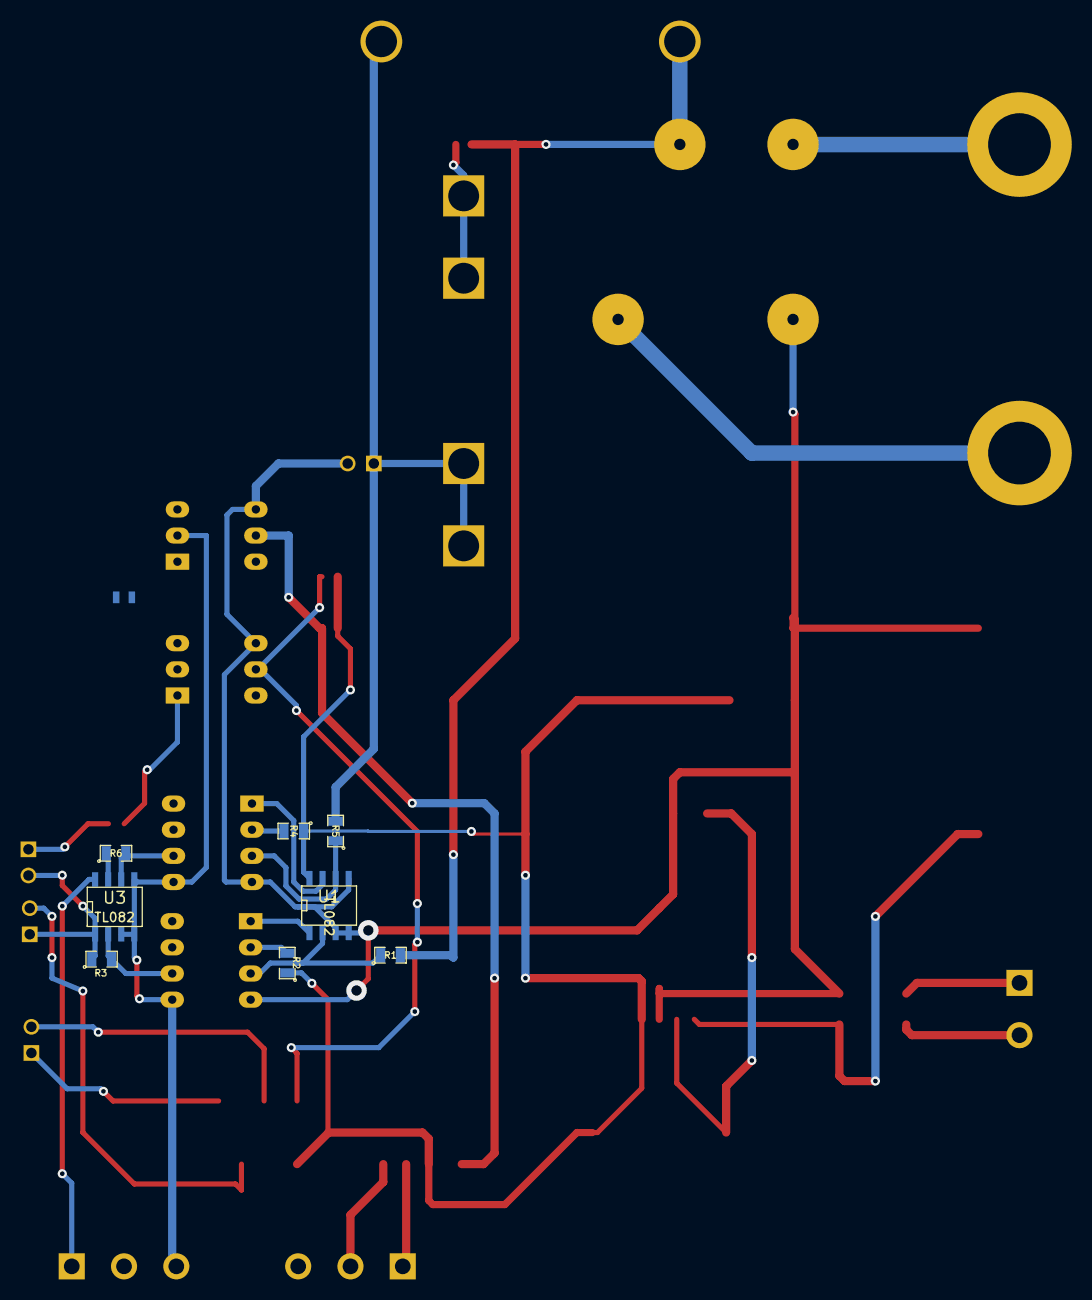
[picture p160: board .kicad_pcbVersion1.kicad_pcb from below]

Board: 2 copper layers, 37 parts (8 on the bottom side), 34 nets.

Parts:
1N4148: DIODE; SM0603_Capa
C1: 2200uF; c_elec_10x20
C2: 330uF; SMDHD/VF
D1: BRIDGE; bridge_1KV_TH
D2: BRIDGE; bridge_1A
D3: DIODESCH; SM1206
F1: FUSE; FUSE_1KV_TH
K1: CONN_3; bornier3
L1: 300mH; SMD_inductor
P1: CONN_2; bornier2
P2: CONN_6; PIN_ARRAY_2X1
P3, P4, P6: CONN_2; PIN_ARRAY_2X1
P5: CONN_2; 2PIN_6mm
P7: Sirena; bornier3
P8, P9: CONN_1; 1pin
R1, R3, R5, R6: 10k; SM0805
R2, R4: 1k; SM0805
R7, R8, R9: R; SM0603_Resistor
Rele1: RELEDOBLE; relay_gq-smd-s
Rele2: RELE; relay_gq-smd-s
U1, U3: TL082; SO8E
U2, U4: IL300; DIP-8__300_ELL
U5, U8: PHTRANS; DIP-6__300_ELL
U6: TL2575; TO263-5
U7: DIODE; SM0603_Capa

Connections:
+5V: K1.1, U3.8
+5VA: 1N4148.2, C2.1, L1.2, R2.1, R4.1, Rele1.1, Rele2.2, U6.4, U7.2
/ENABLE_HV_SOURCE: P2.1, R8.2
/SENSOR_V_CAPACITORS: R6.1, U3.7
/SENSOR_V_HV_SOURCE: P2.2, R3.1, U3.1
/V_CAPACITORS: F1.2, P6.1, P9.1, R5.2
/V_HV_SOURCE: D1.3, P8.1, R1.2, R7.1
GND: K1.3, U2.5, U3.3, U3.4, U3.5, U4.5, U5.2, U8.2
GNDA: C1.2, C2.2, D1.1, D2.1, D3.1, P6.2, U1.3, U1.4, U1.5, U2.4, U4.4, U5.4, U6.3, U8.4
unnamed: F1.1, R7.2
unnamed: R3.2, U2.6, U3.2
unnamed: D1.2, P5.1
unnamed: D1.4, P5.2
unnamed: R8.1, U5.1
unnamed: 1N4148.1, Rele1.8, U5.5
unnamed: R6.2, U3.6, U4.6
unnamed: R5.1, U1.6, U4.3
unnamed: U1.7, U4.1
unnamed: R4.2, U4.2
unnamed: R2.2, U2.2
unnamed: U1.1, U2.1
unnamed: P3.2, Rele1.3
unnamed: R1.1, U1.2, U2.3
unnamed: R9.1, U8.1
unnamed: Rele2.1, U7.1, U8.5
unnamed: P7.1, Rele2.3
unnamed: P7.2, Rele2.4
unnamed: D2.2, P1.1
unnamed: C1.1, D2.3, U6.1
unnamed: D2.4, P1.2
unnamed: P4.2, Rele1.7
unnamed: P4.1, Rele1.5
unnamed: P3.1, Rele1.2
unnamed: D3.2, L1.1, U6.2
