Stachovsky/TrabajoProfesional/Pcbs/AcopladorAccionadoresPotencia/AcopladorAccionadoresPotencia.sch

## KiCad design Pcbs/AcopladorAccionadoresPotencia/AcopladorAccionadoresPotencia.sch (2013-06-25)

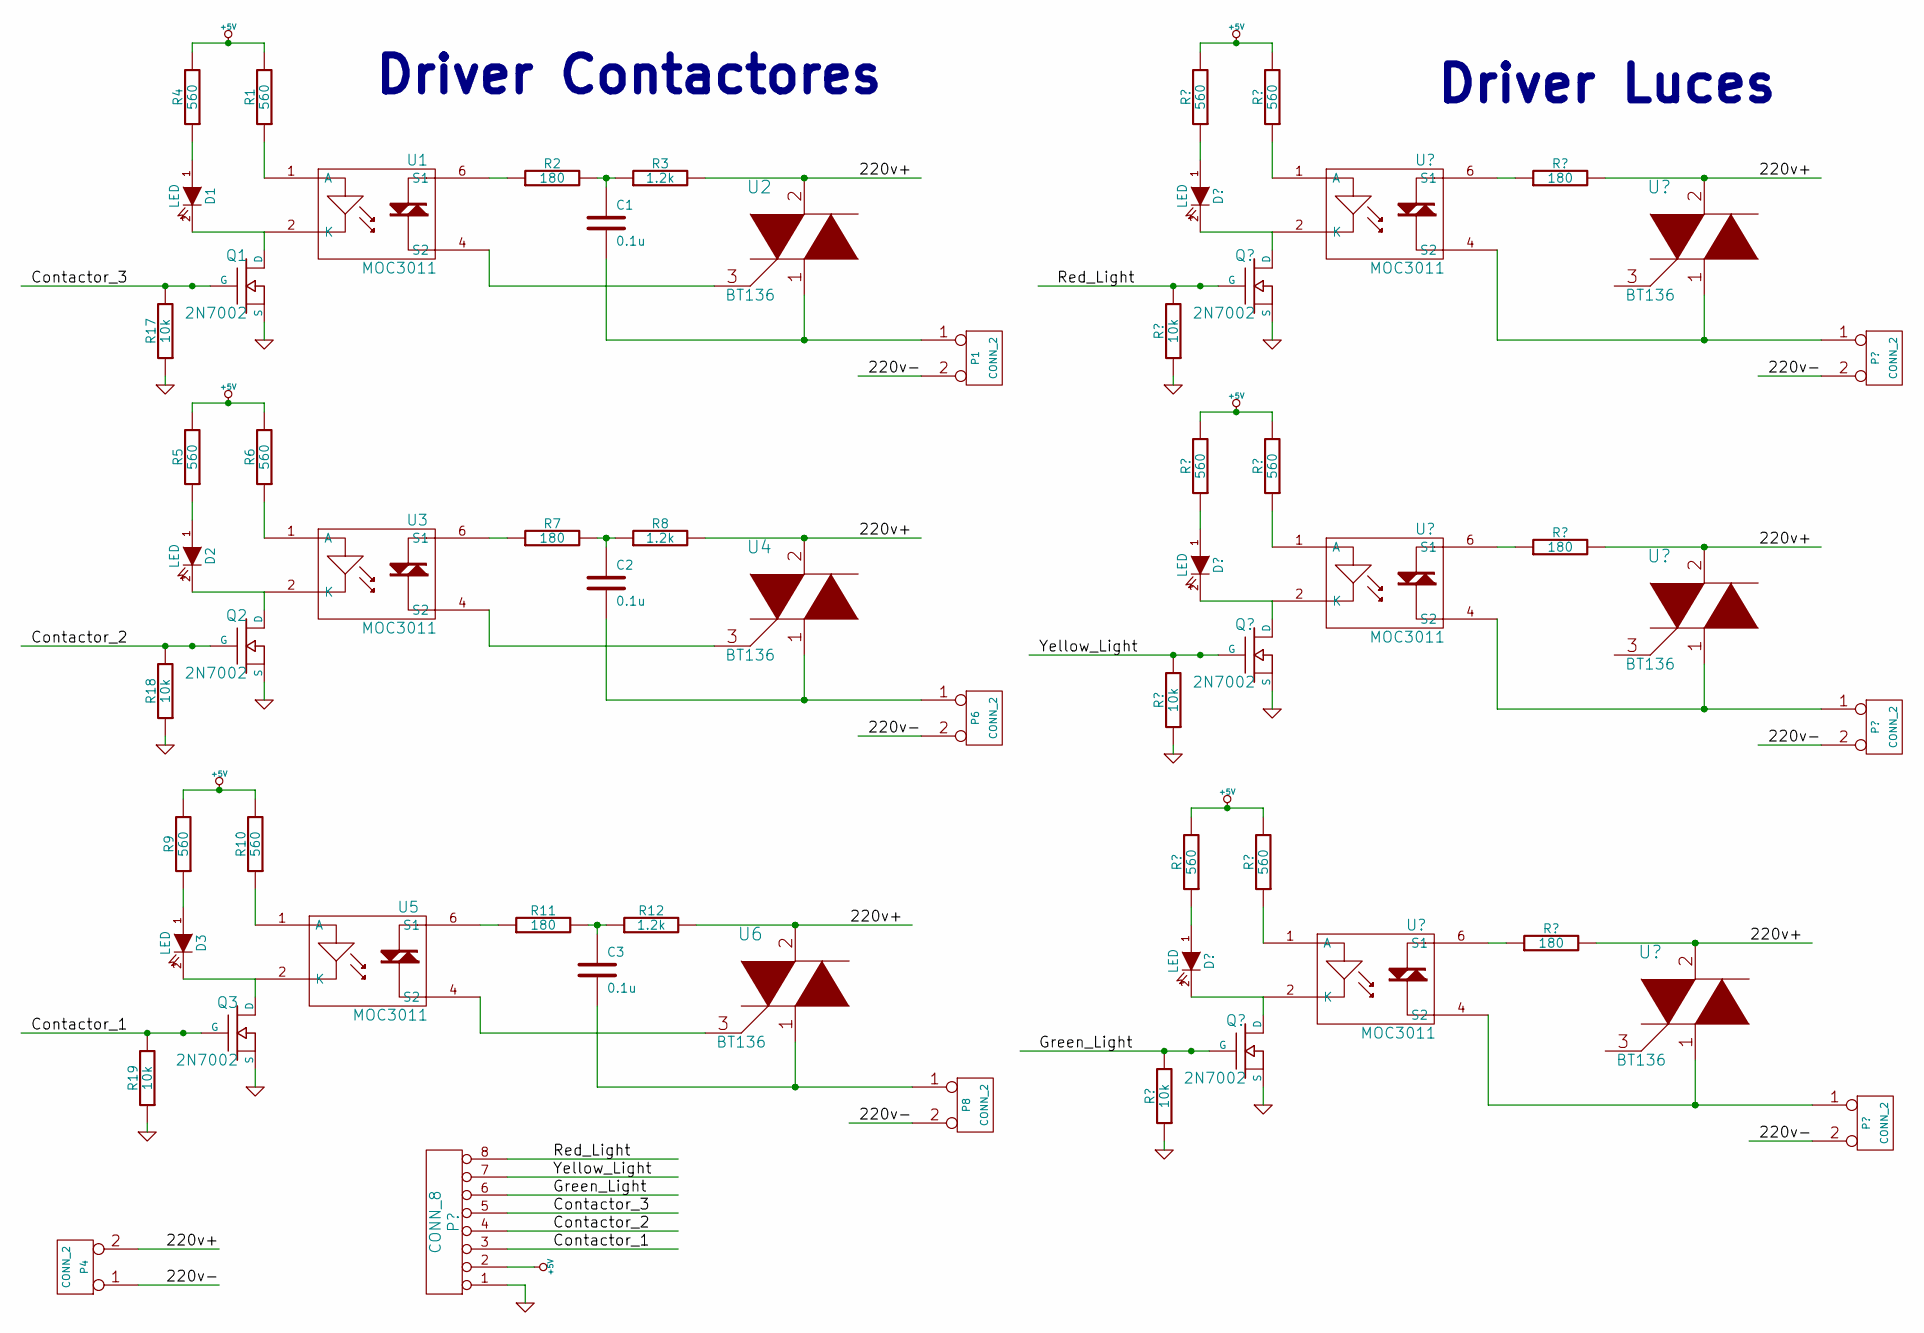
[picture p161: schematic AcopladorAccionadoresPotencia.sch]

Parts:
C1, C2, C3: 0.1u
D1, D2, D3: LED
P1, P4, P6, P8: CONN_2
Q1, Q2, Q3: 2N7002
R1, R4, R5, R6, R9, R10: 560
R2, R7, R11: 180
R3, R8, R12: 1.2k
R17, R18, R19: 10k
U1, U3, U5: MOC3011
U2, U4, U6: BT136

Connections:
220v+: P4.2 (PM), R3.2, R8.2, R12.2, U2.2, U4.2, U6.2
220v-: P1.2 (PM), P4.1, P6.2 (PM), P8.2 (PM)
+5V: R1.2, R4.2, R5.2, R6.2, R9.2, R10.2
Contactor_1: Q3.G, R19.2
Contactor_2: Q2.G, R18.2
Contactor_3: Q1.G, R17.2
GND: Q1.S, Q2.S, Q3.S, R17.1, R18.1, R19.1
unnamed: C1.1, R2.2, R3.1
unnamed: C1.2, P1.1, U2.1
unnamed: C2.1, R7.2, R8.1
unnamed: C2.2, P6.1, U4.1
unnamed: C3.1, R11.2, R12.1
unnamed: C3.2, P8.1, U6.1
unnamed: D1.1 (A), R4.1
unnamed: D1.2 (K), Q1.D, U1.2 (K)
unnamed: D2.1 (A), R5.1
unnamed: D2.2 (K), Q2.D, U3.2 (K)
unnamed: D3.1 (A), R9.1
unnamed: D3.2 (K), Q3.D, U5.2 (K)
unnamed: R1.1, U1.1 (A)
unnamed: R2.1, U1.6 (S1)
unnamed: R6.1, U3.1 (A)
unnamed: R7.1, U3.6 (S1)
unnamed: R10.1, U5.1 (A)
unnamed: R11.1, U5.6 (S1)
unnamed: U1.4 (S2), U2.3
unnamed: U3.4 (S2), U4.3
unnamed: U5.4 (S2), U6.3

Notes on the sheet:
Driver Contactores
Driver Luces
