Stachovsky/TrabajoProfesional/Pcbs/ConectorBaseBoardLcdGrafic/$ConectorBaseBoardLcdGrafic.sch

## KiCad design Pcbs/ConectorBaseBoardLcdGrafic/$ConectorBaseBoardLcdGrafic.sch (2013-06-25)

Schematic: $ConectorBaseBoardLcdGrafic.sch

Parts:
K1: CONN_3
P1: CONN_20
P2: CONN_25
R1, R2: R
