Stachovsky/TrabajoProfesional/Pcbs/FuenteAltaTensionSensoresTension/FuenteAltaTensionSensoresTension.sch

## KiCad design Pcbs/FuenteAltaTensionSensoresTension/FuenteAltaTensionSensoresTension.sch (2013-06-25)

Schematic: FuenteAltaTensionSensoresTension.sch

Parts:
1N4148: DIODE
C1: 2200uF
C2: 330uF
D1, D2: BRIDGE
D3: DIODESCH
F1: FUSE
L1: 300mH
P1, P3, P4, P5, P6: CONN_2
R1, R3, R5, R6: 10k
R2, R4: 1k
R7, R8: R
Rele1: RELEDOBLE
U1, U3: TL082
U2, U4: IL300
U5: PHTRANS
U6: TL2575

Notes on the sheet:
220V/50Hz
Balastro
