Stachovsky/TrabajoProfesional/Pcbs/SimulacionSensores/SimulacinSensores.sch

## KiCad design Pcbs/SimulacionSensores/SimulacinSensores.sch (2013-06-25)

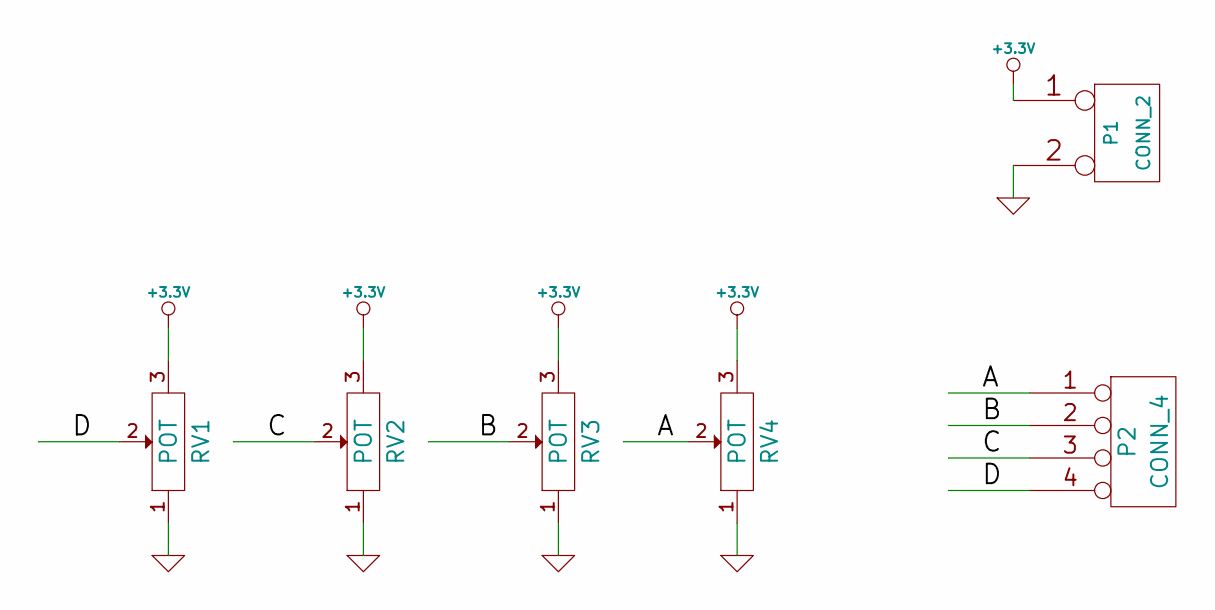
[picture p162: schematic SimulacinSensores.sch]

Parts:
P1: CONN_2
P2: CONN_4
RV1, RV2, RV3, RV4: POT

Connections:
+3.3V: P1.1, RV1.3, RV2.3, RV3.3, RV4.3
A: P2.1, RV4.2
B: P2.2, RV3.2
C: P2.3, RV2.2
D: P2.4, RV1.2
GND: P1.2 (PM), RV1.1, RV2.1, RV3.1, RV4.1
