Stachovsky/TrabajoProfesional/Pcbs/PcbsDefinitivos/Baliza/Baliza.sch

## KiCad design Pcbs/PcbsDefinitivos/Baliza/Baliza.sch (2013-06-25)

Schematic: Baliza.sch

Parts:
D1, D2, D3, D4: DIODE
P1: CON_LIGHT_IN
P2: CON_LIGHT_OUT
Q1, Q2, Q3, Q4: MOS_N
R1, R2, R3, R4: R
RLY1, RLY2, RLY3, RLY4: RELAY_T9AS5X1
