Stachovsky/TrabajoProfesional/Pcbs/PcbsDefinitivos/DisplayGraficoConectorUSB/DisplayGraficoConectorUSB.sch

## KiCad design Pcbs/PcbsDefinitivos/DisplayGraficoConectorUSB/DisplayGraficoConectorUSB.sch (2013-06-25)


Parts:
D1: STATUS_LED
J1: USB
K1: ContrastControl_10k
P1: CONN_10X2
R1: 270
U1: NHD-12864WG-CTFH-VN

Connections:
+5V: P1.1, U1.4 (VDD), U1.19 (LED+)
CS1: P1.18, U1.2 (CS1B)
CS2: P1.20, U1.1 (CS2B)
DB0: P1.16, U1.9 (DB0)
DB1: P1.14, U1.10 (DB1)
DB2: P1.12, U1.11 (DB2)
DB3: P1.10, U1.12 (DB3)
DB4: P1.8, U1.13 (DB4)
DB5: P1.6, U1.14 (DB5)
DB6: P1.4, U1.15 (DB6)
DB7: P1.2, U1.16 (DB7)
E: P1.13, U1.8 (E)
GND: D1.2 (K), J1.4 (GND), K1.1, P1.3, U1.3 (VSS), U1.20 (LED-)
unnamed: D1.1 (A), R1.2
R/W: P1.15, U1.7 (R/W)
RS: P1.19, U1.6 (RS)
STATUS_LED: P1.5, R1.1
USB+: J1.3 (D+), P1.9
USB-: J1.2 (D-), P1.11
USB_VCC: J1.1 (Vbus), P1.7
V0: K1.2 (PM), U1.5 (V0)
VEE: K1.3, U1.18 (VEE)
~RST: P1.17, U1.17 (~RST)
