Stachovsky/TrabajoProfesional/Pcbs/PcbsDefinitivos/FuenteAltaTensionSensoresTension/FuenteAltaTensionSensoresTension.sch

## KiCad design Pcbs/PcbsDefinitivos/FuenteAltaTensionSensoresTension/FuenteAltaTensionSensoresTension.sch (2013-06-25)

Schematic: FuenteAltaTensionSensoresTension.sch

Parts:
C1, C4, C7, C8: 2200uF
C2, C5: 0.33uF
C3: 0.01uF
C6: 0.1uF
D1: BU2010
D2: LMB2S
D3, D4: LED
D5: HV_PRESENT
F1: FUSE
K1: Sensor_I
K2: 9VAC
K3: Sensores_LV
K4: Sensores_HV
P1, P8, P9: CONN_1
P2: AC_HV_OUT
P3: 220VAC
P4: 220V_HV_SOURCE
P5: 220V_9VAC
P6: DC_HV_OUT
P7: Sirena
P10: CONN_8
R1, R14: 560
R2, R4: 100
R3, R5, R6, R11, R13, R18, R19, R20, R21, R22: 22K
R7: R
R8, R9: 560
R10, R12: 10M
R15: 5.6k
R16: 270
R17: 3.3k
R23, R24: 0
Rele1: ReleFuenteHV
Rele2: ReleSirena
U1, U3: TL082
U2, U4: IL300
U5, U8: 4N25
U6: LM78L05
U7, U10: DIODE
U9: LM79L05
