Stachovsky/TrabajoProfesional/Pcbs/PcbsDefinitivos/FuenteHvDC/FuenteHvDC.sch

## KiCad design Pcbs/PcbsDefinitivos/FuenteHvDC/FuenteHvDC.sch (2013-06-25)

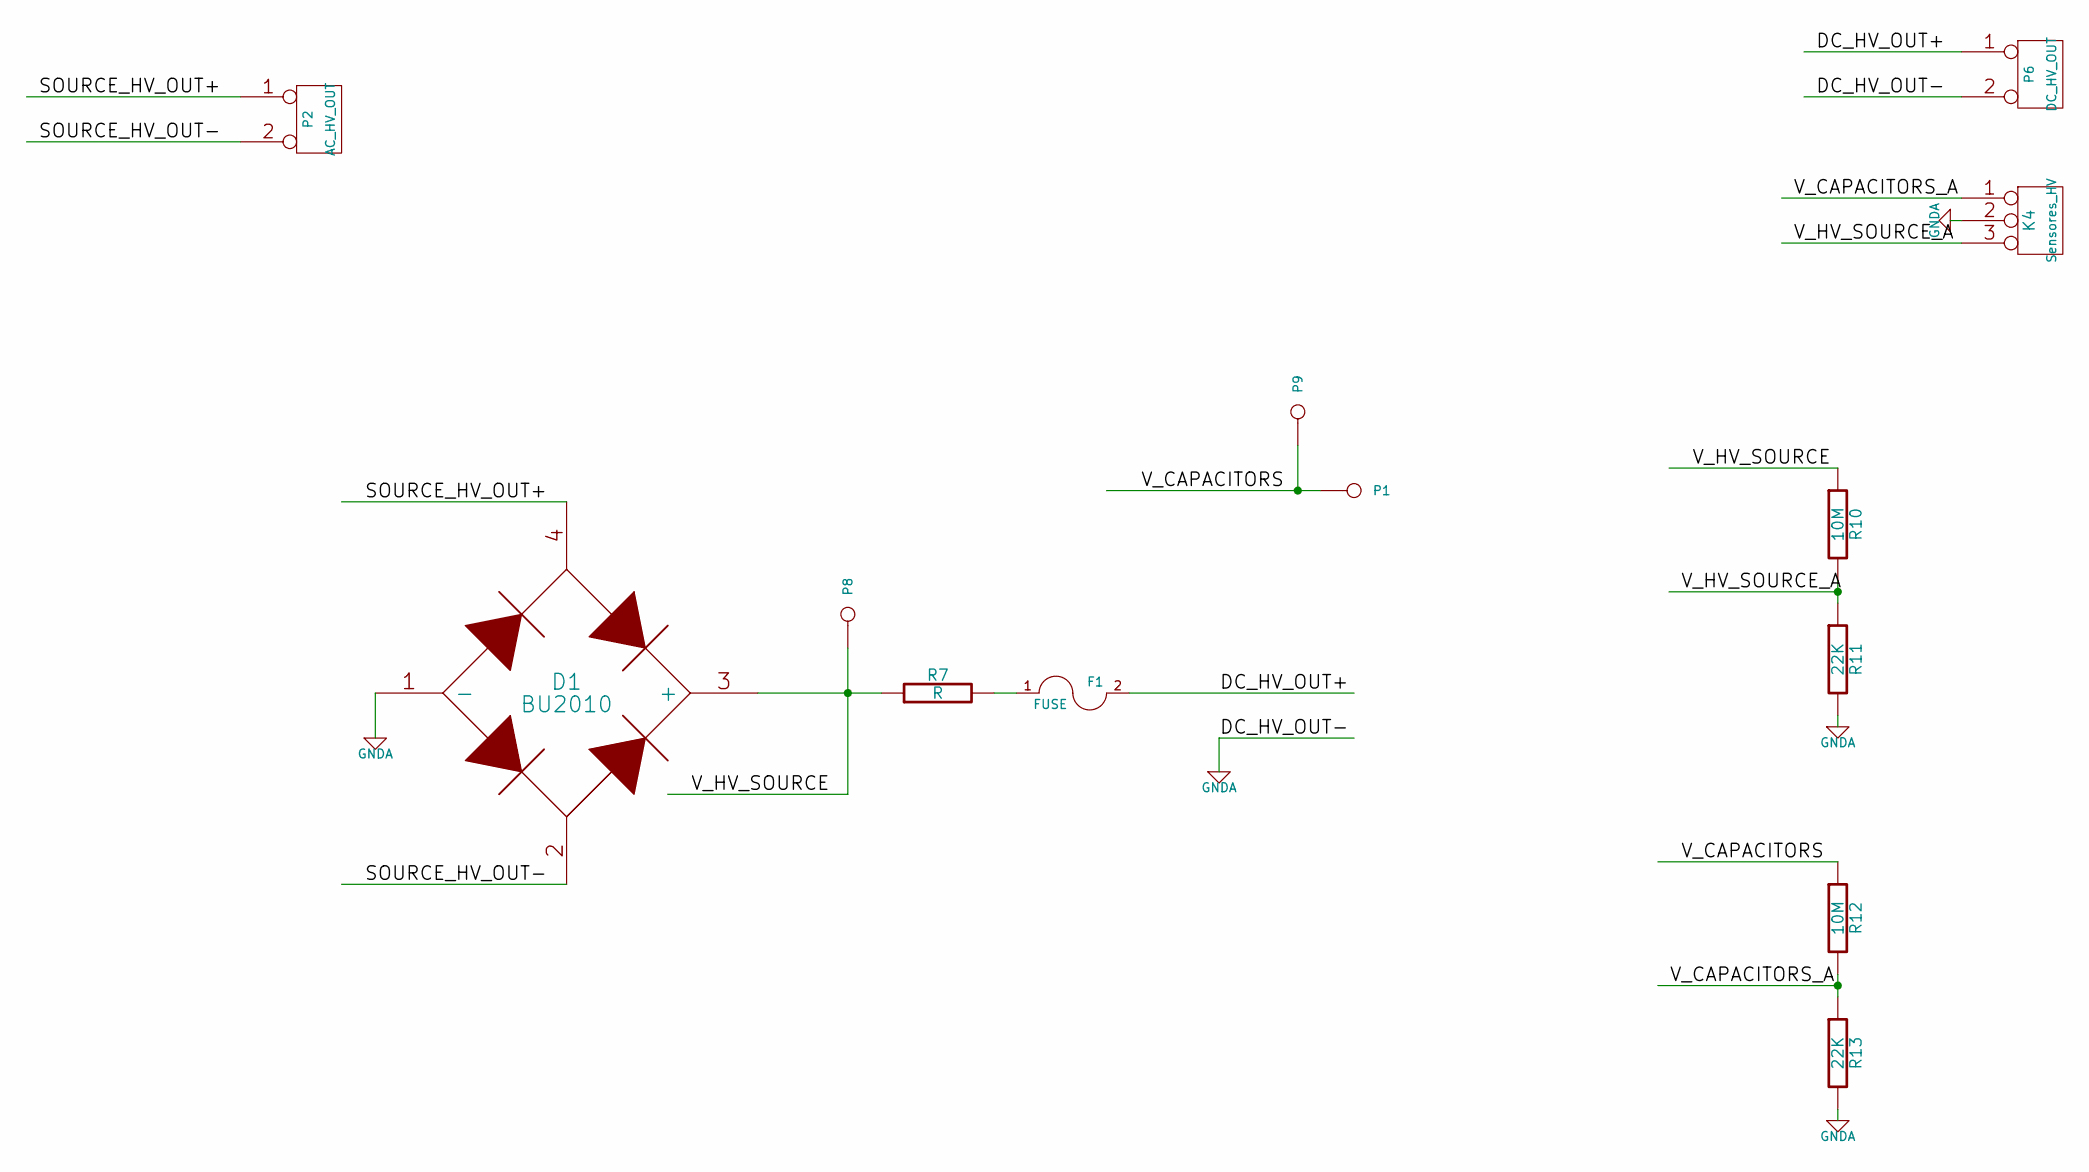
[picture p163: schematic FuenteHvDC.sch]

Parts:
D1: BU2010
F1: FUSE
K4: Sensores_HV
P1, P8, P9: CONN_1
P2: AC_HV_OUT
P6: DC_HV_OUT
R7: R
R10, R12: 10M
R11, R13: 22K

Connections:
DC_HV_OUT+: F1.2, P6.1
GNDA: D1.1 (-), K4.2 (PM), P6.2 (PM), R11.2, R13.2
unnamed: F1.1, R7.2
SOURCE_HV_OUT+: D1.4, P2.1
SOURCE_HV_OUT-: D1.2, P2.2 (PM)
V_CAPACITORS: P1.1, P9.1, R12.1
V_CAPACITORS_A: K4.1, R12.2, R13.1
V_HV_SOURCE: D1.3 (+), P8.1, R7.1, R10.1
V_HV_SOURCE_A: K4.3, R10.2, R11.1
