Stachovsky/TrabajoProfesional/Pcbs/PcbsDefinitivos/Motherboard/$Motherboard.sch

## KiCad design Pcbs/PcbsDefinitivos/Motherboard/$Motherboard.sch (2013-06-25)

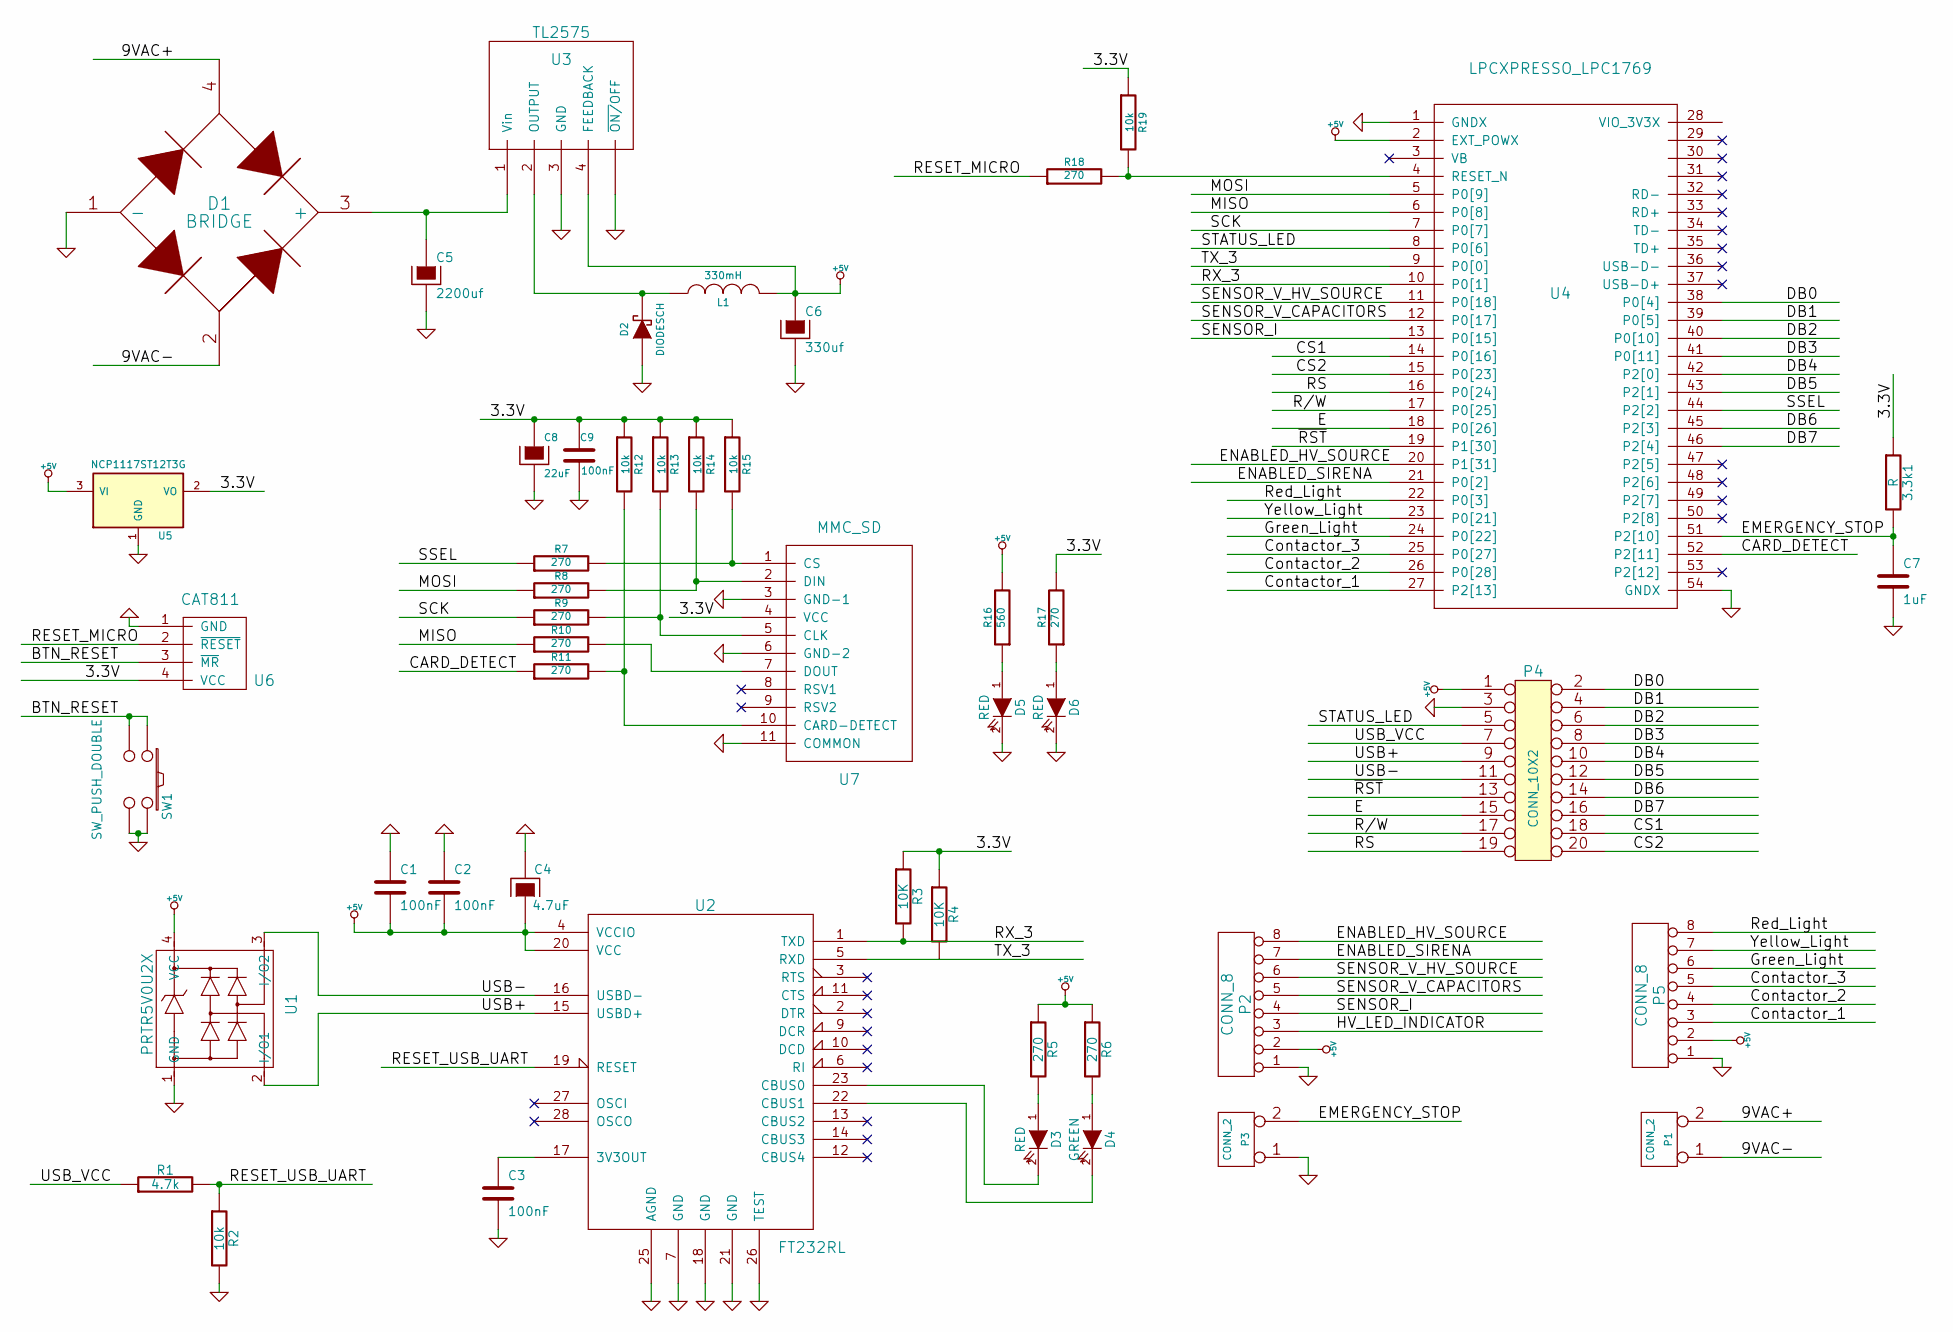
[picture p164: schematic $Motherboard.sch]

Parts:
3.3k1: R
C1, C2, C3: 100nF
C4: 4.7uF
C5: 2200uf
C6: 330uf
C7: 1uF
C8: 22uF
C9: 100nF
D1: BRIDGE
D2: DIODESCH
D3, D5, D6: RED
D4: GREEN
L1: 330mH
P1, P3: CONN_2
P2, P5: CONN_8
P4: CONN_10X2
R1: 4.7k
R2: 10k
R3, R4: 10K
R5, R6: 270
R7, R8, R9, R10, R11, R17, R18: 270
R12, R13, R14, R15, R19: 10k
R16: 560
SW1: SW_PUSH_DOUBLE
U1: PRTR5V0U2X
U2: FT232RL
U3: TL2575
U4: LPCXPRESSO_LPC1769
U5: NCP1117ST12T3G
U6: CAT811
U7: MMC_SD

Connections:
3.3V: 3.3k1.1, C8.1, C9.1, R3.1, R4.1, R12.1, R13.1, R14.1, R15.1, R17.2, R19.1, U5.2 (VO), U6.4 (VCC), U7.4 (VCC)
9VAC+: D1.4, P1.2 (PM)
9VAC-: D1.2, P1.1
+5V: C1.2, C2.2, C4.1, C6.1, L1.2, P2.2, P4.1, P5.2, R5.1, R6.1, R16.2, U1.4 (VCC), U2.4 (VCCIO), U2.20 (VCC), U3.4 (FEEDBACK), U4.2 (EXT_POWX), U5.3 (VI)
BTN_RESET: SW1.1, SW1.2, U6.3 (~MR)
CARD_DETECT: R11.1, U4.52 (P2[11])
CS1: P4.18, U4.14 (P0[16])
CS2: P4.20, U4.15 (P0[23])
Contactor_1: P5.3, U4.27 (P2[13])
Contactor_2: P5.4, U4.26 (P0[28])
Contactor_3: P5.5, U4.25 (P0[27])
DB0: P4.2, U4.38 (P0[4])
DB1: P4.4, U4.39 (P0[5])
DB2: P4.6, U4.40 (P0[10])
DB3: P4.8, U4.41 (P0[11])
DB4: P4.10, U4.42 (P2[0])
DB5: P4.12, U4.43 (P2[1])
DB6: P4.14, U4.45 (P2[3])
DB7: P4.16, U4.46 (P2[4])
E: P4.15, U4.18 (P0[26])
EMERGENCY_STOP: 3.3k1.2, C7.1, P3.2 (PM), U4.51 (P2[10])
ENABLED_HV_SOURCE: P2.8, U4.20 (P1[31])
ENABLED_SIRENA: P2.7, U4.21 (P0[2])
GND: C1.1, C2.1, C3.2, C4.2, C5.2, C6.2, C7.2, C8.2, C9.2, D1.1 (-), D2.1 (A), D5.2 (K), D6.2 (K), P2.1, P3.1, P4.3, P5.1, R2.2, SW1.3, SW1.4, U1.1 (GND), U2.7 (GND), U2.18 (GND), U2.21 (GND), U2.25 (AGND), U2.26 (TEST), U3.3 (GND), U3.~ (~ON/~OFF), U4.1 (GNDX), U4.54 (GNDX), U5.1 (GND), U6.1 (GND), U7.3 (GND-1), U7.6 (GND-2), U7.11 (COMMON)
Green_Light: P5.6, U4.24 (P0[22])
HV_LED_INDICATOR: P2.3
MISO: R10.1, U4.6 (P0[8])
MOSI: R8.1, U4.5 (P0[9])
unnamed: C3.1, U2.17 (3V3OUT)
unnamed: C5.1, D1.3 (+), U3.1 (Vin)
unnamed: D2.2 (K), L1.1, U3.2 (OUTPUT)
unnamed: D3.1 (A), R5.2
unnamed: D3.2 (K), U2.23 (CBUS0)
unnamed: D4.1 (A), R6.2
unnamed: D4.2 (K), U2.22 (CBUS1)
unnamed: D5.1 (A), R16.1
unnamed: D6.1 (A), R17.1
unnamed: R10.2, U7.7 (DOUT)
unnamed: R11.2, R12.2, U7.10 (CARD-DETECT)
unnamed: R9.2, R13.2, U7.5 (CLK)
unnamed: R8.2, R14.2, U7.2 (DIN)
unnamed: R7.2, R15.2, U7.1 (CS)
unnamed: R18.2, R19.2, U4.4 (RESET_N)
R/W: P4.17, U4.17 (P0[25])
RESET_MICRO: R18.1, U6.2 (~RESET)
RESET_USB_UART: R1.2, R2.1, U2.19 (RESET)
RS: P4.19, U4.16 (P0[24])
RX_3: R3.2, U2.1 (TXD), U4.10 (P0[1])
Red_Light: P5.8, U4.22 (P0[3])
SCK: R9.1, U4.7 (P0[7])
SENSOR_I: P2.4, U4.13 (P0[15])
SENSOR_V_CAPACITORS: P2.5, U4.12 (P0[17])
SENSOR_V_HV_SOURCE: P2.6, U4.11 (P0[18])
SSEL: R7.1, U4.44 (P2[2])
STATUS_LED: P4.5, U4.8 (P0[6])
TX_3: U2.5 (RXD), U4.9 (P0[0])
USB+: P4.9, U1.2 (I/O1), U2.15 (USBD+)
USB-: P4.11, U1.3 (I/O2), U2.16 (USBD-)
USB_VCC: P4.7, R1.1
Yellow_Light: P5.7, U4.23 (P0[21])
~RST: P4.13, U4.19 (P1[30])
