Stachovsky/TrabajoProfesional/Pcbs/PcbsDefinitivos/testSensoresTension/$testSensoresTension.sch

## KiCad design Pcbs/PcbsDefinitivos/testSensoresTension/$testSensoresTension.sch (2013-06-25)

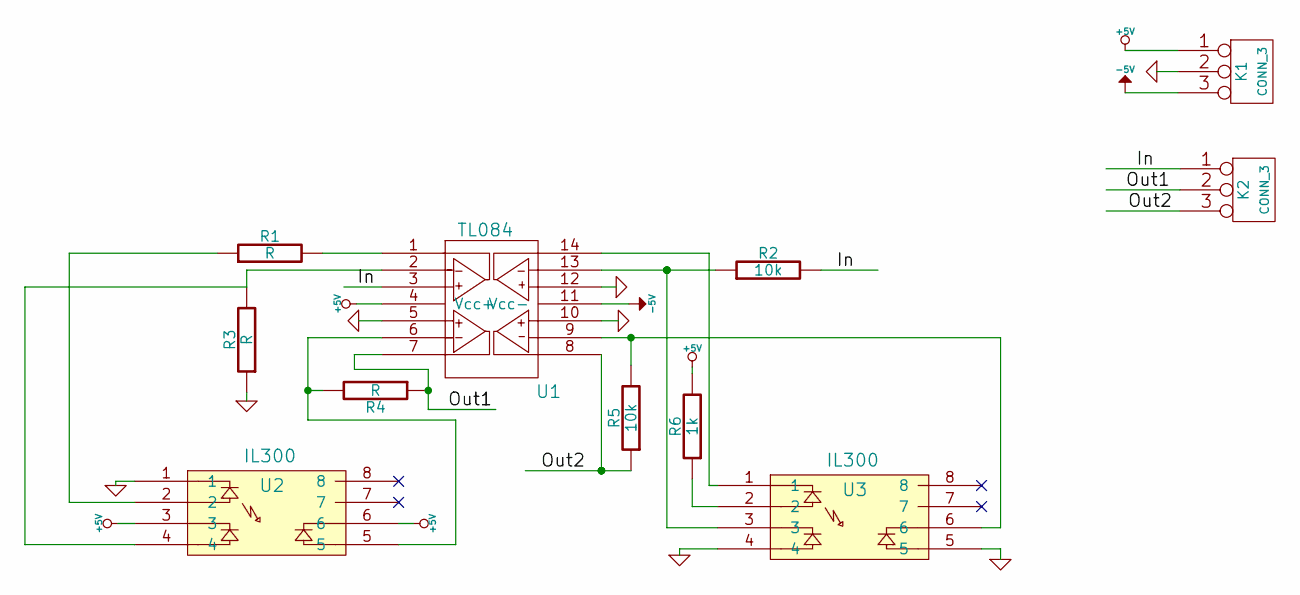
[picture p165: schematic $testSensoresTension.sch]

Parts:
K1, K2: CONN_3
R1, R3, R4: R
R2, R5: 10k
R6: 1k
U1: TL084
U2, U3: IL300

Connections:
+5V: K1.1, R6.2, U1.4 (Vcc+), U2.3, U2.6
-5V: K1.3, U1.11 (Vcc-)
GND: K1.2 (PM), R3.1, U1.5, U1.10, U1.12, U2.1, U3.4, U3.5
In: K2.1, R2.2, U1.3
unnamed: R1.1, U2.2
unnamed: R1.2, U1.1
unnamed: R2.1, U1.13, U3.3
unnamed: R3.2, U1.2, U2.4
unnamed: R4.2, U1.6, U2.5
unnamed: R5.2, U1.9, U3.6
unnamed: R6.1, U3.2
unnamed: U1.14, U3.1
Out1: K2.2 (PM), R4.1, U1.7
Out2: K2.3, R5.1, U1.8
