Stachovsky/TrabajoProfesional/Codigo/workspaceLpc/uIP_dhcp/main/main.c

/*
 * Copyright (c) 2001, Adam Dunkels.
 * All rights reserved.
 *
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
 * This file is part of the uIP TCP/IP stack.
 *
 * $Id: main.c,v 1.16 2006/06/11 21:55:03 adam Exp $
 *
 */

/**********************************************************************
 * Modifications by Code Red Technologies for RDB1768 development board
 **********************************************************************/


#include "LPC17xx.h"
#include <string.h>
#include "lpc17xx_emac.h"

#include "timer.h"
#include "uip.h"
#include "uip_arp.h"
#include "tapdev.h"

#include <cr_section_macros.h>
#include <NXP/crp.h>

// Variable to store CRP value in. Will be placed automatically
// by the linker when "Enable Code Read Protect" selected.
// See crp.h header for more information
__CRP const unsigned int CRP_WORD = CRP_NO_CRP ;

struct uip_eth_addr mymac = { {MYMAC_1, MYMAC_2, MYMAC_3, MYMAC_4, MYMAC_5, MYMAC_6} } ;
char ipstring [20];

#define BUF ((struct uip_eth_hdr *)&uip_buf[0])

/*--------------------------- uip_log ---------------------------------*/

void uip_log(char *m)
{
  //printf("uIP log message: %s\n", m);
}

/*--------------------------- main ---------------------------------*/

int main(void)
{
	unsigned int i;
	uip_ipaddr_t ipaddr;	/* local IP address */
	struct timer periodic_timer, arp_timer;

	// clock init
	clock_init();
	// two timers for tcp/ip
	timer_set(&periodic_timer, CLOCK_SECOND / 2); /* 0.5s */
	timer_set(&arp_timer, CLOCK_SECOND * 10);	/* 10s */
	
	// ethernet init
	tapdev_init();

	// Initialize the uIP TCP/IP stack.
	uip_init();

    uip_ipaddr(ipaddr, 0, 0, 0, 0);
    uip_sethostaddr(ipaddr);
    uip_ipaddr(ipaddr, 0, 0, 0, 0);
    uip_setnetmask(ipaddr);

	uip_setethaddr (mymac);

	// Start DHCP to get IP address
	dhcpc_init(&mymac,6 );

	dhcpc_request();

	// Initialize the HTTP server, listen to port 80.
	httpd_init();

	while(1)
	{
 	/* receive packet and put in uip_buf */
		uip_len = tapdev_read(uip_buf);
    	if(uip_len > 0)		/* received packet */
    	{ 
      		if(BUF->type == htons(UIP_ETHTYPE_IP))	/* IP packet */
      		{
	      		uip_arp_ipin();	
	      		uip_input();
	      		/* If the above function invocation resulted in data that
	         		should be sent out on the network, the global variable
	         		uip_len is set to a value > 0. */
 
	      		if(uip_len > 0)
        		{
	      			uip_arp_out();
	        		tapdev_send(uip_buf,uip_len);
	      		}
      		}
	      	else if(BUF->type == htons(UIP_ETHTYPE_ARP))	/*ARP packet */
	      	{
	        	uip_arp_arpin();
		      	/* If the above function invocation resulted in data that
		         	should be sent out on the network, the global variable
		         	uip_len is set to a value > 0. */
		      	if(uip_len > 0)
	        	{
		        	tapdev_send(uip_buf,uip_len);	/* ARP ack*/
		      	}
	      	}
    	}
    	else if(timer_expired(&periodic_timer))	/* no packet but periodic_timer time out (0.5s)*/
    	{
      		timer_reset(&periodic_timer);
	  
      		for(i = 0; i < UIP_CONNS; i++)
      		{
      			uip_periodic(i);
		        /* If the above function invocation resulted in data that
		           should be sent out on the network, the global variable
		           uip_len is set to a value > 0. */
		        if(uip_len > 0)
		        {
		          uip_arp_out();
		          tapdev_send(uip_buf,uip_len);
		        }
      		}

      		/* Call the ARP timer function every 10 seconds. */
			if(timer_expired(&arp_timer))
			{
				timer_reset(&arp_timer);
				uip_arp_timer();
			}
    	}
	}
}
