Stachovsky/TrabajoProfesional/Codigo/workspaceLpc/API_SdCard/src/main.c

/*
===============================================================================
 Name        : main.c
 Author      : 
 Version     :
 Copyright   : Copyright (C) 
 Description : main definition
===============================================================================
*/

#ifdef __USE_CMSIS
#include "LPC17xx.h"
#endif

#include <cr_section_macros.h>
#include <NXP/crp.h>

// Variable to store CRP value in. Will be placed automatically
// by the linker when "Enable Code Read Protect" selected.
// See crp.h header for more information
__CRP const unsigned int CRP_WORD = CRP_NO_CRP ;

#include <stdio.h>
#include "efs.h"
#include "ls.h"
#include "mkfs.h"

EmbeddedFileSystem efs;
EmbeddedFile filer, filew;
DirList list;
unsigned short e;
unsigned char buf[513];

#define MESSAGE printf

int main(void)
{
	int8_t res;

	MESSAGE("\nRDB1768 EFSL / microSD card Demonstration\n");
	MESSAGE("=========================================\n");

	MESSAGE("CARD init...");
	if ( ( res = efs_init( &efs, 0 ) ) != 0 ) {
		MESSAGE("failed with %i\n",res);
	}
	else {
		MESSAGE("ok\n");
		MESSAGE("Directory of 'root':\n");
		ls_openDir( &list, &(efs.myFs) , "/");
		while ( ls_getNext( &list ) == 0 ) {
			list.currentEntry.FileName[LIST_MAXLENFILENAME-1] = '\0';
			MESSAGE( "%s ( %li bytes )\n" ,
				list.currentEntry.FileName,
				list.currentEntry.FileSize ) ;
		}


		fs_umount( &efs.myFs ) ;
	}

	MESSAGE("** Finished directory listing - entering infinite loop **\n");
	while (1);

	return 0; /* never reached */
}
