Stachovsky/TrabajoProfesional/Codigo/workspaceLpc/API_UART/src/main.c

/*
===============================================================================
 Name        : main.c
 Author      : 
 Version     :
 Copyright   : Copyright (C) 
 Description : main definition
===============================================================================
*/

#ifdef __USE_CMSIS
#include "LPC17xx.h"
#endif

#include <stdio.h>
#include <stdlib.h>
#include <string.h>

#include "API_Uart.h"

#include <cr_section_macros.h>
#include <NXP/crp.h>

__CRP const unsigned int CRP_WORD = CRP_NO_CRP ;

void ftest(uint8_t c){

	uint8_t test[15];
	sprintf((char*)test, "Llego: %c\r\n", (char)c);
	API_UartSendString(UART_PORT_3, test);

}

int main(void) {
	
	uint8_t nada[10];

	sprintf((char*)nada, "Nada:%d\r\n", 88);

	API_UartConfig(UART_PORT_3, ftest);

	API_EnableInterrupt(UART_PORT_3);

	API_UartSendByte(UART_PORT_3, 'F');
	API_UartSendString(UART_PORT_3,nada);

	// Enter an infinite loop, just incrementing a counter
	volatile static int i = 0 ;
	while(1) {
		i++ ;
	}
	return 0 ;
}
