Stachovsky/TrabajoProfesional/Codigo/workspaceLpc/API_LcdGrafic/src/lcd_fonts.h

extern  unsigned char font_10x20[];
extern  unsigned char font_12x13ja[];
extern  unsigned char font_12x24[];
extern  unsigned char font_12x24rk[];
extern  unsigned char font_18x18ja[];
extern  unsigned char font_18x18ko[];
extern  unsigned char font_4x6[];
extern  unsigned char font_5x7[];
extern  unsigned char font_5x8[];
extern  unsigned char font_6x10[];
extern  unsigned char font_6x12[];
extern  unsigned char font_6x13B[];
extern  unsigned char font_6x13[];
extern  unsigned char font_6x13O[];
extern  unsigned char font_6x9[];
extern  unsigned char font_7x13B[];
extern  unsigned char font_7x13[];
extern  unsigned char font_7x13O[];
extern  unsigned char font_7x14B[];
extern  unsigned char font_7x14[];
extern  unsigned char font_8x13B[];
extern  unsigned char font_8x13[];
extern  unsigned char font_8x13O[];
extern  unsigned char font_8x16[];
extern  unsigned char font_8x16rk[];
extern  unsigned char font_9x15B[];
extern  unsigned char font_9x15[];
extern  unsigned char font_9x18B[];
extern  unsigned char font_9x18[];
extern  unsigned char font_charB08[];	// "Bitstream Charter Black"
extern  unsigned char font_charB10[];	// "Bitstream Charter Black"
extern  unsigned char font_charB12[];	// "Bitstream Charter Black"
extern  unsigned char font_charB14[];	// "Bitstream Charter Black"
extern  unsigned char font_charB18[];	// "Bitstream Charter Black"
extern  unsigned char font_charB24[];	// "Bitstream Charter Black"
extern  unsigned char font_charBI08[];	// "Bitstream Charter Black Italic"
extern  unsigned char font_charBI10[];	// "Bitstream Charter Black Italic"
extern  unsigned char font_charBI12[];	// "Bitstream Charter Black Italic"
extern  unsigned char font_charBI14[];	// "Bitstream Charter Black Italic"
extern  unsigned char font_charBI18[];	// "Bitstream Charter Black Italic"
extern  unsigned char font_charBI24[];	// "Bitstream Charter Black Italic"
extern  unsigned char font_charI08[];
extern  unsigned char font_charI10[];
extern  unsigned char font_charI12[];
extern  unsigned char font_charI14[];
extern  unsigned char font_charI18[];
extern  unsigned char font_charI24[];
extern  unsigned char font_charR08[];
extern  unsigned char font_charR10[];
extern  unsigned char font_charR12[];
extern  unsigned char font_charR14[];
extern  unsigned char font_charR18[];
extern  unsigned char font_charR24[];
extern  unsigned char font_clB6x10[];
extern  unsigned char font_clB6x12[];
extern  unsigned char font_clB8x10[];
extern  unsigned char font_clB8x12[];
extern  unsigned char font_clB8x13[];
extern  unsigned char font_clB8x14[];
extern  unsigned char font_clB8x16[];
extern  unsigned char font_clB8x8[];
extern  unsigned char font_clB9x15[];
extern  unsigned char font_clI6x12[];
extern  unsigned char font_clI8x8[];
extern  unsigned char font_clR4x6[];
extern  unsigned char font_clR5x10[];
extern  unsigned char font_clR5x6[];
extern  unsigned char font_clR5x8[];
extern  unsigned char font_clR6x10[];
extern  unsigned char font_clR6x12[];
extern  unsigned char font_clR6x13[];
extern  unsigned char font_clR6x6[];
extern  unsigned char font_clR6x8[];
extern  unsigned char font_clR7x10[];
extern  unsigned char font_clR7x12[];
extern  unsigned char font_clR7x14[];
extern  unsigned char font_clR7x8[];
extern  unsigned char font_clR8x10[];
extern  unsigned char font_clR8x12[];
extern  unsigned char font_clR8x13[];
extern  unsigned char font_clR8x14[];
extern  unsigned char font_clR8x16[];
extern  unsigned char font_clR8x8[];
extern  unsigned char font_clR9x15[];
extern  unsigned char font_courB08[];	// "Courier Bold"
extern  unsigned char font_courB10[];	// "Courier Bold"
extern  unsigned char font_courB12[];	// "Courier Bold"
extern  unsigned char font_courB14[];	// "Courier Bold"
extern  unsigned char font_courB18[];	// "Courier Bold"
extern  unsigned char font_courB24[];	// "Courier Bold"
extern  unsigned char font_courBO08[];	// "Courier Bold Oblique"
extern  unsigned char font_courBO10[];	// "Courier Bold Oblique"
extern  unsigned char font_courBO12[];	// "Courier Bold Oblique"
extern  unsigned char font_courBO14[];	// "Courier Bold Oblique"
extern  unsigned char font_courBO18[];	// "Courier Bold Oblique"
extern  unsigned char font_courBO24[];	// "Courier Bold Oblique"
extern  unsigned char font_courO08[];	// "Courier Oblique"
extern  unsigned char font_courO10[];	// "Courier Oblique"
extern  unsigned char font_courO12[];	// "Courier Oblique"
extern  unsigned char font_courO14[];	// "Courier Oblique"
extern  unsigned char font_courO18[];	// "Courier Oblique"
extern  unsigned char font_courO24[];	// "Courier Oblique"
extern  unsigned char font_courR08[];	// "Courier"
extern  unsigned char font_courR10[];	// "Courier"
extern  unsigned char font_courR12[];	// "Courier"
extern  unsigned char font_courR14[];	// "Courier"
extern  unsigned char font_courR18[];	// "Courier"
extern  unsigned char font_courR24[];	// "Courier"
extern  unsigned char font_cu12[];
extern  unsigned char font_cu_alt12[];
extern  unsigned char font_cu_arabic12[];
extern  unsigned char font_cuarabic12[];
extern  unsigned char font_cu_devnag12[];
extern  unsigned char font_cudevnag12[];
extern  unsigned char font_cu_lig12[];
extern  unsigned char font_cu_pua12[];
extern  unsigned char font_cursor[];
extern  unsigned char font_deccurs[];
extern  unsigned char font_decsess[];
extern  unsigned char font_gb16fs[];
extern  unsigned char font_gb16st[];
extern  unsigned char font_gb24st[];
extern  unsigned char font_hanglg16[];
extern  unsigned char font_hanglm16[];
extern  unsigned char font_hanglm24[];
extern  unsigned char font_helvB08[];	// "Helvetica Bold"
extern  unsigned char font_helvB10[];	// "Helvetica Bold"
extern  unsigned char font_helvB12[];	// "Helvetica Bold"
extern  unsigned char font_helvB14[];	// "Helvetica Bold"
extern  unsigned char font_helvB18[];	// "Helvetica Bold"
extern  unsigned char font_helvB24[];	// "Helvetica Bold"
extern  unsigned char font_helvBO08[];	// "Helvetica Bold Oblique"
extern  unsigned char font_helvBO10[];	// "Helvetica Bold Oblique"
extern  unsigned char font_helvBO12[];	// "Helvetica Bold Oblique"
extern  unsigned char font_helvBO14[];	// "Helvetica Bold Oblique"
extern  unsigned char font_helvBO18[];	// "Helvetica Bold Oblique"
extern  unsigned char font_helvBO24[];	// "Helvetica Bold Oblique"
extern  unsigned char font_helvO08[];	// "Helvetica Oblique"
extern  unsigned char font_helvO10[];	// "Helvetica Oblique"
extern  unsigned char font_helvO12[];	// "Helvetica Oblique"
extern  unsigned char font_helvO14[];	// "Helvetica Oblique"
extern  unsigned char font_helvO18[];	// "Helvetica Oblique"
extern  unsigned char font_helvO24[];	// "Helvetica Oblique"
extern  unsigned char font_helvR08[];	// "Helvetica"
extern  unsigned char font_helvR10[];	// "Helvetica"
extern  unsigned char font_helvR12[];	// "Helvetica"
extern  unsigned char font_helvR14[];	// "Helvetica"
extern  unsigned char font_helvR18[];	// "Helvetica"
extern  unsigned char font_helvR24[];	// "Helvetica"
extern  unsigned char font_jiskan16[];
extern  unsigned char font_jiskan24[];
extern  unsigned char font_k14[];
extern  unsigned char font_lubB08[];
extern  unsigned char font_lubB10[];
extern  unsigned char font_lubB12[];
extern  unsigned char font_lubB14[];
extern  unsigned char font_lubB18[];
extern  unsigned char font_lubB19[];
extern  unsigned char font_lubB24[];
extern  unsigned char font_lubBI08[];
extern  unsigned char font_lubBI10[];
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
extern  unsigned char font_olgl19[];
extern  unsigned char font_symb08[];	// "Symbol"
extern  unsigned char font_symb10[];	// "Symbol"
extern  unsigned char font_symb12[];	// "Symbol"
extern  unsigned char font_symb14[];	// "Symbol"
extern  unsigned char font_symb18[];	// "Symbol"
extern  unsigned char font_symb24[];	// "Symbol"
extern  unsigned char font_tech14[];	// "Terminal"
extern  unsigned char font_techB14[];	// "Terminal Bold"
extern  unsigned char font_term14[];	// "Terminal"
extern  unsigned char font_termB14[];	// "Terminal Bold"
extern  unsigned char font_timB08[];	// "Times Bold"
extern  unsigned char font_timB10[];	// "Times Bold"
extern  unsigned char font_timB12[];	// "Times Bold"
extern  unsigned char font_timB14[];	// "Times Bold"
extern  unsigned char font_timB18[];	// "Times Bold"
extern  unsigned char font_timB24[];	// "Times Bold"
extern  unsigned char font_timBI08[];	// "Times Bold Italic"
extern  unsigned char font_timBI10[];	// "Times Bold Italic"
extern  unsigned char font_timBI12[];	// "Times Bold Italic"
extern  unsigned char font_timBI14[];	// "Times Bold Italic"
extern  unsigned char font_timBI18[];	// "Times Bold Italic"
extern  unsigned char font_timBI24[];	// "Times Bold Italic"
extern  unsigned char font_timI08[];	// "Times Italic"
extern  unsigned char font_timI10[];	// "Times Italic"
extern  unsigned char font_timI12[];	// "Times Italic"
extern  unsigned char font_timI14[];	// "Times Italic"
extern  unsigned char font_timI18[];	// "Times Italic"
extern  unsigned char font_timI24[];	// "Times Italic"
extern  unsigned char font_timR08[];	// "Times Roman"
extern  unsigned char font_timR10[];	// "Times Roman"
extern  unsigned char font_timR12[];	// "Times Roman"
extern  unsigned char font_timR14[];	// "Times Roman"
extern  unsigned char font_timR18[];	// "Times Roman"
extern  unsigned char font_timR24[];	// "Times Roman"
